SeriousHarlequin/FaRiSmarthome/Labor-Project/docs/topics/hardware.tex

\graphicspath{ {HW-PIC/} }

\chapter{Hardware}
    In diesem Kapitel werden die zwei unterschiedlichen Hardwarerevisionen des Projektes
    beschrieben. 

    \section{Umsetzung - V1}
    
        Die Platine ist so entwickelt worden, dass sie auf der Rückseite des Displays 
        montiert werden kann. Was die erste Version von V1.1 unterscheidet ist, dass
        es vorgesehen war den integrierten Touch des Displays zu verwenden.

        \subsection{Versorgung}
        Das Board wird mit 5V über USB-C versorgt, um den ESP32-S3 mit 3V3 zu 
        versorgung, wird ein AMS1117 Spannungswandler verwenden. Dieser wurde ausgewählt, 
        aufgrund der einfachen Implementierung. Die Verluste bei der Umwandlung können vernachlässigt 
        werden, da es sich nicht um ein batteriebetriebenes Gerät handelt.

            \begin{figure}[h!]
                \centering
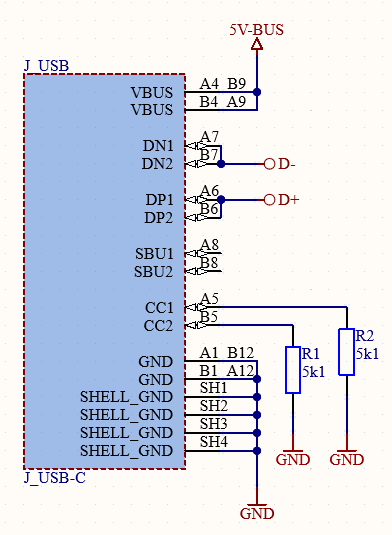
[picture p10: Labor-Project/docs/HW-PIC/usb-c.png]
                
                \caption{USB-C Büchse "programmiert" mit Widerständen.}
                \label{fig:sch1}

            \end{figure}

        Die Widerstände R1 und R2 mit 5,1kOhm sind mit den CC-Leitungen auf GND verbunden.
        Dadurch weiß das Netzteil(falls dieses ``Power Delivery`` unterstützt) welche Spannung 
        und wie viel Strom es zur Verfügung stellen muss. 

            \begin{figure}[h!]
                \centering
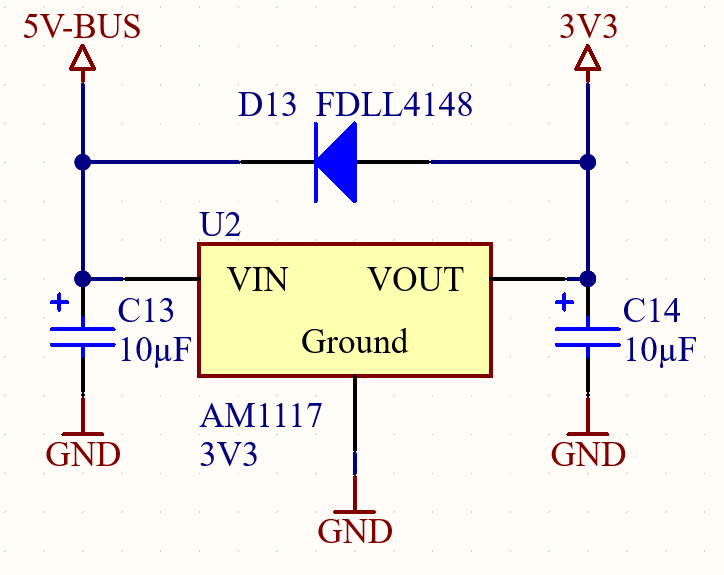
[picture p11: Labor-Project/docs/HW-PIC/powersupply.png]
                
                \caption{AMS1117 mit 3V3 Ausgangsspannung.}
                \label{fig:sch2}
                
            \end{figure}

        Ein- und Ausgangsseitig liegt jeweils ein Glättungskondensator. Die Diode wurde hinzugefügt 
        um zu verhindern, dass am Ausgang eine größere Spannung
        anliegt als beim Eingang - wie z.B. beim Abstecken des Gerätes. Das soll verhindern,
        dass der AMS1117 beschädigt wird.

        \newpage

        \subsection{Mikrocontroller}
        Der ESP32-S3-WROOM-2 ist das Herzstück des Gerätes. Dieser verfügt über eine On-Board PCB Antenne
        und kommuniziert darüber mit dem Smart-Home System. 

            \begin{figure}[h!]
                \centering
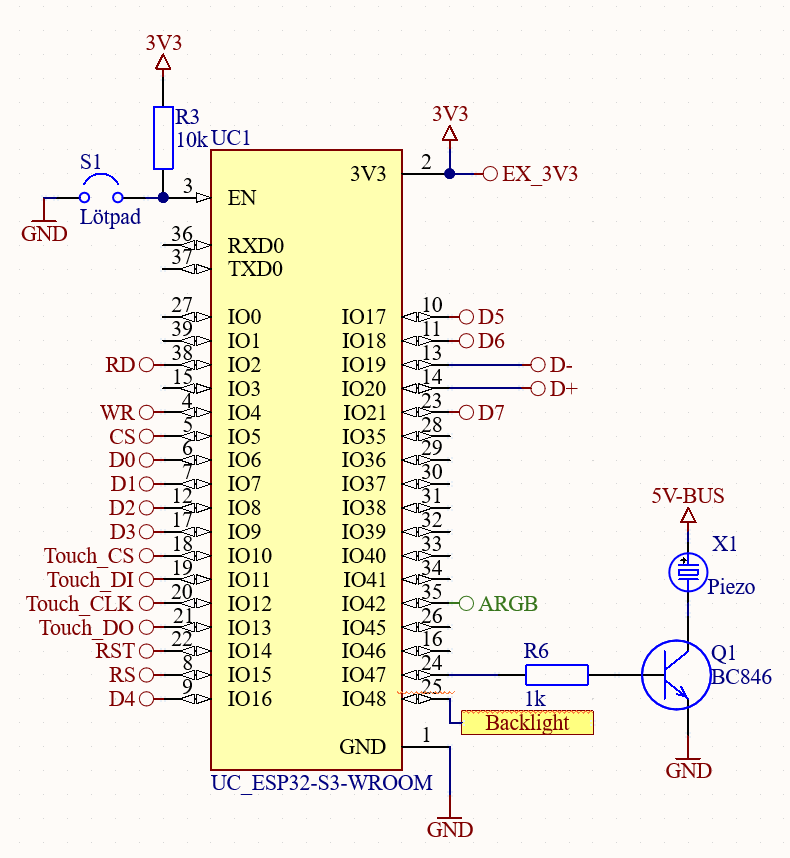
[picture p12: Labor-Project/docs/HW-PIC/microcontroller.png]
                
                \caption{uC im Schaltplan.}
                \label{fig:sch3}

            \end{figure}
        
        Der Piezo wird von einen NPN-Transistor eingeschalten, wenn IO47 high ist.

        \newpage
        \subsection{Display}
        Das Display wird parallel im 8-BIT Modus angesteuert. Die Pins mit denen 
        kommuniziert wird sind nicht fix in der Libary festgelegt und können am Esp32-S3 
        frei ausgewählt werden. 

            \begin{figure}[h!]
                \centering
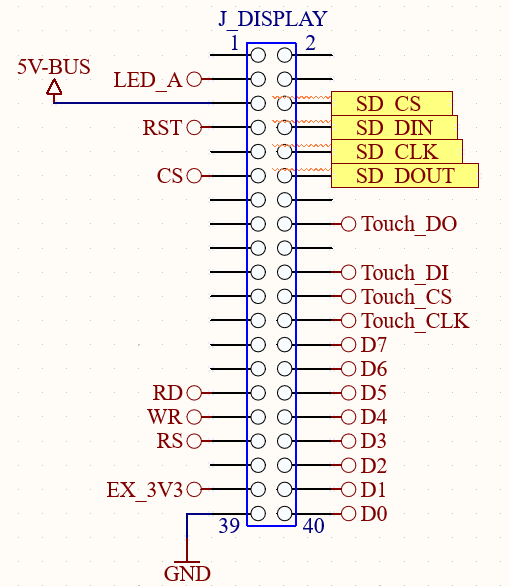
[picture p13: Labor-Project/docs/HW-PIC/connector.png]
                
                \caption{Stecker für Display und Touch}
                \label{fig:sch4}

            \end{figure}

        Das Display wird über einen 40-Pin Stecker angeschlossen. Die Pins sind in der Abbildung \ref{fig:sch4}.
        Das zugekaufte Display hat eine Auflösung von 800x480 Pixeln und nutzt den SSD1963 Controller.
        Es ist ebenfalls ein SD-Kartenleser eingebaut. Dieser kann über SPI ausgelesen(Gelb markiert), ist 
        aber für dieses Projekt nicht in verwendung. 
        
        \newpage
        
        Das Display wurde über Amazon erworben.\cite{noauthor_viferr_nodate} Es handelt sich um ein 7 Zoll Display mit
        einer Auflösung von 800x480 Pixeln. Es ist mit einem resistiven Touchscreen ausgestattet.

            \begin{figure}[h!]
                \centering
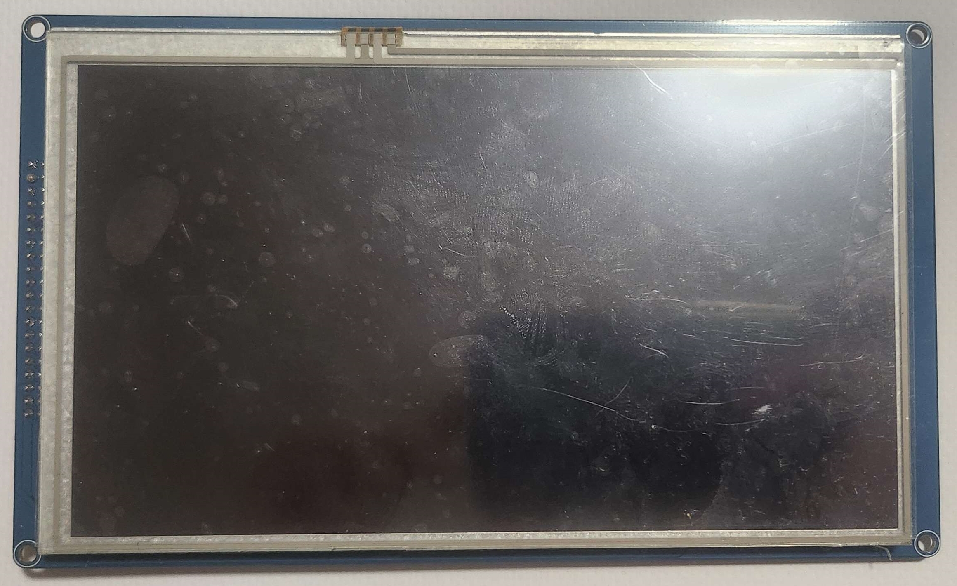
[picture p14: Labor-Project/docs/HW-PIC/display-front.jpg]
                
                \caption{Vorderseite des Displays.}
                \label{fig:displayfront}
            
            \end{figure}

            \begin{figure}[h!]
                \centering
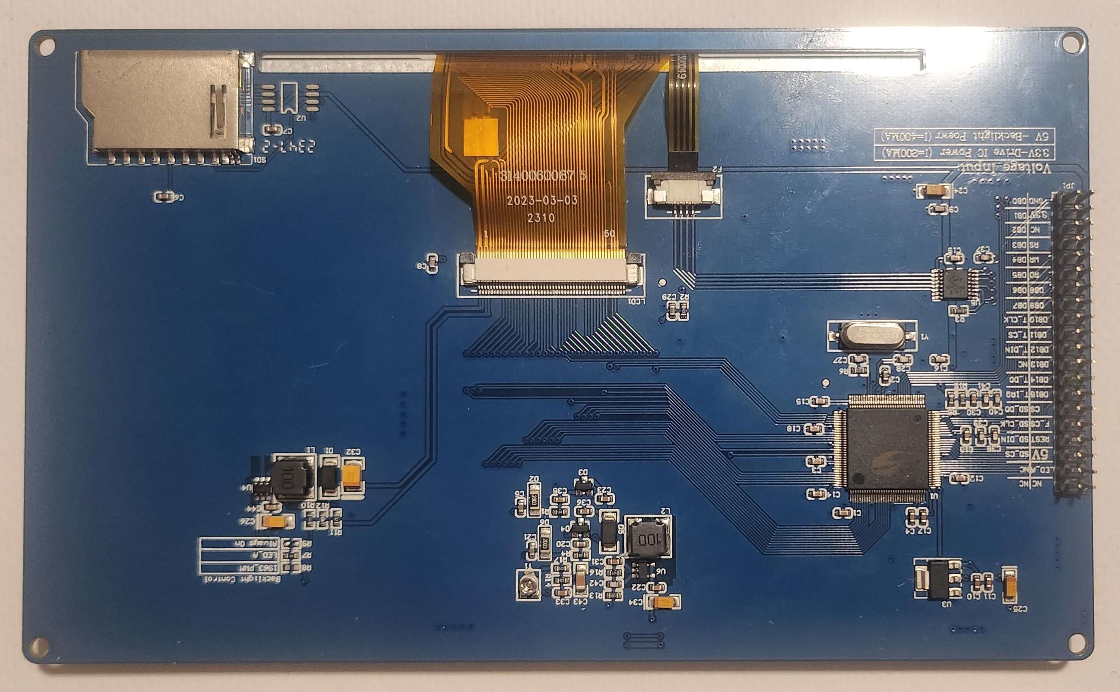
[picture p15: Labor-Project/docs/HW-PIC/display-back.jpg]
                
                \caption{Rückseite des Displays.}
                \label{fig:displayback}
            
            \end{figure}

        \newpage
        \subsection{Touch}
        Die Berührung am Resisivtouch-Panel wird vom XPT2046 erfasst und mittels 
        SPI-BUS vom µC ausgelesen. Da es bei der Implementierung von Touch softwareseitig
        Probleme gab, wurde stattdessen ein Drehgeber mit Taste verwendet.
        Dafür wurden die in der Abbildung \ref{fig:sch3} bzw. \ref{fig:sch4} gezeigten Pins mit 
        dem Prefix "Touch" für das Einlesen des Drehgebers verwendet.

        \subsection{LED-Streifen}

        Der LED-Streifen ist eine eigene Platine welche mit WS2812B LEDs bestückt ist. Das sind 
        adressierbare RGB-LEDs, die über einen einzigen Datenpin angesteuert werden. Dadurch 
        können beliebig viele Streifen hintereinander geschalten werden. Der Datenpin des 
        LED-Streifens ist mit dem GPIO42 des ESP32-S3 verbunden. 

            \begin{figure}[h!]
                \centering
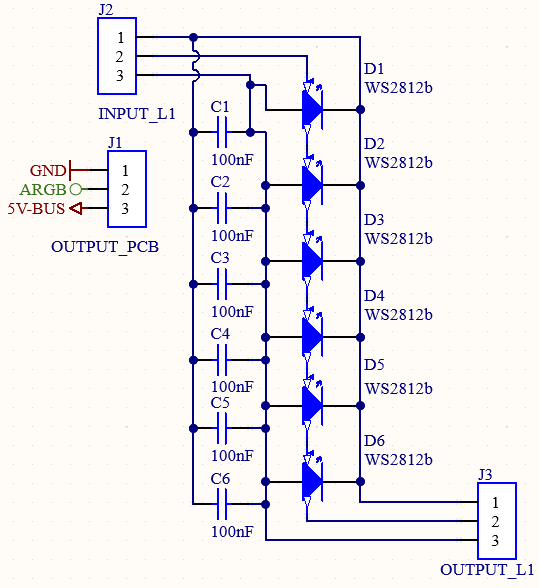
[picture p16: Labor-Project/docs/HW-PIC/rgb.png]
                
                \caption{Anschluss und Beschaltung der LED-Streifen.}
                \label{fig:led_strip}
            \end{figure}

        % \subsection{PCB}

    \newpage
    \section{Umsetzung V1.1 (Finale)}       
    In diesem Kapitel der Hardware werden nur die Änderungen zur V1 beschrieben. 

        \subsection{Mikrocontroller}

            \begin{figure}[h!]
                \centering
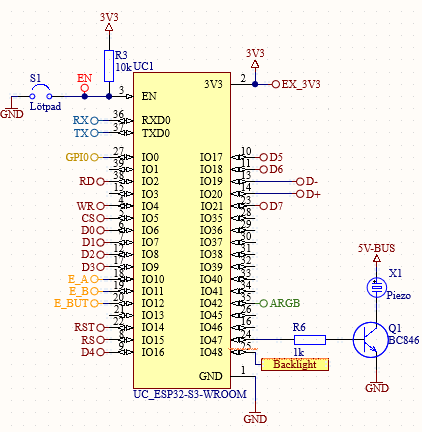
[picture p17: Labor-Project/docs/HW-PIC/microcontroller-v1.1.png]
                
                \caption{Geänderte Schaltung.}
                \label{fig:sch5}

            \end{figure}

        Der Schaltplan wurde angepasst um den Rotary Encoder sowie das Serial-Interface auf
        einen Pin-Header legen zu können.

        \newpage
        \subsection{Rotary Encoder}
        Die Touch-Funktion wurde durch einen Drehgeber ersetzt. Dieser hat eine Taste und
        zwei Ausgänge für die Drehrichtung. Der Drehgeber wird an die Pins 'E\_A', 'E\_B' und 'E\_BUT'
        am ESP32-S3 angeschlossen. 

            \begin{figure}[h!]
                \centering
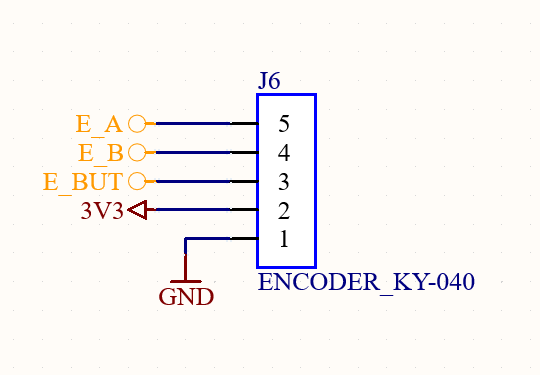
[picture p18: Labor-Project/docs/HW-PIC/encoder.png]
                
                \caption{Anschluss: Drehgeber mit Taste.}
                \label{fig:sch6}

            \end{figure}

        Der Inkrementalgeber hat die Ausgänge A und B. Diese geben beide die selbe
        definierte Menge an Impulse pro Umdrehung ab. Beide Signale sind zueinander 90° Phasenverschoben. Somit
        kann die Drehrichtung bestimmt werden. Da je nach Drehrichtung die positive Flanke entweder
        zuerst bei A oder B erfasst wird.

            \begin{figure}[h!]
                \centering
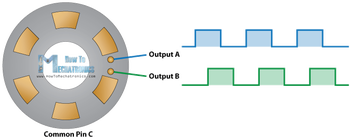
[picture p19: Labor-Project/docs/HW-PIC/encoder_explain.png]
                
                \caption{Erklärung über Encoder von "How to Mechatronics"\cite{dejan_how_2016}}
                \label{fig:sch7}

            \end{figure}

            \begin{figure}[h!]
                \centering
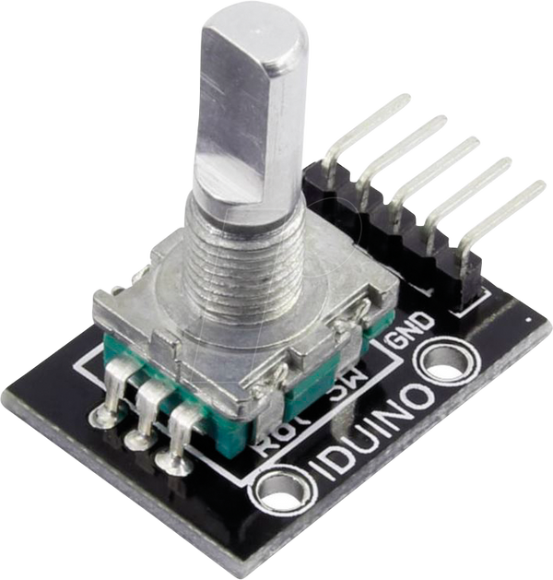
[picture p20: Labor-Project/docs/HW-PIC/encoder-pic.png]
                
                \caption{KY-040 Encoder \cite{noauthor_iduino_nodate}}
                \label{fig:sch8}

            \end{figure}
        Der Encoder KY-040 ist fertig bestückt auf ein PCB. Wie in Abbildung \ref{fig:sch6} zu sehen ist, 
        hat dieses Bauteil 5 Anschlussdrähte. Der Encoder gibt 20 Impulse pro Umdrehung aus und 
        rastet beim Drehen nach jedem Impuls ein.

        \newpage
        
        \subsection{Serial-Interface}
        Das Serial-Interface wurde auf einen Pin-Header gelegt um die Programmierung des ESP32-S3
        zu erleichtern. Bei der Entwicklung wurde festegstellt, dass beim programmieren 
        die Möglichkeit besteht, die Upload Funktion über USB unabsichtlich zu sperren. Neuer
        Code kann dann nur mehr über Serial hochgeladen werden. 

            \begin{figure}[h!]
                \centering
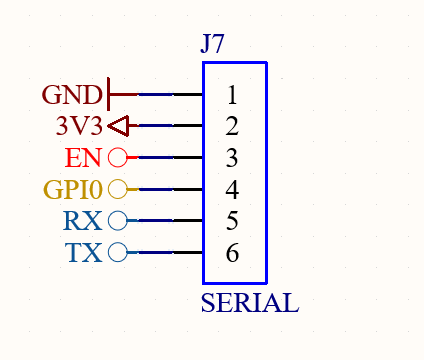
[picture p21: Labor-Project/docs/HW-PIC/serial.png]
                
                \caption{Serial-Interface}
                \label{fig:sch9}

            \end{figure}
        
        Dieser Anschluss ist nur zum Programmieren und Debuggen gedacht.
    \newpage
    
    \section{PCB}

    In diesem Kapitel werden die unterschiedlichen PCBs beschrieben.

        \subsection{ARGB-Print V1 \& V1.1}
        Dieser Print hat einen Eingang und einen Ausgang, es können mehrere von diesen 
        Platinen in Reihe geschalten werden. Da wie beschrieben in \ref{} ARGB-LEDs verwendet werden.
        Für das Gehäuse sind nur zwei LED-Streifen vorgesehen. 

        \begin{figure}[h!]
            \centering
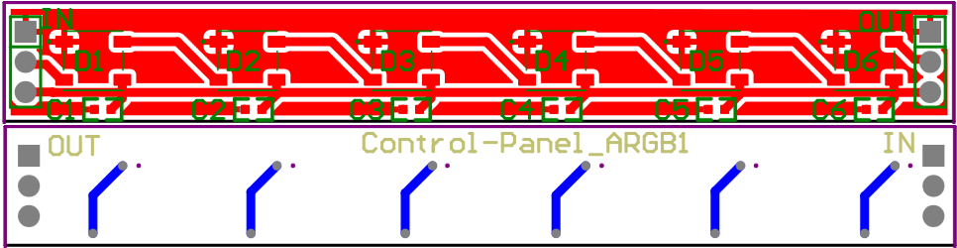
[picture p22: Labor-Project/docs/HW-PIC/pcb-argb.png]
            
            \caption{PCB-ARGB [Blau - Rückseite, Rot - Vorderseite]}
            \label{fig:pcbargb}

        \end{figure}

        \subsection{V1}

        Das PCB ist so entworfen worden, damit es auf der Rückseite des Displays augesteckt 
        werden kann.

            \begin{figure}[h!]
                \centering
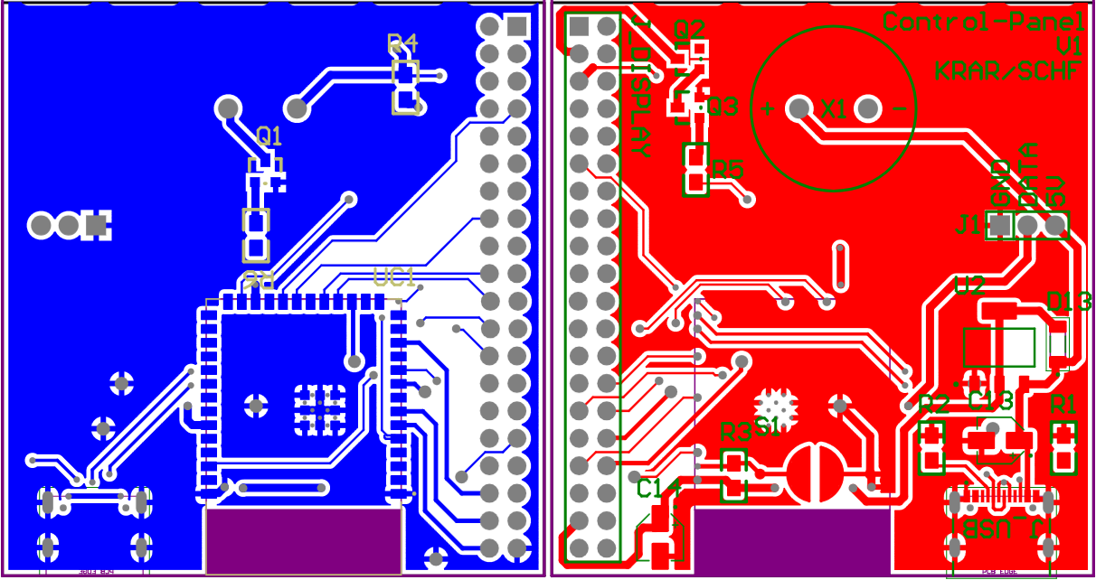
[picture p23: Labor-Project/docs/HW-PIC/pcb-v1.png]
                
                \caption{PCB V1 [Blau - Rückseite, Rot - Vorderseite]}
                \label{fig:pcb1}

            \end{figure}

        \newpage
        \subsection{V1.1}

        Das PCB wurde für die finale Version wurde angepasst. Der Rotary Encoder und das Serial-Interface
        haben jetzt einen eigenen Pin-Header.

            \begin{figure}[htbp]
                \centering
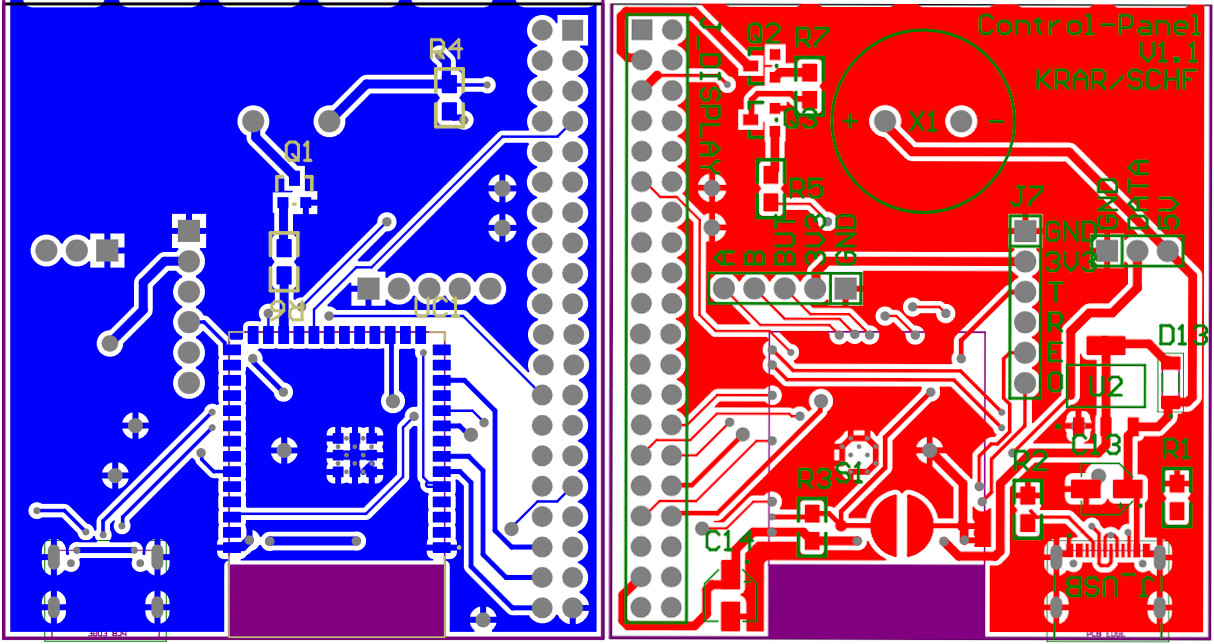
[picture p24: Labor-Project/docs/HW-PIC/pcb-v1.1.png]
                
                \caption{PCB V1.1 [Blau - Rückseite, Rot - Vorderseite]}
                \label{fig:pcb1.1}

            \end{figure}

            \begin{figure}[htbp]
                \centering
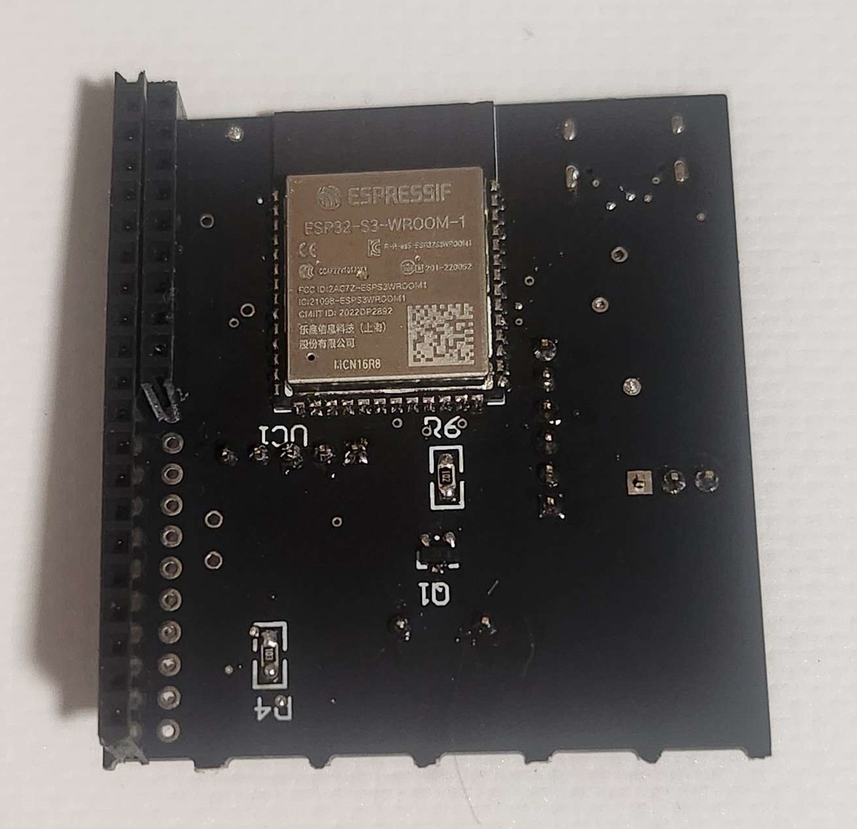
[picture p25: Labor-Project/docs/HW-PIC/pcb-back.jpg]
                \subfloat[\centering Rückseite]{{ }}
                \qquad
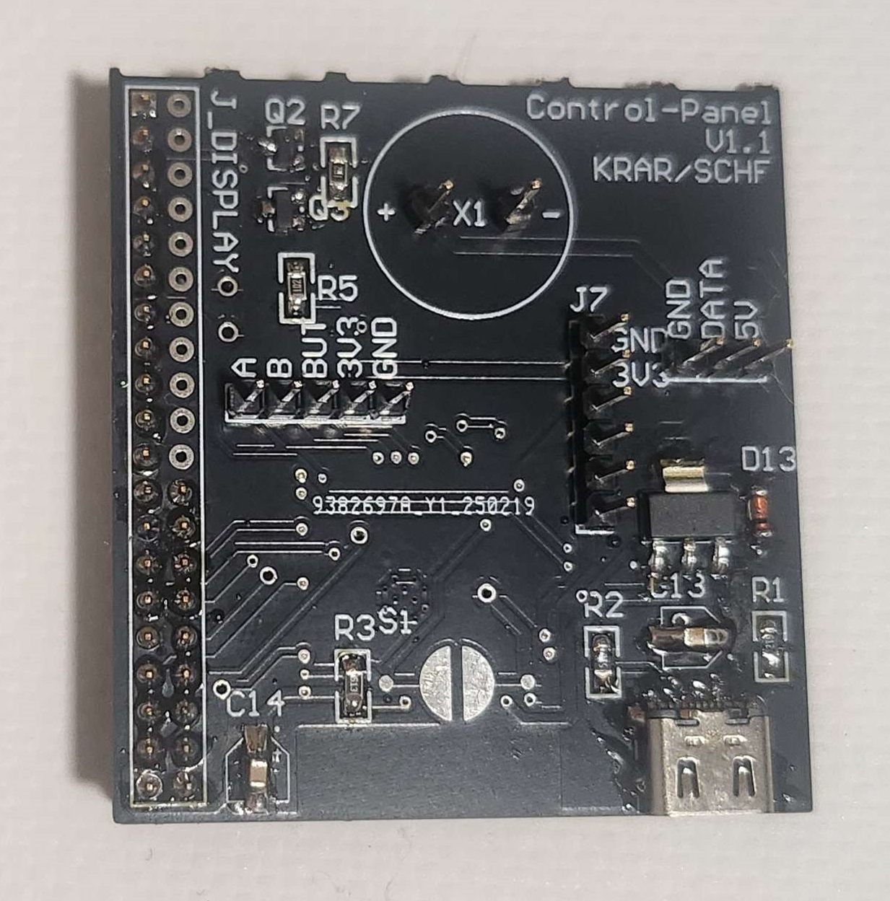
[picture p26: Labor-Project/docs/HW-PIC/pcb-front.jpg]
                \subfloat[\centering Front]{{ }}
                \caption{PCB V1.1 bestückt.}
                \label{fig:example}
            \end{figure}

    \newpage
    \section{Schaltplan} 
    Die folgenden zwei Seiten zeigen den Schaltplan der ersten und der finalen Version.   
            \includepdf[pages={1}, angle = 90]{Control-Panel_V1.pdf}
            \includepdf[pages={1}, angle = 90]{Control-Panel_V1.1.pdf}

    \section{Gehäuse}
    Das Gehäuse wurde aus 3D-gedruckten Teilen zusammengesetzt. Die Teile wurden in Fusion 360 
    entworfen und anschließend mit einem Creality Cr-10s Pro V2 gedruckt. Das Gehäuse besteht aus zwei 
    Hauptteilen: dem oberen und dem unteren Teil. Diese Teile werden durch Schrauben zusammengehalten.

        \begin{figure}[h!]
            \centering
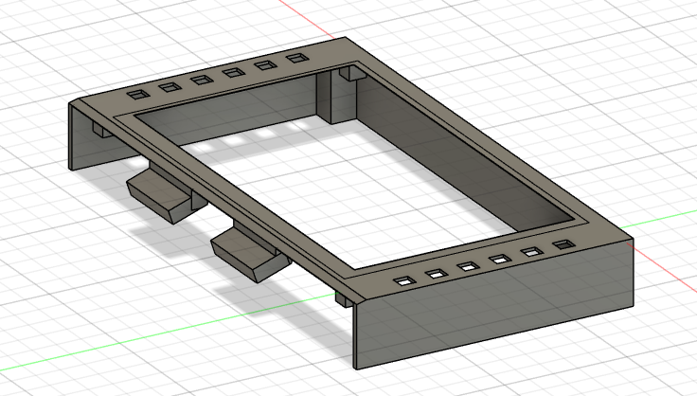
[picture p27: Labor-Project/docs/HW-PIC/case_top.png]
            
            \caption{Oberes Teil des Gehäuses.}
            \label{fig:case_top}
        \end{figure}

    Der obere Teile des Gehäuses ist so gestaltet, dass es alle Komponenten sicher 
    haltet und gleichzeitig einen einfachen Zugang zu den Anschlüssen und Bedienelementen ermöglicht.
    Das Display und die LED streifen werden hier verbaut. 

        \begin{figure}[h!]
            \centering
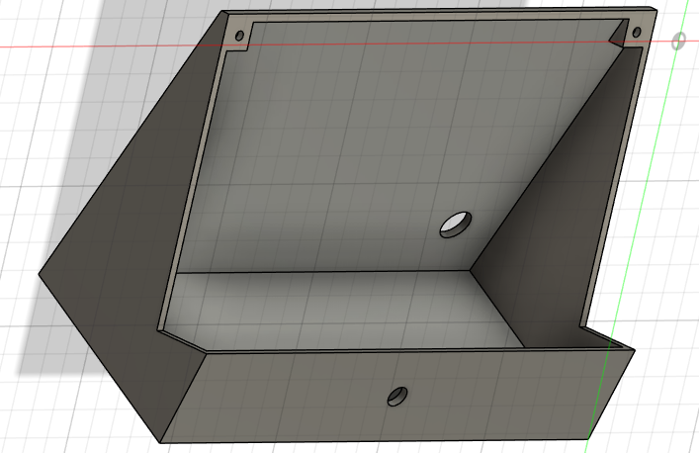
[picture p28: Labor-Project/docs/HW-PIC/case_bottom.png]
            
            \caption{Unteres Teil des Gehäuses.}
            \label{fig:case_bottom}
        \end{figure}

    Der untere Teil des Gehäuses ist so gestaltet, dass der Oberteil sicher darauf sitzt und alle internen
    Komponenten schützt. Es bietet auch Öffnungen für die Stromversorgung. In dieses Teil wird
    die Strombuchse sowie der Encoder verbaut.

    Das Loch in der Mitte des unteren Teils ist für die Montage des Encoders gedacht. Die 
    andere Öffnung auf der Rückseite ist für die Stromversorgung, in dieser wird 
    eine USB-C Buchse eingebaut.

    \begin{figure}[h!]
        \centering
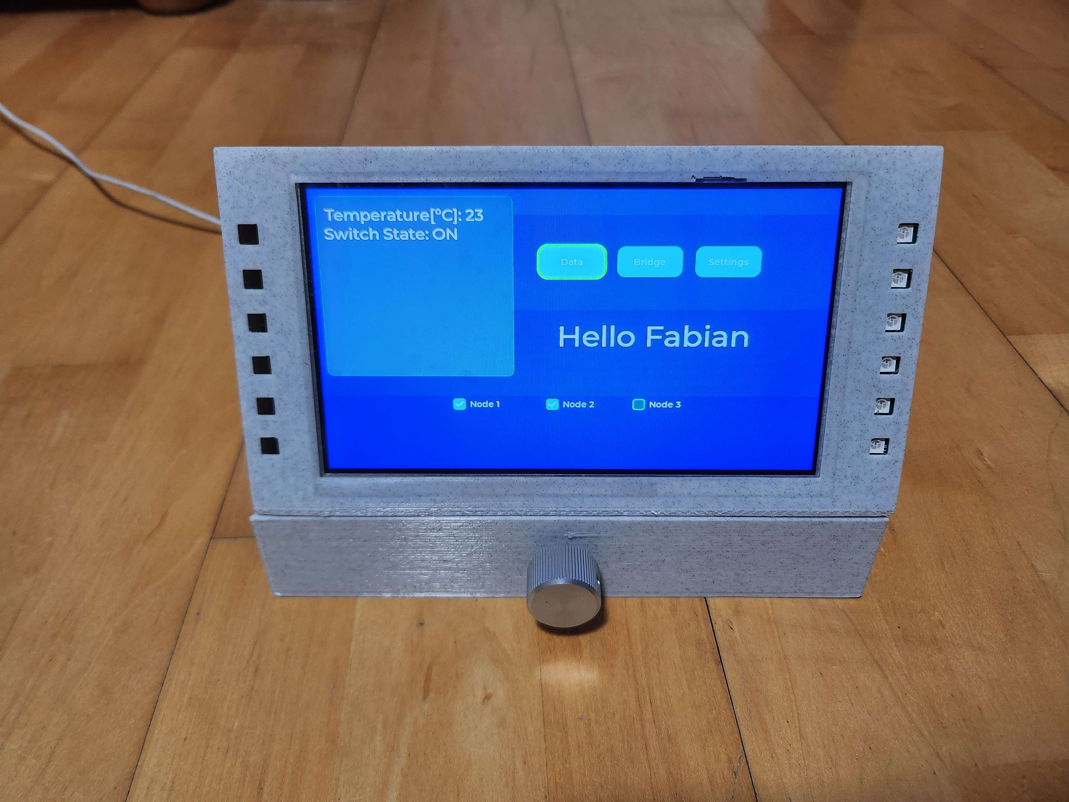
[picture p29: Labor-Project/docs/HW-PIC/display-fertig.jpg]
        
        \caption{Gehäuse zusammengebaut mit den Komponenten.}
        \label{fig:case_bottom}
    \end{figure}
