SeriousHarlequin/FaRiSmarthome/Diplomarbeit/topics-hw/production-files.tex

\chapter{Production Files}\setAuthor{Richard Krammer}

    The production files are the files that are used to produce the
    hardware. This includes the schematic, the PCB layout and the
    bill of materials (BOM).

    \section{Basic Module}
        
        \subsubsection{Basic Module V2.2}
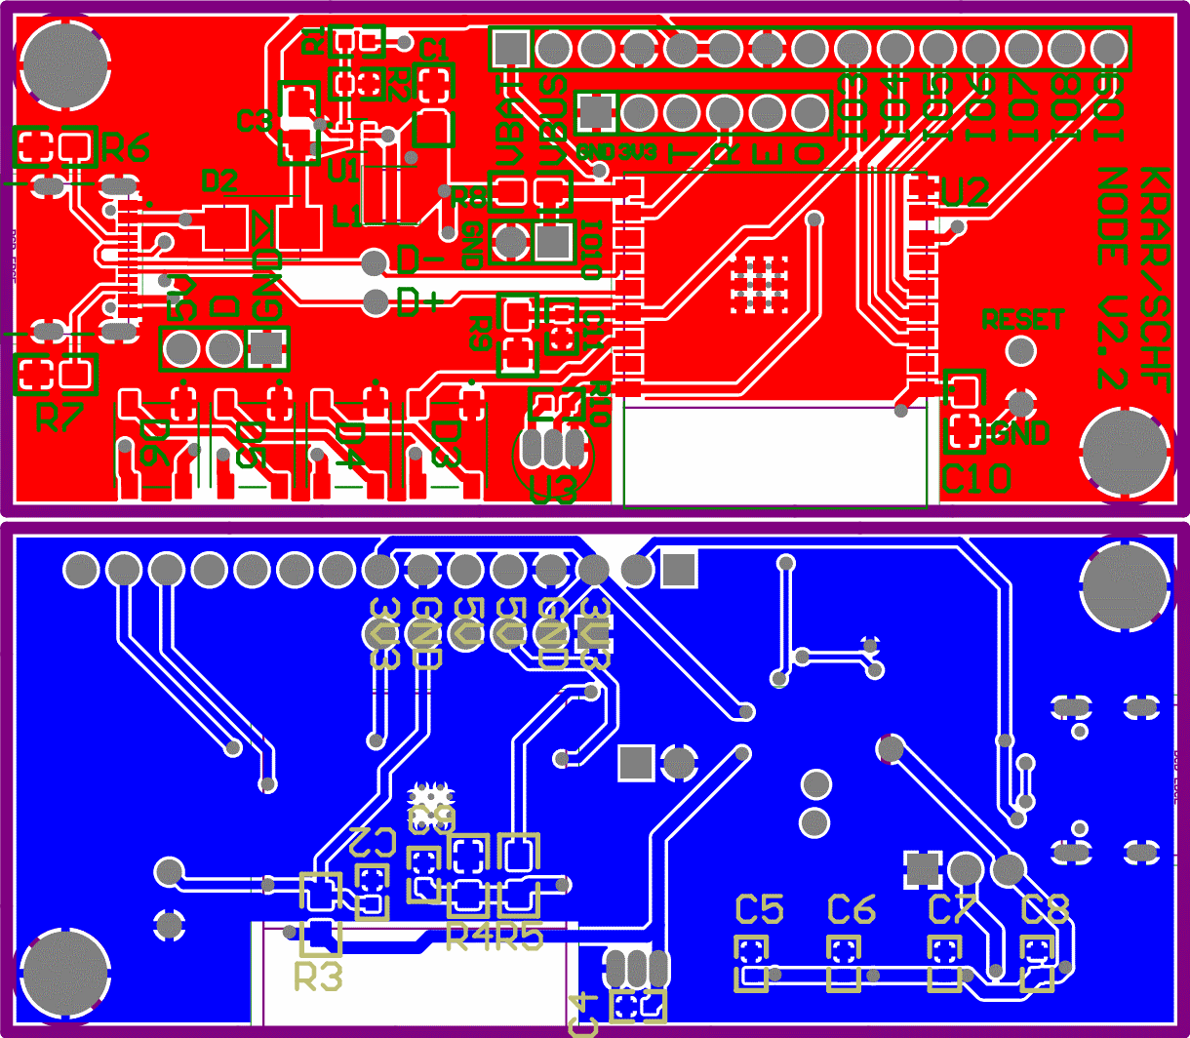
[picture p30: Diplomarbeit/assets/HW/PCB-NODE-V2.2.png]
            

            \includepdf[pages={2}, angle = 0, scale = 1.5, pagecommand={\subsubsection{Basic Module V2.2 - BOM}}]
            {assets/HW/PDF-Schematic/Node-V2.2.pdf}

            \includepdf[pages={1}, angle = 90]{assets/HW/PDF-Schematic/Node-V2.2.pdf}

        \subsubsection{Basic Module V2.1}
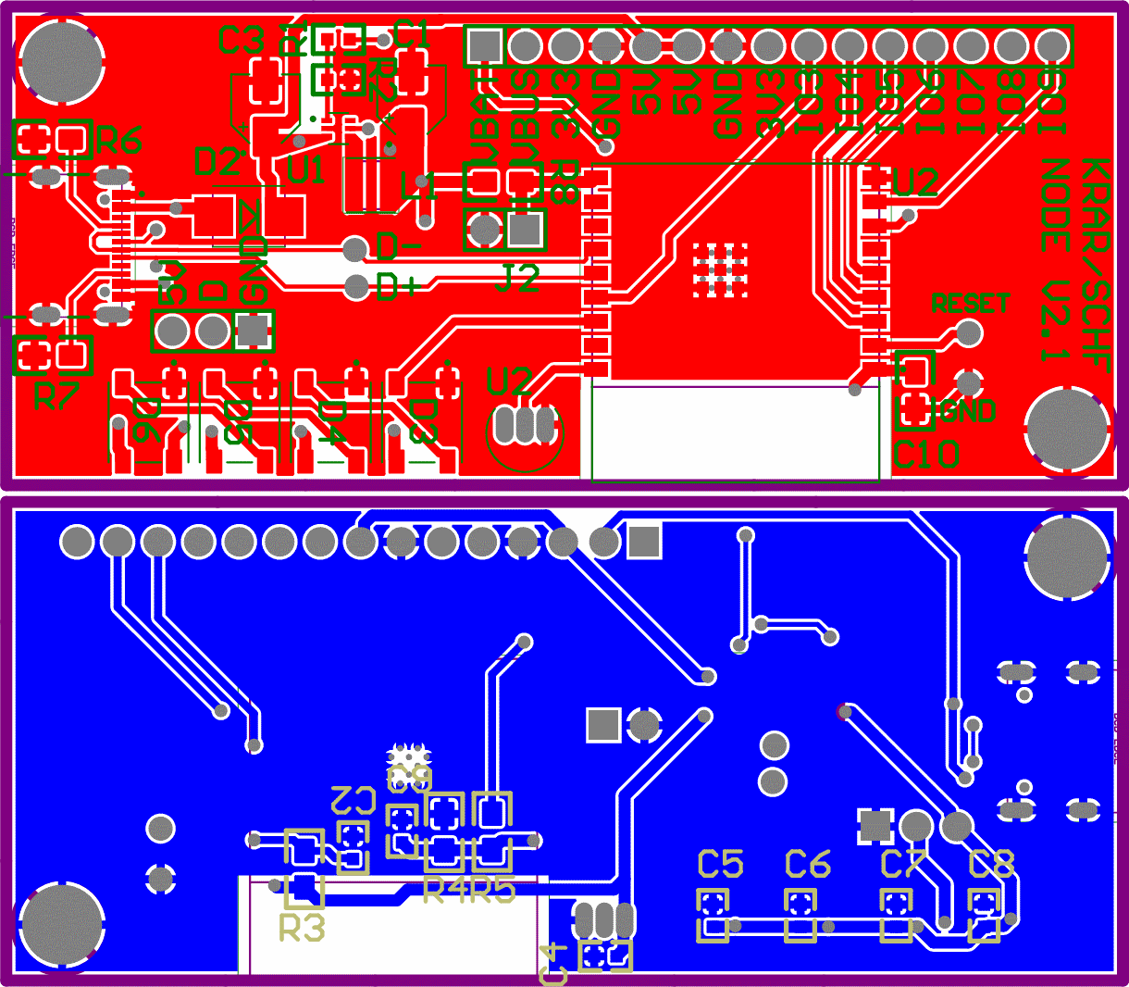
[picture p31: Diplomarbeit/assets/HW/PCB-NODE-V2.1.png]
            
            
            \includepdf[pages={1}, angle = 0, scale = 1, pagecommand={\subsubsection{Basic Module V2.1 - BOM}}]
            {assets/HW/PDF-Schematic/Node-V2.1-BOM.pdf}
                
            \includepdf[pages={1}, angle = 90]{assets/HW/PDF-Schematic/Node-V2.1.pdf}

        \subsubsection{Basic Module V2.0} 
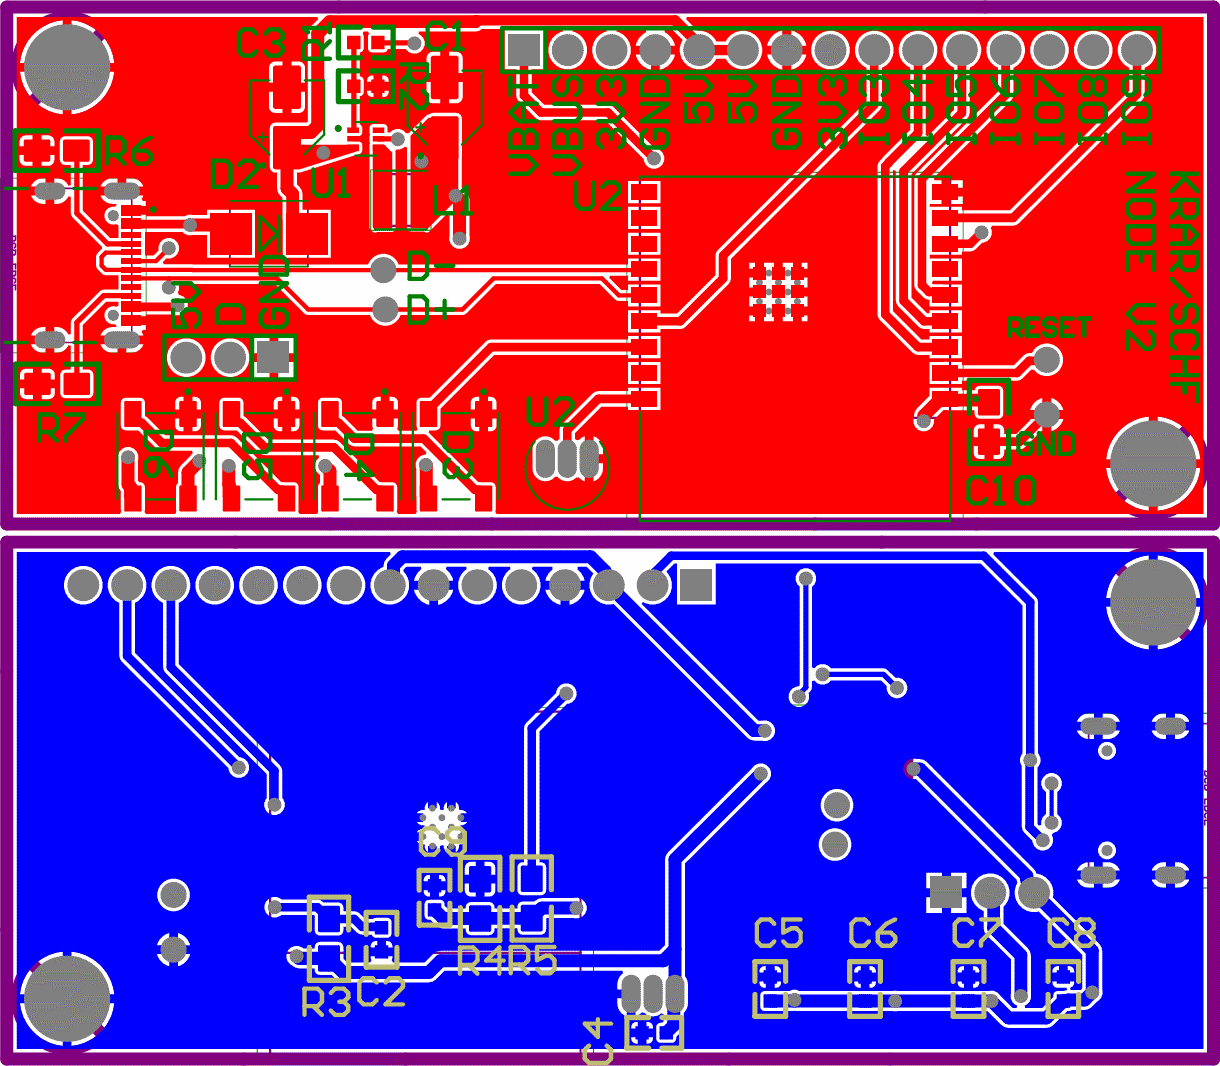
[picture p32: Diplomarbeit/assets/HW/PCB-NODE-V2.0.png]
            

            \includepdf[pages={1}, angle = 0, scale = 1, pagecommand={\subsubsection{Basic Module V2.0 - BOM}}]
            {assets/HW/PDF-Schematic/Node-V2.0-BOM.pdf}

            \includepdf[pages={1}, angle = 90]{assets/HW/PDF-Schematic/Node-V2.0.pdf}

        \subsubsection{Basic Module V1.1}       
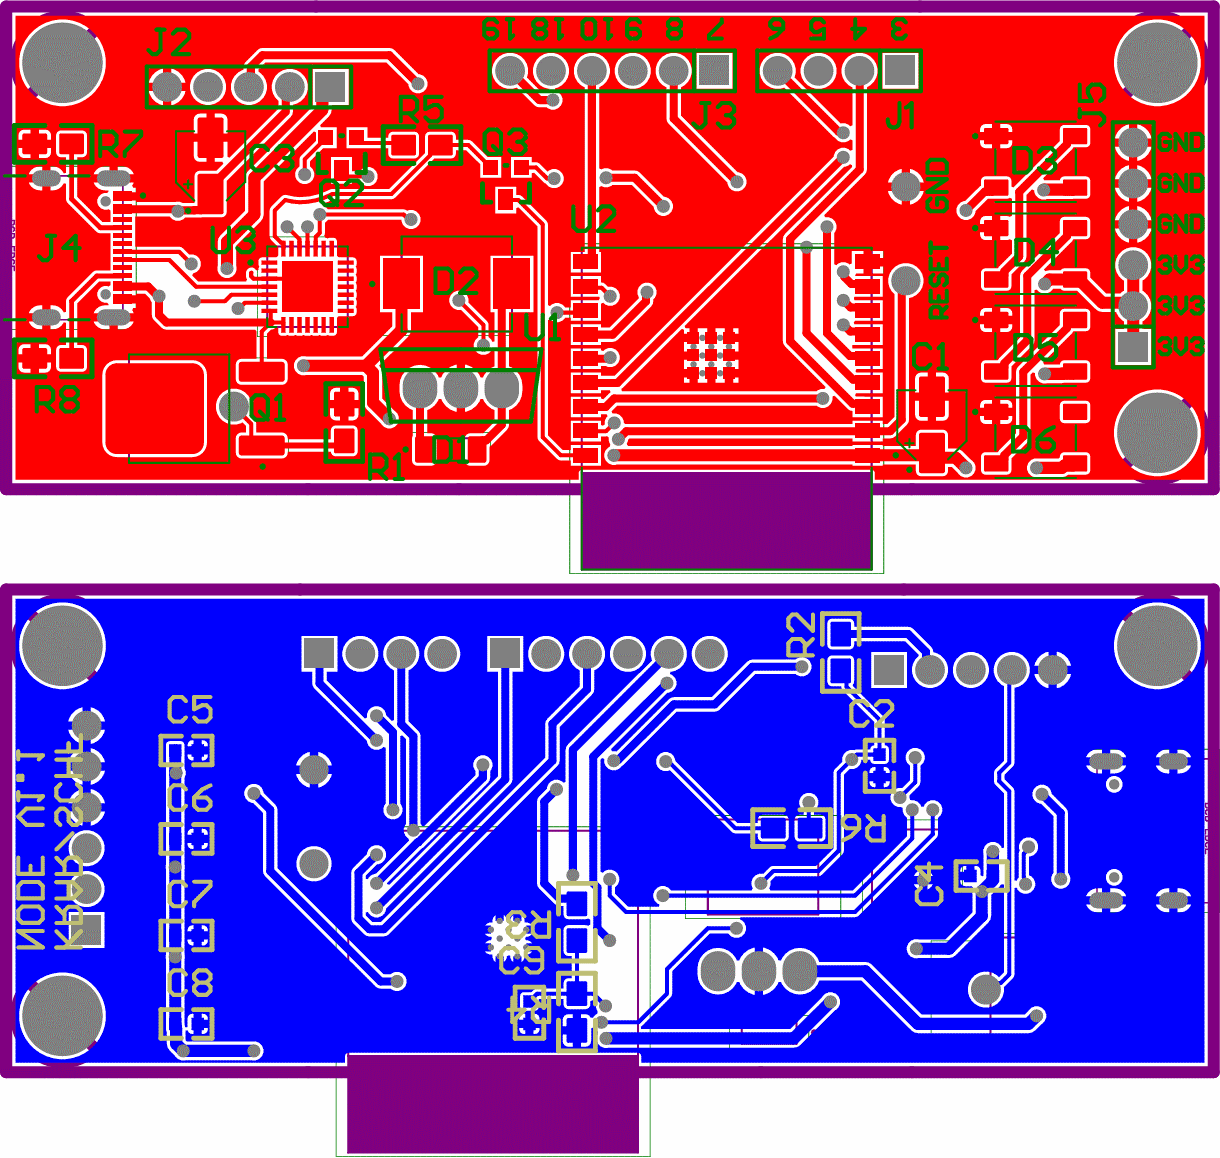
[picture p33: Diplomarbeit/assets/HW/PCB-NODE-V1.1.png]
            
    
            \includepdf[pages={1}, angle = 0, scale = 1, pagecommand={\subsubsection{Basic Module V1.1 - BOM}}]
            {assets/HW/PDF-Schematic/Node-V1.1-BOM.pdf}
            
            \includepdf[pages={1}, angle = 90]{assets/HW/PDF-Schematic/Node-V1.1.pdf}
        
            \includepdf[pages={1}, angle = 90]{assets/HW/PDF-Schematic/Node-V1.0.pdf}

    \section{Motion Module}
        
        \subsubsection{Motion Module V1.1}
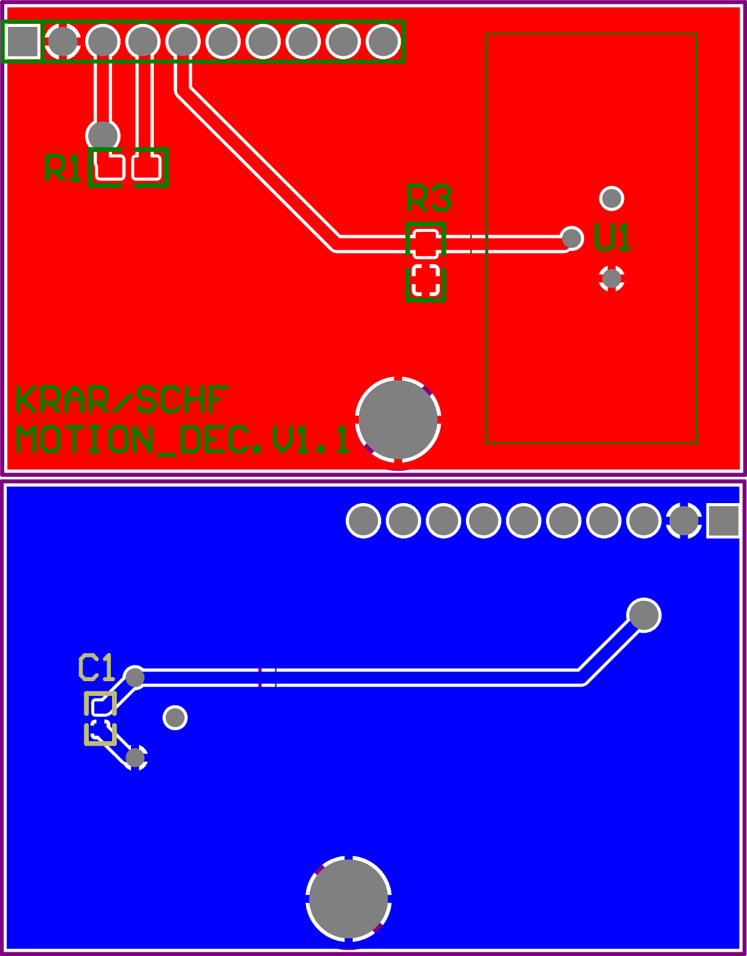
[picture p34: Diplomarbeit/assets/HW/PCB-MOTION-V1.1.png]
            
            
            \includepdf[pages={2}, angle = 0, scale = 0.8, pagecommand={\subsubsection{Motion Module V1.1 - BOM}}]
            {assets/HW/PDF-Schematic/Motion-V1.1.pdf}

            \includepdf[pages={1}, angle = 90]{assets/HW/PDF-Schematic/Motion-V1.1.pdf}

        \subsubsection{Motion Module V1.0}
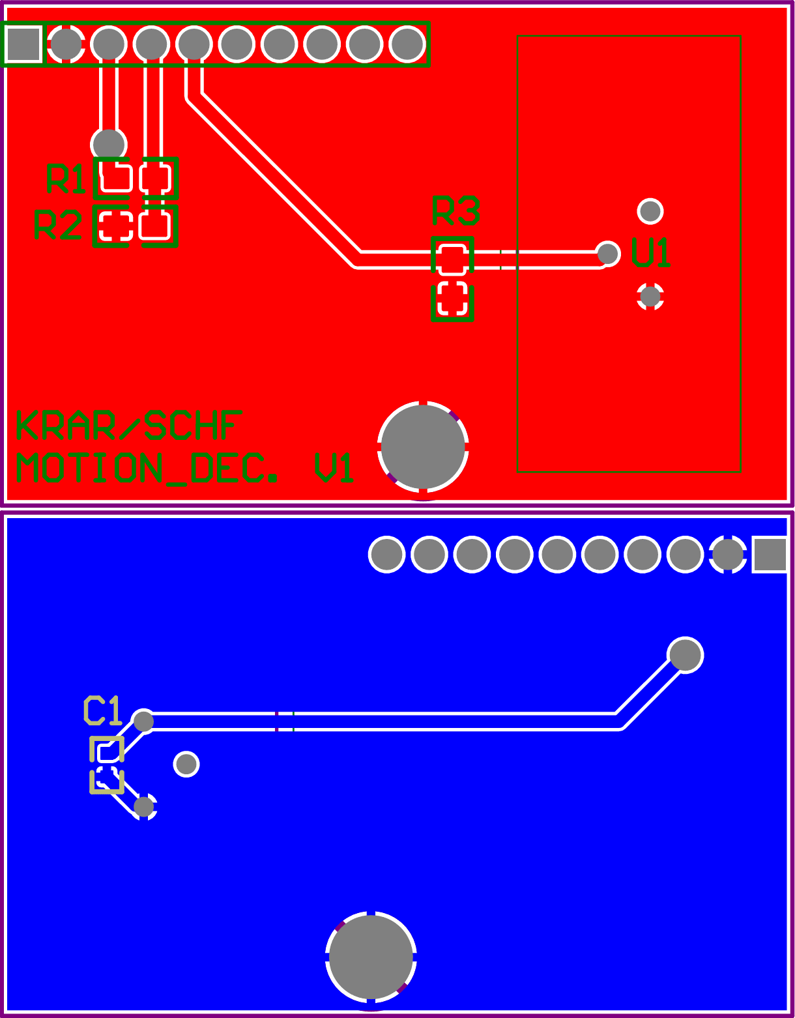
[picture p35: Diplomarbeit/assets/HW/PCB-MOTION-V1.0.png]
            
            
            \includepdf[pages={1}, angle = 0, scale = 0.8, pagecommand={\subsubsection{Motion Module V1.0 - BOM}}]
            {assets/HW/PDF-Schematic/Motion-V1.0-BOM.pdf}

            \includepdf[pages={1}, angle = 90]{assets/HW/PDF-Schematic/Motion-V1.0.pdf}

    \section{Battery Module}
        \subsubsection{Battery Module V2.2}
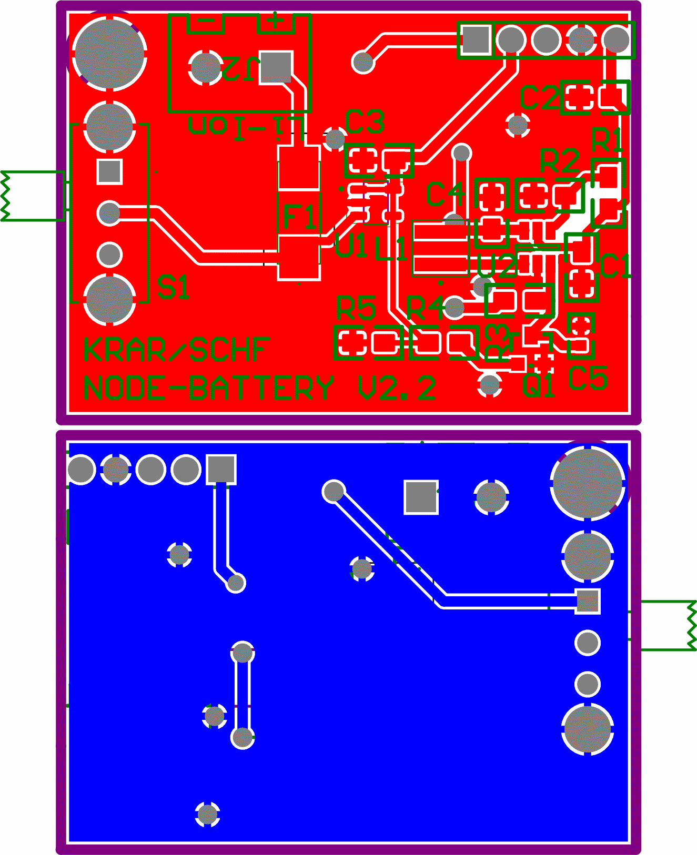
[picture p36: Diplomarbeit/assets/HW/PCB-BATTERY-V2.2.png]
            

            \includepdf[pages={1}, angle = 0, scale = 1, pagecommand={\subsubsection{Battery Module V2.2 - BOM}}]
            {assets/HW/PDF-Schematic/Battery-V2.2-BOM.pdf}

            \includepdf[pages={1}, angle = 90]{assets/HW/PDF-Schematic/Battery-V2.2.pdf}

        \subsubsection{Battery Module V2.1}
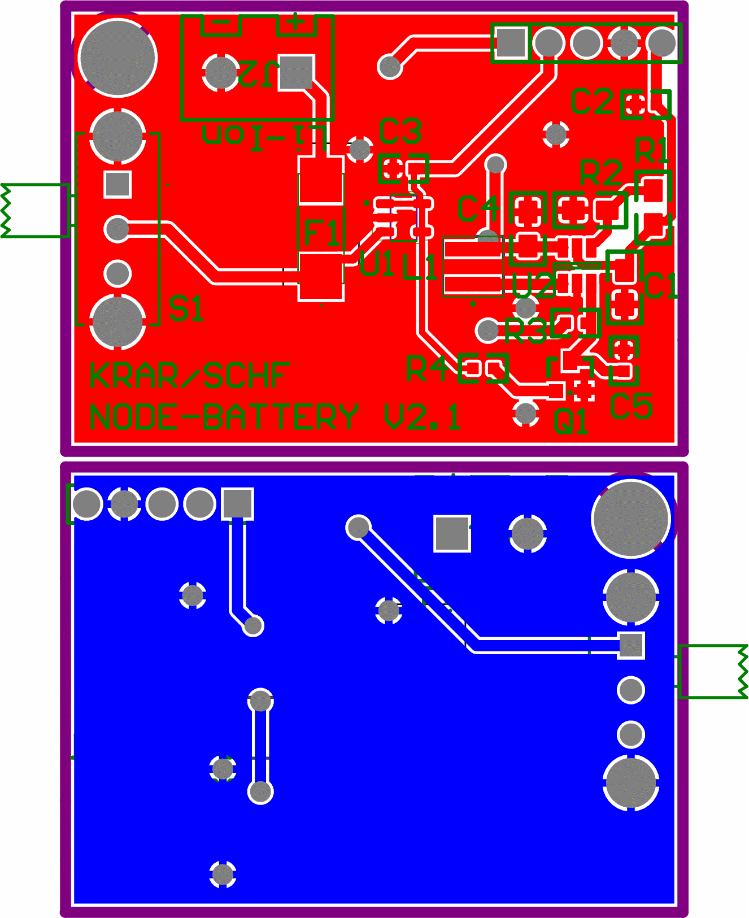
[picture p37: Diplomarbeit/assets/HW/PCB-BATTERY-V2.1.png]
            

            \includepdf[pages={1}, angle = 0, scale = 1, pagecommand={\subsubsection{Battery Module V2.1 - BOM}}]
            {assets/HW/PDF-Schematic/Battery-V2.1-BOM.pdf}

            \includepdf[pages={1}, angle = 90]{assets/HW/PDF-Schematic/Battery-V2.1.pdf}
        
        \subsubsection{Battery Module V1.0}
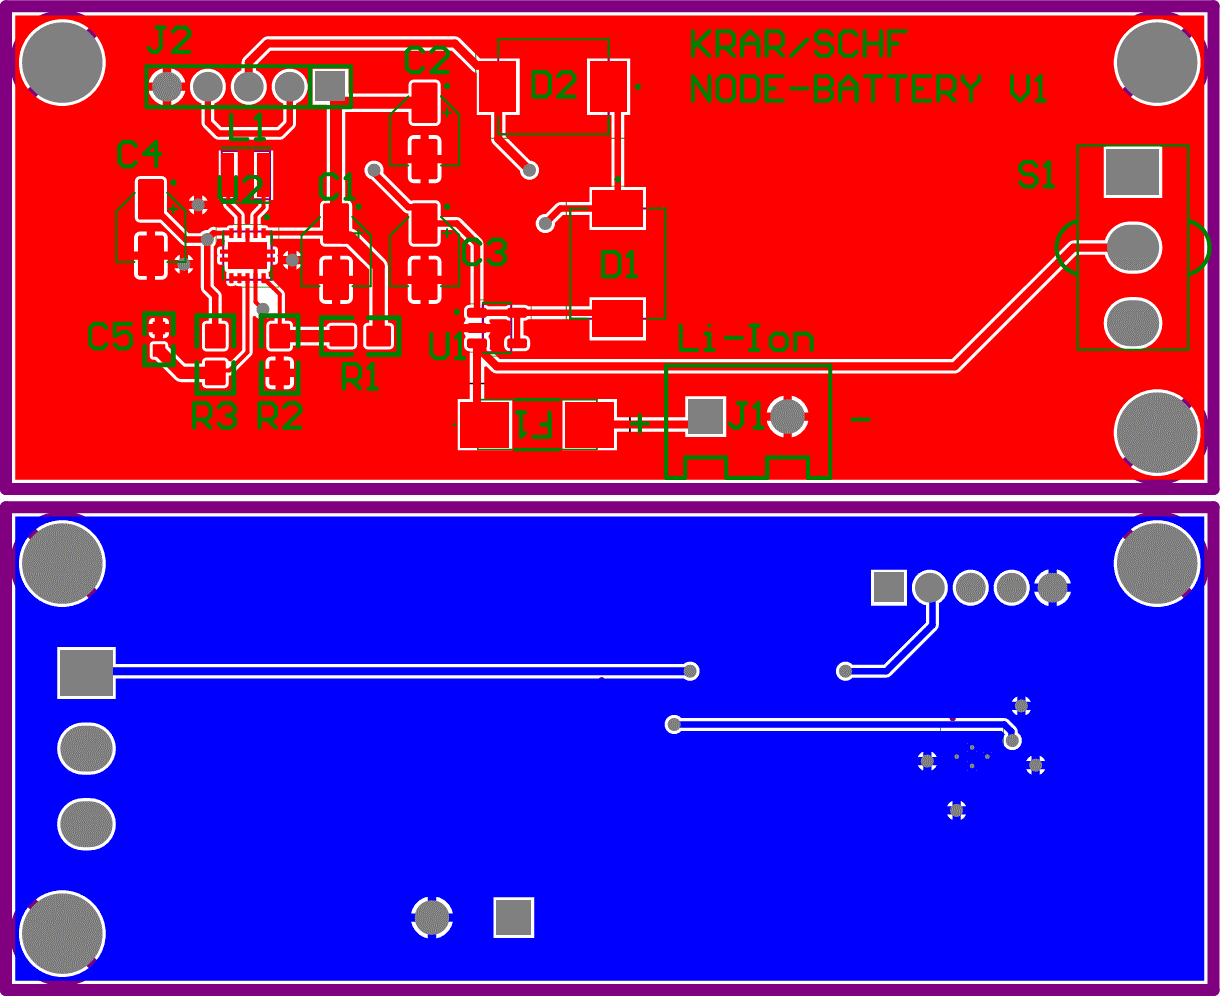
[picture p38: Diplomarbeit/assets/HW/PCB-BATTERY-V1.0.png]
            

            \includepdf[pages={1}, angle = 0, scale = 1, pagecommand={\subsubsection{Battery Module V1.0 - BOM}}]
            {assets/HW/PDF-Schematic/Battery-V1.0-BOM.pdf}

            \includepdf[pages={1}, angle = 90]{assets/HW/PDF-Schematic/Battery-V1.0.pdf}

    \section{Switch Module}
        \subsubsection{Switch Module V1.1}
            \begin{figure}[htp]
                \centering
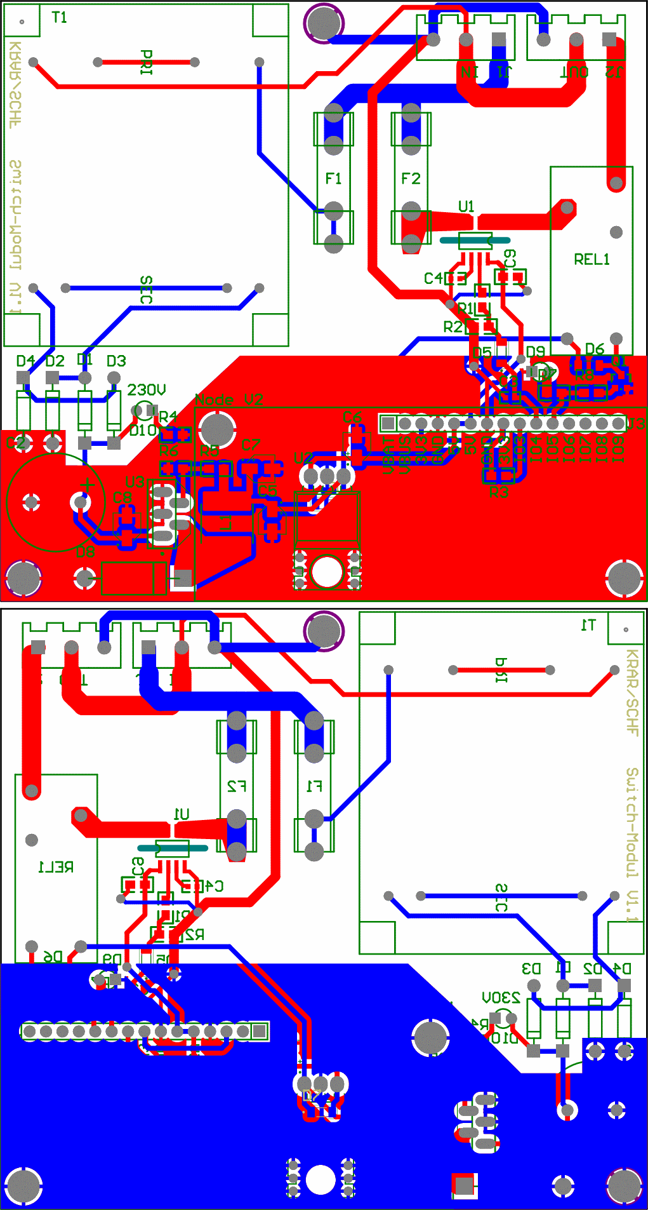
[picture p39: Diplomarbeit/assets/HW/PCB-SWITCH-V1.1-Vertical.png]
                
            \end{figure}

            \FloatBarrier

            \includepdf[pages={1}, angle = 0, scale = 1.2, pagecommand={\subsubsection{Switch Module V1.1 - BOM}}]
            {assets/HW/PDF-Schematic/Switch-V1.1-BOM.pdf}

            \includepdf[pages={1}, angle = 90]{assets/HW/PDF-Schematic/Switch-V1.1.pdf}

            \FloatBarrier

        \subsubsection{Switch Module V1.0}
            \begin{figure}[htp]
                \centering
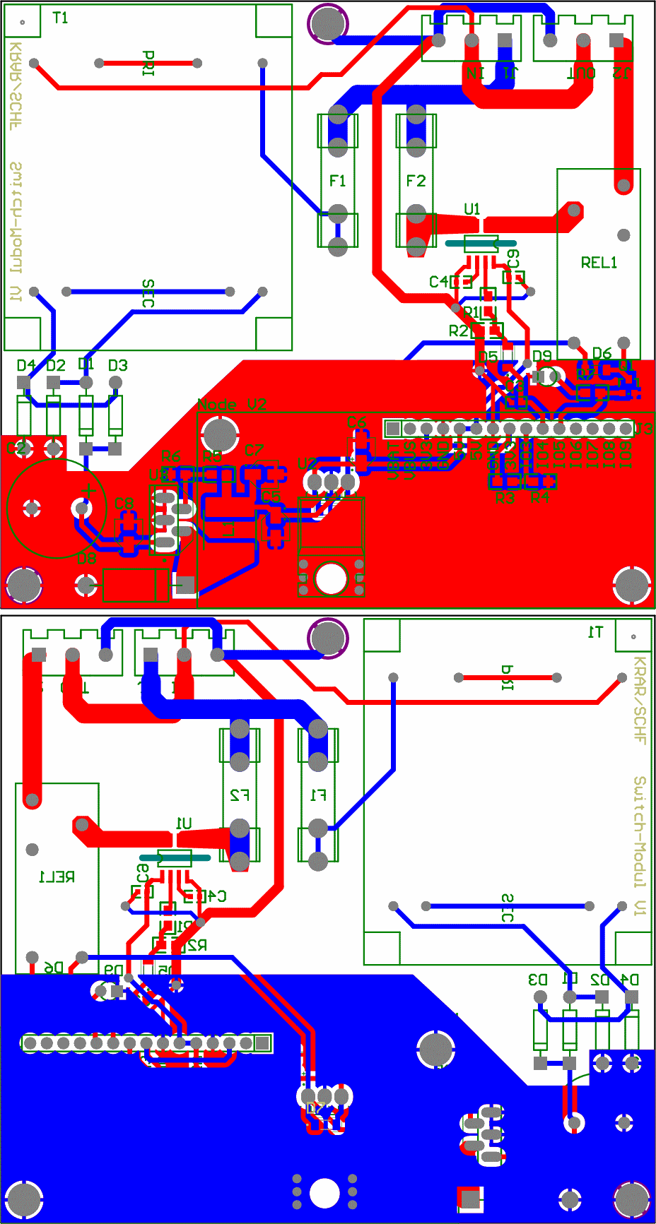
[picture p40: Diplomarbeit/assets/HW/PCB-SWITCH-V1.0-Vertical.png]
                
            \end{figure}

            \includepdf[pages={1}, angle = 0, scale = 1.20, pagecommand={\subsubsection{Switch Module V1.0 - BOM}}]
            {assets/HW/PDF-Schematic/Switch-V1.0-BOM.pdf}

            \includepdf[pages={1}, angle = 90]{assets/HW/PDF-Schematic/Switch-V1.0.pdf}
