SeriousHarlequin/FaRiSmarthome/Diplomarbeit/topics-hw/Basic-V1.tex

\subsection{Hardware - V1.1}
    Version 1.x of the basic module was intended to be a ruff prototype to test the concept of a 
    plugable battery powered module. For this reason only the battery module was designed for this
    version. Version 1.0 was never manufactured, but the design was used as a base for the
    version 1.1. The version 1.1 was manufactured and tested. 

    \subsubsection{Module Connector}
        The module connector has four connectors, one for the battery and three for the
        "modules".

        \begin{figure}[H]
            \centering
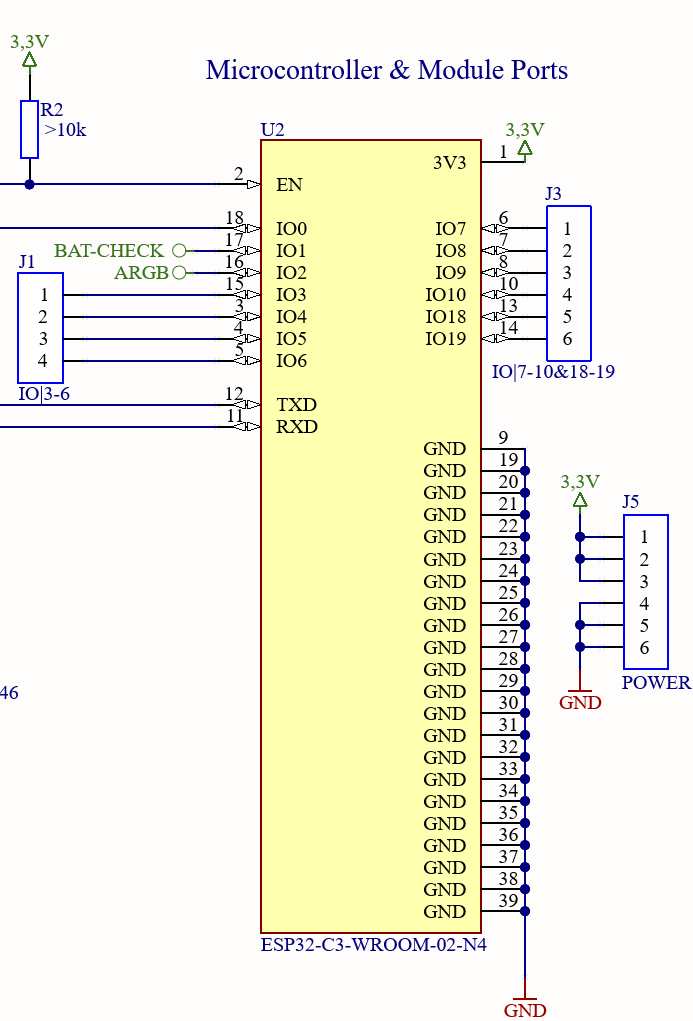
[picture p41: Diplomarbeit/assets/HW/NodeV1.1-ESP-C3.png]
            
            \caption{Microcontroller and module connector implemented in the schematic.}
            \label{fig:node-module-connectorV1.1}
        \end{figure}

        There are a 4 and 6 pin header with IO ports and a 6 pin header 
        for supplying power. It was not intended to design a module, besides the battery module,
        for this version. It was planned to be used as a development board by connecting
        the sensors over jumper wires.
        
        \begin{figure}[H]
            \centering
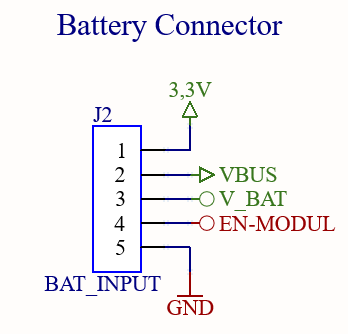
[picture p42: Diplomarbeit/assets/HW/NodeV1.1-Battery-Connector.png]
            
            \caption{Battery connector implemented in the schematic.}
            \label{fig:node-battery-connectorV1.1}
        \end{figure}

        When the Battery module is connected, VBUS and EN-MODUL are shorted together by the battery module.
        This is used to disable the linear voltage regulator on the basic module with the MOSFET Q1. 
        The battery module would then supply the basic module with 3.3V. 

        In version 2.0 a "real" module connector was though out and implemented see figure \ref{fig:module-connectorV2.2}.

    \subsubsection{DC-DC Converter}
        
        To convert the 5V from the USB port to 3.3V a LD33V linear regulator was used. This regulator
        would then be bypassed by the battery module when connected. Then the 3.3V would be supplied by the
        battery module. The 5V was also used to charge the battery.

        The LD33V is turned off by a P-channel MOSFET when the battery module was connected.

        \begin{figure}[H]
            \centering
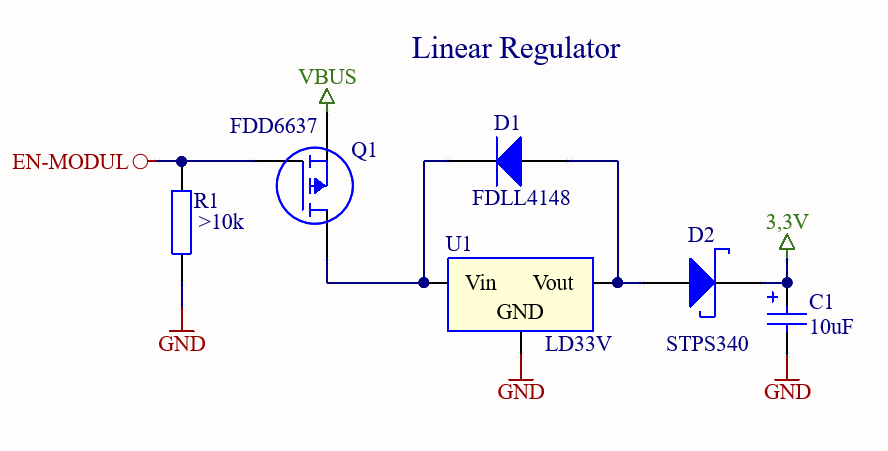
[picture p43: Diplomarbeit/assets/HW/NodeV1.1-DC-DC.png]
            
            \caption{DC-DC Converter implemented in the schematic.}
        \end{figure}

        Since there is no 5V on the board when the battery module is connected and this 
        voltage may be needed for future modules, it was decided to always supply the 
        base module with 5V and to replace the LD33V with a step-down converter in later version. 

    \subsubsection{USB-to-UART Converter}
        The USB-to-UART converter was deemed to be unnecessary since the IC was hard to solder on
        and the MCU could also be programmed over native USB, it was removed from later versions.

        \begin{figure}
            \centering
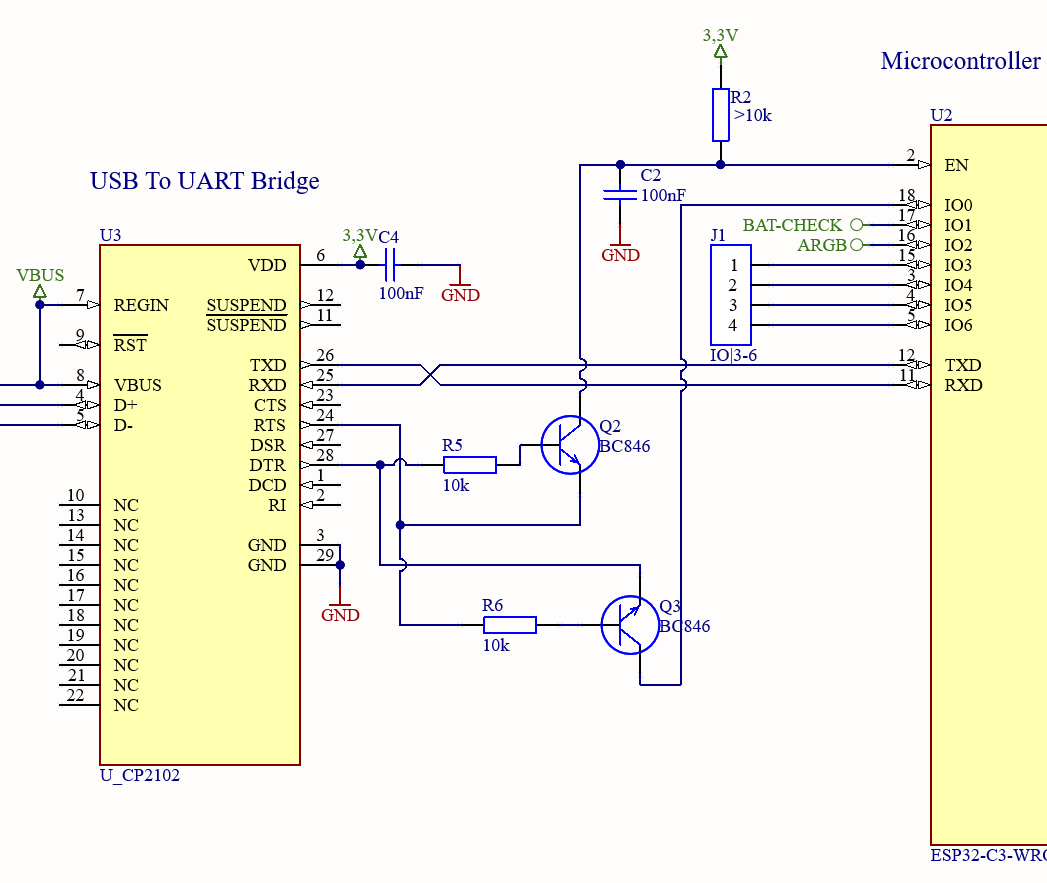
[picture p44: Diplomarbeit/assets/HW/NodeV1.1-CP2102.png]
            
            \caption{Serial-to-USB Converter implemented in the schematic.}
        \end{figure}

        It must be noted that IO 0 is not the right pin to put the ESP32-C3 into
        programming mode. The correct pin is IO 9 as stated in the documentaion of Espressif.\cite{noauthor_boot_nodate}
        This flaw was not discovered until V2.2 since it was not possible to solder the CP2102
        on the board without destroying it.

    \subsubsection{PCB - V1.1}

        The PCB of the basic module is a 2-layer board with a size of 75x30mm. 
        The PCB is designed to be mounted over the battery module.

        \begin{figure}[H]
            \centering
            
            \caption{PCB of the basic module V1.1. [Red - Frontside, Blue - Backside]}
            \label{fig:basic-module-pcb-V1.1}
        \end{figure}

        The most noticeable change to the board is the ESP32-C3's antenna, which 
        extends beyond the board's edge. In later versions the antenna stayed within the PCB
        to keep the size small and to make the designing of the case easier.

\subsection{Hardware - V1.0}
    This version had a finished schematic, but the PCB was never finished and further development into 
    version 1.1. The schematic is very similar to the version 1.1. Following components were different 
    in this version:
    
    \begin{itemize}
        \item 1. Micro USB connector was used.
        \item 2. No power header.
        \item 3. Different component values uesed for battery monitoring.
    \end{itemize}

    \subsubsection{Micro USB Connector}
        The first version of the basic module was designed to be powered over a micro USB connector.
        \begin{figure}[H]
            \centering
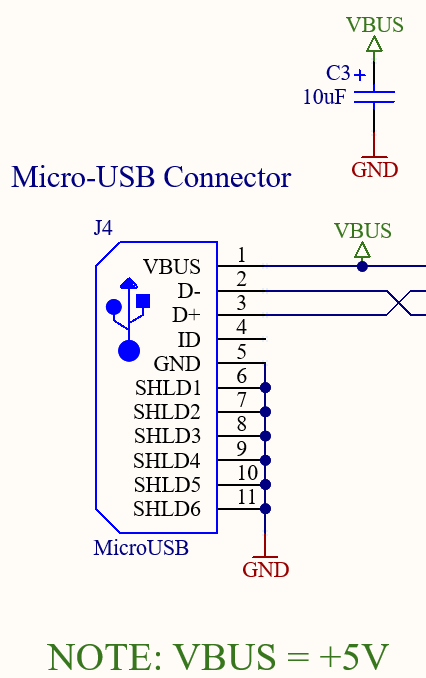
[picture p45: Diplomarbeit/assets/HW/NodeV1.0-Micro-USB.png]
            
            \caption{USB-C Connector implemented in the schematic.}
        \end{figure}

    \subsubsection{Power Headers}
        The power header J5 as seen in figure \ref{fig:node-module-connectorV1.1} is not implemented 
        in the first version of the basic module.

    \subsubsection{Battery Monitoring}
        The battery monitoring was done with a voltage divider with two 22kOhm resistors. 

        \begin{figure}[H]
            \centering
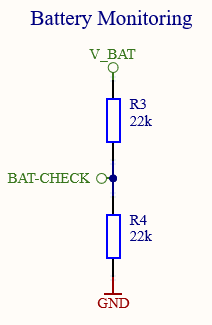
[picture p46: Diplomarbeit/assets/HW/NodeV1.0-Battery-Check.png]
            
            \caption{Battery implemented in the schematic.}
        \end{figure}

        In version 1.1V the resistor R3 and R4 were increased to 100kOhm to reduce the current 
        consumption of the voltage divider and a 100nF capacitor was added to filter the voltage.
