SeriousHarlequin/FaRiSmarthome/Diplomarbeit/topics-hw/Switch-V1.tex

    The switch module allows to switch 230V devices on and off and measure the current draw. 
    This module can not be combined with any other module. The switch module has two revisions,
    V1.0 and V1.1.

    Following components are required to fulfill the requirements:

    \begin{itemize}
        \item 1. Power-Supply
        \item 2. Switch
        \item 3. Current-Sensor
    \end{itemize}

\subsection{Hardware - V1.1(Final)}

    \subsubsection{Power-Supply}

        Because the switch module is switching 230V, it will also supply itself with this voltage.
        A transformer was chosen because of the simplicity.

        The used print transformer has the type FL4/9\cite{noauthor_low_nodate} it has two 115V primary windings and
        two 9V secondary windings. The primary windings are connected in serial to the 230V mains and the
        secondary windings are connected in serial to a full-bridge rectifier. 

        \begin{figure}[H]
            \centering
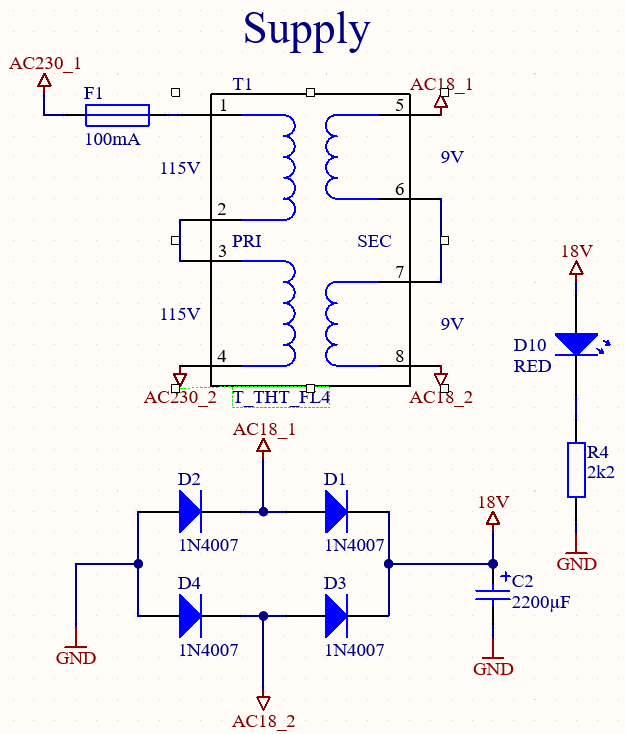
[picture p47: Diplomarbeit/assets/HW/Power-Supply-schematic.png]
            
            \caption{Power-Supply implemented in the schematic.}
        \end{figure}
        
        The output capacitor is calculated with the following formula:

        \begin{itemize}
            \item I ... Current draw
            \item $\Delta T$ ... Half the period of the frequency
            \item $\Delta U$ ... Ripple voltage
        \end{itemize}

        \begin{equation}
            C = \frac{I \cdot \Delta T}{\Delta U} = \frac{100mA \cdot 10ms}{0.5V} = 2mF \approx \textbf{2.2mF}
        \end{equation}
        \newline
        The output voltage of 18V is stepped down to 12V with the LM2575\cite{noauthor_lm2575_2015} buck converter. The output
        voltage is set with a resistor divider to 12V. There are fixed and adjustable versions of 
        the LM2575. If the 12V output version is chosen the Resistor R6 is not needed and R5 is
        bridged. 

        The 12V are used to drive the relay and to generate 5V with the LM7805 linear regulator. The base module and 
        current sensor are powered with the 5V.

         \begin{figure}[H]
            \centering
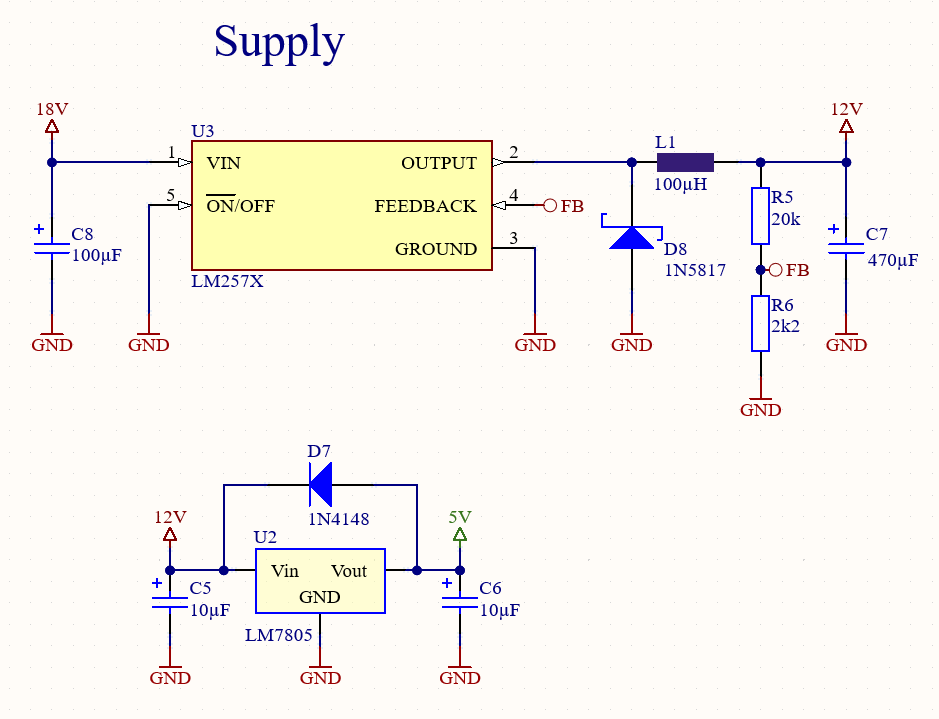
[picture p48: Diplomarbeit/assets/HW/Supply-schematic.png]
            
            \caption{Power-Supply implemented in the schematic.}
         \end{figure}

    \subsubsection{Relay}
        The switch module uses a relay to switch the 230V devices on and off. The relay used is 
        the JW1aFSN from Panasonic\cite{noauthor_jw_2024}. The relay is controlled by a transistor 
        and a flyback diode to protect the transistor from the voltage spike when the relay is switched off. 
        The relay is rated for 10A at 250VAC. A LED was added to the relay to indicate the state of the relay. 
        The LED is connected to the port of the microcontroller and a resistor to limit the current.

        \begin{figure}[H]
            \centering
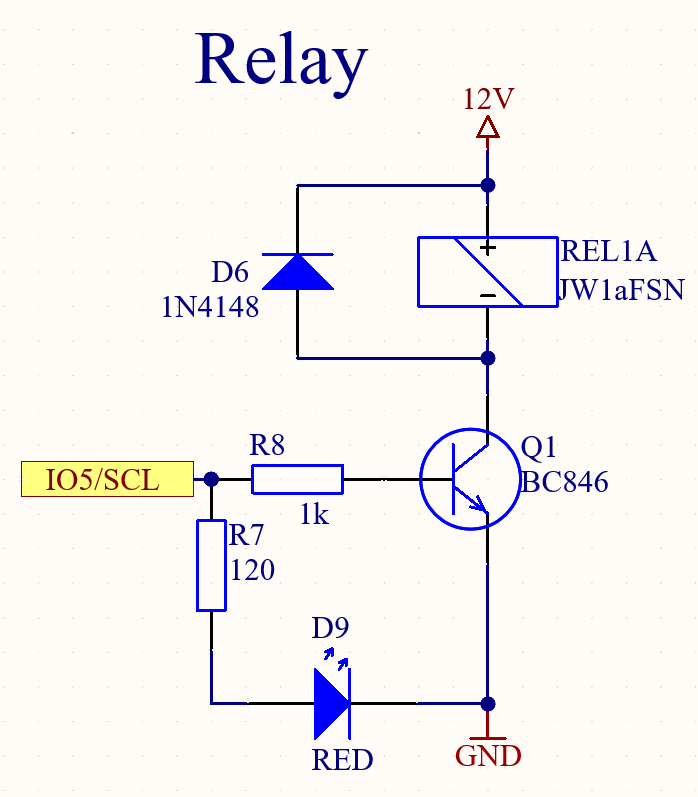
[picture p49: Diplomarbeit/assets/HW/Relay-Coil-schematic.png]
            
            \caption{Switch implemented in the schematic.}
        \end{figure}

        \begin{figure}[H]
            \centering
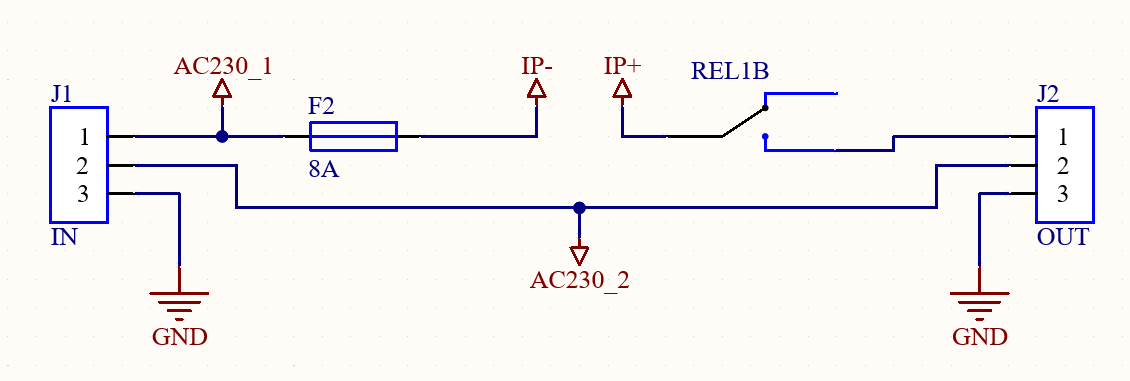
[picture p50: Diplomarbeit/assets/HW/Relay-Contact-schematic.png]
            
            \caption{Switch implemented in the schematic.}
        \end{figure}

        IP- and IP+ are the terminals for the current sensor.

    \subsubsection{Current-Sensor}

        The current sensor is used to measure the current draw of the switched device. For this
        purpose the ACS712ELCTR-20A-S\cite{noauthor_acs712_2024} from Allegro was chosen. It is 
        connected to the microcontroller over an analog pin. The sensor is rated for 20A. 

        The available versions of the sensor were capably of measuring $\pm 5A$, $\pm 20A$ and $\pm 30A$. 
        The 20A version was chosen because it covers the 10A current the relay is capable of. 
        The sensor is a Hall effect sensor, which measures the magnetic field of the current flowing
        through the wire. The sensor is placed in the current path of the relay. The sensor has a 
        sensitivity of 100mV/A, which means that the output voltage is 100mV for every ampere flowing
        through the wire.

        The IC is powered with 5V and the output on VIOUT is 2.5V when no current and 4.5V when 
        20A is flowing. In Order to adapt the output to the 3.3V ADC of the ESP32, a voltage divider
        is used like shown in the datasheet.

        \begin{figure}[H]
            \centering
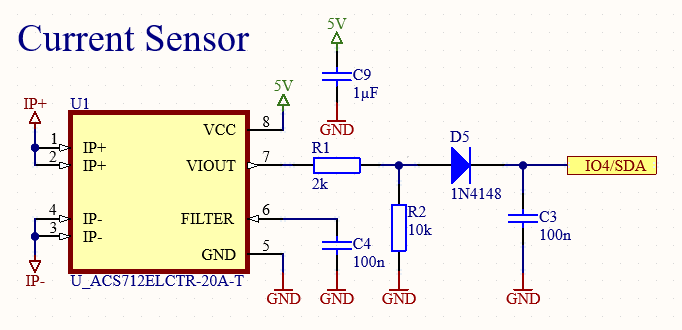
[picture p51: Diplomarbeit/assets/HW/Current-Sensor-schematic.png]
            
            \caption{Current-Sensor implemented in the schematic as shown in the datasheet.}
            \label{fig:current-sensor-schematic}
        \end{figure}

        The sensor is embedded in the current path of the relay. The terminals are 
        electrically isolated from the signal pins like described in the datasheet \cite{noauthor_acs712_2024}.

        The output of this circuit was tested and measured.
        A power supply in series with an amperemeter was connected to the terminals of the 
        current sensor and the amount of current was set in the power supply.
        The IC was supplied with 5V from a second power supply. The voltage was measured as 
        the current was altered though the IC. 
        \begin{figure}[H]
            \centering
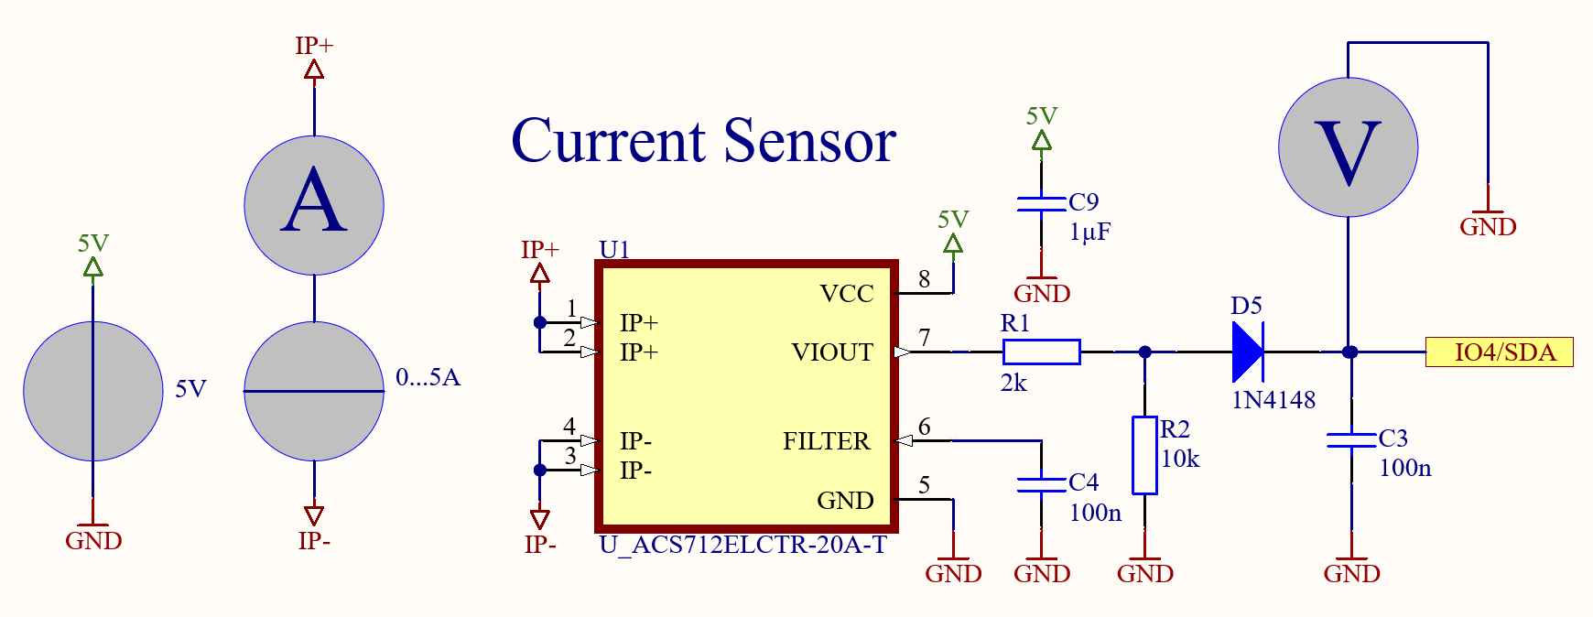
[picture p52: Diplomarbeit/assets/HW/Switch-Measurment-ACS712-circuit.png]
            
            \caption{Measurment circuit}
        \end{figure}
        
        The orange points are measured. All the other points were generated 
        since the power supply is only capable of 5A. The negative current was achieved by 
        swapping the terminals at the ACS712.

        \begin{figure}[H]
            \centering
            \begin{minipage}{0.8\textwidth}
                \centering
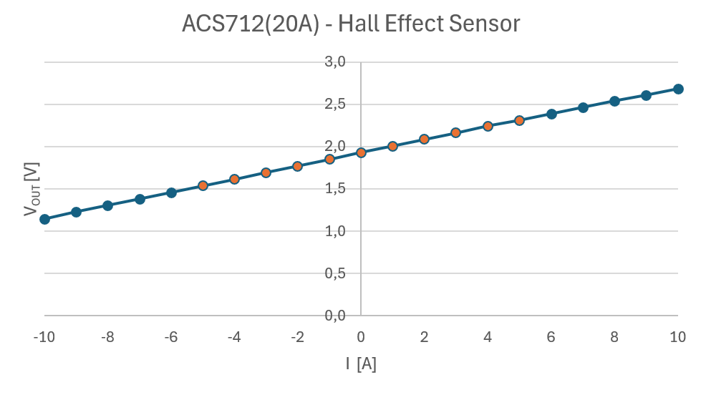
[picture p53: Diplomarbeit/assets/HW/Switch-Measurment-ACS712.png]
                
                \caption{Output Voltage versus Sensed Current of the ACS712.}
            \end{minipage}%
            \begin{minipage}{0.4\textwidth}
                \centering
                \begin{tabular}{|c|c|}
                    \hline
                    \textbf{I[A]} & \textbf{\(V_{OUT}\)[V]} \\
                    \hline  
                    5 & 2.310 \\
                    4 & 2.240 \\
                    3 & 2.160 \\
                    2 & 2.087 \\
                    1 & 2.006 \\
                    0 & 1.928 \\
                    -1 & 1.849 \\
                    -2 & 1.769 \\
                    -3 & 1.691 \\
                    -4 & 1.613 \\
                    -5 & 1.537 \\
                    \hline
                \end{tabular}
                \captionof{table}{Measurments}
            \end{minipage}
        \end{figure}

        The output voltage stays linear with a avarage change of 77.3mV/A.
        \begin{table}[H]
            \centering
            \begin{tabular}{|c|c|c|c|}
                \hline
                \textbf{Device} & \textbf{Model} & \textbf{Purpose} \\
                \hline
                Powersupply & EMG 18135 & Supply voltage for ACS712 \\
                \hline
                Powersupply & Korad KA3005D DC  & Simulating current draw \\
                \hline
                Multimeter & Voltcraft VC271  & Measuring voltage \\
                \hline
                Multimeter & Fluke 175 true rms & Measuring current \\
                \hline
            \end{tabular}
            \caption{Used devices for measuring the current sensor.}
        \end{table}

        \subsubsection{PCB - V1.1}

        The 230V aspect was taken into account when designing the circuit board. The PCB is divided
        into two sections, the 230V and the low voltage section, which is marked by the ground plane. 
        The relay, current sensor and the transformer are placed in the 230V section. 
        Underneath the current sensor is a milled slot to ensure the isolation of the terminals. 
        
        \begin{figure}[H]
            \centering
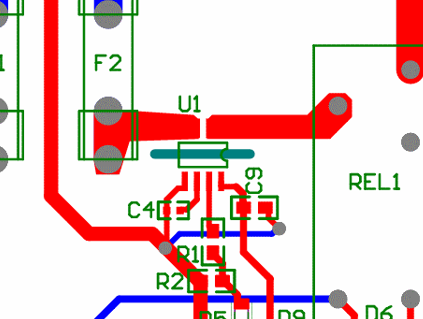
[picture p54: Diplomarbeit/assets/HW/AC712-Cutout.png]
            
            \caption{Cutout to prevent leakage current.}
        \end{figure}

        The PCB has a size of 100x92mm. The switch module uses both SMD and THT components. It was decided to use more THT 
        components on this module, because most parts were already available as THT.

        \begin{figure}[H]
            \centering
            
            \caption{PCB of the switch module V1.1 [Blue - Backside, Red - Frontside].}
        \end{figure}

\subsection{Hardware - V1.0}

    This version of the switch module is almost identical to the V1.1. Only minor changes were made
    to ensure the functionality of the module:

    \subsubsection{Relay}
    The base resistor of the transistor was forgotten in the schematic. The transistor was destroyed
    when the MCU pulled the port high. To prevent this in V1.1, a base resistor was added to limit 
    the current.

    \begin{figure}[H]
        \centering
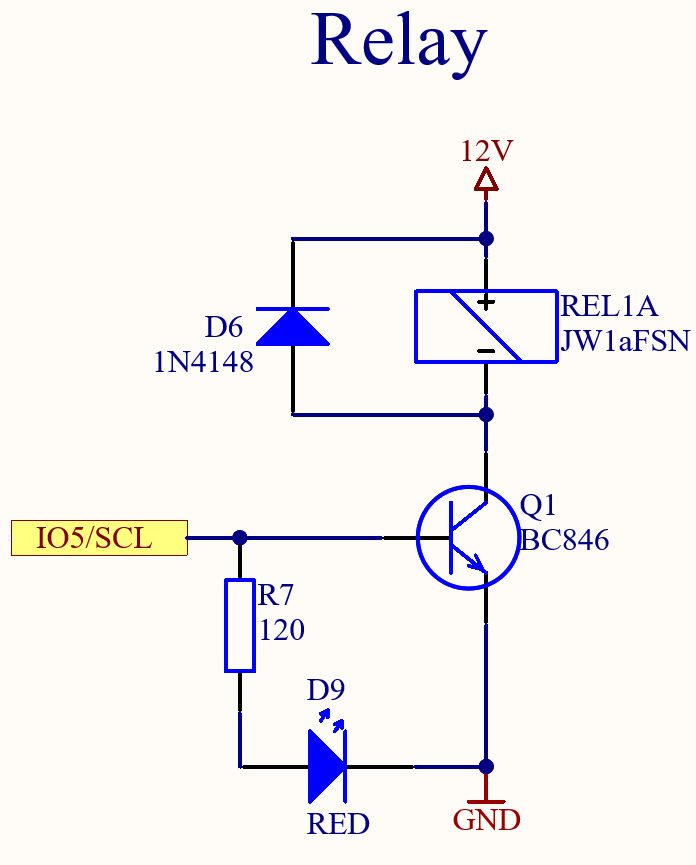
[picture p55: Diplomarbeit/assets/HW/SwitchV1.0-Relay.png]
        
        \caption{Missing base resistor before transistor Q1.}
    \end{figure}

    \subsubsection{Power-Supply}
    While testing the module it was found that it is nowhere shown when 230V is present. Therefore,
    a LED was added after the rectifier to indicate the presence of 230V.

    \subsubsection{Footprint}
    Footprints were changed in size to ensure the correct fit of the components.

    \subsubsection{PCB - V1.0}
    The PCB is identical in size with 100x92mm. 
        \begin{figure}[H]
            \centering
            
            \caption{PCB of the switch module V1.0 [Blue - Backside, Red - Frontside].}
        \end{figure}
