SeriousHarlequin/FaRiSmarthome/Diplomarbeit/topics-hw/Basic-V2.2_final.tex

\subsection{Hardware - V2.2(Final)}
\setAuthor{Richard Krammer}

    This section describes the latest hardware of the basic module. The basic module is a 
    simple node that can measure the ambient temperature and control four RGB-LEDs.
    The hardware consists of the following components:

    \begin{itemize}
        \item Microcontroller
        \item Temperature Sensor
        \item LED Indicator
        \item USB-C Connector
        \item Serial Port
        \item DC-DC Converter
        \item Module Connector
        \item Battery Monitoring
        \item Module Detection
        \item Spare Header
    \end{itemize}

    \subsubsection{Microcontroller}
        \vfill
        The basic module uses an ESP32-C3-wroom-02 \cite{noauthor_esp32-c3_2023} microcontroller. 
        It is a low-power, highly integrated Wi-Fi and Bluetooth SoC. In the data sheet 
        it was stated that the MCU is recommended for a wide range of applications, including smart home devices 
        and other IoT products.
        Before the ESP32-C3 was chosen, it was compared with the ESP32-S3-wroom-2\cite{noauthor_esp32-s3-wroom-2_2022} 
        to see which one would be the better fit for the basic module. 

        \vspace{0.5cm}
        \begin{Parallel}{0.45\textwidth}{0.45\textwidth}
            \ParallelLText{
            \textbf{ESP32-C3-WROOM-02 :}
            \begin{itemize}
                \item 15 GPIOs
                \item Single-core 32-bit RISC-V CPU up to 160Mhz
                \item 4 or 8 MB flash
                \item PCB antenna  external antenna version

            \end{itemize}
            }
            \ParallelRText{ 
            \textbf{ESP32-S3-WROOM-2 :}
            \begin{itemize}
                \item 33 GPIOs
                \item Dual-core 32-bit RISC-V CPU up to 240Mhz
                \item 16 or 32 MB flash
                \item PCB antenna  external antenna version
                
            \end{itemize}
            }
            \ParallelPar
        \end{Parallel}

        \begin{figure}[H]%
            \centering
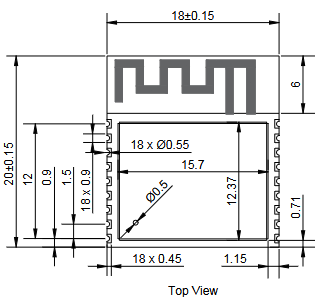
[picture p56: Diplomarbeit/assets/HW/ESP32-C3-sheet.png]
            \subfloat[\centering ESP-C3]{{ }}%
            \qquad
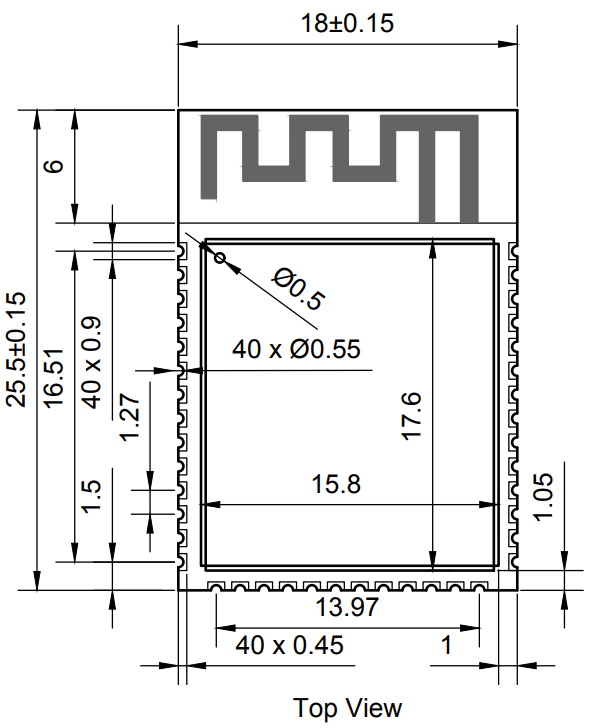
[picture p57: Diplomarbeit/assets/HW/ESP-S3-sheet.png]
            \subfloat[\centering ESP-S3]{{ }}%
            \caption{Physical comparison of the ESP32-C3 and ESP32-S3, Unit in mm.}%
        \end{figure}

        The ESP32-C3 does not have as many GPIO pins compared to the ESP32-S3, however the 
        abundance of GPIO pins is not necessary for the basic module. The ESP32 C3 is also 
        cheaper and allocates less space on the PCB.

        \begin{figure}[H]
            \centering
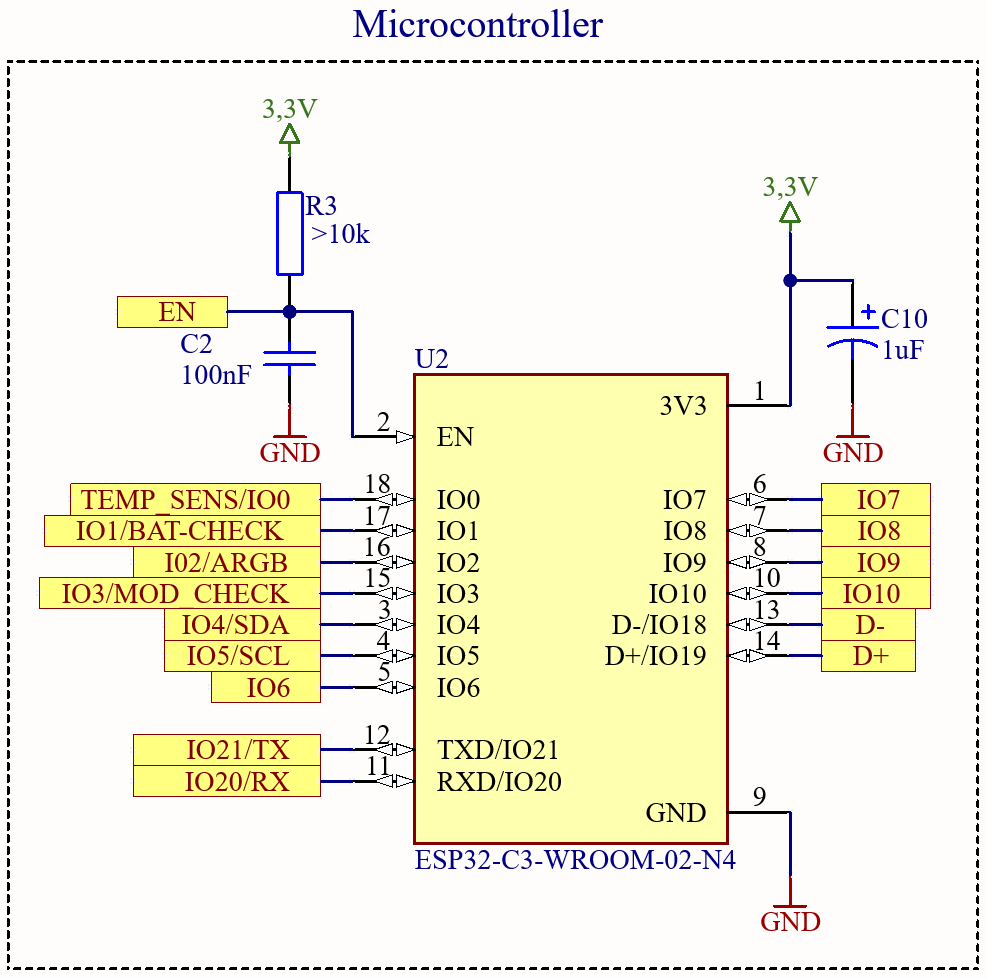
[picture p58: Diplomarbeit/assets/HW/ESP32-C3-schematic.png]
            
            \caption{ESP32-C3 implemented in the schematic.}
        \end{figure}

    \subsubsection{Temperature Sensor}
        The DS18B20\cite{noauthor_ds18b20_nodate} was chosen as the temperature sensor. It is a digital thermometer
        with an operating temperature range of -55°C to +125°C. The sensor is connected
        to the microcontroller via GPIO0 and communicates over a 1-Wire bus.

        \begin{figure}[H]
            \centering
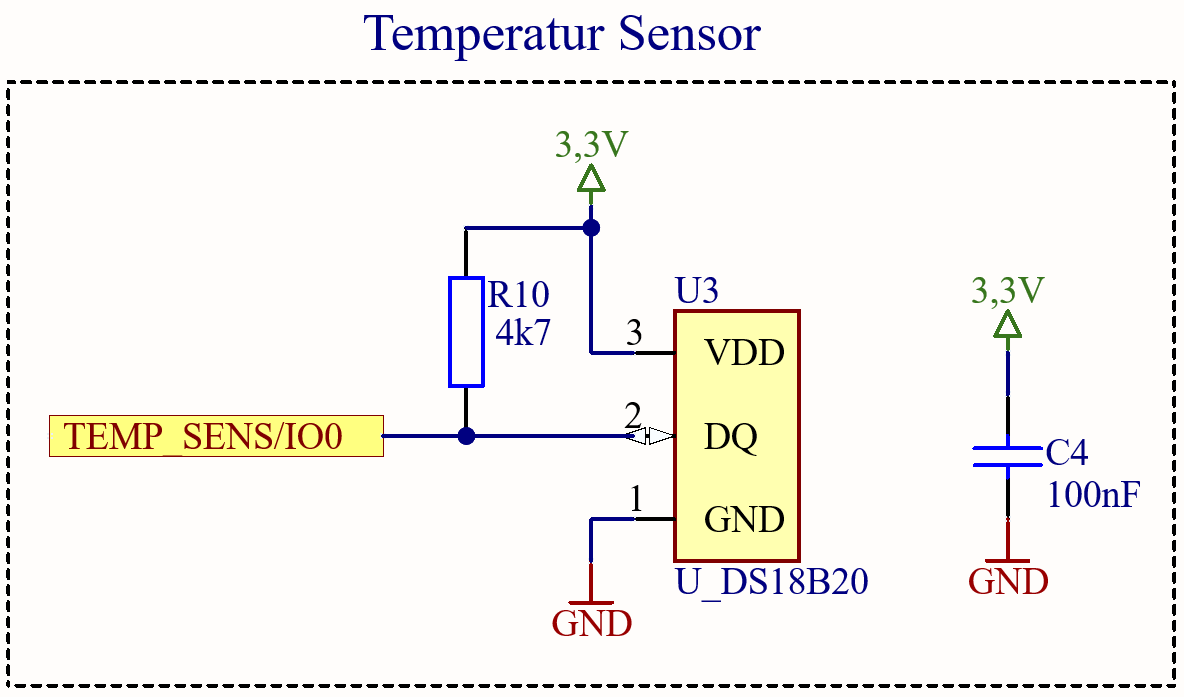
[picture p59: Diplomarbeit/assets/HW/DS18B20-schematic.png]
            
            \caption{DS18B20 implemented in the schematic.}
        \end{figure}

        As seen on the PCB in figure \ref{fig:basic-module-pcb-V2.2} the DS18B20 is mounted near the
        ESP-32-C3. While testing, it was noticed that the temperature sensor was affected by the
        heat of the ESP32-C3. This issue will be fixed in the next version of the basic node. 

    \subsubsection{LED Indicator}
        The basic module has four addressable RGB-LEDs. Those LEDs have an integrated 
        controller and can be controlled individually. The WS2812b\cite{noauthor_ws2812b_nodate} 
        needs 5V, GND and a DATA-IN. DATA-IN is connected to the microcontroller via GPIO 2. 
        The LEDs can be cascaded by connecting the DATA-OUT of the last LED to the DATA-IN of 
        the next LED. The LEDs are used to indicate the status of the node. For example, to 
        indicate if it detected motion or to display the charge-level of the battery, 
        when the corresponding module is attached.

        \begin{figure}[H]
            \centering
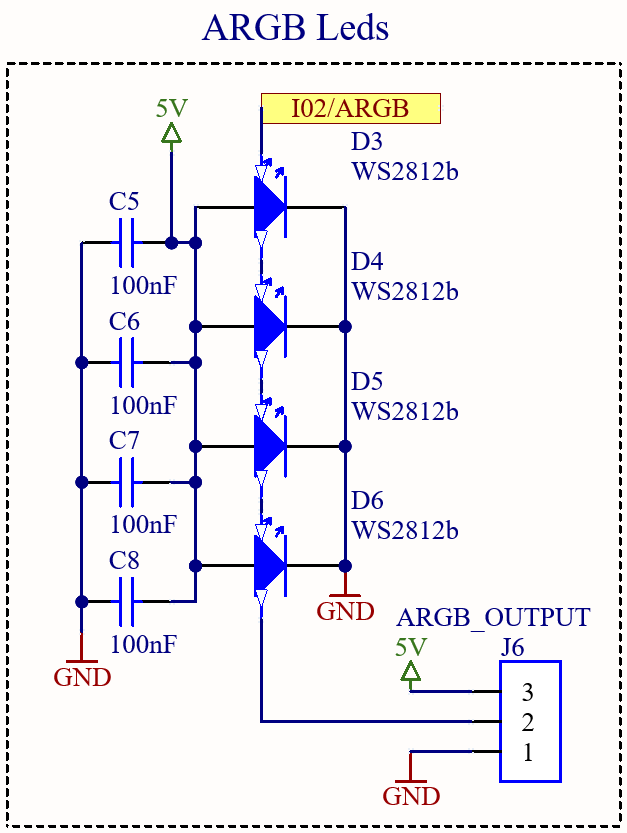
[picture p60: Diplomarbeit/assets/HW/RGB-LED-schematic.png]
            
            \caption{RGB-LEDs implemented in the schematic.}
        \end{figure}

    \subsubsection{USB-C Connector}

        The USB-C connector is used to power and program the basic node. The connector can
        be plugged in both ways, which makes it more user-friendly. This particular connector was chosen, duo to being the new standard for USB connectors, 
        therefor being widely spread.

    \begin{figure}[H]
        \centering
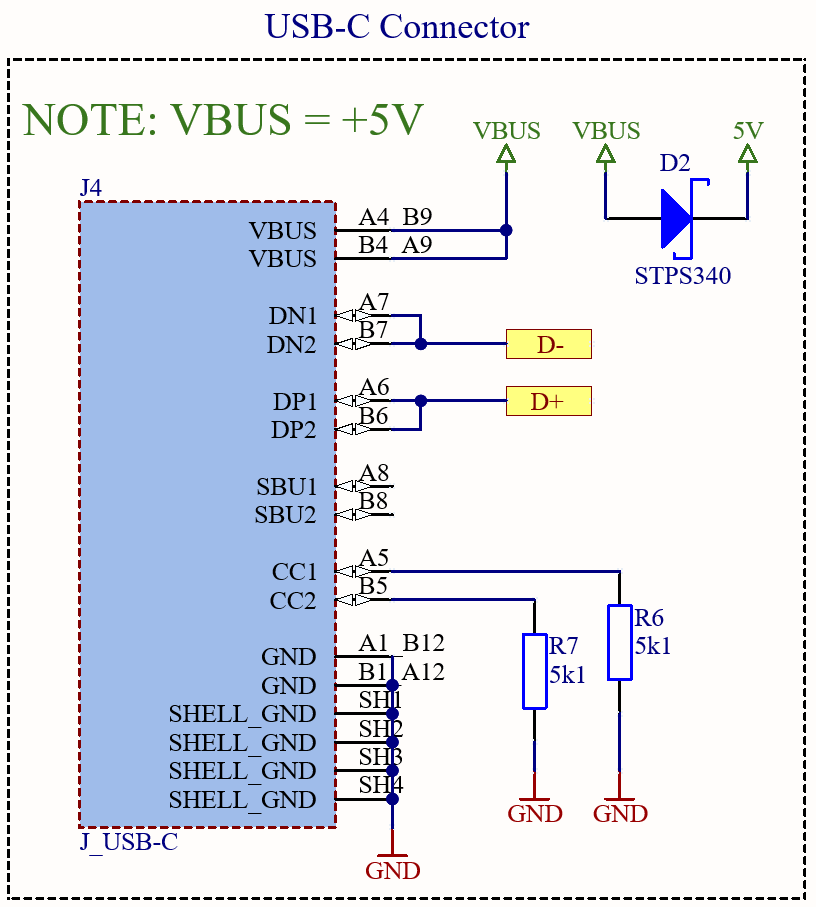
[picture p61: Diplomarbeit/assets/HW/USB-C-schematic.png]
        
        \caption{USB-C Connector implemented in the schematic.}
    \end{figure}

        In order to power the basic node with 5V, a 5.1k\(\Omega\) resistor is connected to 
        the CC1 and CC2 each. The resistor tells the charger that the basic node is a 
        default USB device and can draw up to 3A of current. \cite{noauthor_fugen_2023} A schottky diode is used to avoid backflow of current.

    \subsubsection{Serial Port}

        This interface is used to program the basic node. The interface is connected directly
        with the UART of the ESP32-C3. 

    \begin{figure}[H]
        \centering
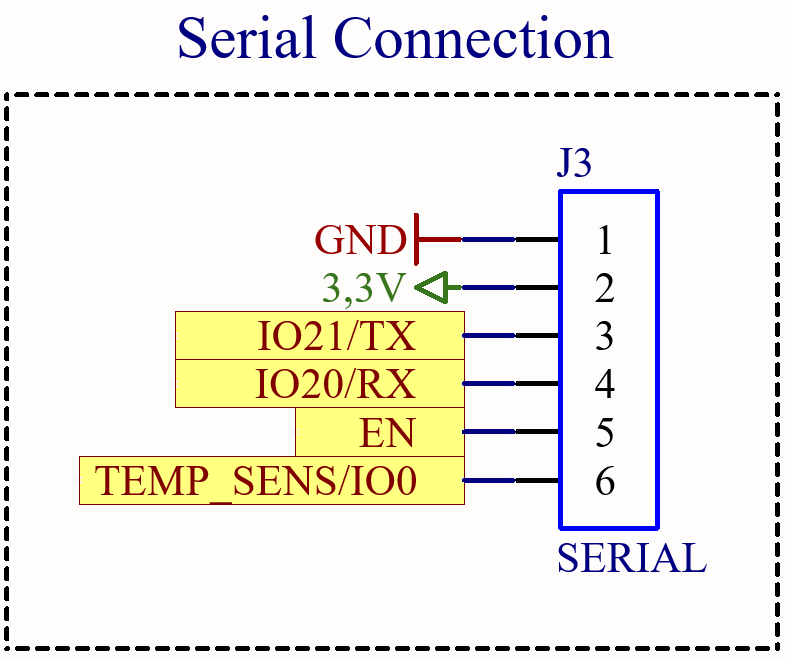
[picture p62: Diplomarbeit/assets/HW/Serial-Port-schematic.png]
        
        \caption{Serial-Port implemented in the schematic.}
        \label{fig:serial-portV2.2}
    \end{figure}

        It must be noted that pin 0 is not the right one to bring the ESP32-C3 into programming mode.
        It was designed out of habit, since previous ESP32 always used pin 0 to enter
        programming mode. The correct pin is GPIO 9 like stated in the documentation\cite{noauthor_boot_nodate}.
    
    \subsubsection{DC-DC Converter}

        The step-down converter TLV62569 \cite{noauthor_tlv62569_2017} from Texas Instruments is used to convert 
        the 5V from the USB-C connector to 3.3V. The converter has a high efficiency
        of up to 95\%, which is significant for battery operation. It powers the
        microcontroller, temperature sensor and a module, if attached to the
        module connector.

        To set the output voltage, a voltage divider is used to feed the FB pin of the IC. 
        With following formula the output voltage can be calculated:

    \begin{equation}
        V_{OUT} = V_{FB} \cdot (1 + \frac{R_1}{R_2}) 
    \end{equation}

    \begin{equation}
        R_1 = (\frac{V_{OUT}}{V_{FB}} - 1) \cdot {R_2} 
    \end{equation}

        The output voltage $V_{OUT}$ was set to 3.3V. The feedback voltage $V_{FB}$ 
        of the converter is 0.6V. The resistor $R_2$ was set to 200k\(\Omega\).

    \begin{equation}
        R_1 = (\frac{3.3V}{0,6V} - 1) \cdot {200kOhm} = {900kOhm} \approx \textbf{910kOhm(E24)}
    \end{equation}
    
    \begin{figure}[H]
        \centering
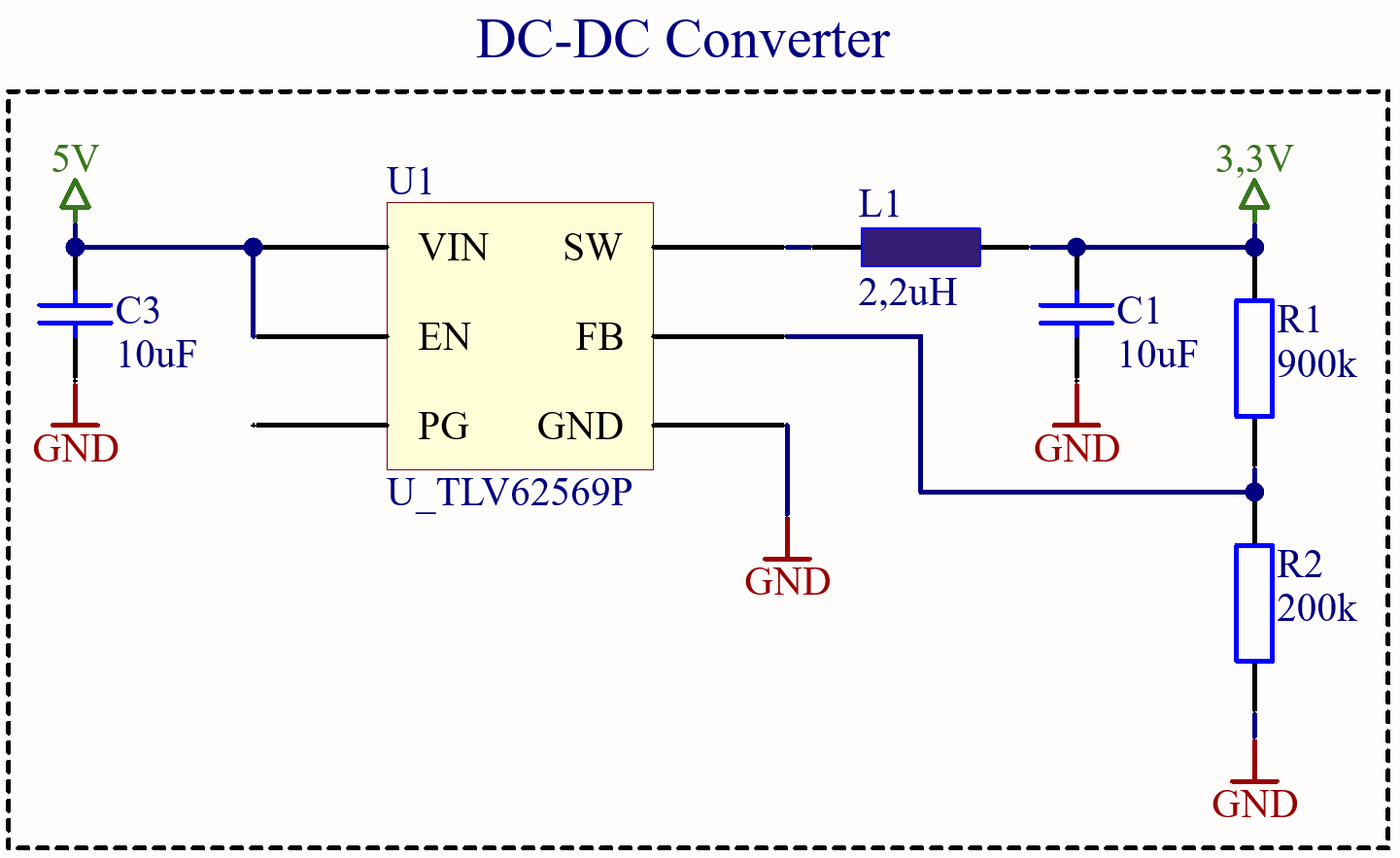
[picture p63: Diplomarbeit/assets/HW/DC-DC-schematic.png]
        
        \caption{TLV62569 Converter implemented in the schematic.}
    \end{figure}

        The Power-Good feature is not used in this application. The EN pin is connected to 
        5V to enable the converter.

    \subsubsection{Module Connector}

        The module connector is used to join additional modules to the basic module.
        The connector has 15 pins, 8 for power and power management and 7 for 
        communication. 

    \begin{figure}[H]
        \centering
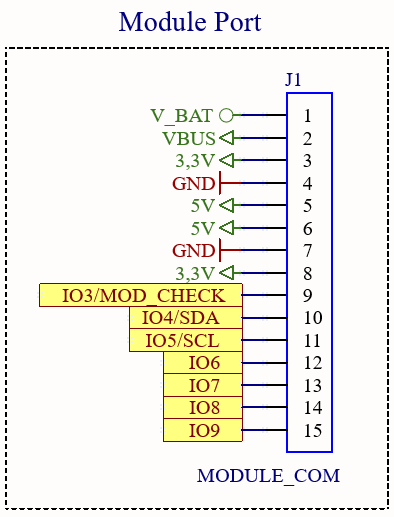
[picture p64: Diplomarbeit/assets/HW/Node-Module-Connector.png]
        
        \caption{Module-Connector implemented in the schematic.}
        \label{fig:module-connectorV2.2}
    \end{figure}

        Pin 3-5 and 6-8 are symmetrical to each other. It was designed this way
        to allow the battery module and motion module(or for future modules) to be attached simultaneously.
        The battery module is plugged into pin 1-5 and is connected to following 
        voltages:
    
    \begin{itemize}
        \item 1. VBAT - used to monitor the battery voltage
        \item 2. VBUS - used to charge and disable the battery module when the USB-C 
        is connected
        \item 3. 3V3 - not used, but may be relevant for future modules/revisions
        \item 4. GND
        \item 5. 5V - The battery module powers the basic node over this pin
    \end{itemize}

        Pin 6-15 are used for communication between the modules. 

    \subsubsection{Spare Header}
            
        The basic node has a spare header, which can be used to attach a button or 
        magnetic switch. The button can be used to interact with the node or trigger
        a specific action. The header has 2 pins GND and GPIO 10 which is pulled to 3.3V.

        \begin{figure}[H]
            \centering
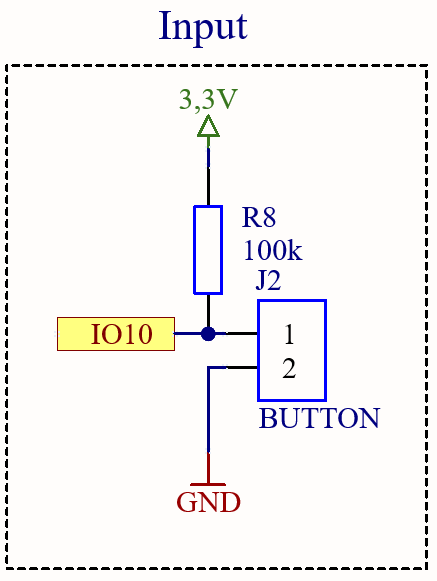
[picture p65: Diplomarbeit/assets/HW/NodeV2.2-Input.png]
            
            \caption{Spare header implemented in the schematic.}
            \label{fig:spare-header}
        \end{figure}

    \subsubsection{Battery Monitoring}

        The battery module has a voltage divider to monitor the battery voltage,
        to reduce the voltage to a safe level for the MCU to read. 
        The voltage is measured by the ADC of the microcontroller and can be used to determine
        the charge level of the battery. The voltage divider is connected to pin 1 of the 
        module connector. When the battery reaches a certain voltage, the microcontroller 
        can go into deep-sleep mode to save power. The 100nF capacitor is used to filter 
        out noise from the battery.

        \begin{figure}[H]
            \centering
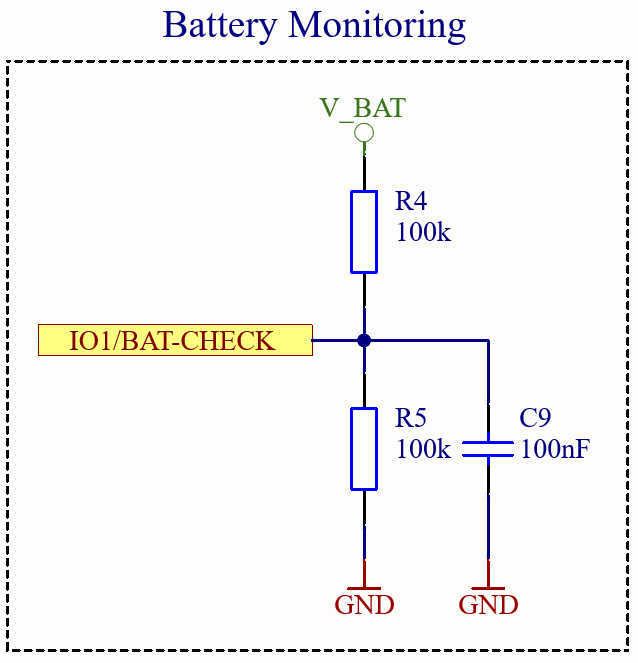
[picture p66: Diplomarbeit/assets/HW/NodeV2.2-Battery-Check.png]
            
            \caption{Battery Monitoring implemented in the schematic.}
        \end{figure}

    \subsubsection{Module Detection}
    
        The basic node recognizes the attached module by measuring the voltage on pin 3.
        A 100kOhm resistor is installed on the base module pulling pin 3 to GND. 
        When a module is attached, a voltage divider is created. The input voltage is 
        determined by the second resistor on the module.
    
    \begin{figure}[H]
        \centering
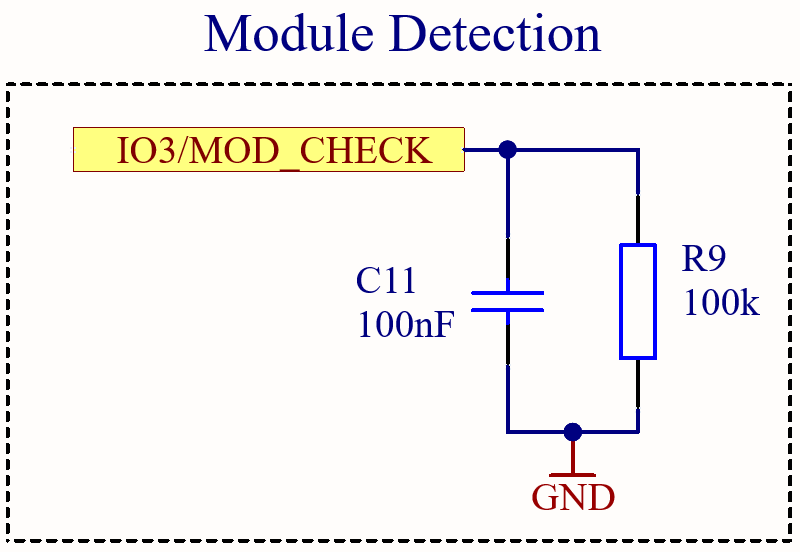
[picture p67: Diplomarbeit/assets/HW/Node-Module-Check.png]
        
        \caption{Module-Detection implemented on the base module.}
    \end{figure}

    \subsubsection{PCB - V2.2}

        The PCB has a size of 75x30mm. The components used were mainly SMD components, 
        to keep the PCB small. The PCB is a 2-layer board with a ground plane on
        both sides.

    \begin{figure}[H]
        \centering
        
        \caption{PCB of the basic node. [Red - Frontside, Blue - Backside]}
        \label{fig:basic-module-pcb-V2.2}
        \end{figure}
