SeriousHarlequin/FaRiSmarthome/Diplomarbeit/topics/case.tex

\section{Case} \setAuthor{Richard Krammer}
    There were cases designed for every module to protect the electronics inside and
    give the modules a finished look. The cases were only designed for the final versions of
    the modules. It was designed in Fusion 360 and manufactured with an FDM 3D printer out of 
    PLA. 

    \FloatBarrier
    \subsection{Basic}

        This case consists of two parts, the top and the bottom. The top part has 
        a cutout for the temperature sensor, LEDs the spare header and the 
        serial interface.

        \begin{figure}[htbp]
            \centering
            
            \caption{Top view}
        \end{figure}
        \needspace{5\baselineskip}
      
        \begin{figure}[htbp]
            \centering
            
            \caption{Bottom view}
        \end{figure}
        The bottom part has a cutout for the module connector.
        \begin{figure}[htbp]
            \centering
            
            \caption{Partly disassembled}
        \end{figure}

    \FloatBarrier \newpage
    \subsection{Battery}
        
        This case consists of three pieces, the main part and the two covers for the PCB
        and the battery.

        \begin{figure}[H]
            \centering
            
            \caption{Front view}
        \end{figure}

        \begin{figure}[htbp]
            \centering
            
            \caption{Back view}
        \end{figure}

        \begin{figure}[htbp]
            \centering
            
            \caption{Partly disassembled}
        \end{figure}
        The battery case is designed to hold a 22700 battery. 

    \FloatBarrier
    \subsection{Motion}
        This case consists of two parts, the bottom and the cover for the PCB. 

        \begin{figure}[H]
            \centering
            
            \caption{Top view}
        \end{figure}

        \begin{figure}[htbp]
            \centering
            
            \caption{Disassembled}
        \end{figure}

        \FloatBarrier 
    \subsection{Switch}
        This case consists of three part, the base and the two covers for the PCB.
            
            \begin{figure}[H]
                \centering
                
                \caption{Switch fully assembled with input and output cables.}
            \end{figure}
    
            \begin{figure}[htbp]
                \centering
                
                \caption{Partly disassembled}
            \end{figure}

            A cable strain relief was integrated into the case.
    \FloatBarrier
    \subsection{Combined Module}
            
            \subsubsection{Base, Battery and Motion Module}

            \begin{figure}[H]%
                \centering
                \subfloat[\centering Front view]{{ }}%
                \qquad
                \subfloat[\centering Side view]{{ }}%
                \caption{Battery and motion module next to each other.}%
                \label{fig:example}%
            \end{figure}
            The base module fits on top of both modules.

            \begin{figure}[H]
                \centering
                
                \caption{Basic, battery and motion module combined.}
            \end{figure}

            \subsubsection{Base and Motion Module}
        
            \begin{figure}[htbp]
                \centering
                
                \caption{Base module combined with switch module.}
            \end{figure}

            A cutout was added to make pulling the base module off the switch module easier.
