SeriousHarlequin/FaRiSmarthome/Diplomarbeit/topics/introduction.tex

\chapter{Introduction}
\renewcommand*\chapterpagestyle{scrheadings}
\setAuthor{Fabian Schätzschock}

    \section{Our Ambitions}
        Most free smart home solutions are either too limited in
        functionality or dependent on proprietary software.
        The goal of this project is to provide an open source
        smart home solution that enables the user to easily modify 
        and extend the system with their own design. Another goal of
        this project is to provide a smart home solution that does
        not require every node to be reachable via WLAN. Finally,
        the smart home devices functionalities should be
        interchangeable in a live environment. This means that
        the user can change the functionality of a node without
        having to reprogram it.

    \section{Terminology}
        \begin{itemize}
            \item \textbf{Node:} A whole smart home device that
            consists of a base module and optional extension modules.

            \item \textbf{Module:} A part of a Node that provides
            a specific functionality. An extension module can be
            attached to a Node to extend its functionality.

        \end{itemize}

    \section{List of abbreviations}
        \begin{itemize}
            \item \textbf{ESP:} Espressif Systems
            \item \textbf{HTTP:} Hypertext Transfer Protocol
            \item \textbf{UDP:} User Datagram Protocol
            \item \textbf{GPIO:} General Purpose Input/Output
            \item \textbf{IDE:} Integrated Development Environment
            \item \textbf{CMake:} Cross-platform Make
            \item \textbf{PIR:} Passive Infrared Sensor
            \item \textbf{PCB:} Printed Circuit Board
            \item \textbf{USB:} Universal Serial Bus
            \item \textbf{UART:} Universal Asynchronous Receiver-Transmitter
            \item \textbf{ADC:} Analog-to-Digital Converter
            \item \textbf{ARGB:} Addressable RGB
            \item \textbf{SoC:} System on Chip
            \item \textbf{MCU:} Microcontroller Unit
            \item \textbf{PLA:} Polylactic Acid
        \end{itemize}
