SeriousHarlequin/FaRiSmarthome/Diplomarbeit/topics/Modules-Battery.tex

\vspace{4cm}
\section{Battery Module} \setAuthor{Richard Krammer}

The battery module is used to power the basic node, without the need
to have a power outlet nearby. This module 
can be attached to the base module alongside the motion detector module.

Following components are required to fulfill the requirements:

    \begin{itemize}
        \item 1. Battery
        \item 2. Power-Managment-System
        \item 3. DC-DC Converter
        \item 4. ON/OFF switch
    \end{itemize}

\input{topics-hw/Battery-V2.2.tex}
\input{topics-hw/Battery-V2.1.tex}
\input{topics-hw/Battery-V1.tex}
