SeriousHarlequin/FaRiSmarthome/Diplomarbeit/topics/Modules-Motion.tex

\section{Motion Detector Module} \setAuthor{Richard Krammer}

    This module allows the node to detect motion in its environment. This module can be 
    attached simultaneously with the battery module to the base bodule.
    The motion module has two revisions, V1.0 and V1.1. The only difference is that 
    a resistor was removed from the V1.1 version. The schematic and layout did not 
    change. The resistor was removed from this print and one was added to the Base Module
    in order to prevent the GPIO pin from floating.
    
    \subsection {Hardware - V1.1(Final)}

        Following components are required to fulfill the requirements:
        \begin{itemize}
            \item 1. Sensor
            \item 2. Module Connector
        \end{itemize}

        \subsubsection{Sensor}
            The PIR sensor EKMB1305111K\cite{noauthor_pir_2019} is used to detect motion. This particular sensor was chosen
            for its ability to oversee a wide angel of about 150° with a range of 5m, therefor it is
            a good choice to observe corridors or rooms in a house.

            \begin{figure}[htbp]
                \centering
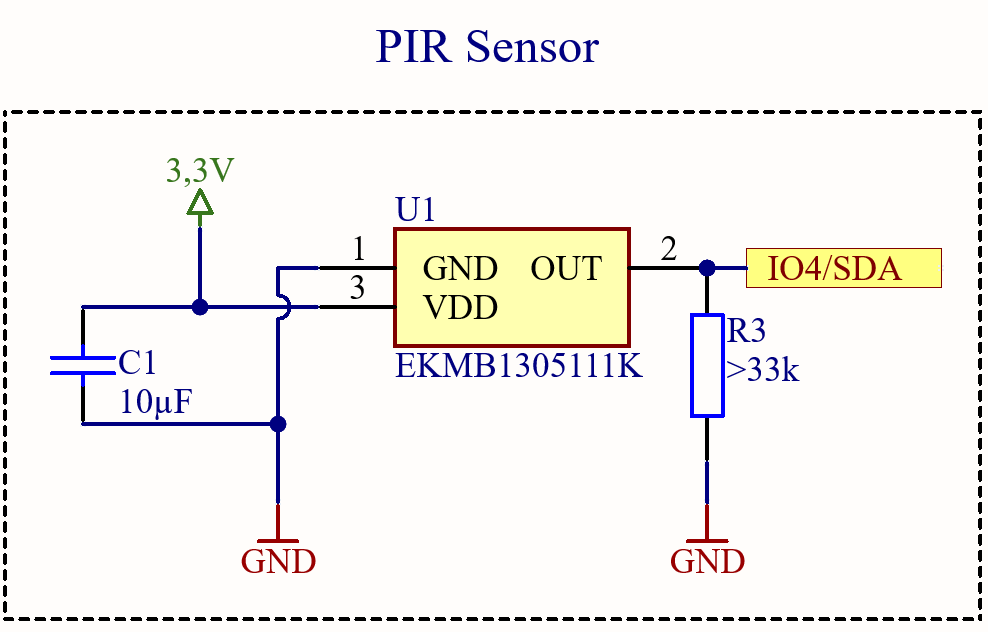
[picture p74: Diplomarbeit/assets/HW/Motion-IRF.png]
                
                \caption{PIR Sensor implemented in the schematic.}
            \end{figure}

            The sensor operates with a voltage of 3.3V.
            The sensor has a digital output, which is connected to the GPIO pin 4 of the ESP32-C3.
            The pull down resistor R3 is required since the sensor output is a drain.

        \subsubsection{Module Connector}
            The Motion Module connects with an 10-pin connector to the Base Module. It is supplied 
            with 3.3V and GND. And pin 4 is used to read the sensor.

            \begin{figure}[H]
                \centering
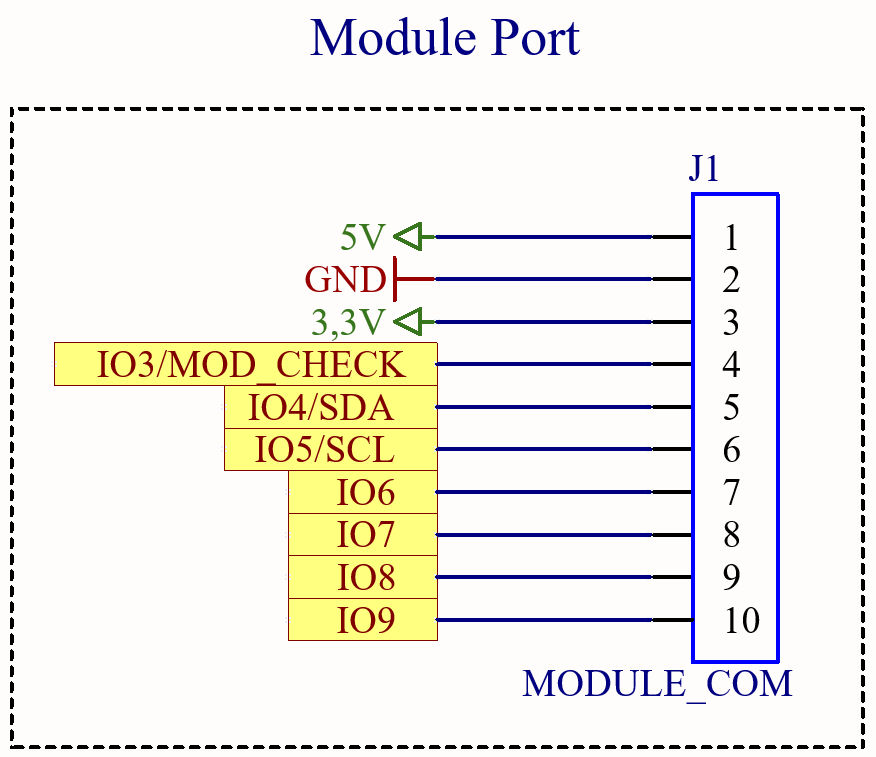
[picture p75: Diplomarbeit/assets/HW/Motion-Module-Port.png]
                
                \caption{Module-Connector implemented in the schematic.}
            \end{figure}

        \subsubsection{Module Detection}
            A 22kOhm resistor is connected to pin 3 to set the voltage divider.

            \begin{figure}[htbp]
                \centering
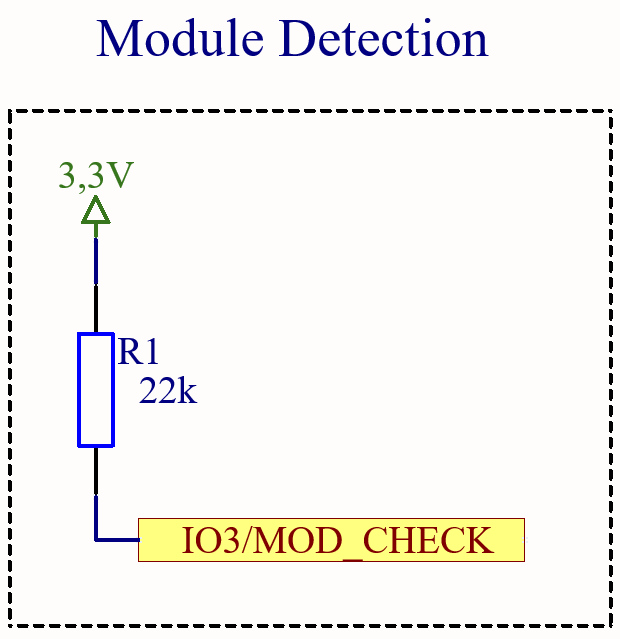
[picture p76: Diplomarbeit/assets/HW/Motion-Module-Check.png]
                
                \caption{Module detection implemented in the schematic.}
            \end{figure}

        \subsubsection{PCB - V1.1}    

            The PCB of the motion module is a 2-layer board with a size of 47,1x30mm. 
            The PCB is designed to be mounted on the base module. The PCB layout of the motion 
            module is shown in figure \ref{fig:motion-module-pcb-V1.1}.

            \begin{figure}[H]
                \centering
                
                \caption{PCB of the motion module V1.1. [Red - Frontside, Blue - Backside]}
                \label{fig:motion-module-pcb-V1.1}
            \end{figure}

    \subsection {Hardware - V1.0} 
            Version 1.0 of the motion module is identical to version 1.1, except for the resistor R2.
        
            \subsubsection{Module Detection}

            This version had a complete voltage divider with a 330k\(\Omega\) and 680k\(\Omega\)
            setting the voltage between the resistors to about 2.2V. 

            \begin{figure}[H]
                \centering
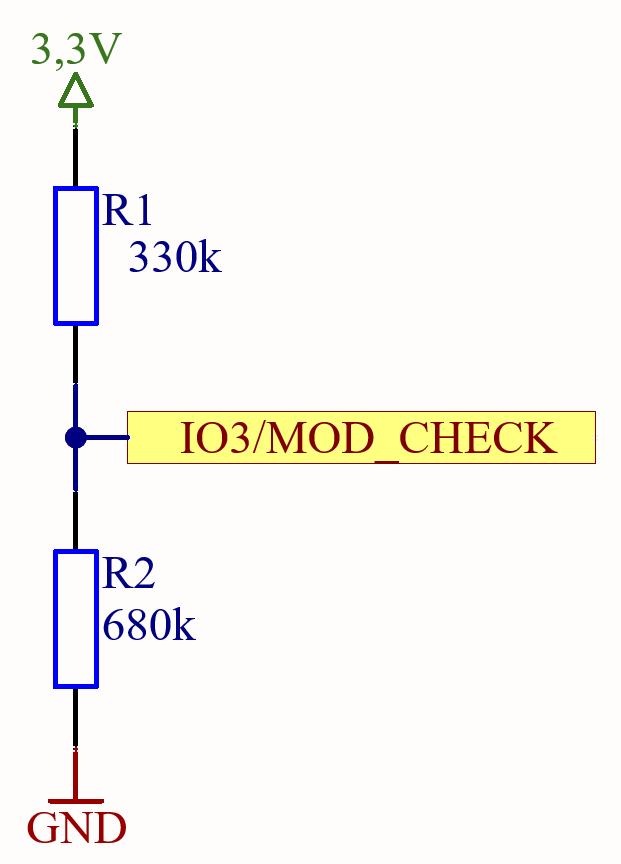
[picture p77: Diplomarbeit/assets/HW/MotionV1.0-Module-Detection.png]
                
                \caption{Module detection implemented in the schematic.}
                \label{fig:motion-module-check-V1.0}
            \end{figure}

            In V1.1 the resisitor R2 was removed from the motion module and one was added to the base module. 
            The reason for this change is to prevent the GPIO pin on the base module from floating. 
            The PCB layout of the motion module is shown in the following page.

            \subsubsection{PCB - V1.0}    

            The PCB of this version is identical with V1.1. The only difference is, that there 
            is a footprint for the resistor R2 on the top side of the PCB.

            \begin{figure}[H]
                \centering
                
                \caption{PCB of the motion module V1.0. [Red - Frontside, Blue - Backside]}
                \label{fig:motion-module-pcb-V1.0}
            \end{figure}
