SeriousHarlequin/FaRiSmarthome/Diplomarbeit/topics/time.tex

\renewcommand*\chapterpagestyle{scrheadings}
\chapter{Time Tracking}
\section{Fabian Schätzschock}
\addtimeentry{36}{Preparation}{12} % Spent 12 hours in calendar week 36 on preparation
\addtimeentry{47}{ESP-NOW}{8}

\addtimeentry{2}{FaRiLib Development}{20} 
\addtimeentry{4}{Started on Thesis}{20}
\addtimeentry{5}{Expanding Thesis}{5}
\addtimeentry{5}{ESP-NOW}{8} % Spent 12 hours in calendar week 14 on polishing
\addtimeentry{8}{UDP Broadcast}{18}
\addtimeentry{9}{ESP-NOW Discovery}{21}
\addtimeentry{10}{Node-Implementation and Documentation}{16}
\addtimeentry{11}{Restructured Codebase}{19}
\addtimeentry{12}{Server-Implementation}{21}
\addtimeentry{13}{Server-Implementation}{20}
\addtimeentry{14}{Wrote Thesis}{14}

\printtimeentries
\newpage

\section{Richard Krammer}
\addtimeentryHW{36}{Designed schematic NodeV1}{4}
\addtimeentryHW{37}{Designed PCB NodeV1 \& schematic BatteryV1}{8}
\addtimeentryHW{38}{Finished schematic and PCB BatteryV1}{3}
\addtimeentryHW{40}{Assembled \& tested NodeV1 \& BatteryV1}{4} 
\addtimeentryHW{41}{Parts selection \& drawing schematic Node}{4}
\addtimeentryHW{43}{Designed NodeV2 PCB}{4}
\addtimeentryHW{44}{Designed schematic BatteryV2/SwitchV1; revised NodeV2 to V2.1}{11}
\addtimeentryHW{46}{Designed schematic \& PCB of SwitchV1; revised BatteryV2 to V2.1}{6}
\addtimeentryHW{47}{Assembled \& tested NodeV2.1; designed schematic \& PCB Motion V1}{8}
\addtimeentryHW{50}{SwitchV1 assembled \& tested}{4}
\addtimeentryHW{51}{BatteryV2.1 \& MotionV1 assembled and tested}{8}

\addtimeentryHW{1}{Fixed issues on Node, Battery, Switch, Motion}{6} 
\addtimeentryHW{4}{Designed case for NodeV2.x}{4}
\addtimeentryHW{5}{Assembled \& tested NodeV2.2 \& BatteryV2.2}{5} 
\addtimeentryHW{6}{Redesigned case for Node, tested module compatibility}{5}
\addtimeentryHW{7}{Wrote Thesis}{5}
\addtimeentryHW{8}{Assembled \& tested SwitchV1.1, wrote Thesis}{5}
\addtimeentryHW{9}{Wrote Thesis}{3} 
\addtimeentryHW{10}{Designed case for Motion \& Battery; assembled BatteryV2.2}{8} 
\addtimeentryHW{11}{Designed case for switch; wrote thesis}{8} 
\addtimeentryHW{12}{Wrote Thesis}{9} 
\addtimeentryHW{13}{Modules installed in the housing; wrote Thesis}{19} 
\addtimeentryHW{14}{Wrote Thesis}{15} 

\printtimeentriesHW
