SeriousHarlequin/FaRiSmarthome/Diplomarbeit/topics/Modules.tex

\chapter{Modules}

\input{Modules-Base}
\input{Modules-Bridge}
\input{Modules-Motion}
\input{Modules-Battery}
\input{Modules-Switch}
\input{Case}
