SeriousHarlequin/FaRiSmarthome/Diplomarbeit/topics/Nodes-ProjectConfiguration.tex

\section{Project Configuration}

    \subsection{platformio.ini}
    Every project in PlatformIO requires a \texttt{platformio.ini} file. This file
    contains all the necessary information for the build process. Its content may
    vary depending on the project, but for this Smart Home System, the following
    configuration stays consistent:

    \begin{minted}{cpp}
[env:<BOARDNAME>]
    platform = espressif32
    board = <BOARDNAME>
    framework = arduino
    \end{minted}
    
    The \texttt{<BOARDNAME>} should be replaced with the name of the board used
    for the Node, for example, \texttt{esp32-s3-devkitm-1} for the ESP32-S3 or
    \texttt{esp32c3-devkitm-1} for the ESP32-C3.

        \subsubsection{platform}
        The \texttt{platform} key specifies the platform to build for. Due to the
        fact that the networking is dependent on ESP-NOW, this will most likely be
        \texttt{espressif32} or \texttt{espressif8266} depending on the 
        microcontroller.
        
        \subsubsection{framework}
        The \texttt{framework} key specifies the framework to use. All, for this 
        thesis developed nodes, are based on the Arduino framework, however, other
        frameworks for the ESP32 are available, such as ESP-IoT-Development-Framework
        (ESP-IDF for short) maintained by Espressif and designed exclusively for the 
        ESP32.
        
        Other \textbf{more specific 
        configurations} that are necessary will be discussed in the \textbf{following 
        sections}.

    \subsection{Enabling the Serial Monitor}
    While reading the serial monitor is not necessary for functionality, it is a
    useful tool for debugging. For older ESP32 boards no additional configuration 
    should be necessary, newer boards however, such as the \texttt{ESP32-S3} and the 
    \texttt{ESP32-C3}, require the following \texttt{build\_flags}: 
    
    \begin{minted}{cpp}
build_flags =
    -DARDUINO_USB_MODE=1
    -DARDUINO_USB_CDC_ON_BOOT=1
    \end{minted}
    After that, the monitor speed can be set as well:
    \begin{minted}{cpp}
    monitor_speed = 9600
    \end{minted}
    The baud rate can be adjusted to any desired value as long as the clock rate
    of the board supports it, but note that it should match the baud rate set in 
    the code. Common values are 115200 or 9600 on older boards.

    \subsection{Including FaRiLib} \label{sec:farilib_include}
    Due to the fact that the FaRiLib library should be used across all nodes, it is
    placed inside the \texttt{SW-ESP} directory and included in all node-projects.
    To add the directory to the include path, the following lines should be added to
    the \texttt{platformio.ini} file:
    \begin{minted}{cpp}
lib_extra_dirs =
    ../globalLibs
    \end{minted}
    Note that the path is relative, meaning it needs to be adjusted should the project
    be places outside the \texttt{SW-ESP} directory.

    \subsection{Complete Example}
    A complete example of a \texttt{platformio.ini} file for a slave project
    using the ESP32-C3 would look like this:

    \begin{minted}{vim}
[env:esp32-c3-devkitm-1]
platform = espressif32
board = esp32-c3-devkitm-1
framework = arduino

build_flags =
   -DARDUINO_USB_MODE=1
   -DARDUINO_USB_CDC_ON_BOOT=1

lib_deps = 
   fastled/FastLED@^3.9.5
   milesburton/DallasTemperature@^3.11.0

lib_extra_dirs =
   ../globalLibs
   \end{minted}
