SeriousHarlequin/FaRiSmarthome/Diplomarbeit/topics/Server.tex

\chapter{Server} \setAuthor{Fabian Schätzschock} \label{sec:raspberry_pi}
This chapter discusses the software side of the Raspberry Pi Server,
including the chosen software and operating system, as well 
as the implementation of the web server and the option of running the
services containerized on different operating systems.
    
\input{Server-OperatingSystem}
\input{Server-WebServer}
\input{Server-UDP}
\input{Server-Replication}
