SeriousHarlequin/FaRiSmarthome/Diplomarbeit/topics/Modules-Switch.tex

\section{Switch Module} \setAuthor{Richard Krammer}

\input{topics-hw/Switch-V1.tex}
