SeriousHarlequin/FaRiSmarthome/Diplomarbeit/topics/bibliography.tex

\renewcommand*\chapterpagestyle{scrheadings}
\printbibliography[heading=bibintoc]
\listoffigures
\addcontentsline{toc}{chapter}{\listfigurename}
