SeriousHarlequin/FaRiSmarthome/Labor-Project/docs/topics/software.tex

\chapter{Software}

    \section{Projektstruktur}
    Die Projektstruktur orientiert sich an PlatformIO: \\
    \(\rightarrow\) Command: \texttt{tree -L 2} \\
    \vspace{0.5cm}
    \begin{minipage}{0.48\linewidth}
            \centering
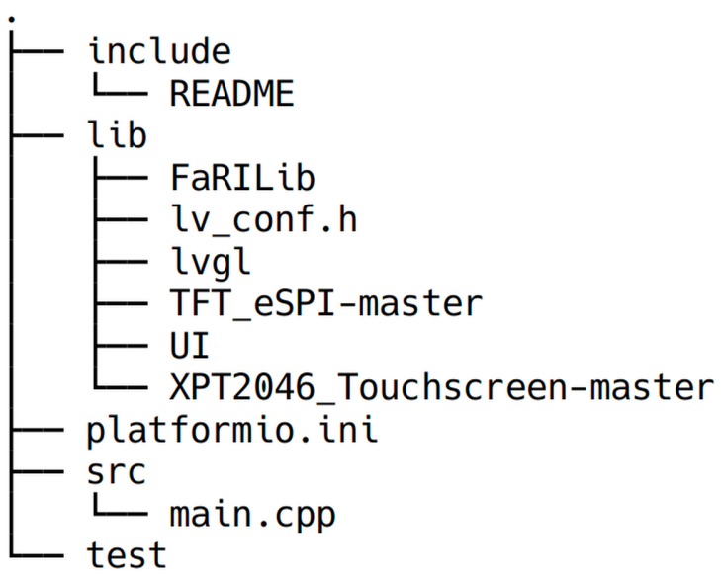
[picture p84: Labor-Project/docs/assets/projDir.png]
            
            \label{fig:projDir}
    \end{minipage}
    \hfill
    \begin{minipage}{0.48\linewidth}
        \raggedright
        \begin{itemize}
            \item custom Libraries werden im \lstinline{lib/} 
            Verzeichnis abgelegt
            \item Libery-unabhängige Header-Dateien 
            werden im \lstinline{include/} Verzeichnis abgelegt
            \item Libery-unabhängige Source-Dateien 
            werden im \lstinline{src/} Verzeichnis abgelegt
        \end{itemize}
    \end{minipage}
    \vspace{0.5cm}

    Während Libraries, die speziell für das Projekt entwickelt oder abgeändert wurden,
    im \lstinline{lib/} Verzeichnis abgelegt werden, werden Libraries,
    die von PlatformIO bereitgestellt werden, automatisch heruntergeladen
    und im verstecktem \lstinline{.pio/} Verzeichnis abgelegt. Diese sind im
    \lstinline{platformio.ini} File spezifiziert.

    \section{FaRiLib}
    Die Libary soll als Grundgerüst für die Implementierung aller Smarthome-Geräte
    dienen. Daher ist der modulübergreifende Teil der geschriebenen Funktionen Teil der 
    \textit{FaRiLib} Library. Diese Funktionen werden nach Kategorien in verschiedene
    Dateien aufgeteilt (Zum Beispiel: \lstinline{FaRiLib/src/ESP-NOW.cpp}). 
    Die selbe Gliederung gilt für die dazugehörigen Header-Dateien 
    (Zum Beispiel: 
    \lstinline{FaRiLib/include/ESP-NOW.h}).

    \section{ESP32-S3 Konfiguration}
    Die Eigenschaften des ESP32-S3 werden in dem \lstinline{platformio.ini}
    File konfiguriert. Als Basis der Konfiguration dient
    das \lstinline{esp32-s3-devkitc-1.json} File, welches die
    Basiskonfiguration für ein ESP32-S3 Devkit bereitstellt
    und standardmäßig von PlatformIO verfügbar ist. \par
    
    Nun müssen folgende Flags im \textit{platformio.ini} File
    überschrieben werden:

    \begin{lstlisting}[style=cppCode]
    board_upload.flash_size = 16MB
    board_build.partitions = default_16MB.csv
    \end{lstlisting}

    Nun sollte der Upload eines Programms auf den 
    ESP-Chip möglich sein.

        \subsection{Serielle Kommunikation}
        Für Entwicklungszwecke ist es sinnvoll, die 
        serielle Kommunikation zu aktivieren. Hierfür
        muss, mithilfe spezieller \texttt{build\_flags}
        im \texttt{platformio.ini}, die serielle Kommunikation über die USB-Schnittstelle
        aktiviert werden:

        \begin{lstlisting}[style=cppCode]
    build_flags =
        -DARDUINO_USB_MODE=0
        -DARDUINO_USB_CDC_ON_BOOT=1
        \end{lstlisting}

            \subsubsection{Problematik}
            Obwohl die serielle Kommunikation aktiviert ist,
            funktioniert die Kommunikation nicht auf jedem
            ESP32-S3. Da PlatformIO's offizielle 
            Dokumentation \cite{PlatformIO_build_flags}
            unzureichende Informationen bereitstellt und
            Debugging auch über das angeschlossene Display
            möglich ist, wurde die serielle Kommunikation
            nicht weiter verfolgt.

    \input{software_UserInterface}
    \input{software_kommunikation}
    \newpage
    \input{software_rtos}
