SeriousHarlequin/FaRiSmarthome/Labor-Project/docs/topics/bibliography.tex

% \renewcommand*\chapterpagestyle{scrheadings}
\printbibliography[heading=bibintoc]
