SeriousHarlequin/FaRiSmarthome/Diplomarbeit/main.tex

\documentclass[paper=a4, 12pt, openany]{scrbook}
\usepackage{rdp}
\usepackage[scale=0.72, twoside, bindingoffset]{geometry}

\school{HTBLuVA St. Pölten}
\department{Higher Institute for Electronics and Technical Informatics}
\subdepartment{Specializations in Embedded and Wireless Systems}
\session{2024/25}
\title{Modular Smart Home System}
\note{Licensed under GPLv3.0}
\subtitle{free and open source}
\supervisor{Ing. Reinhard Rzepa}
\supervisor{Ing. Rudolf Janeczek BEd MSc}
\candidate{Fabian Schätzschock}{Low-level software development, server-side front-end and back-end development}
\candidate{Richard Krammer}{Component selection, circuit design, and hardware development}
\place{St. Pölten}
\handindate{04.04.2025}

\begin{document}
\frontmatter
\KOMAoptions{headsepline=off}
    \maketitle
    \affidavit
    \includepdf[pages=-, pagecommand={}]{topics/template/Diplomarbeitsvorlage_V4.pdf}
    \KOMAoptions{headsepline=.5pt} 
    \tableofcontents
    
\mainmatter 
    \pagestyle{scrheadings}
    \include{acknowledgement}
    \include{introduction}
    
    \input{summary}
    \input{requirements}
    \input{Networking}
    \input{Nodes}
    \input{Modules}
    \input{Server}
    
    \include{results}
    \include{time}
    \input{topics-hw/production-files.tex}
    \include{protocols}
    \include{bibliography}

\end{document}
