SeriousHarlequin/FaRiSmarthome/Labor-Project/docs/main.tex

\documentclass[paper=a4, 12pt,oneside]{scrbook}
\usepackage{rdp}
\usepackage[scale=0.72, twoside, bindingoffset]{geometry}
\usepackage{graphicx}
\usepackage{pdfpages}

\school{HTBLuVA St. Pölten}
\department{Lehranstalt für Elektronik und technische Informatik}
\subdepartment{Spezialisierung in Embedded and Wireless Systems}
\session{2025/26}
\title{Smart Home Controlpanel}
\note{Licensed under ___}
\subtitle{}
\supervisor{Martin Walter}
\supervisor{}
\candidate{Fabian Schätzschock}{Task 1}
\candidate{Richard Krammer}{Task 2}
\place{St. Pölten}
\handindate{04.04.2025}

\begin{document}
    \frontmatter
    \maketitle

    \tableofcontents

    \mainmatter
    \include{introduction}

    % \input{summary}

    \input{einfuehrung}

    \input{anforderungen} 
    \input{software}
    \input{hardware}

    \input{Ergebnisse}

    \appendix
    \include{bibliography}

\end{document}
