SeriousHarlequin/FaRiSmarthome/Diplomarbeit/topics/summary.tex

\chapter{Executive Summary}
This page serves as a brief overview of the Modular Smart Home System project.
It provides a summary of the project's goals, objectives, and key features.

\section{Project Overview}
The Modular Smart Home System project aims to develop an open-source, 
all-in-one smart home solution with a modular design. This system 
allows users to easily modify and extend its functionalities via 
extension slots to suit their specific needs.

\section{Objectives}
The primary objectives of this project are:
\begin{itemize}
    \item To create a user-friendly smart home system that integrates self-made home automation devices.
    \item To ensure the system is modular, allowing for easy customization and expansion. 
    \item Modules can be added or removed  on the fly without having to adjust code.
    \item To provide comprehensive documentation and support for users and developers.
\end{itemize}

\section{Key Features}
The key features of the Modular Smart Home System include:
\begin{itemize}
    \item A frontend interface for monitoring and controlling the smart home system.
    \item Easily changeable modules that changes the Nodes functionality.
    \item An easily understandable and extendable codebase.
\end{itemize}

\section{Conclusion}
The Modular Smart Home System project aims to deliver a versatile 
and customizable smart home solution that meets the needs of a wide 
range of users. By focusing on modularity and ease of use, the project 
seeks to empower users to create their ideal smart home environment.
