SeriousHarlequin/FaRiSmarthome/Diplomarbeit/topics/Nodes-FaRiLib.tex

\section{FaRiLib} \label{sec:farilib}
To share common functionality across all nodes, a library called FaRiLib was
created. Its goal is to provide a common interface for all nodes to use, such as
a common way to handle incoming messages and to send messages to the bridge node. 
\par\vspace{0.5em}
It's placed in the \texttt{SW-ESP/globalLibs} directory and should be included in
every node project placed in the \texttt{SW-ESP} directory.

    \subsection{Library Structure}
        \begin{minipage}{0.48\textwidth}
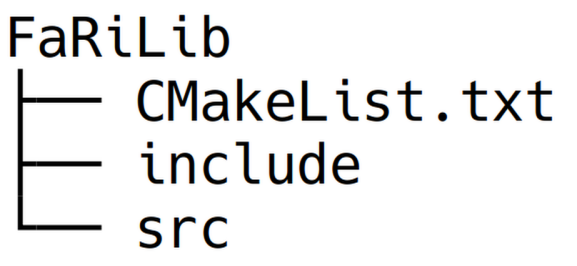
[picture p146: Diplomarbeit/assets/FaRiLibStructure.png]
            
            \label{fig:farilib_structure}
        \end{minipage}%
        \begin{minipage}{0.48\textwidth}
            \raggedright
            \begin{itemize}
                \item \textbf{CMakeLists.txt}: The CMake configuration file for the 
                library.
                \item \textbf{src/}: The source files of the library.
                \item \textbf{include/}: The header files of the library.
            \end{itemize}
        \end{minipage}
        \subsubsection{CMakeLists.txt}
        For the inclusion to work properly, a \texttt{CMakeLists.txt} file is
        necessary. It should contain the following lines: 
    \begin{minted}{cmake}
project(FaRiLib)

include_directories(include)

set(SOURCE_FILES
    src/*
)
    \end{minted}
    % \captionof{listing}{CMakeLists.txt Configuration for FaRiLib}

        In combination with the configuration done in section \ref{sec:farilib_include},
        this enables an include statement as simple as \texttt{\#include <FaRiLib.h>} in all
        node projects.

    \subsection{ESP NOW} \label{sec:farilib_espnow}
    The library provides a wrapper around the necessary ESP-NOW functionality.
    Functionally it is split into two header files, \texttt{espnowMaster.h} and 
    \texttt{espnowSlave.h}. The master node is the bridge node, while the slave
    nodes are the nodes that send data to the bridge node. 
        
        \subsubsection{ESP-NOW Objects}
        The aforementioned header files contain the \texttt{EspNowMaster} and the
        \texttt{EspNowSlave} classes. They both inherit from the abstract 
        \texttt{EspNow} class, which contains common functionality of both.
        \begin{figure}[H]
            \centering
            
            \caption{ESP-NOW Object Inheritance}
        \end{figure}
        
    \subsection{HTTP} \label{sec:farilib_http}
    There is also a template for the HTTP communication and 
    UDP-Discovery Process. To initialize the full HTTP functionality,
    the following functions need to be called inside the \texttt{Setup()}
    function of the bridge-node:

    \needspace{11\baselineskip}
    \begin{minted}{cpp}
#include "udpBroadcast.h"
#include "WebServer.h"

void setup() {

    ethernetInit();
    initWebServer(&server);
    createTasks();
    //...
}
    \end{minted}

    This initializes the Ethernet connection, the Webserver, and starts
    a task that periodically sends UDP broadcasts until the task is 
    suspended.
