SeriousHarlequin/FaRiSmarthome/Labor-Project/docs/topics/einfuehrung.tex

\chapter{Einführung}

Das Control-Panel soll als Erweiterung eines Smarthomes dienen, also
mit einem bereits aufgebauten System verbunden werden und in der Lage sein, 
über die im Smarthome bereits integrierte ESP-NOW Schnittstelle mit 
integrierten Geräten zu kommunizieren und den Status dieser Geräte 
abzufragen und anzupassen.

    \section{Motivation}
    Der Sinn des Control-Panels ist es, die Bedienung des Smarthomes zu vereinfachen.
    Es soll eine Anlaufstelle für die Steuerung des Smarthomes sein, die kein
    herkömmliches Heimnetzwerk benötigt, sondern direkt mit den Geräten kommuniziert.
    Des Weiteren muss so kein Browser oder App geöffnet werden, um das Smarthome zu 
    steuern.

    \section{Hardware}
    Das Control-Panel soll klein genug sein, um auf einem Schreibtisch zu stehen
    und über ein reguläres Handyladegerät versorgt werden. Die Technik 
    soll in einem 3D-gedruckten Gehäuse verbaut sein, in dem nur das Display und
    die Bedienelemente sichtbar sind. 

    \newpage
    \section{Das Smarthome}
    Das Smarthome, mit dem das Control-Panel kommuniziert, ist ein bereits 
    bestehendes System, das als Diplomarbeit derselben Autoren entwickelt wurde.
    Es besteht aus mehreren ESP32-Mikrocontrollern, die über ein ESP-NOW-Netzwerk
    miteinander kommunizieren. Die Geräte sind in der Lage, verschiedene 
    Sensor-Daten zu erfassen, sowie Aktoren zu steuern. Als Alternative zum
    Control-Panel kann das Smarthome auch über eine Web-Oberfläche gesteuert werden.
    \\~\\
    Die Kommunikation des Systems kann wie folgt visualisiert werden: 
    \begin{figure}[htbp]
        \centering
        
        \caption{Das Smarthome}
        \label{fig:smarthome}
    \end{figure}

    Das Control-Panel wird als Node in diesem Netzwerk fungieren.
