SeriousHarlequin/FaRiSmarthome/Diplomarbeit/topics-hw/Battery-V1.tex

\subsection{Hardware - V1.0}

This version of the battery module is working completely different from the later versions. 
It was intended to be a rough prototype for the base module V1.0 \& V1.1 
(see section \ref{sec:basic_module}) to test the 
concept of a pluggable battery module. The battery module is used to power the basic node,
without the need to connect a USB-C cable.

    \subsubsection{Module-Connector}
        The battery module is connected to the following voltages:

        \begin{itemize}
            \item 1. 3V3 - The battery module powers the basic node over this pin
            \item 2. VBUS - used to charge and disable the battery module when USB is connected
            \item 3. $V\_BAT$ - used to monitor the battery voltage
            \item 4. EN-MODUL - Used to disable the linear voltage regulator on the basic node
            \item 5. GND - Ground
        \end{itemize}

        \begin{figure}[H]
            \centering
            
            \caption{Battery implemented in the schematic.}
        \end{figure}
        
        With the voltages the basic node is powered, and the battery is charged.

    \subsubsection{DC-DC-Converter}

        A buck-boost converter is used to convert the 3-4.2V from the battery to 3.3V to power the
        basic module. The used IC is the TPS63000 from Texas Instruments it is a high efficiency
        buck-boost converter with a efficiency of up to 96\%. The inductor and the output voltage were
        calculated like stated in the datasheet\cite{noauthor_tps6300x_2015}. The inductor was selected 
        after calculating the maximum inductor current:

        \begin{equation}
            D = \frac{V_{OUT} - V_{IN} }{V_{VOUT}} = \frac{3.3V - 3.0V}{3.3V} = 0.0909
        \end{equation}

        \begin{equation}
            I_{PEAK} = \frac{I_{OUT}}{\eta \cdot (1 - D)} + \frac{V_{IN} \cdot D}{2 \cdot f \cdot L} 
        \end{equation}

        Where D is the duty cycle, \(I_{OUT}\) is the output current set to 0.8A, \(\eta\)
        is the efficiency(0.9 as assumption), \(V_{IN}\) is the lowest input voltage set to 3V,
        \(f\) is the switching frequency set to 2.5MHz and \(L\) is the inductor value set to 2.2\(\mu\)H.

        \begin{equation}
            I_{PEAK} = \frac{0.8A}{0.9 \cdot (1 - 0.0909)} + \frac{3V \cdot 0.0909}{2 \cdot 2.5MHz \cdot 2.2\mu H} 
            = 1.0025A \approx \textbf{1A} 
        \end{equation}

        \vspace{1cm}

        The output voltage was set with a resistor divider to 3.3V:

        \begin{equation}
            R1 = R_2 \cdot (\frac{V_{OUT}}{V_{FB}} - 1)
        \end{equation}

        Where \(V_{FB}\) is 500mV, $R_2$ is 200k\(\Omega\) and \(V_{OUT}\) is 3.3V.

        \begin{equation}
            R1 = 200k\Omega \cdot (\frac{3.3V}{0.5V} - 1) = 1120k\Omega \approx \textbf{$1M\Omega$}
        \end{equation}

         \begin{figure}[H]
            \centering
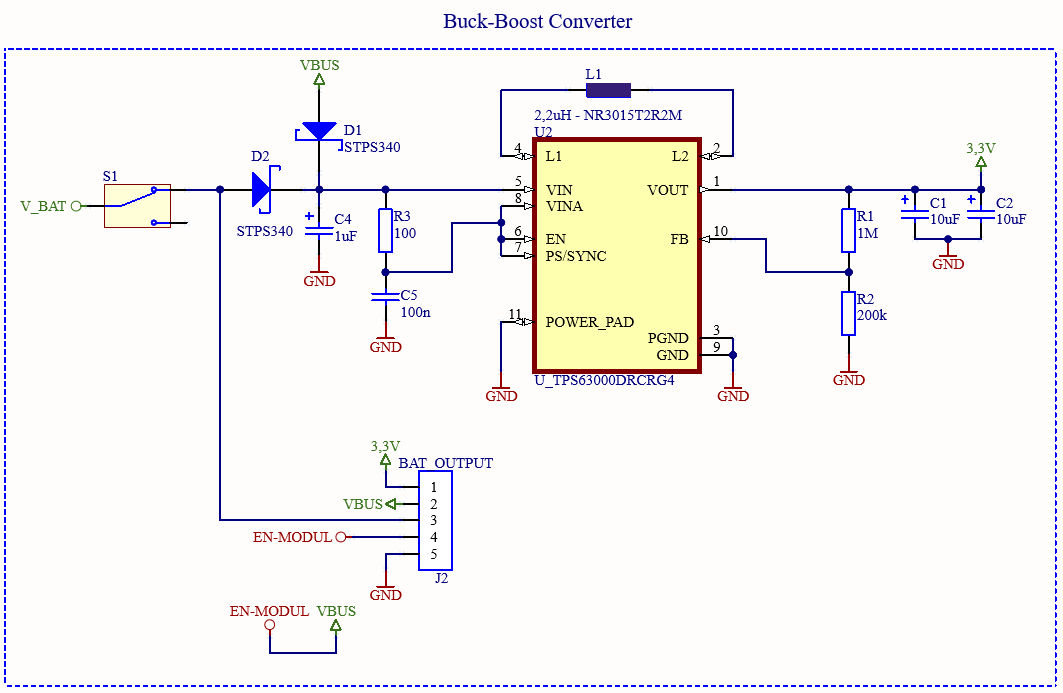
[picture p148: Diplomarbeit/assets/HW/BatteryV1.0-Buck-Boost.png]
            
            \caption{DC-DC-Converter implemented in the schematic.}
        \end{figure}

        There were problems with getting the TPS63000 to work properly. The output was not at the
        desired voltage of 3.3V. This issue was not investigated further, because it
        was decided to boost the voltage to 5V on the battery module and replace the
        linear regulator on the basic module with a buck converter to improve efficiency.
        Therefore, a buck-boost converter was not needed anymore in later versions of the battery module. 

    \subsubsection{PCB - V1.0}
        The PCB of the battery module is a 2-layer board with the same size as the basic module
        with 75x30mm. The print would be plugged into the basic module V1.1 from underneath.

        \begin{figure}[H]
            \centering
            
            \caption{PCB of the battery module V1.0. [Red - Frontside, Blue - Backside]}
            \label{fig:battery-module-pcb-V1.0}
        \end{figure}
