SeriousHarlequin/FaRiSmarthome/Diplomarbeit/assets/case/Battery-Side.jpg

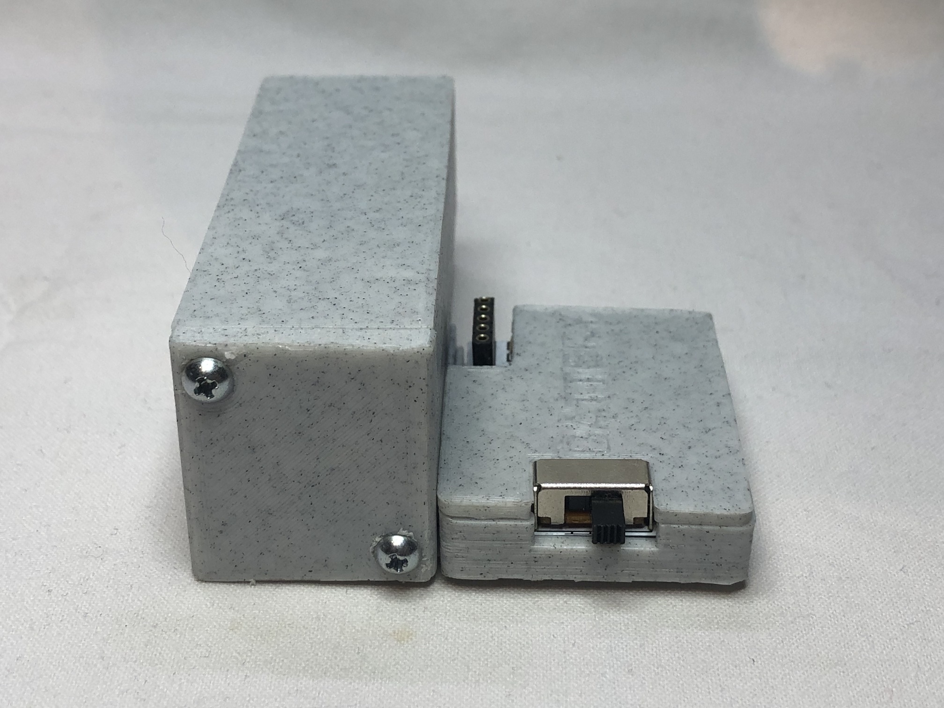
Diplomarbeit/assets/case/Battery-Side.jpg
