SeriousHarlequin/FaRiSmarthome/Diplomarbeit/assets/case/IMG_6238.jpg

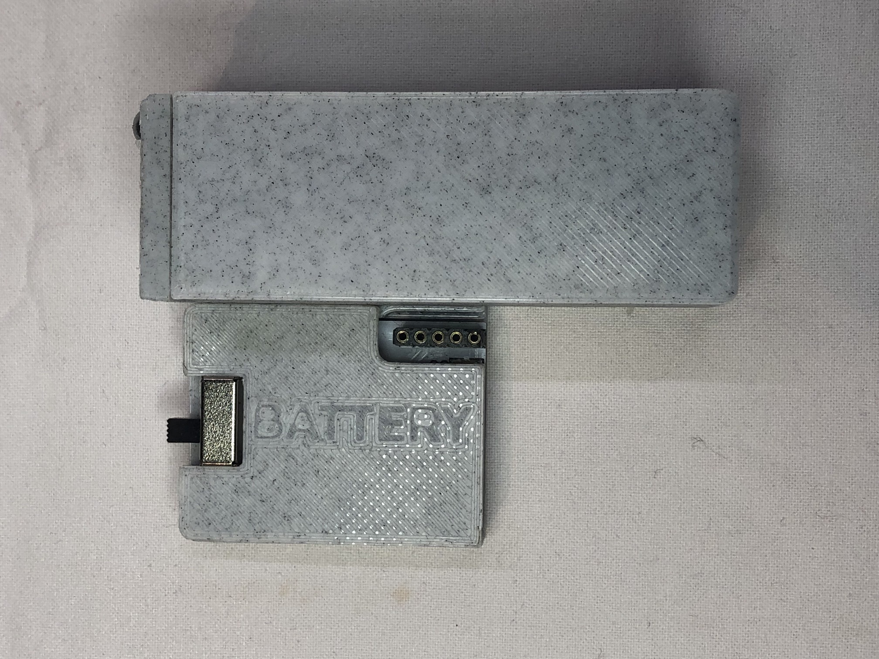
Diplomarbeit/assets/case/IMG_6238.jpg
