SeriousHarlequin/FaRiSmarthome/Diplomarbeit/assets/case/IMG_6240.jpg

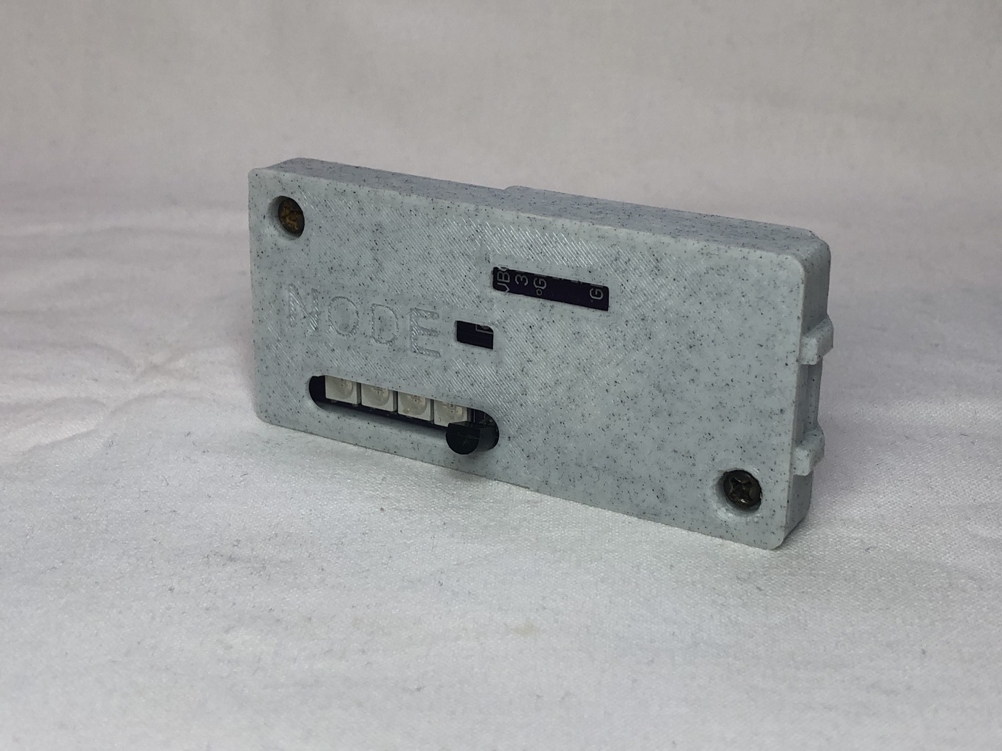
Diplomarbeit/assets/case/IMG_6240.jpg
