SeriousHarlequin/FaRiSmarthome/Diplomarbeit/assets/case/IMG_6241.jpg

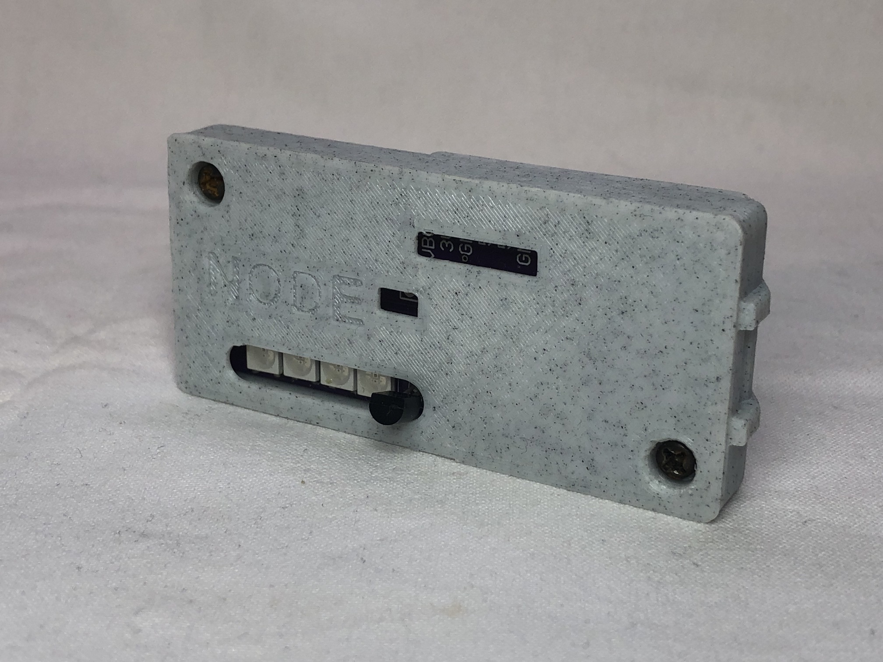
Diplomarbeit/assets/case/IMG_6241.jpg
