SeriousHarlequin/FaRiSmarthome/Diplomarbeit/assets/case/IMG_6242.jpg

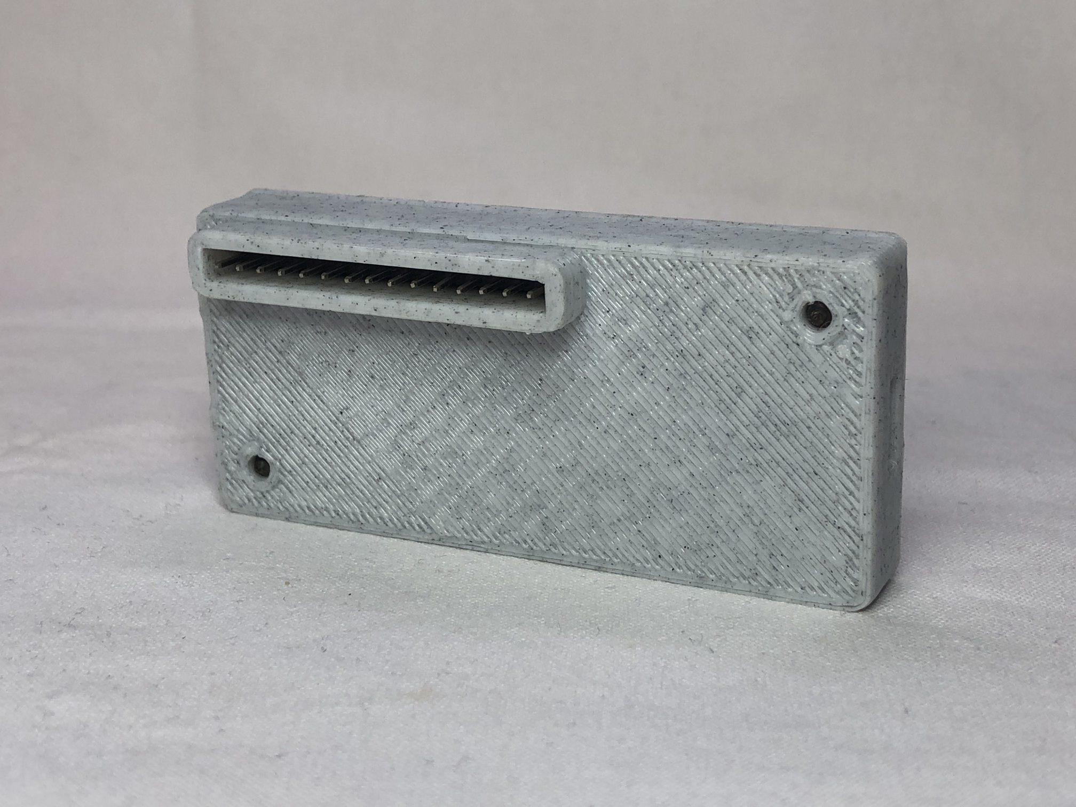
Diplomarbeit/assets/case/IMG_6242.jpg
