SeriousHarlequin/FaRiSmarthome/Diplomarbeit/assets/case/IMG_6247.jpg

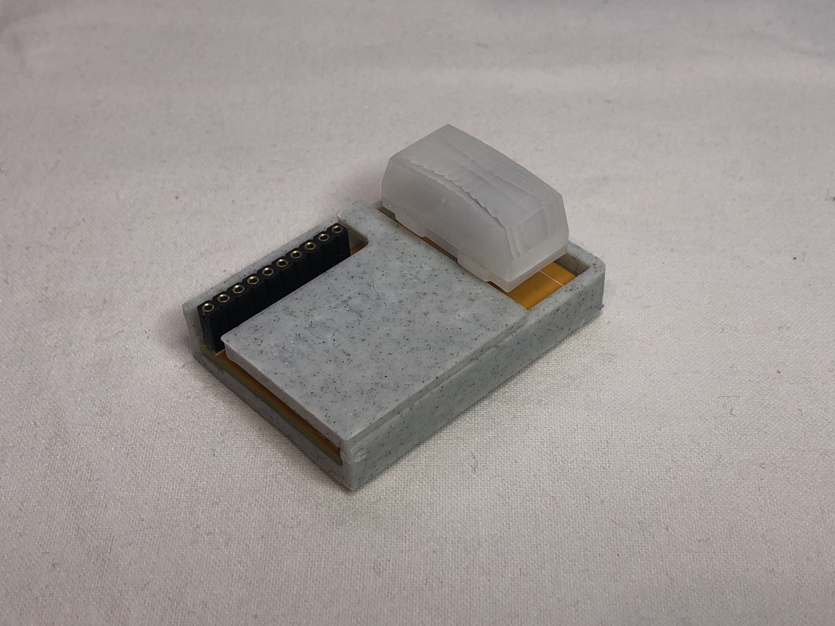
Diplomarbeit/assets/case/IMG_6247.jpg
