SeriousHarlequin/FaRiSmarthome/Diplomarbeit/assets/case/IMG_6248.jpg

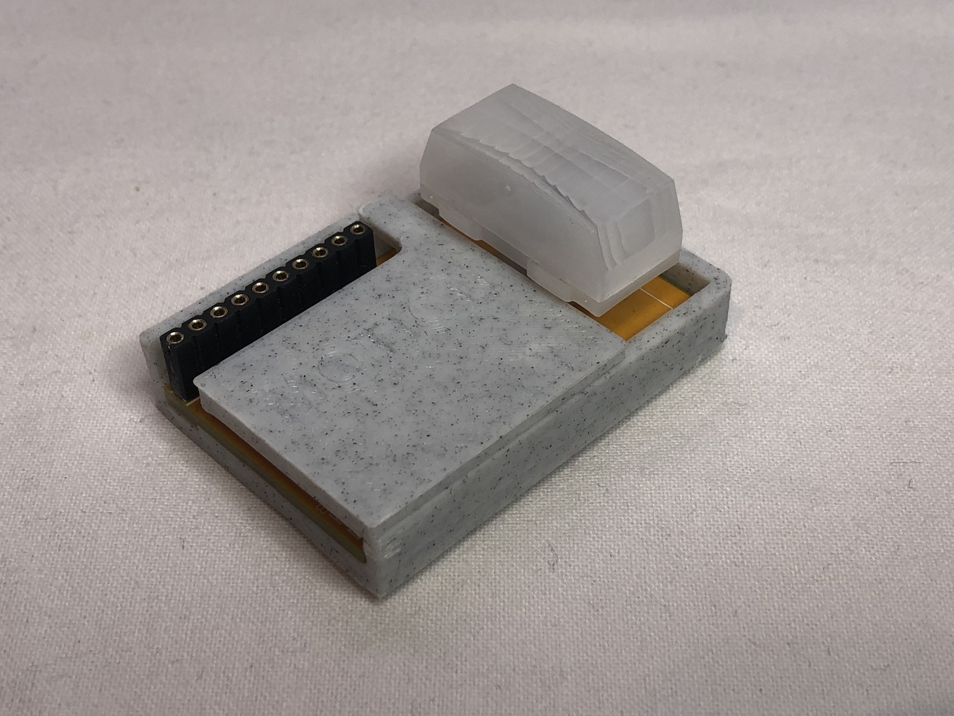
Diplomarbeit/assets/case/IMG_6248.jpg
