SeriousHarlequin/FaRiSmarthome/Diplomarbeit/assets/case/IMG_6257.jpg

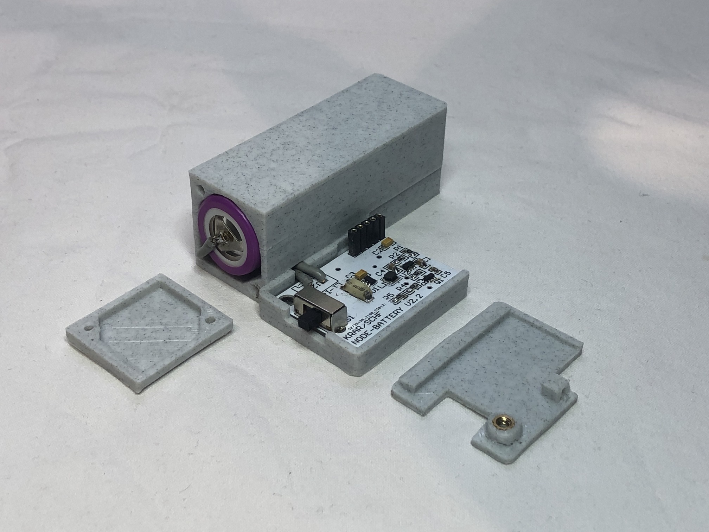
Diplomarbeit/assets/case/IMG_6257.jpg
