SeriousHarlequin/FaRiSmarthome/Diplomarbeit/assets/case/IMG_6259.jpg

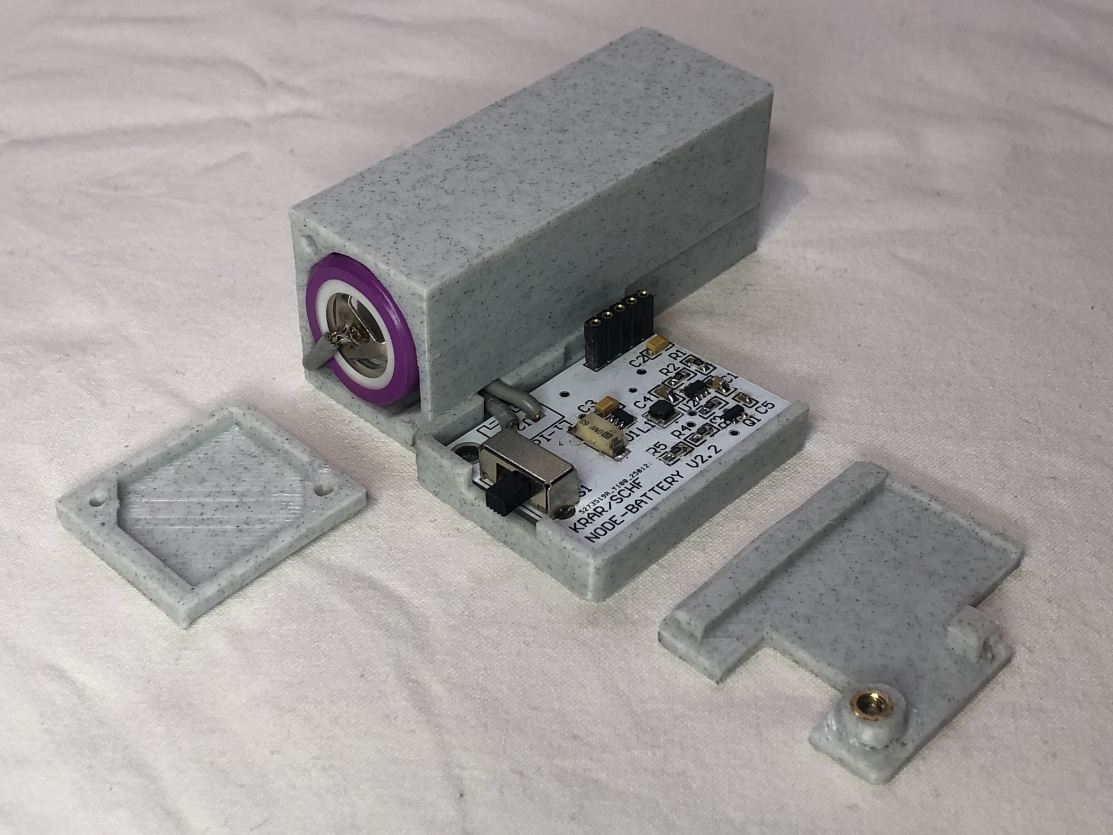
Diplomarbeit/assets/case/IMG_6259.jpg
