SeriousHarlequin/FaRiSmarthome/Diplomarbeit/assets/case/IMG_6262.jpg

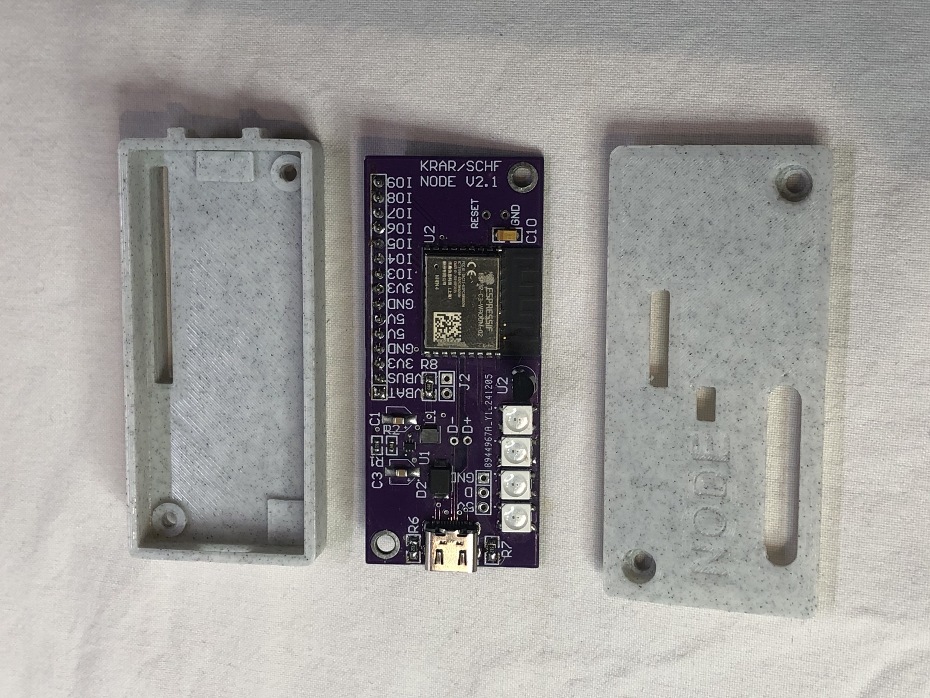
Diplomarbeit/assets/case/IMG_6262.jpg
