SeriousHarlequin/FaRiSmarthome/Diplomarbeit/assets/case/IMG_6263.jpg

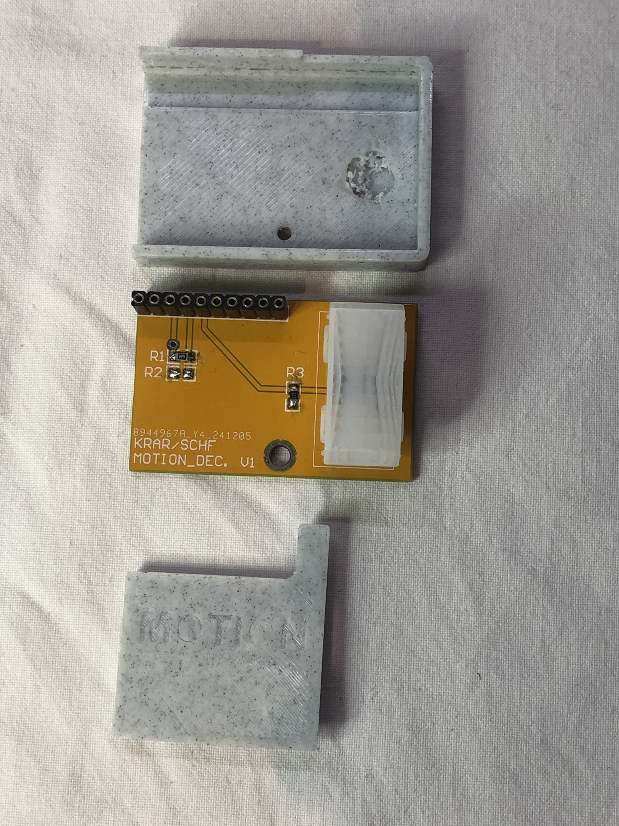
Diplomarbeit/assets/case/IMG_6263.jpg
