SeriousHarlequin/FaRiSmarthome/Diplomarbeit/assets/case/IMG_6264.jpg

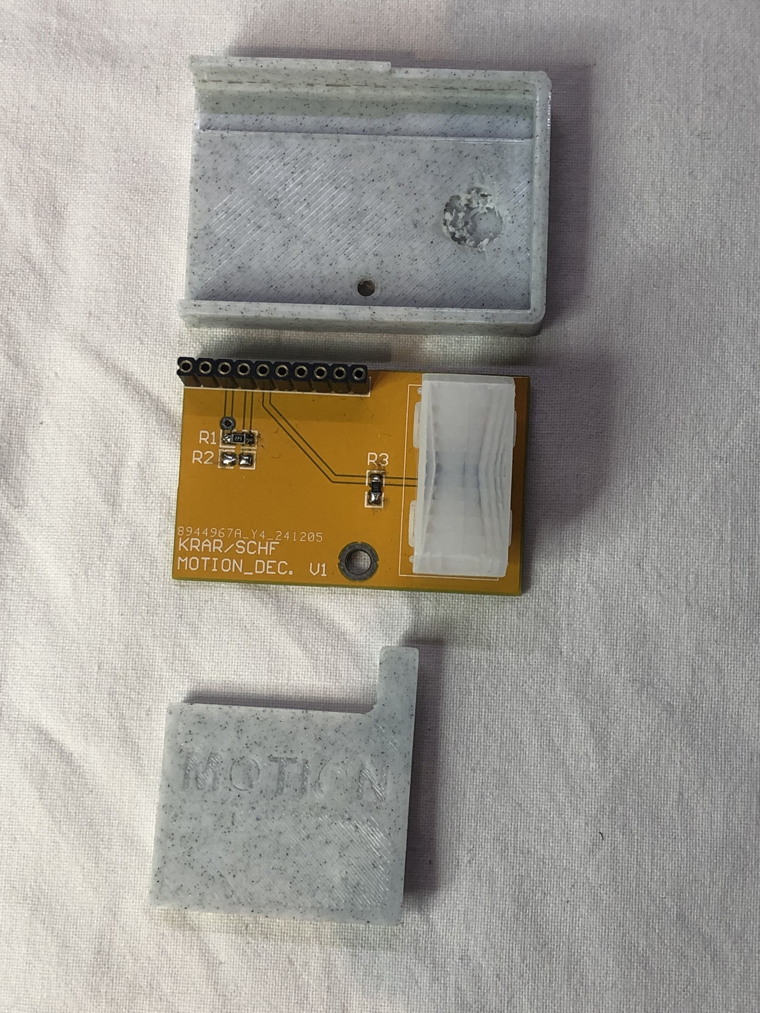
Diplomarbeit/assets/case/IMG_6264.jpg
