SeriousHarlequin/FaRiSmarthome/Diplomarbeit/assets/case/IMG_6265.jpg

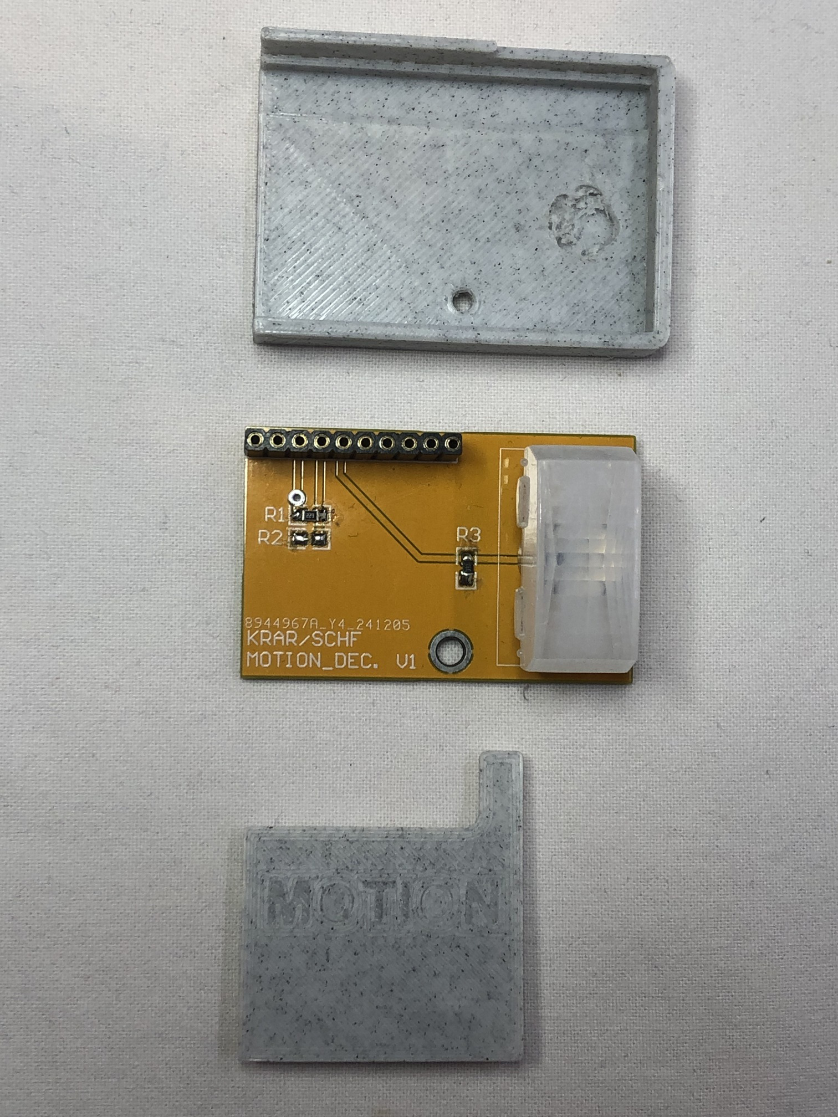
Diplomarbeit/assets/case/IMG_6265.jpg
