SeriousHarlequin/FaRiSmarthome/Diplomarbeit/assets/case/Motion-Front.jpg

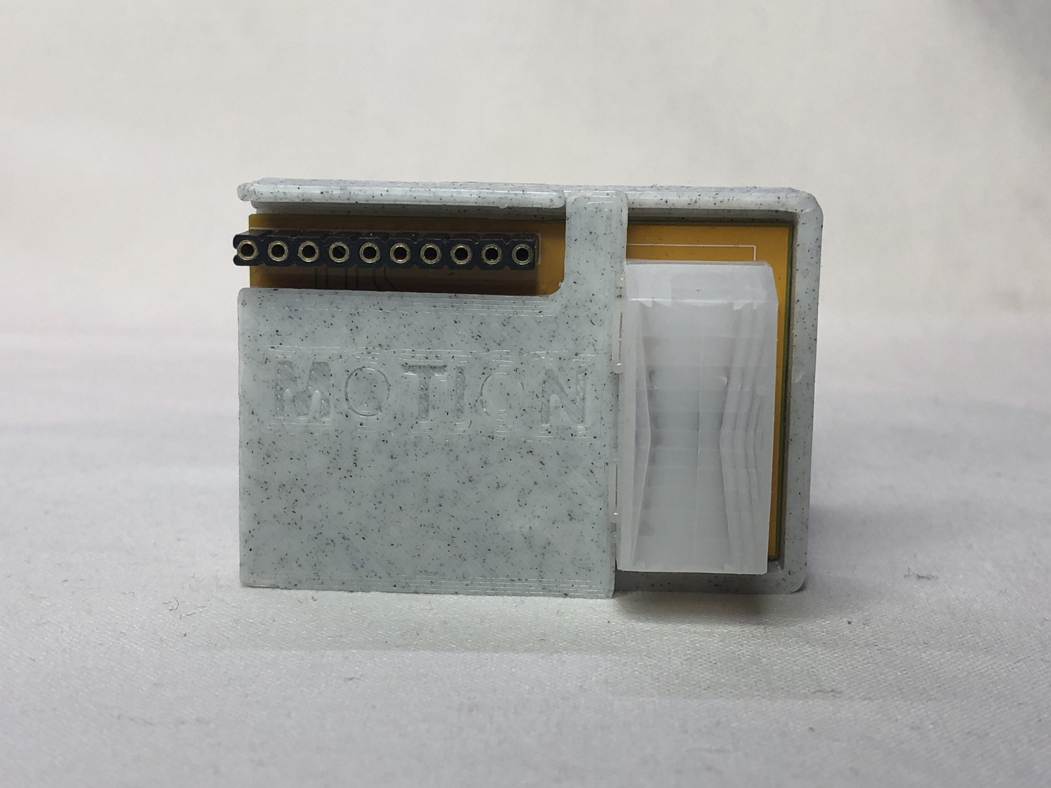
Diplomarbeit/assets/case/Motion-Front.jpg
