SeriousHarlequin/FaRiSmarthome/Diplomarbeit/assets/case/Motion-Side.jpg

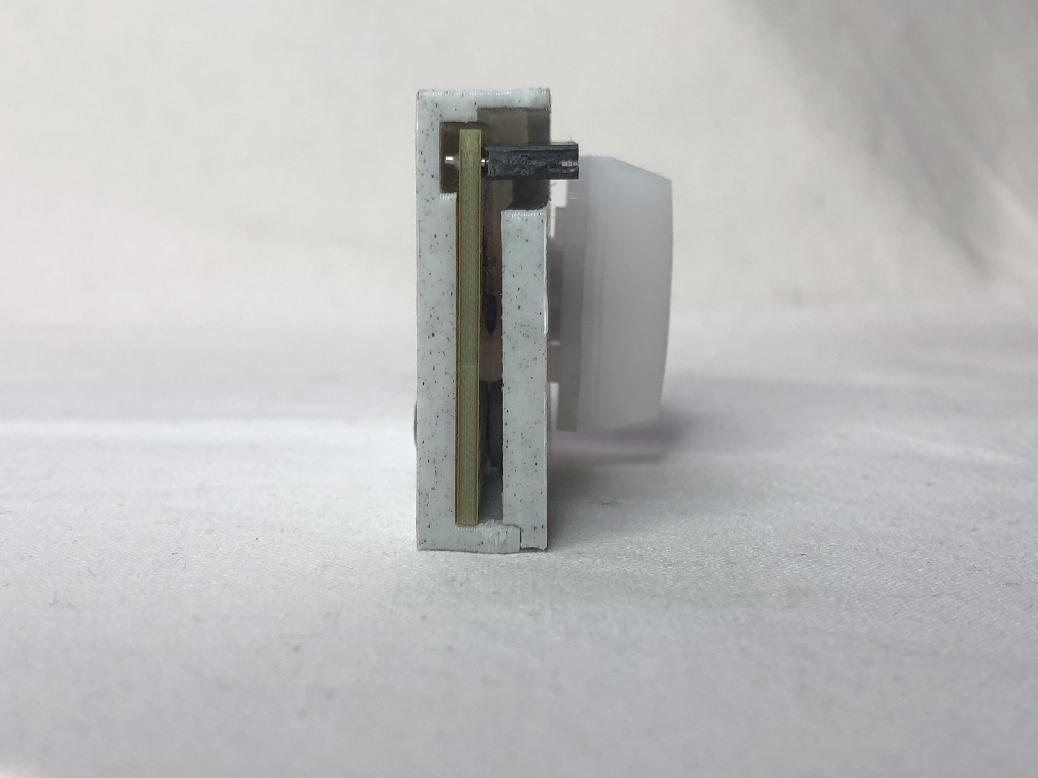
Diplomarbeit/assets/case/Motion-Side.jpg
