SeriousHarlequin/FaRiSmarthome/Diplomarbeit/assets/case/Node-Back.jpg

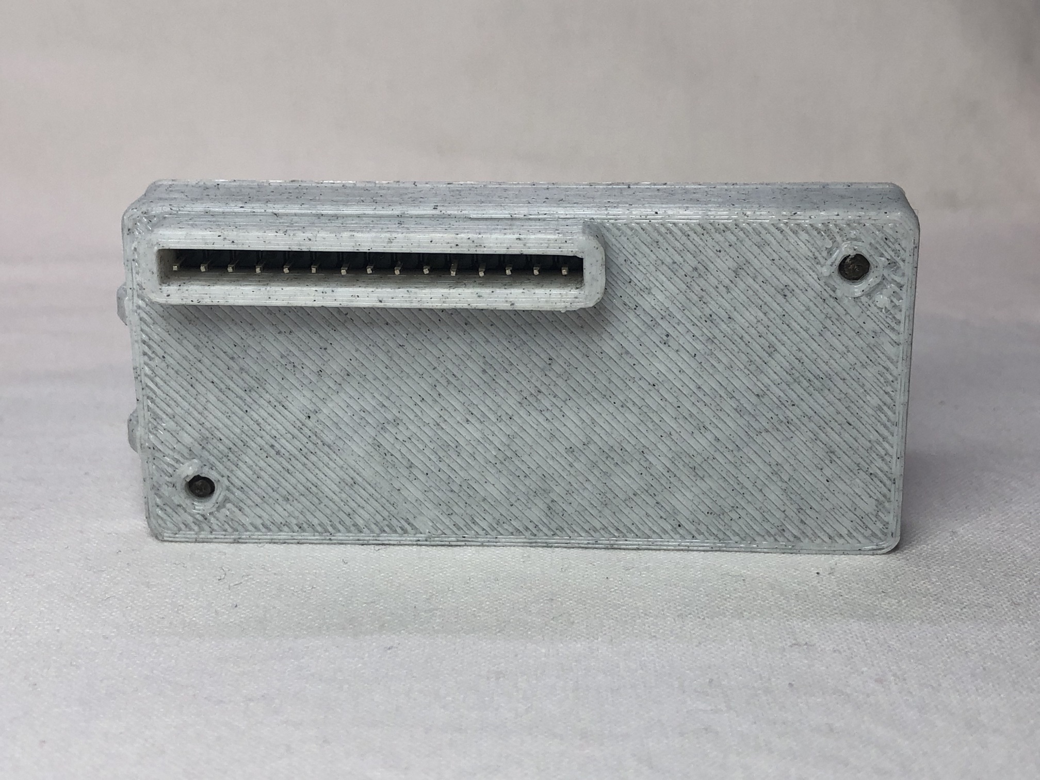
Diplomarbeit/assets/case/Node-Back.jpg
