SeriousHarlequin/FaRiSmarthome/Diplomarbeit/assets/case/Node-Battery-Motion-Side.jpg

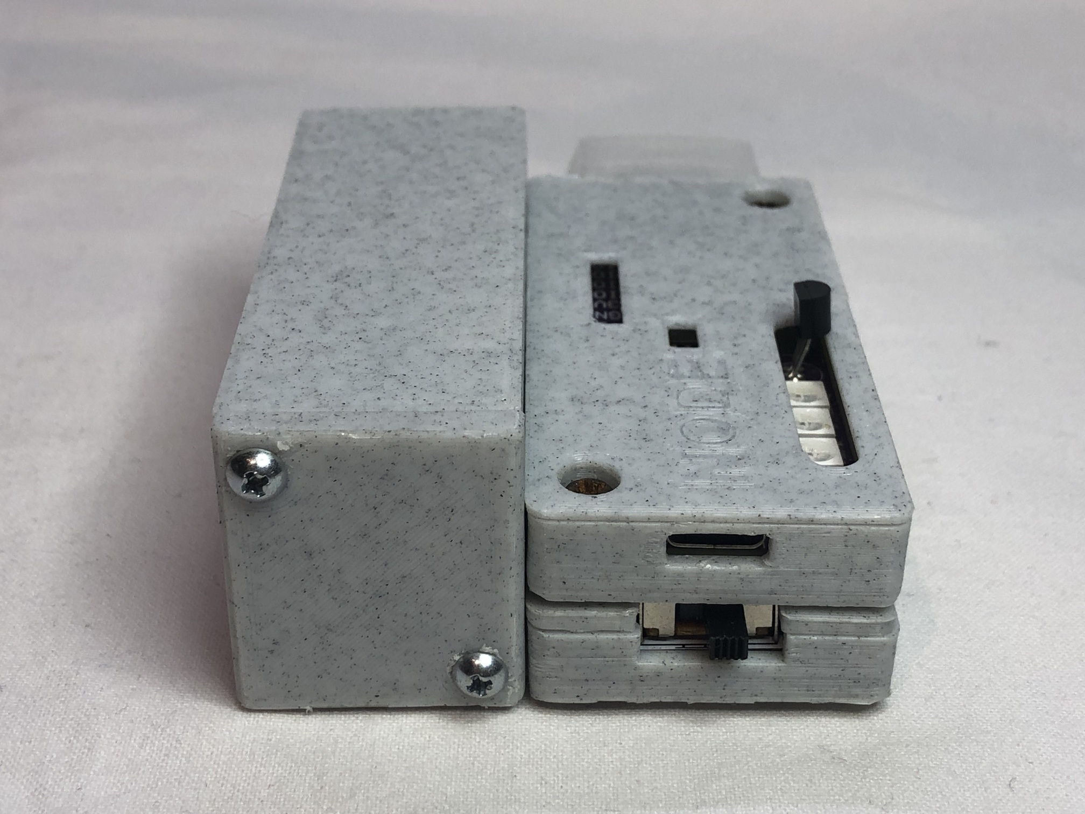
Diplomarbeit/assets/case/Node-Battery-Motion-Side.jpg
