SeriousHarlequin/FaRiSmarthome/Diplomarbeit/assets/case/Node-Switch.jpg

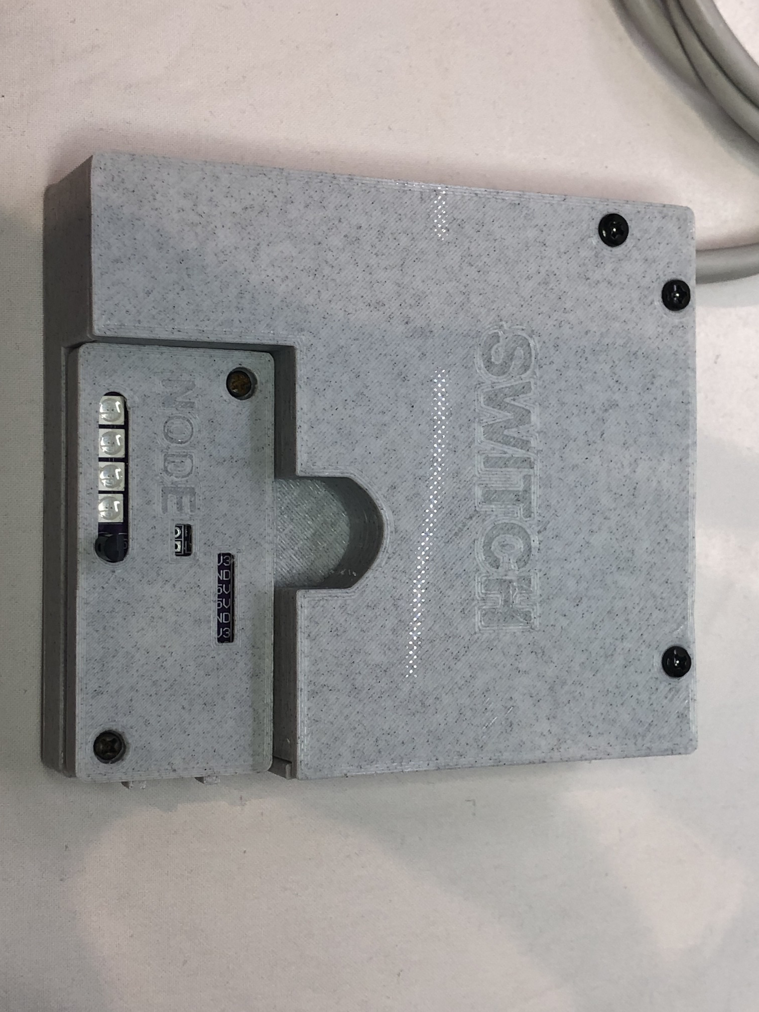
Diplomarbeit/assets/case/Node-Switch.jpg
