SeriousHarlequin/FaRiSmarthome/Diplomarbeit/assets/case/Switch-Back.jpg

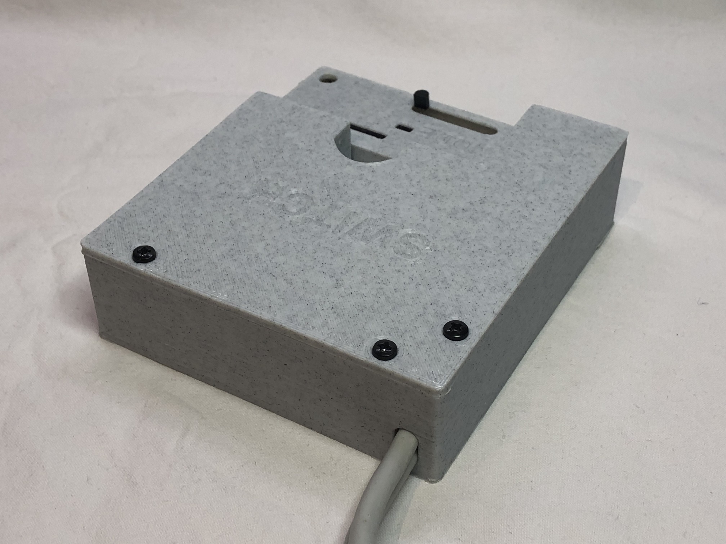
Diplomarbeit/assets/case/Switch-Back.jpg
