SeriousHarlequin/FaRiSmarthome/Diplomarbeit/assets/HW/Datasheet-Allergro-Typical4.png

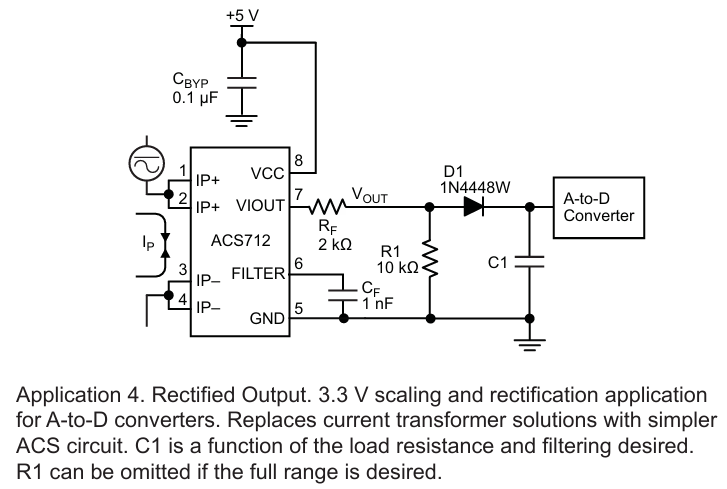
Diplomarbeit/assets/HW/Datasheet-Allergro-Typical4.png
