SeriousHarlequin/FaRiSmarthome/Diplomarbeit/assets/HW/NodeV1.1-Battery-Check.png

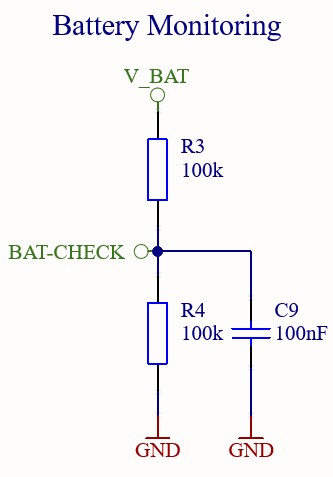
Diplomarbeit/assets/HW/NodeV1.1-Battery-Check.png
