SeriousHarlequin/FaRiSmarthome/Diplomarbeit/assets/HW/PCB-SWITCH-V1.1.png

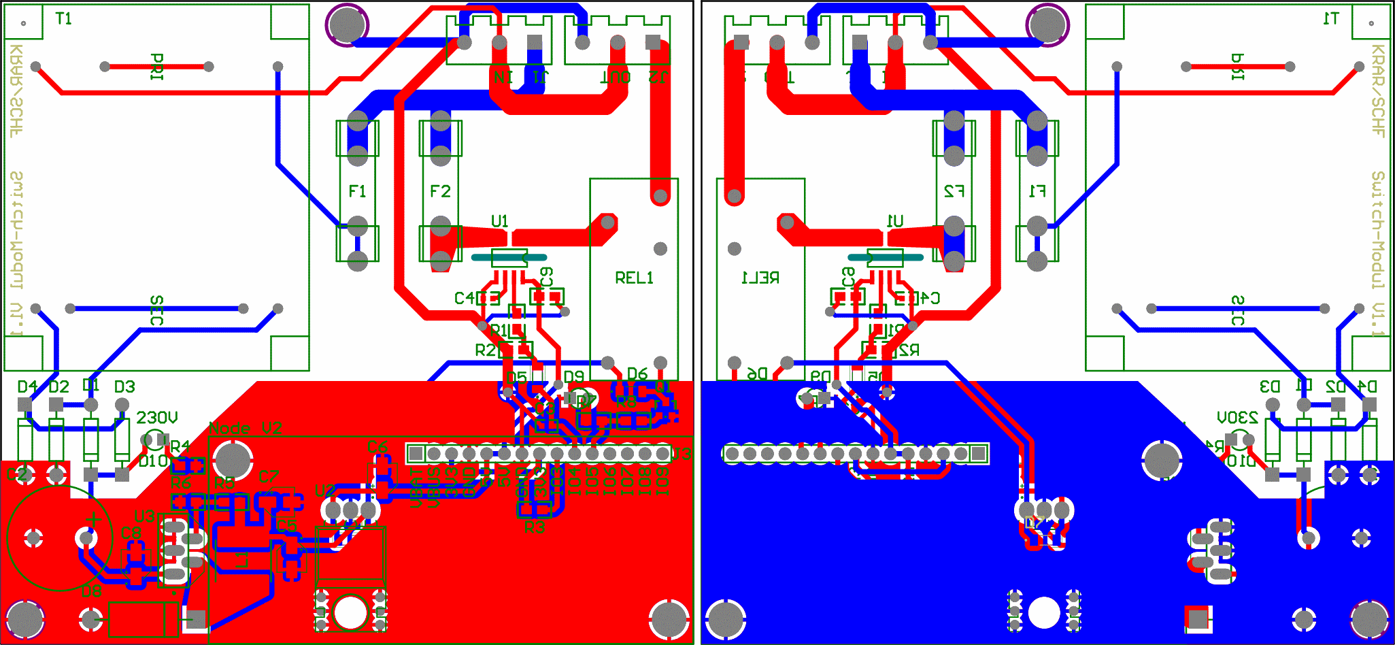
Diplomarbeit/assets/HW/PCB-SWITCH-V1.1.png
