SeriousHarlequin/FaRiSmarthome/Diplomarbeit/assets/HW/TBD2.png

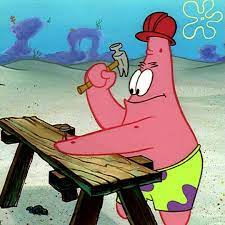
Diplomarbeit/assets/HW/TBD2.png
