SeriousHarlequin/FaRiSmarthome/Diplomarbeit/assets/ThinkCorrectly.jpg

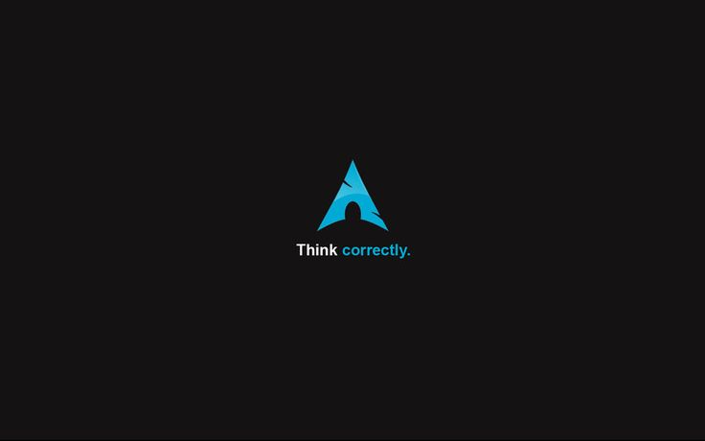
Diplomarbeit/assets/ThinkCorrectly.jpg
