SeriousHarlequin/FaRiSmarthome/HW-Module/Datasheets/Stromwandler_2024-10-29 211501.png

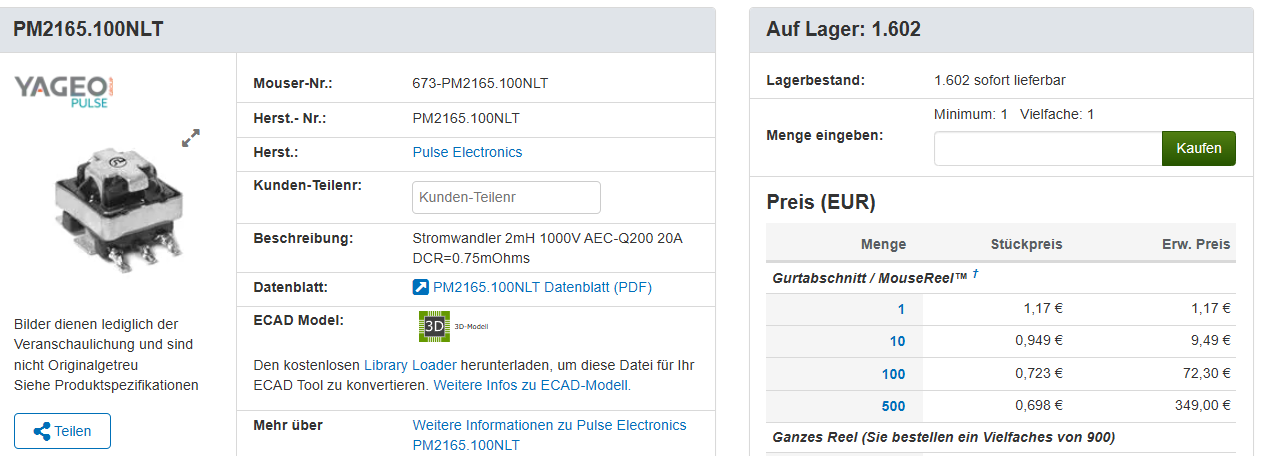
HW-Module/Datasheets/Stromwandler_2024-10-29 211501.png
