SeriousHarlequin/FaRiSmarthome/Labor-Project/docs/HW-PIC/con_rgb.png

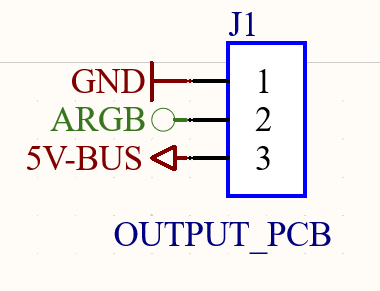
Labor-Project/docs/HW-PIC/con_rgb.png
