SeriousHarlequin/FaRiSmarthome/Labor-Project/docs/HW-PIC/display-back-withpcb.jpg

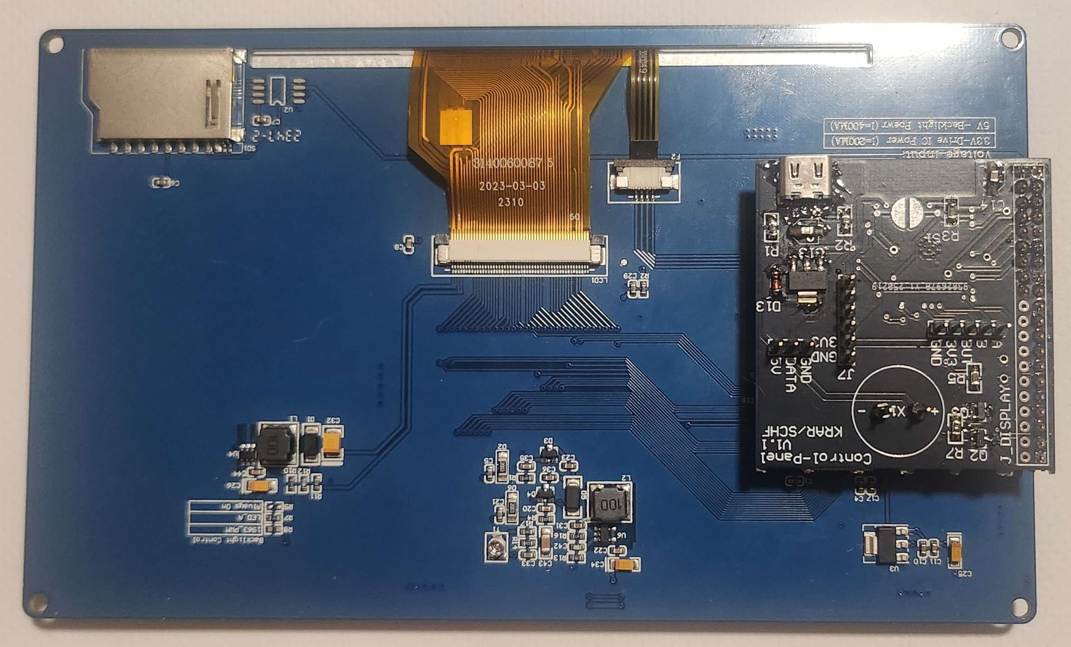
Labor-Project/docs/HW-PIC/display-back-withpcb.jpg
