SeriousHarlequin/FaRiSmarthome/Diplomarbeit/topics/costs.tex

\section{Costs}
\setAuthor{Richard Krammer}
    This section lists the cost of manufacturing each module per unit. Only 
    the final versions of the modules are listed. Licenses and
    development costs are not included in this section as the project
    is open source and not for commercial use. Economic calculations
    were not included for the same reason.

    \subsection{Base Module}
    
        \begin{table}[H]
            \centering
            \begin{tabular}{|c|c|c|c|}
                \hline
                \textbf{Component} & \textbf{Price}  \\
                \hline
                PCB   & €5,24 \\
                \hline
                Components  & €13,56 \\
                \hline
                Total  & \textbf{€18.80} \\
                \hline
            \end{tabular}
            \caption{Costs of the base module}
            \label{tab:costs-base-module}
        \end{table}

    \subsection{Battery Module}
    
        \begin{table}[H]
            \centering
            \begin{tabular}{|c|c|c|c|}
                \hline
                \textbf{Component} & \textbf{Price}  \\
                \hline
                PCB   & €5,24 \\
                \hline
                Components  & €6,70 \\
                \hline
                Total  & \textbf{€11.94} \\
                \hline
            \end{tabular}
            \caption{Costs of the battery module}
            \label{tab:costs-battery-module}
        \end{table}

        \subsection{Switch Module}
    
        \begin{table}[H]
            \centering
            \begin{tabular}{|c|c|c|c|}
                \hline
                \textbf{Component} & \textbf{Price}  \\
                \hline
                PCB   & €5,24 \\
                \hline
                Components  & €41,37 \\
                \hline
                Total  & \textbf{€46.61} \\
                \hline
            \end{tabular}
            \caption{Costs of the switch module}
            \label{tab:costs-switch-module}
        \end{table}

        \subsection{Motion Module}
    
        \begin{table}[H]
            \centering
            \begin{tabular}{|c|c|c|c|}
                \hline
                \textbf{Component} & \textbf{Price}  \\
                \hline
                PCB   & €5,24 \\
                \hline
                Components  & €14,39  \\
                \hline
                Total  & \textbf{€19.85} \\
                \hline
            \end{tabular}
            \caption{Costs of the motion module}
            \label{tab:costs-motion-module}
        \end{table}
