SeriousHarlequin/FaRiSmarthome/HW-Module/PDF-all_schematics/BATTERY-V1.0-BOM.pdf

Comment | Description | Designator | Footprint | LibRef | Quantity
Schraube | Schraubenloch für M3 Schrauben | B1, B2, B3 | B_Schraube-M3 PAD | B_Schraube | 3
10uF | SMD Elektrolytkondensator | C1, C2 | C_SMD_B-Typ | C_SMD_ELK | 2
1uF | SMD Elektrolytkondensator | C3, C4 | C_SMD_B-Typ | C_SMD_ELK | 2
100n | Kondensator SMD Universal, Keramik, Folie, usw. | C5 | C_SMD_0603 | C_SMD_KO | 1
STPS340 | Diode SMD Schottky | D1, D2 | D_DO-214 | D_SMD_Schottky | 2
1A | Sicherung | F1 | F_OMF63_Schurtner | F_THT_Fuse | 1
Batterie | Lithium-Ion | Stecker | J1 | J_THT_Printklemme 2x | J_THT_CON2 | 1
BAT_OUTPUT | Stecker | J2 | SIP-5 | J_THT_CON5 | 1
2,2uH - NR3015T2R2M | Spule SMD | L1 | L_SMD_ND_NR3015T2R 2M | L_SMD_Spule | 1
1M | Widerstand SMD | R1 | R_SMD_0805 | R_SMD_Widerstand | 1
200k | Widerstand SMD | R2 | R_SMD_0805 | R_SMD_Widerstand | 1
100 | Widerstand SMD | R3 | R_SMD_0805 | R_SMD_Widerstand | 1
| Toggle Switch | S1 | S_THT_SW-3Pol | S_THT_Schalter 3-Pol. | 1
U_MCP73811T-420I/OT | Charger IC Lithium Ion/ Polymer SOT-23-5 | U1 | SOT95P280X145-5N | U_MCP73811T-420I/OT | 1
U_TPS63000DRCRG4 | High efficiency Buck-Boost Converter with 1.8A Current Switches in 3x3 QFN 10-VSON -40 to 85 | U2 | VREG_V62/16624-01YE | U_TPS63000DRCRG4 | 1
