SeriousHarlequin/FaRiSmarthome/HW-Module/BATTERY/Battery_V2.2.step

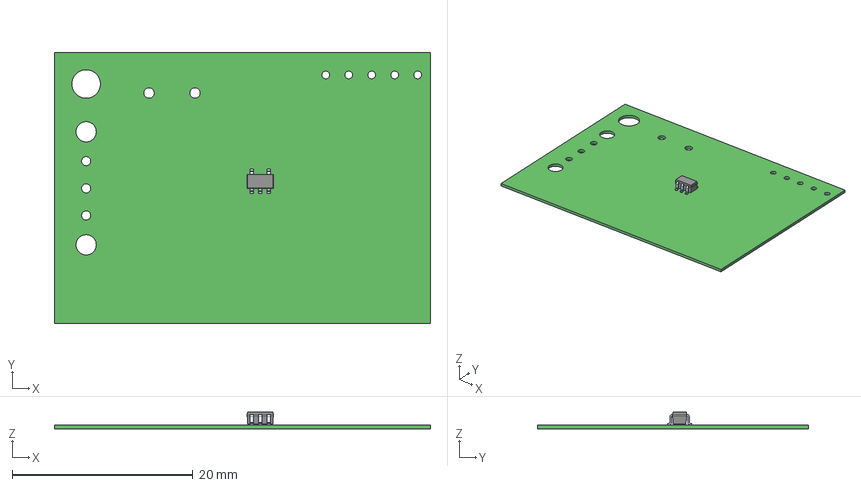
[picture p193: CAD file, 2025-03-07]
HW-Module/BATTERY/Battery_V2.2.step
41.6 x 30.0 x 1.86 mm
