SeriousHarlequin/FaRiSmarthome/HW-Module/Case/NODE-Battery-Motion.3mf

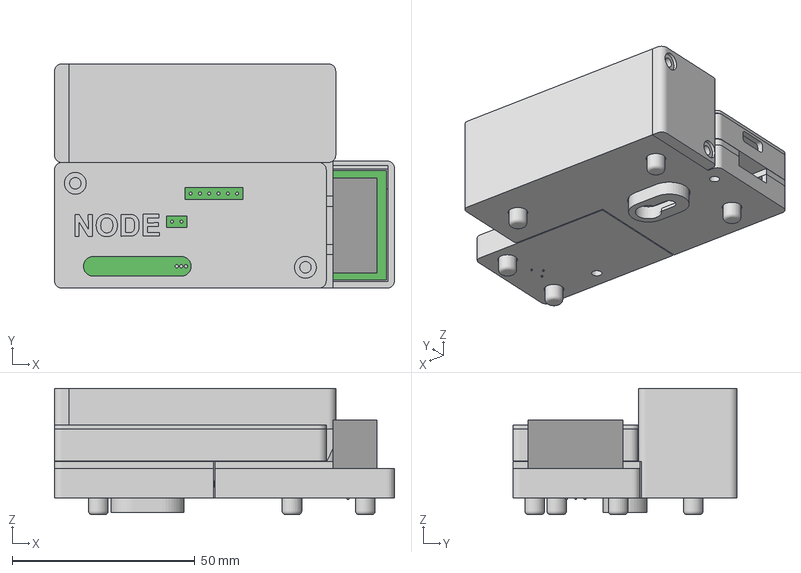
[picture p194: CAD file, 2025-04-22]
HW-Module/Case/NODE-Battery-Motion.3mf
93.1 x 61.4 x 34.6 mm
BATTERY-Base (1)
BATTERY-Batteriedeckel
BATTERY-Deckel
BATTERY-Halterung
Körper1 x 8
Körper10
Körper11
Körper12
Körper13
Körper14
Körper15
Körper16
Körper17
Körper18
Körper19 x 2
Körper2 x 4
Körper20 x 2
Körper21 x 2
Körper22
Körper23
Körper24
Körper25
Körper26
Körper27
Körper28
Körper29
Körper3 x 4
Körper30
Körper31
Körper32 x 2
Körper33 x 2
Körper34
Körper35
Körper36
Körper37
Körper4
Körper5
Körper6
Körper7
Körper8
Körper9
MOTION-Base
MOTION-Deckel
NODE-Base
NODE-Deckel
