SeriousHarlequin/FaRiSmarthome/HW-Module/MOTION_DETECTION/PCB_Motion-V1.1.step

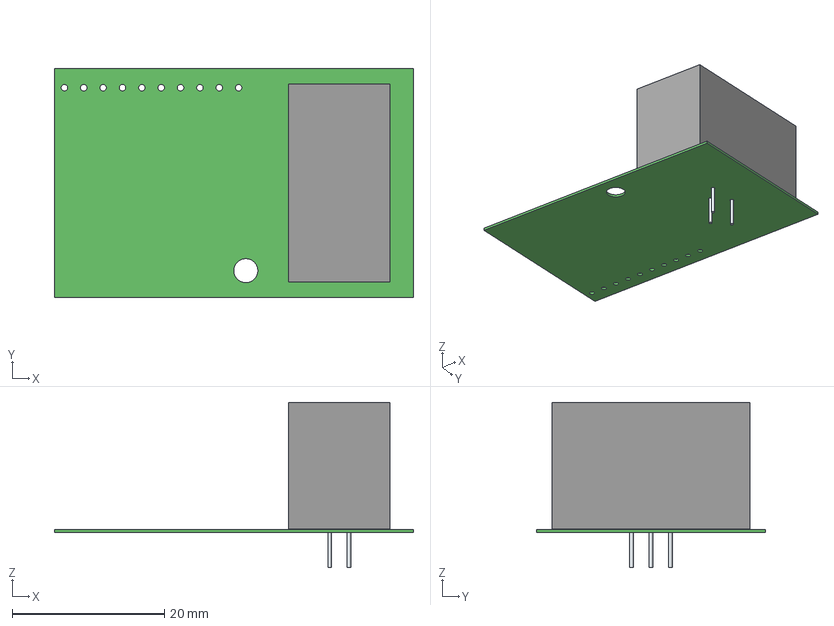
[picture p195: CAD file, 2025-03-05]
HW-Module/MOTION_DETECTION/PCB_Motion-V1.1.step
47.1 x 30.0 x 21.7 mm
Leads x 3
