SeriousHarlequin/FaRiSmarthome/HW-Module/NODE/PCB_Node-V2.2.step

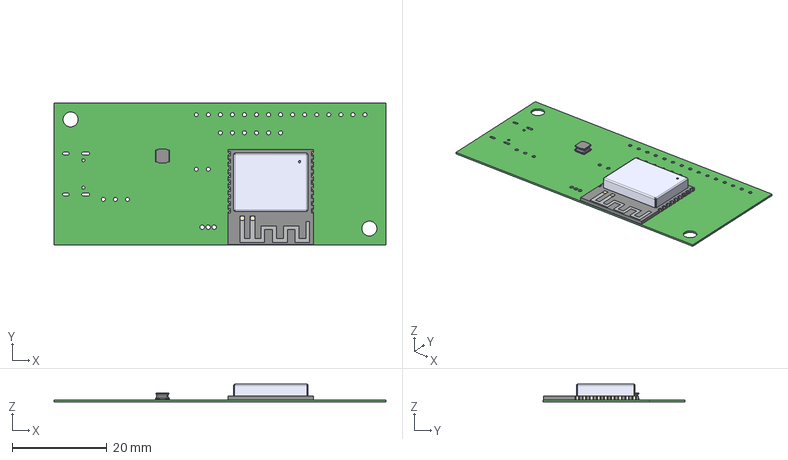
[picture p196: CAD file, 2025-01-15]
HW-Module/NODE/PCB_Node-V2.2.step
70.0 x 30.0 x 3.76 mm
