SeriousHarlequin/FaRiSmarthome/HW-Module/SWITCH/Switch-Case-3Pieces.3mf

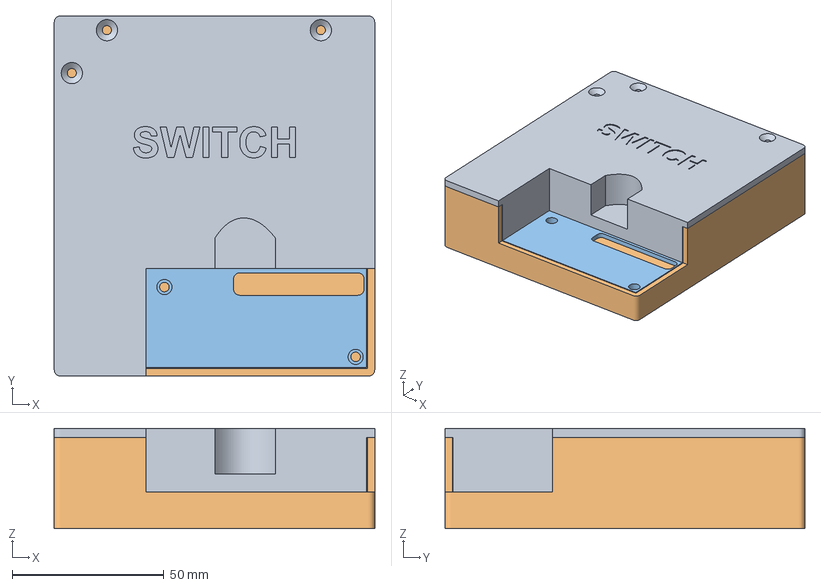
[picture p197: CAD file, 2025-03-27]
HW-Module/SWITCH/Switch-Case-3Pieces.3mf
105.6 x 118.6 x 33.0 mm
Körper30
SWITCH-BASE
SWITCH-DECKEL1
