SeriousHarlequin/FaRiSmarthome/HW-Module/Case/Battery.3mf

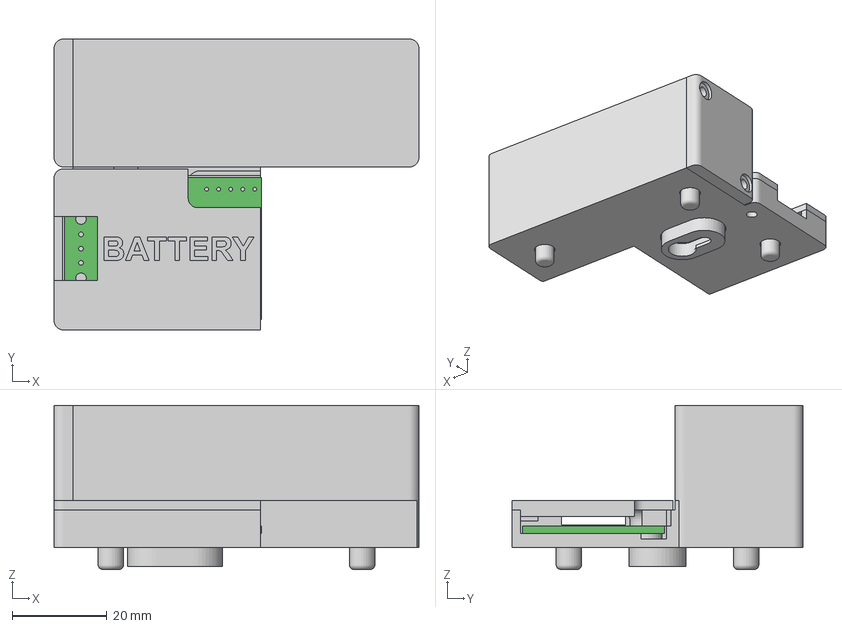
[picture p198: CAD file, 2025-04-22]
HW-Module/Case/Battery.3mf
77.0 x 61.4 x 34.6 mm
BATTERY-Base (1)
BATTERY-Batteriedeckel
BATTERY-Deckel
BATTERY-Halterung
Körper1
Körper19
Körper20
Körper21
