SeriousHarlequin/FaRiSmarthome/HW-Module/SWITCH/Switch-Base.3mf

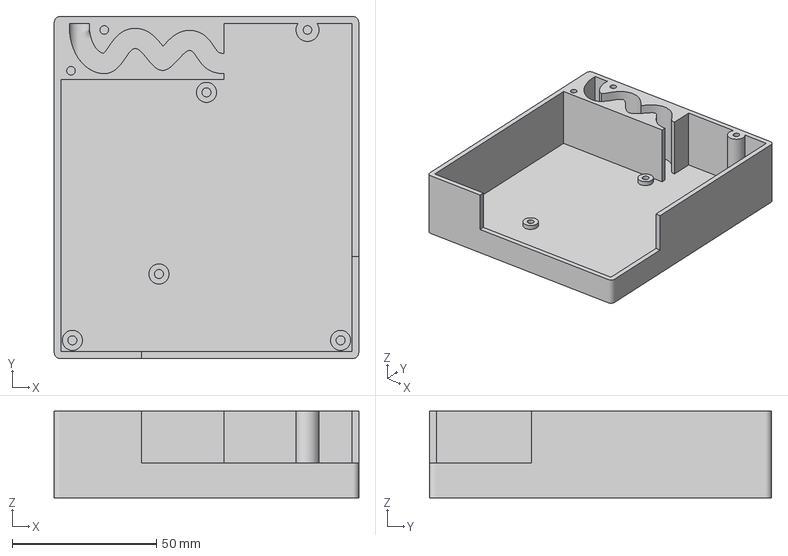
[picture p199: CAD file, 2025-03-20]
HW-Module/SWITCH/Switch-Base.3mf
105.6 x 118.6 x 30.0 mm
