SeriousHarlequin/FaRiSmarthome/HW-Module/Case/Battery-Motion.3mf

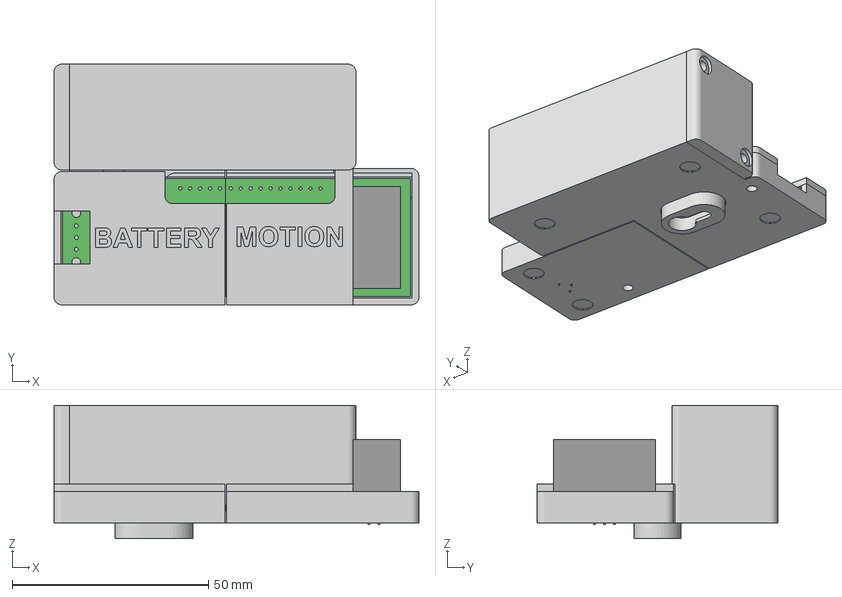
[picture p200: CAD file, 2025-04-22]
HW-Module/Case/Battery-Motion.3mf
93.1 x 61.4 x 34.0 mm
BATTERY-Base (1)
BATTERY-Batteriedeckel
BATTERY-Deckel
BATTERY-Halterung
Körper1 x 6
Körper2 x 3
Körper3 x 3
MOTION-Base
MOTION-Deckel
