SeriousHarlequin/FaRiSmarthome/HW-Module/SWITCH/PCB-Switch_V1.1.step

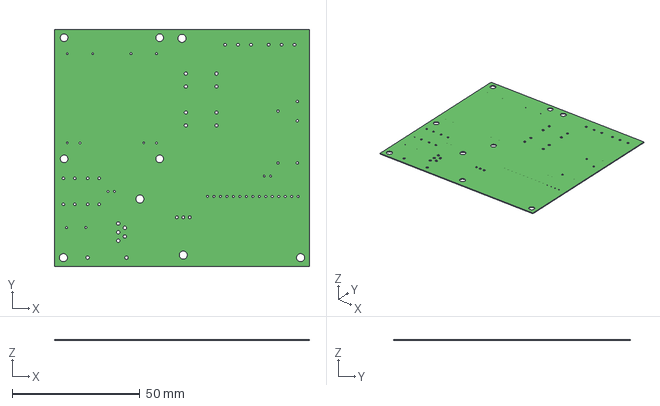
[picture p201: CAD file, 2025-03-20]
HW-Module/SWITCH/PCB-Switch_V1.1.step
100.0 x 93.0 x 0.411 mm
