SeriousHarlequin/FaRiSmarthome/HW-Module/Case/Motion.3mf

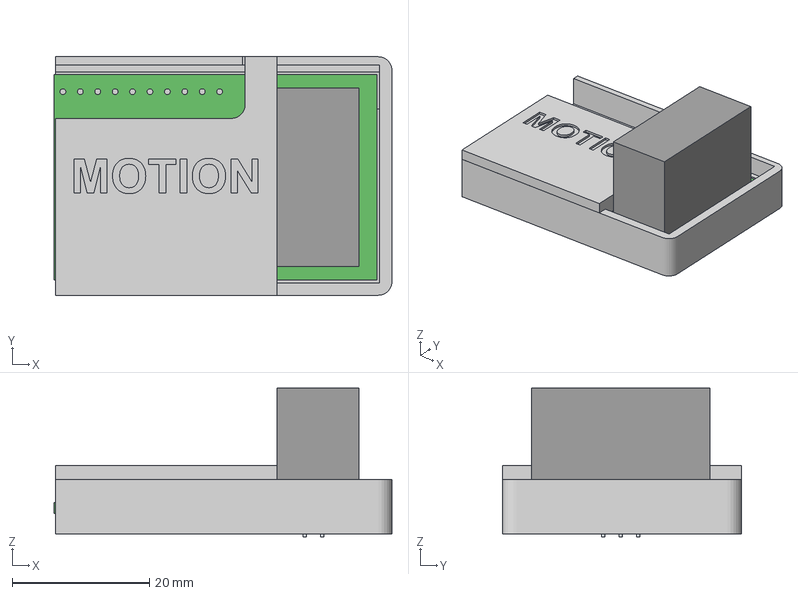
[picture p202: CAD file, 2025-04-22]
HW-Module/Case/Motion.3mf
49.3 x 34.8 x 21.7 mm
Körper1 x 5
Körper2 x 3
Körper3 x 3
MOTION-Base
MOTION-Deckel
