SeriousHarlequin/FaRiSmarthome/HW-Module/Case/Switch.3mf

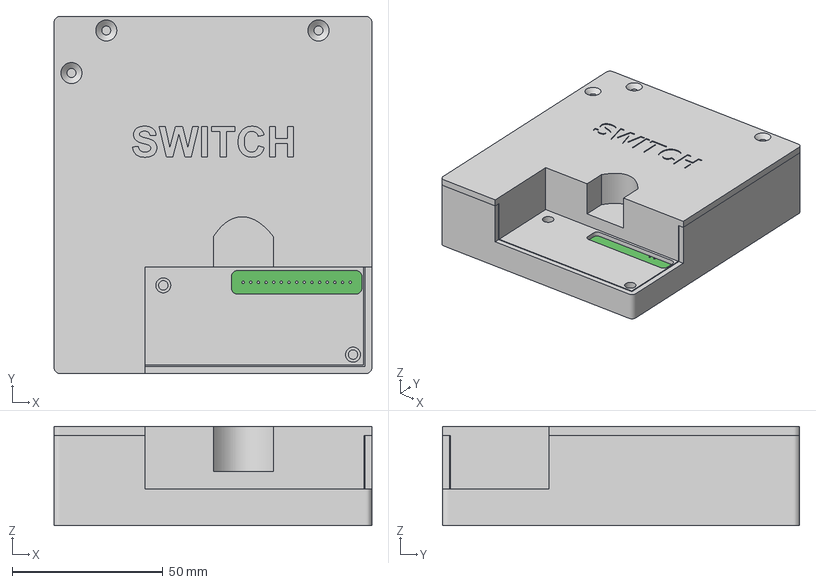
[picture p203: CAD file, 2025-04-22]
HW-Module/Case/Switch.3mf
105.6 x 118.6 x 33.0 mm
Körper1
SWITCH-BASE
SWITCH-DECKEL1
SWITCH-DECKEL2
