SeriousHarlequin/FaRiSmarthome/HW-Module/Case/Node-Switch.3mf

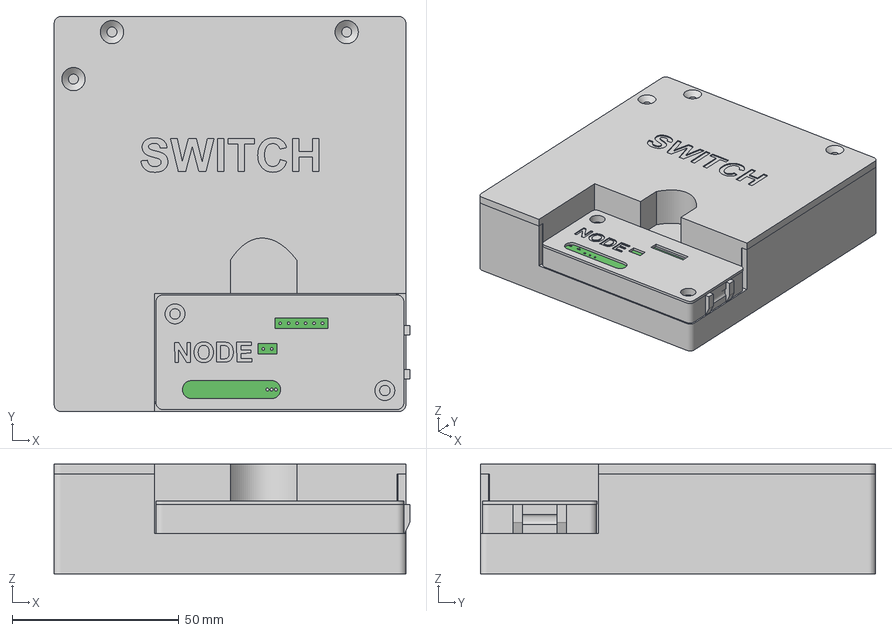
[picture p204: CAD file, 2025-04-22]
HW-Module/Case/Node-Switch.3mf
106.8 x 118.6 x 33.0 mm
Körper1 x 2
NODE-Base
NODE-Deckel
SWITCH-BASE
SWITCH-DECKEL1
SWITCH-DECKEL2
