SeriousHarlequin/FaRiSmarthome/HW-Module/Case/Node.3mf

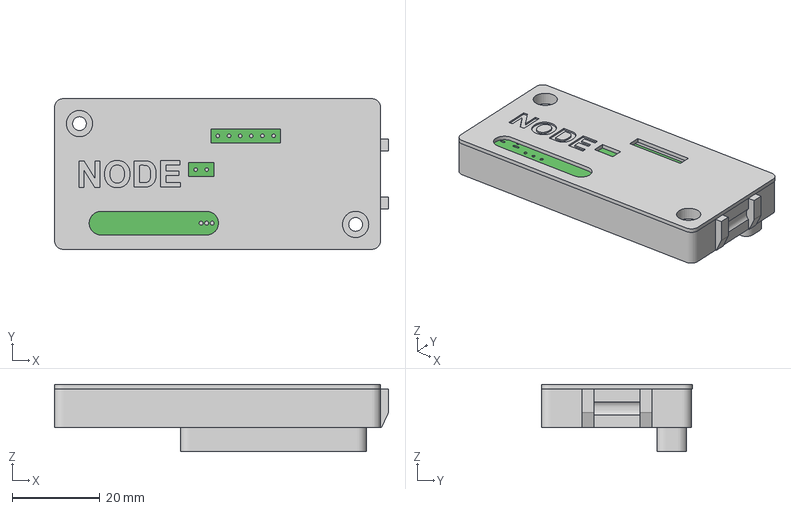
[picture p205: CAD file, 2025-04-22]
HW-Module/Case/Node.3mf
76.2 x 34.4 x 15.3 mm
Körper1
NODE-Base
NODE-Deckel
