SeriousHarlequin/FaRiSmarthome/Diplomarbeit/assets/case/Battery-Disassembled.jpg

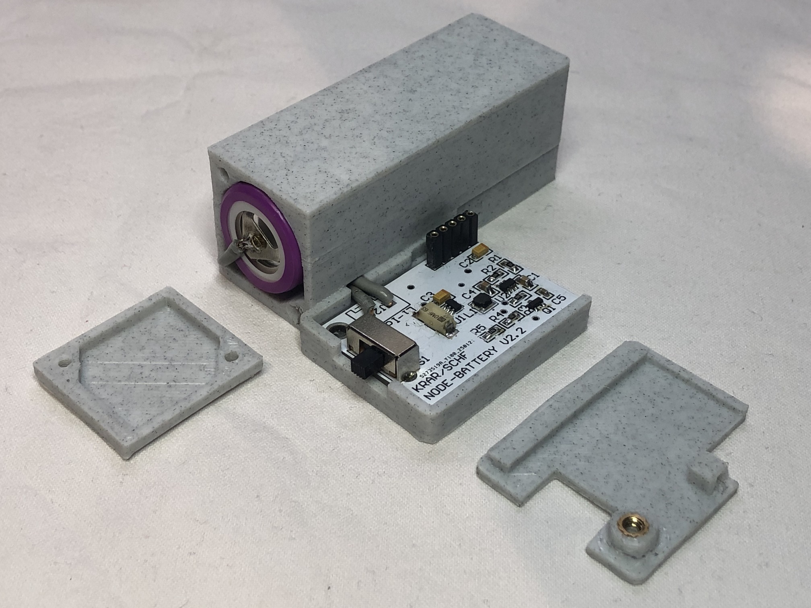
Diplomarbeit/assets/case/Battery-Disassembled.jpg
