SeriousHarlequin/FaRiSmarthome/Diplomarbeit/assets/case/Node-Disassembled.jpg

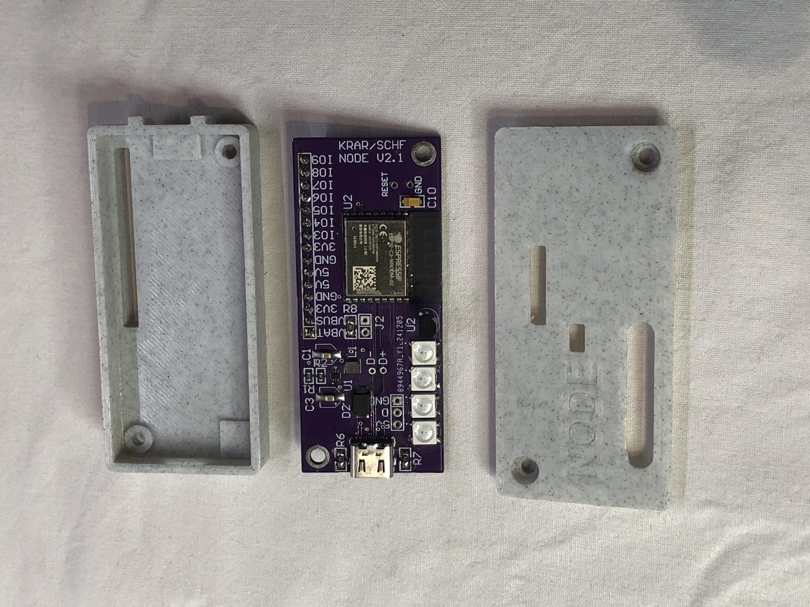
Diplomarbeit/assets/case/Node-Disassembled.jpg
