SeriousHarlequin/FaRiSmarthome/Diplomarbeit/assets/caseHighRes/Switch-Disassembled - Transparent.jpg

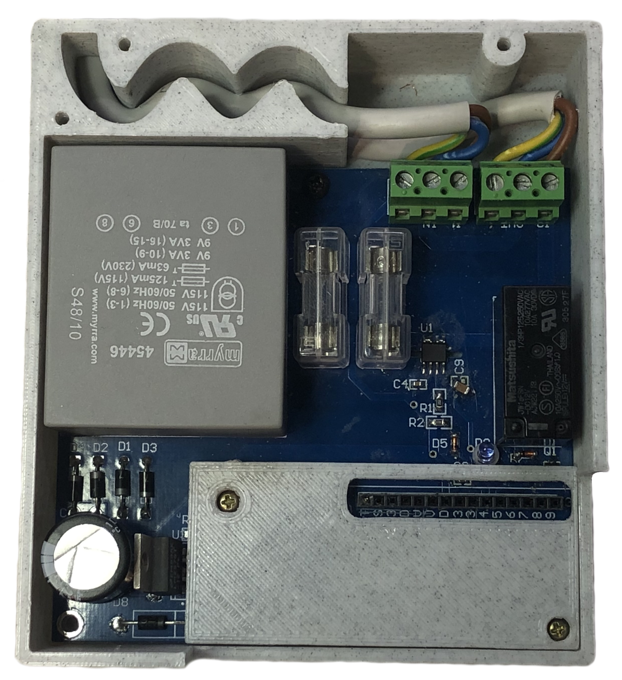
Diplomarbeit/assets/caseHighRes/Switch-Disassembled - Transparent.jpg
