SeriousHarlequin/FaRiSmarthome/charts/EspNowTestCharts.ods

Distance [m] | RSSI [dbm] | Latency [ms]
10 | -65 | 4
20 | -80 | 5
30 | -77 | 4
40 | -88 | 5
60 | -90 | 6
80 | -83 | 6
100 | -89 | 4
160 | -89 | 4
Distance [m] | RSSI [dbm] | Latency [ms]
4 | -74 | 11
80 | -84 | 22
12 | -89 | 21
