SeriousHarlequin/FaRiSmarthome/Diplomarbeit/TODO.txt

future section - to be done - what isn't complete/part of the thesis?
hardware insert - in Nodes section - HOW?
meetings docs at the end
pages from thesis template at the beginning
abstract en,de - write at the end - convert from executive summary - in front of everything
See notes from RZEP corrections
Describe Personalized options - what can be different/adjusted/functionally the same -> replaced without much change
