SeriousHarlequin/FaRiSmarthome/HW-Module/BATTERY/Changes/V1.png

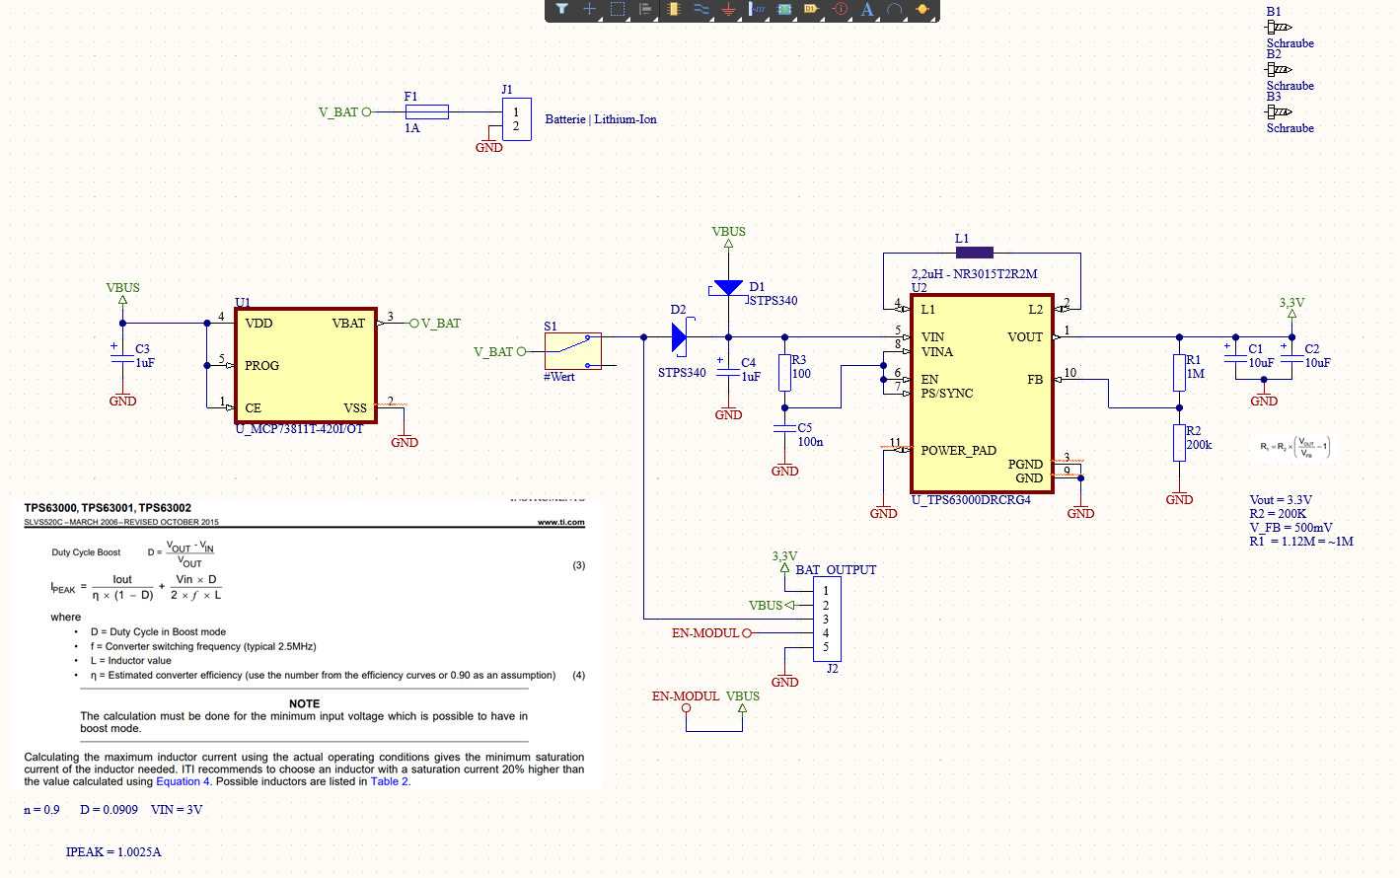
HW-Module/BATTERY/Changes/V1.png
