SeriousHarlequin/FaRiSmarthome/HW-Module/BATTERY/Changes/V2.1.png

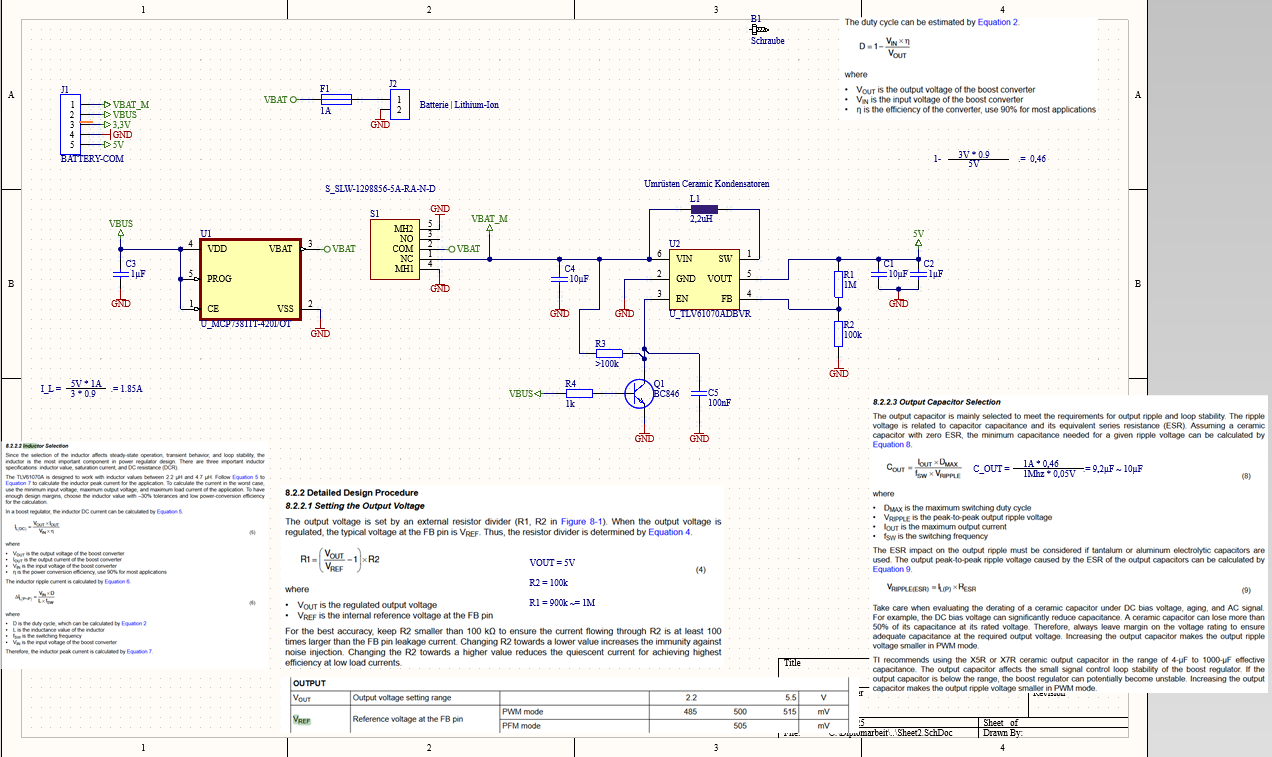
HW-Module/BATTERY/Changes/V2.1.png
