SeriousHarlequin/FaRiSmarthome/HW-Module/BATTERY/Changes/V2.2.png

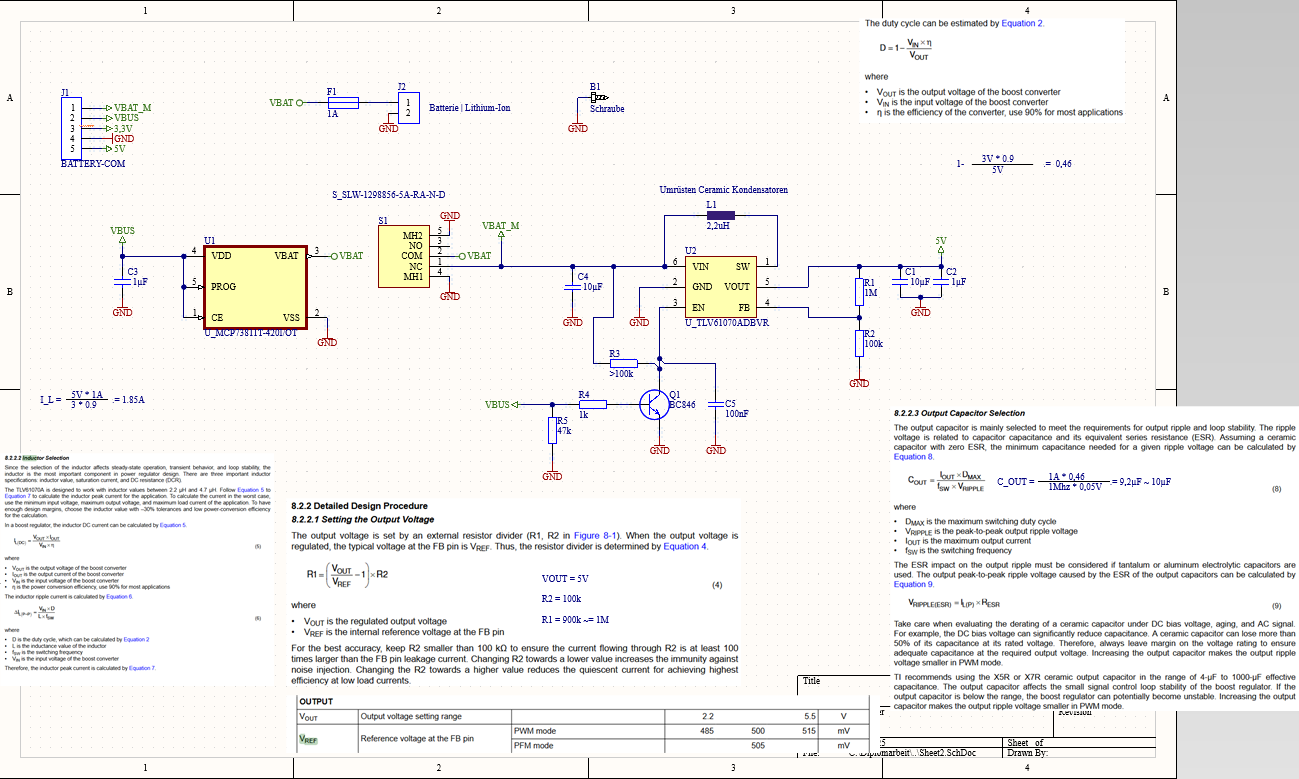
HW-Module/BATTERY/Changes/V2.2.png
