SeriousHarlequin/FaRiSmarthome/HW-Module/NODE/Changes/V1.1.PNG

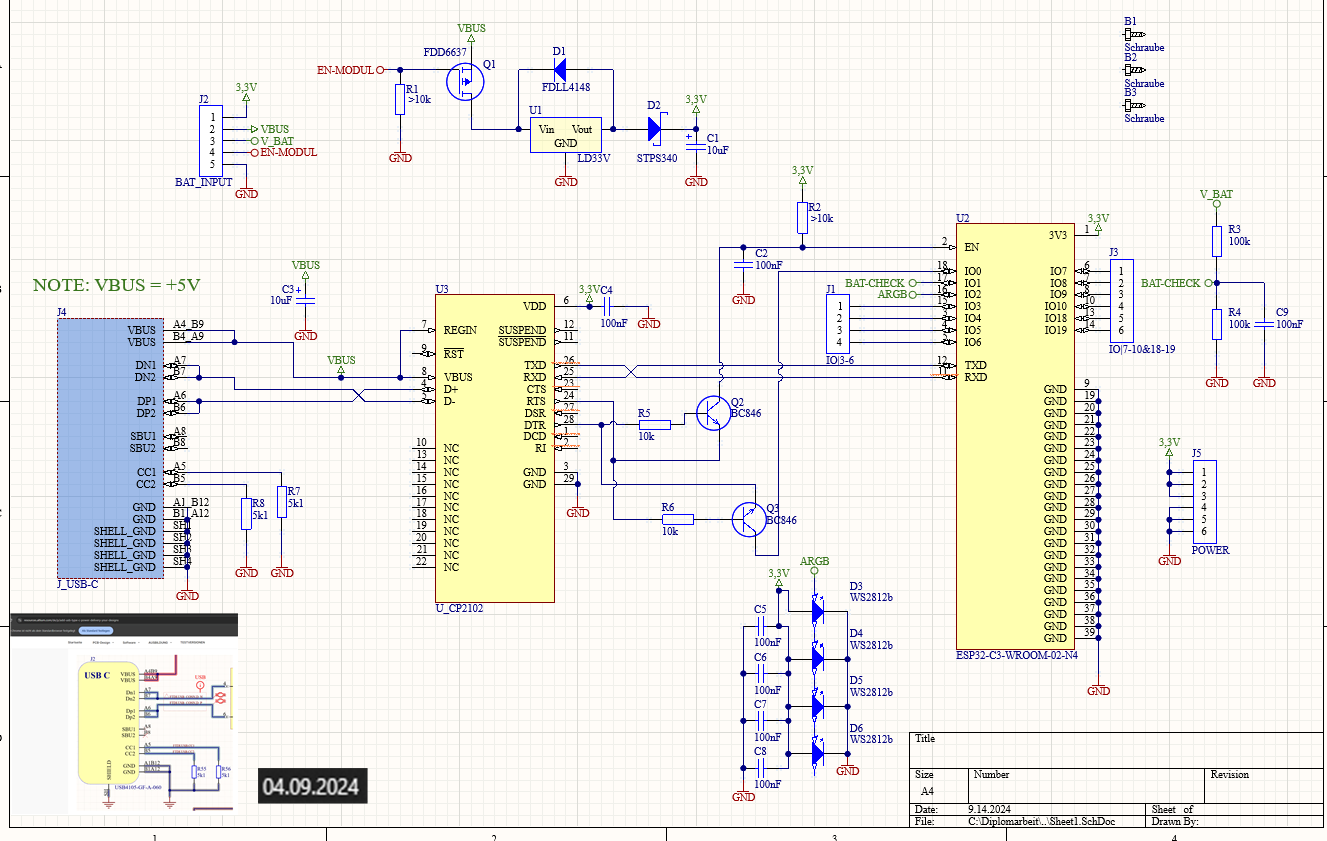
HW-Module/NODE/Changes/V1.1.PNG
