SeriousHarlequin/FaRiSmarthome/HW-Module/NODE/Changes/V1.PNG

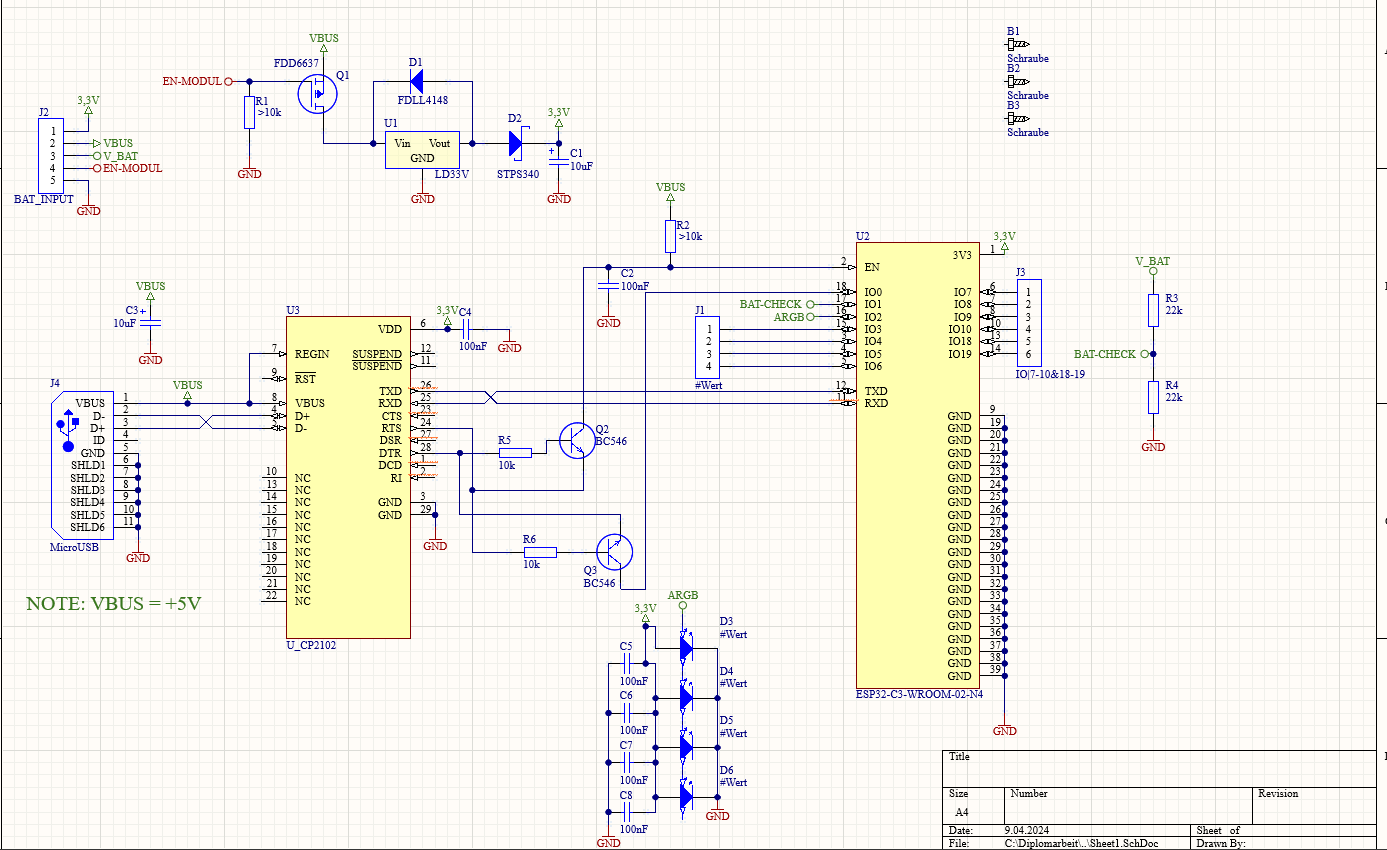
HW-Module/NODE/Changes/V1.PNG
