SeriousHarlequin/FaRiSmarthome/HW-Module/NODE/Changes/V2.1.png

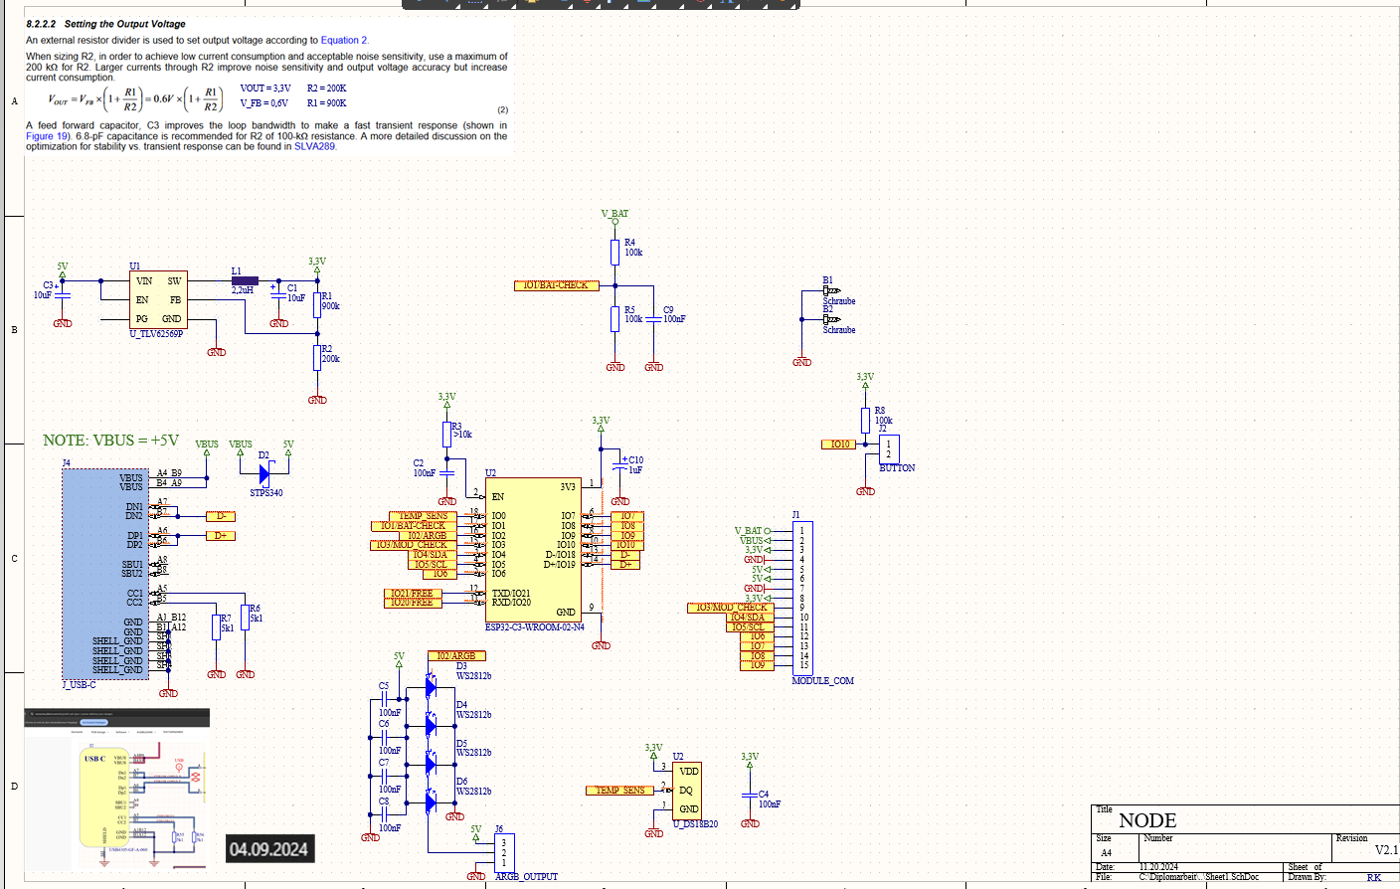
HW-Module/NODE/Changes/V2.1.png
