SeriousHarlequin/FaRiSmarthome/HW-Module/SWITCH/Changes/V1.png

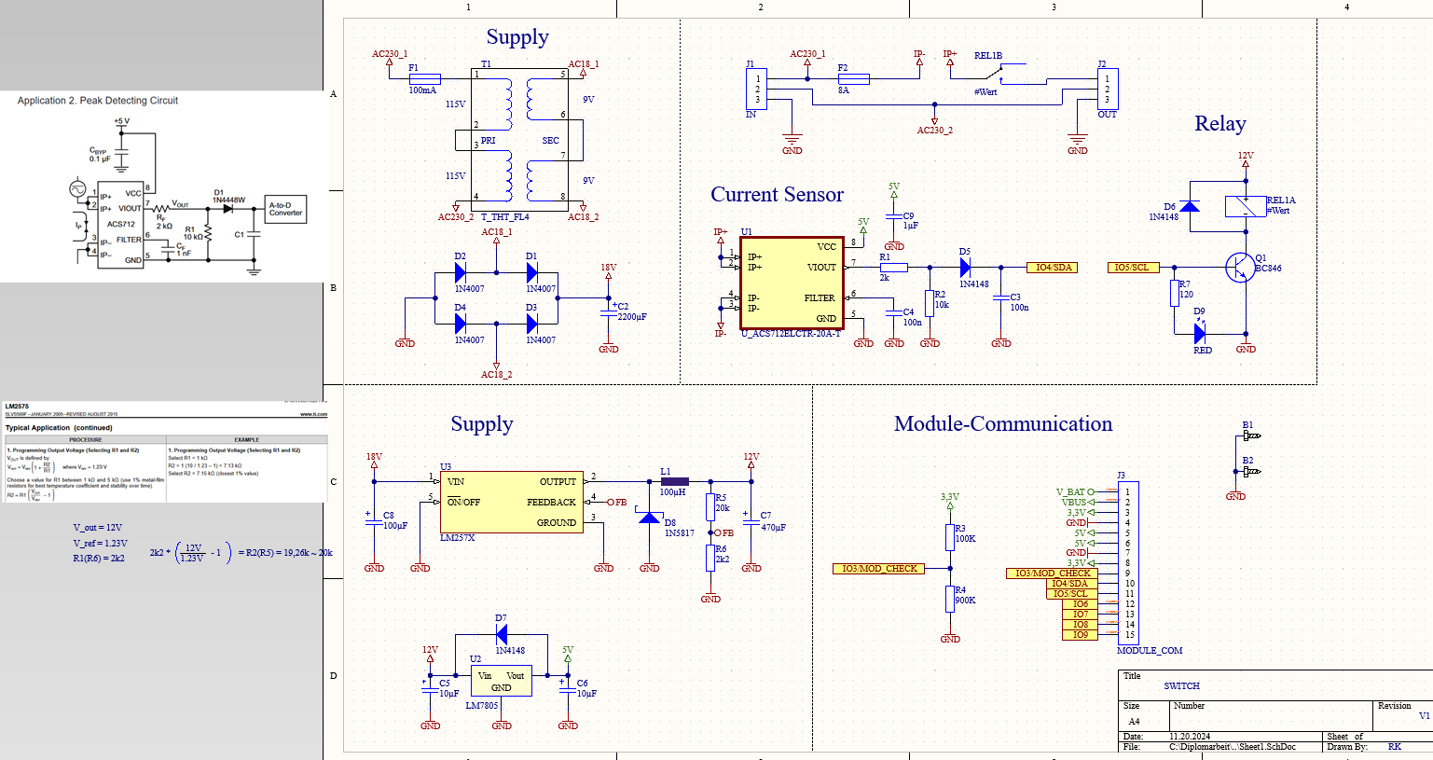
HW-Module/SWITCH/Changes/V1.png
