SeriousHarlequin/FaRiSmarthome/HW-Module/PDF-all_schematics/BATTERY-V2.2.pdf

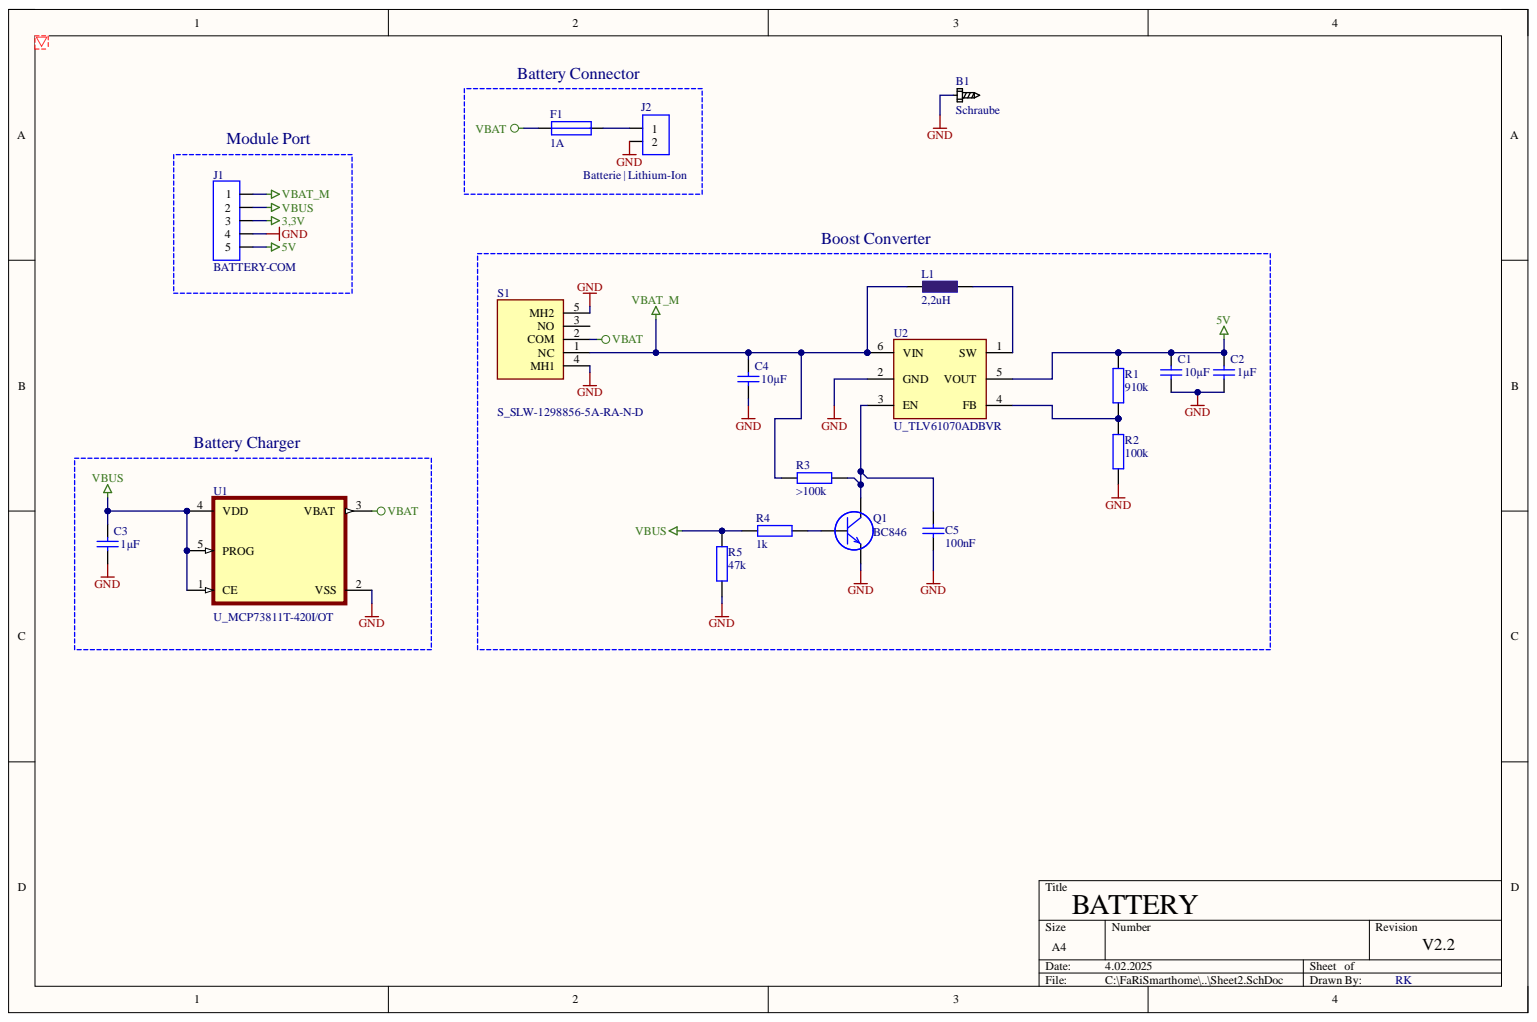
[picture p220: page 1]

Comment | Description | Designator | Footprint | LibRef | Quantity
Schraube | Schraubenlochfür M3 Schrauben | B1 | B_Schraube-M3PAD | B_Schraube | 1
10µF | Kondensator SMD Universal,Keramik, Folie, usw. | C1, C4 | C_SMD_0805 | C_SMD_KO | 2
1µF | Kondensator SMD Universal,Keramik, Folie, usw. | C2, C3 | C_SMD_0805 | C_SMD_KO | 2
100nF | Kondensator SMD Universal,Keramik, Folie, usw. | C5 | C_SMD_0603 | C_SMD_KO | 1
1A | Sicherung | F1 | F_OMF63_Schurtner | F_THT_Fuse | 1
BATTERY-COM | Stecker | J1 | SIP-5 | J_THT_CON5 | 1
Batterie| Lithium-Ion | Stecker | J2 | J_THT_Printklemme2x | J_THT_CON2 | 1
2,2uH | SpuleSMD | L1 | L_SMD_74438357100 | L_SMD_Spule | 1
BC846 | NPNTransistor | Q1 | SOT-23-3_BC846 | Q_SMD_NPN | 1
910k | WiderstandSMD | R1 | R_SMD_0805 | R_SMD_Widerstand | 1
100k | WiderstandSMD | R2 | R_SMD_0805 | R_SMD_Widerstand | 1
>100k | WiderstandSMD | R3 | R_SMD_0805 | R_SMD_Widerstand | 1
1k | WiderstandSMD | R4 | R_SMD_0805 | R_SMD_Widerstand | 1
47k | WiderstandSMD | R5 | R_SMD_0805 | R_SMD_Widerstand | 1
S_SLW-1298856-5A-RA-N-D | Switch | S1 | SLW12988565ARAND | S_SLW-1298856-5A-RA-N-D | 1
U_MCP73811T-420I/OT Charger ICLithium | Ion/Polymer SOT-23-5 | U1 | SOT95P280X145-5N | U_MCP73811T-420I/OT | 1
U_TLV61070ADBVR | IntegratedCircuit, Boost converter: Input 0.5- 5.5V Output 2.2- 5.5V | U2 | SOT23-6 | U_TLV61070ADBVR | 1
