SeriousHarlequin/FaRiSmarthome/HW-Module/PDF-all_schematics/SWITCH-V1.1.pdf

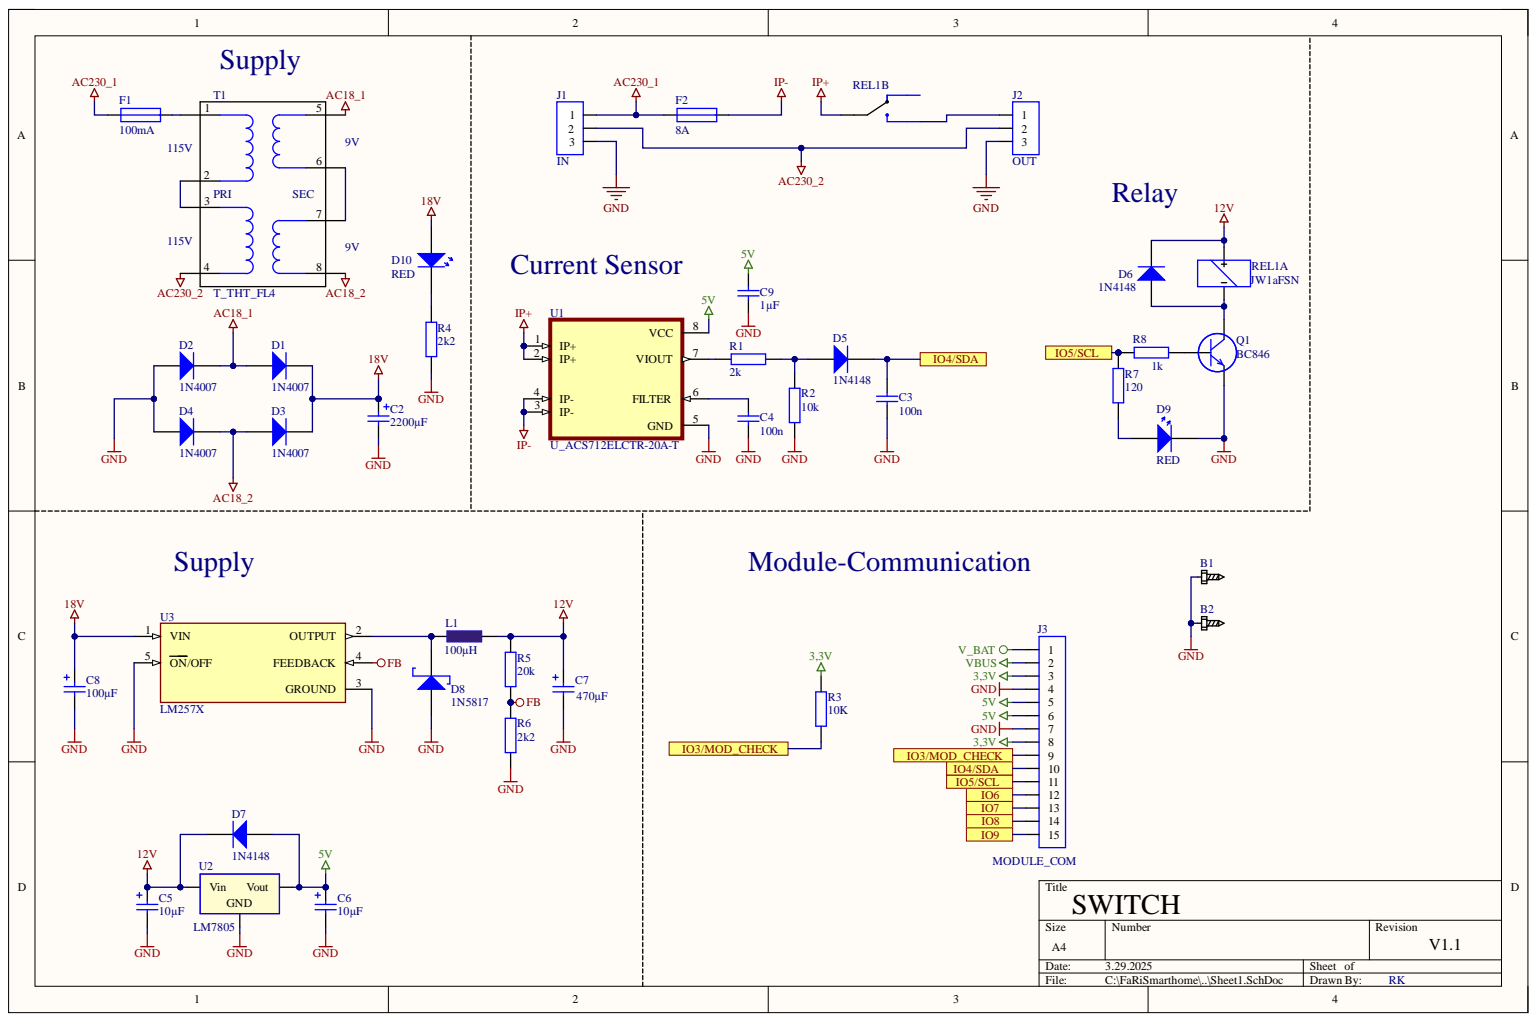
[picture p221: page 1]
