SeriousHarlequin/FaRiSmarthome/HW-Module/NODE/Node.pdf

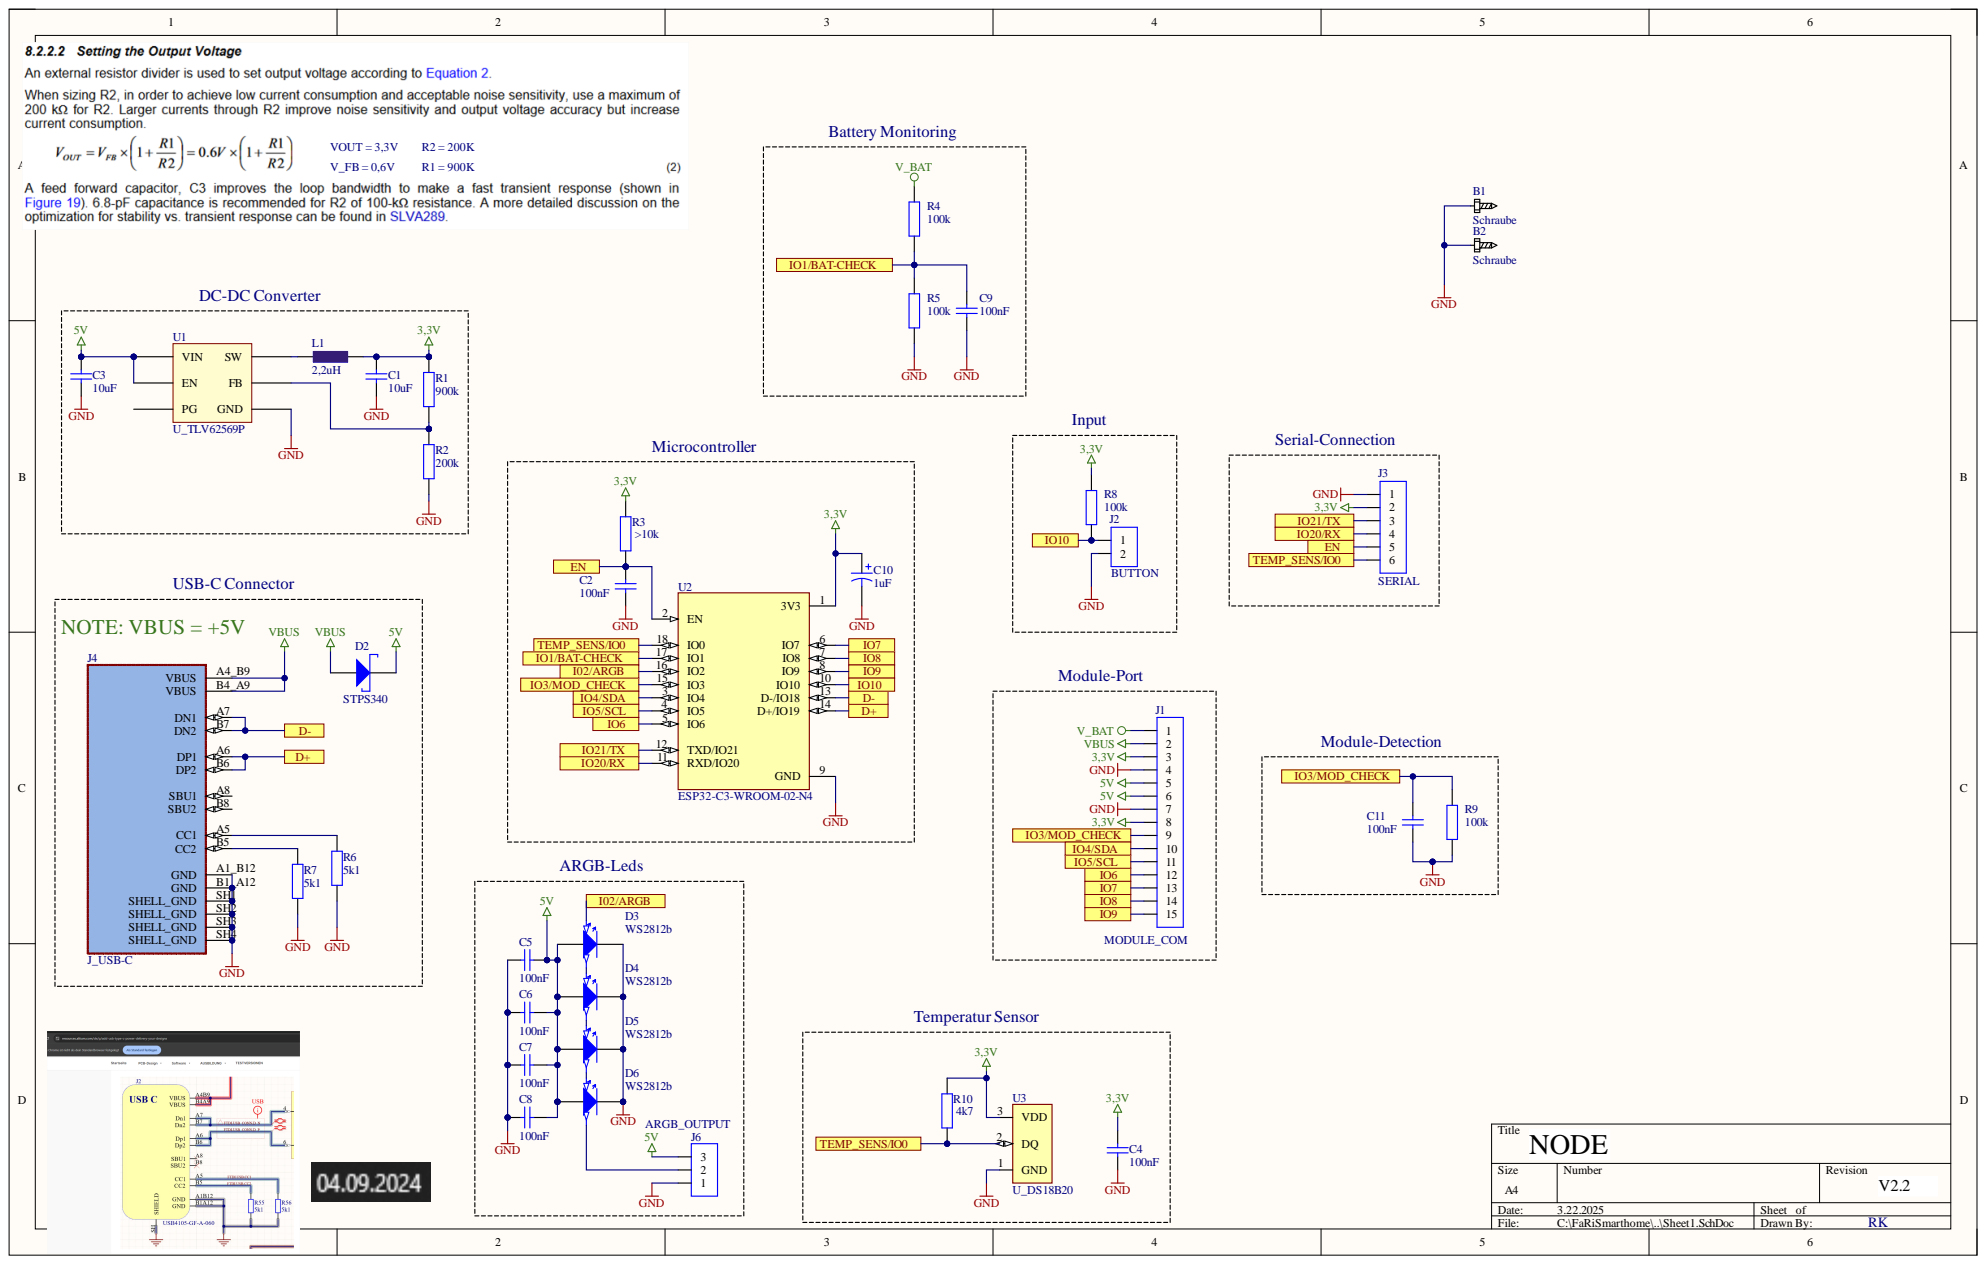
[picture p222: page 1]

IO1/BA T-CHE C K | 1 7 | 7 | IO 8

3 | | 1 3
4 | | 1 4

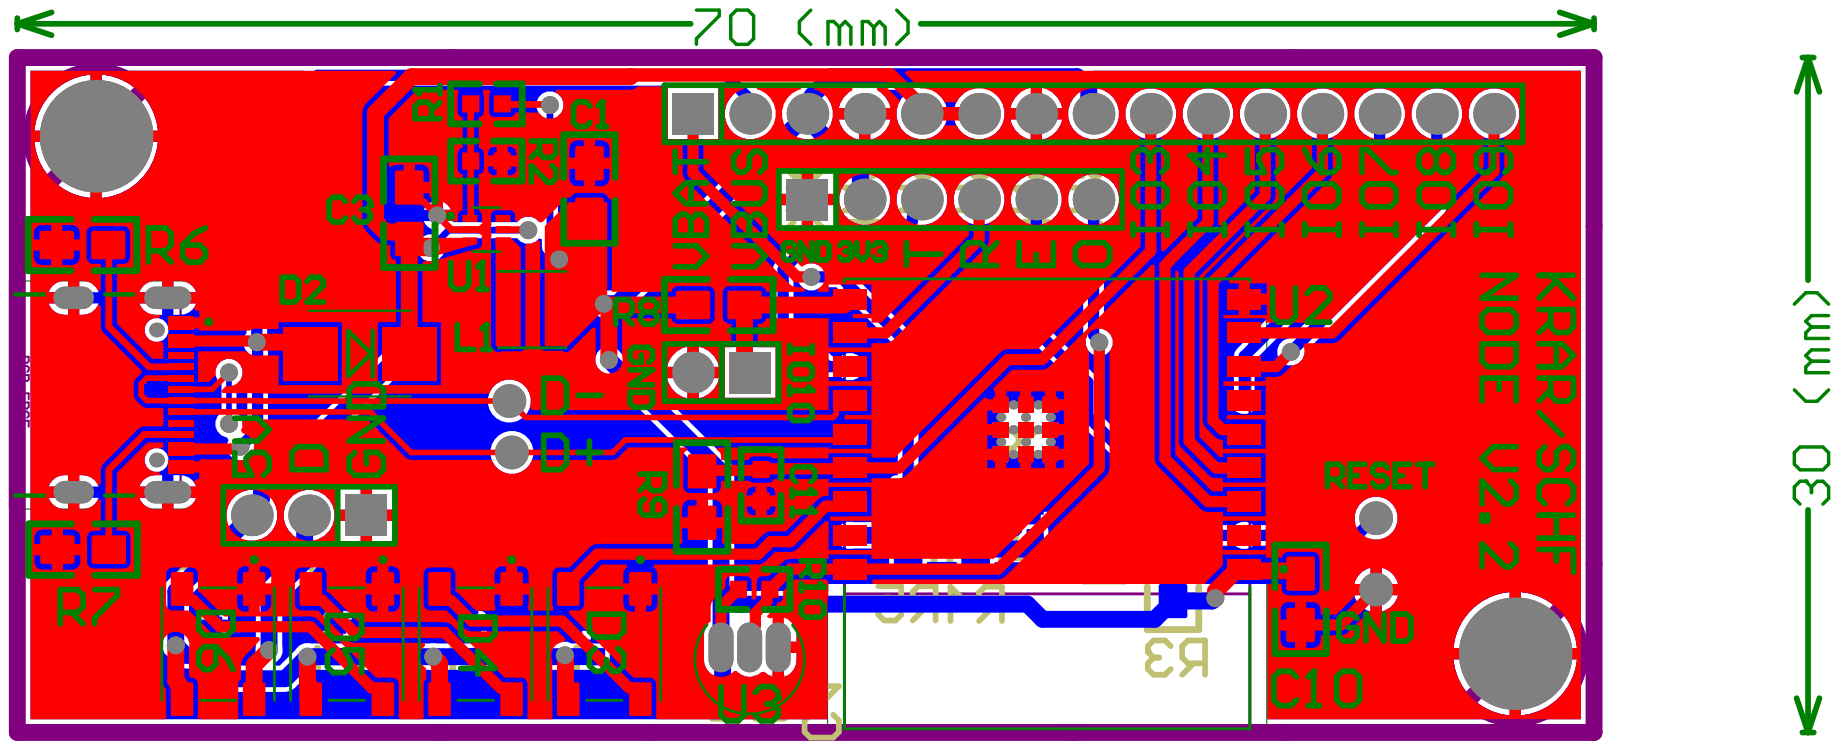
[picture p223: page 2]
