SeriousHarlequin/FaRiSmarthome/Labor-Project/HW/Control-Panel/Control-Panel_V1.1.pdf

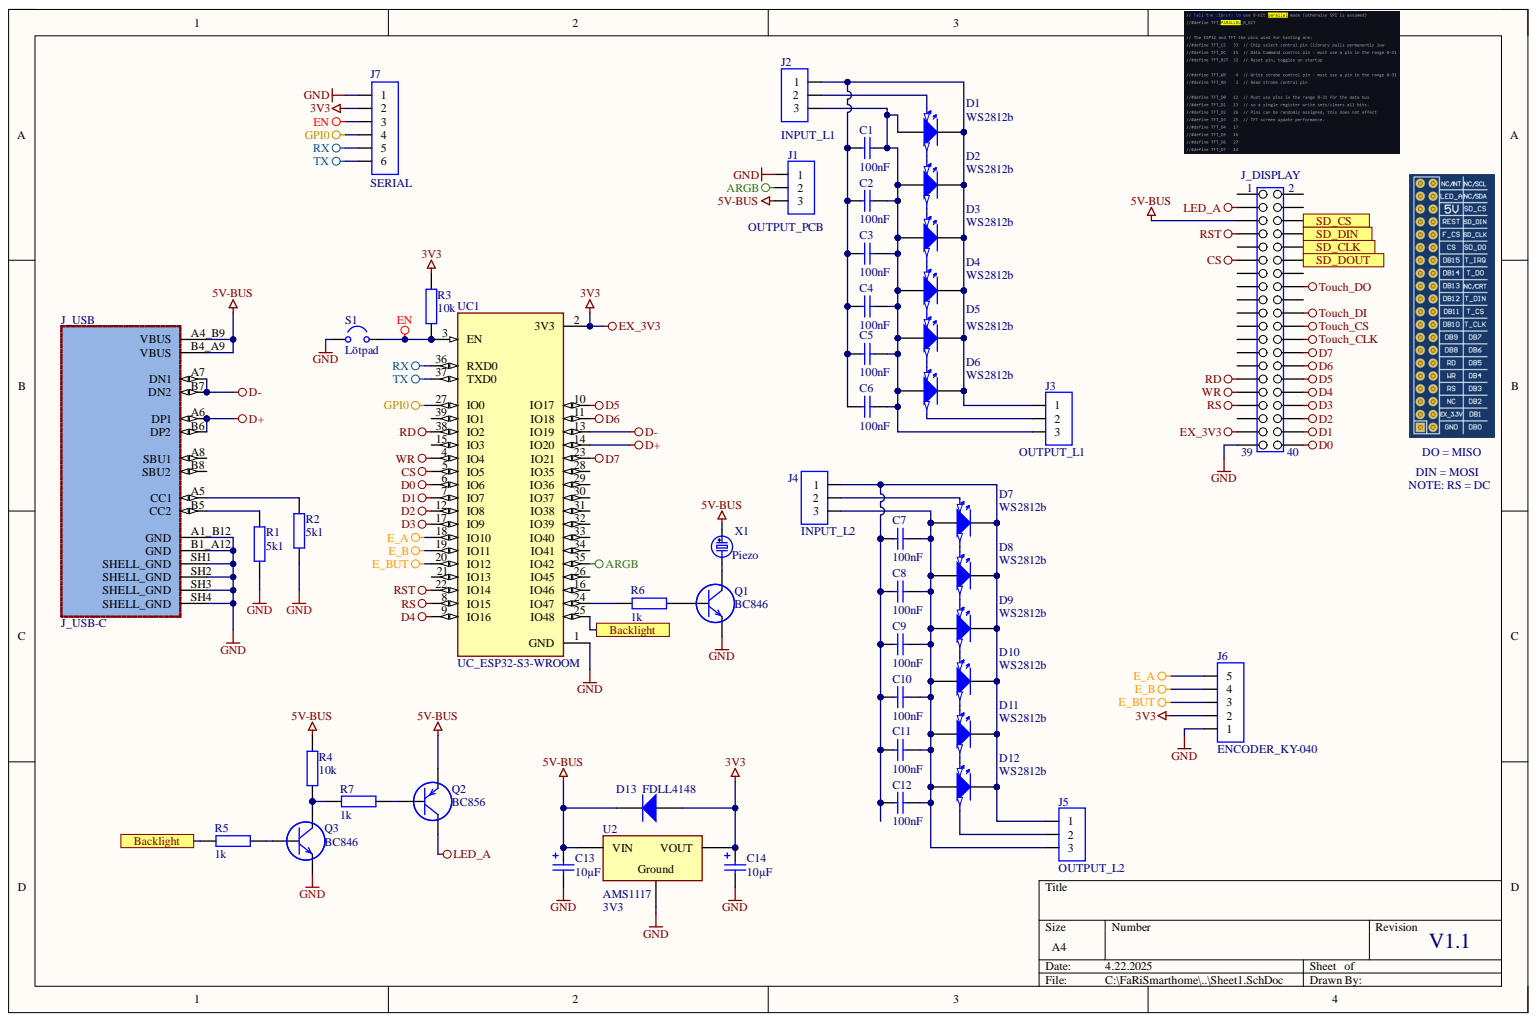
[picture p224: page 1]

DIN = MOSI DO = MISO
