SeriousHarlequin/FaRiSmarthome/HW-Module/BATTERY/PDF/PCB_V2.2-BOT.pdf

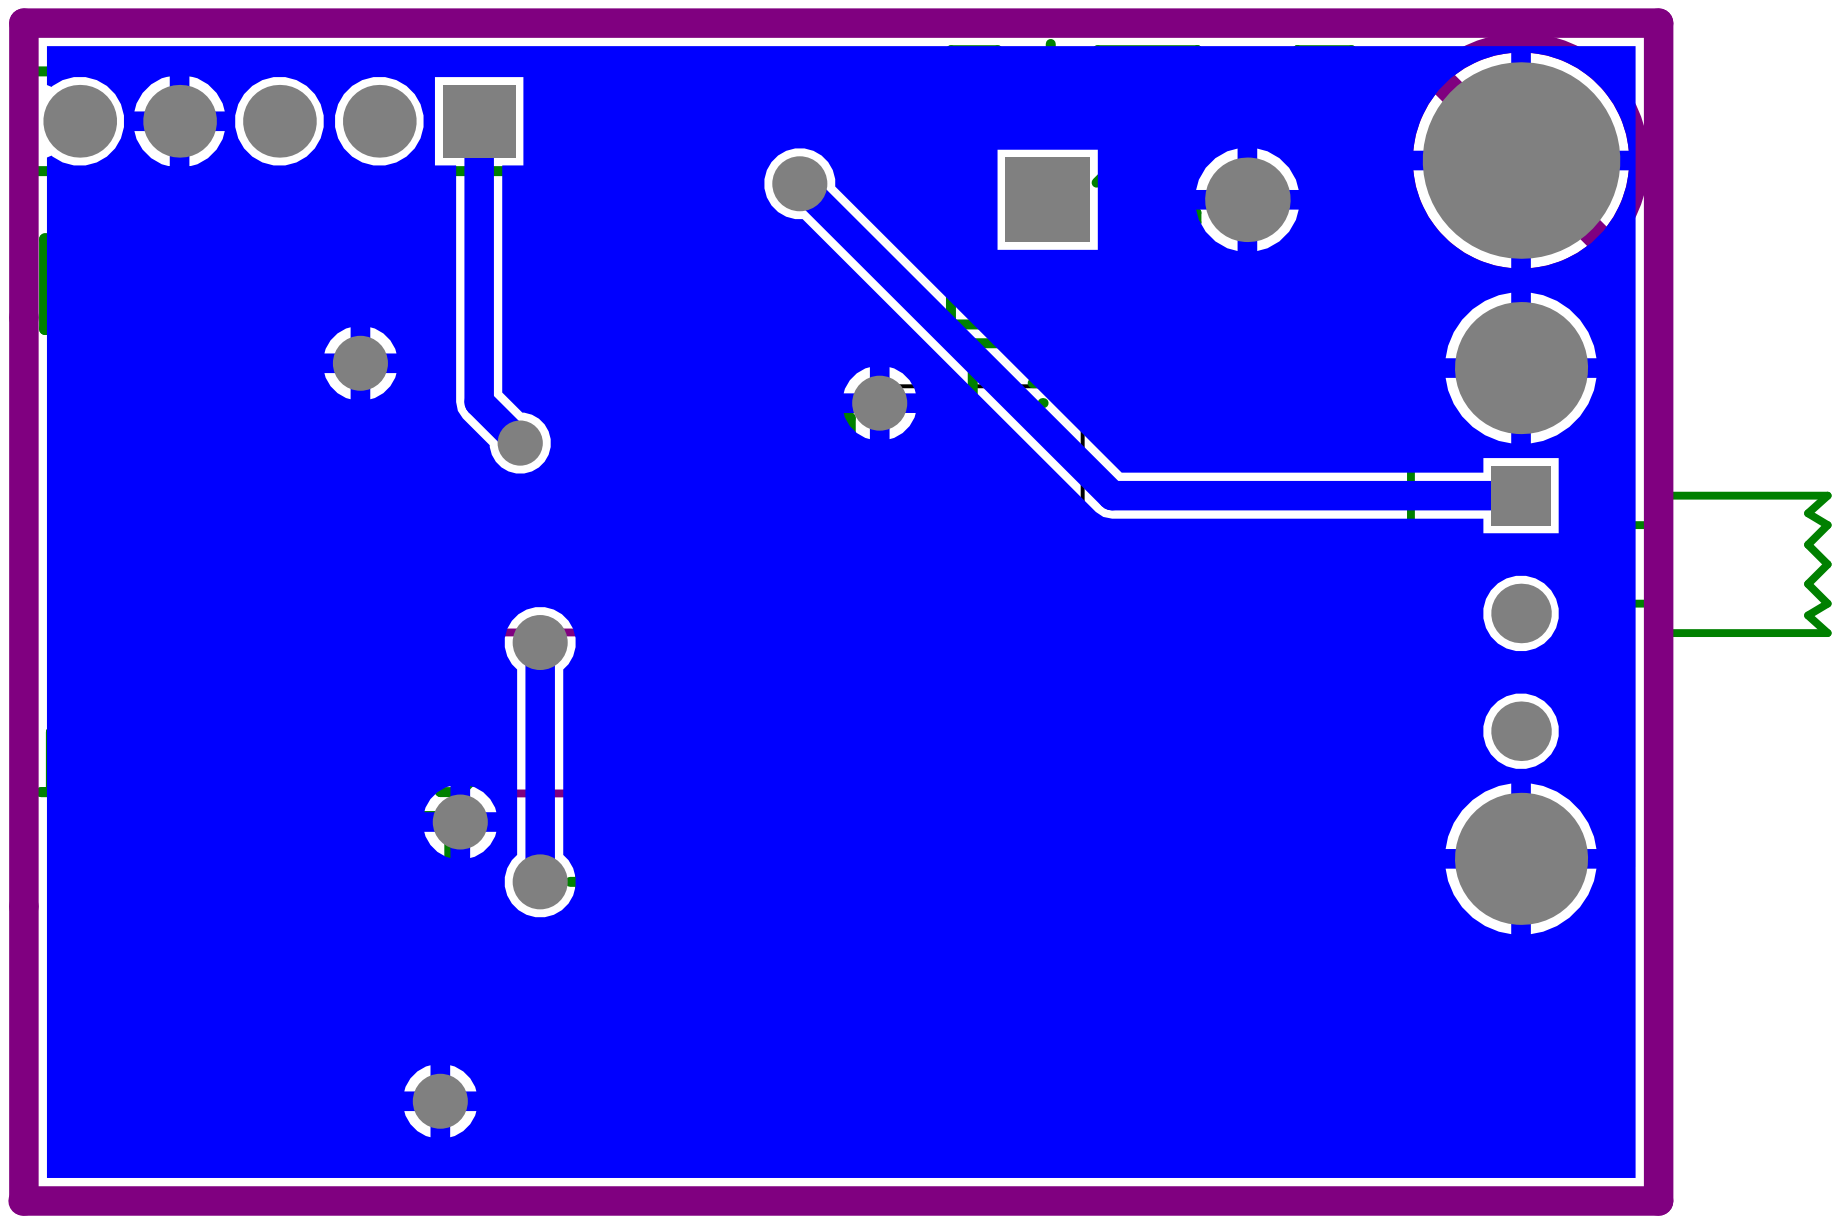
[picture p225: page 1]
