SeriousHarlequin/FaRiSmarthome/HW-Module/BATTERY/PDF/PCB_V2.2-TOP.pdf

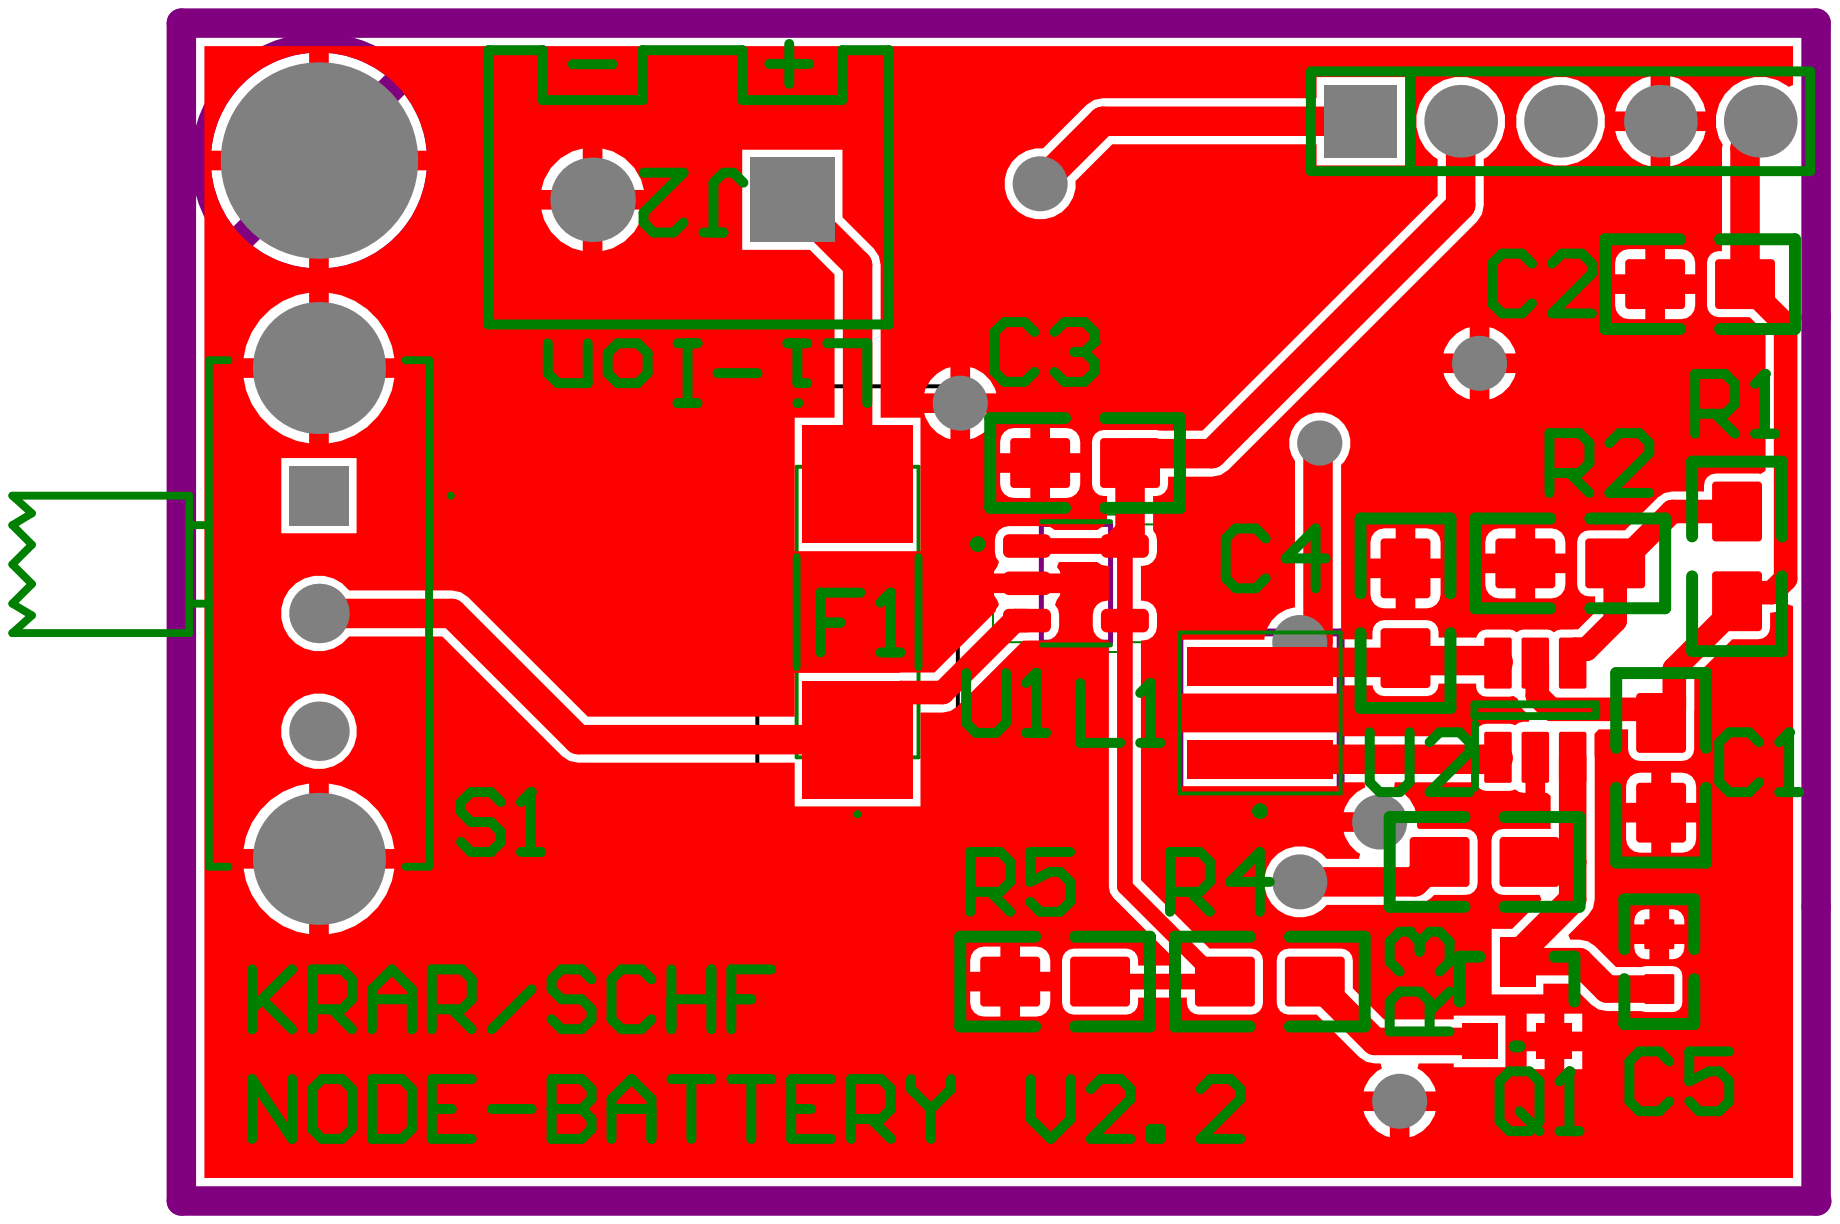
[picture p226: page 1]
