SeriousHarlequin/FaRiSmarthome/HW-Module/MOTION_DETECTION/PDF/PCB_V1.1-BOT.pdf

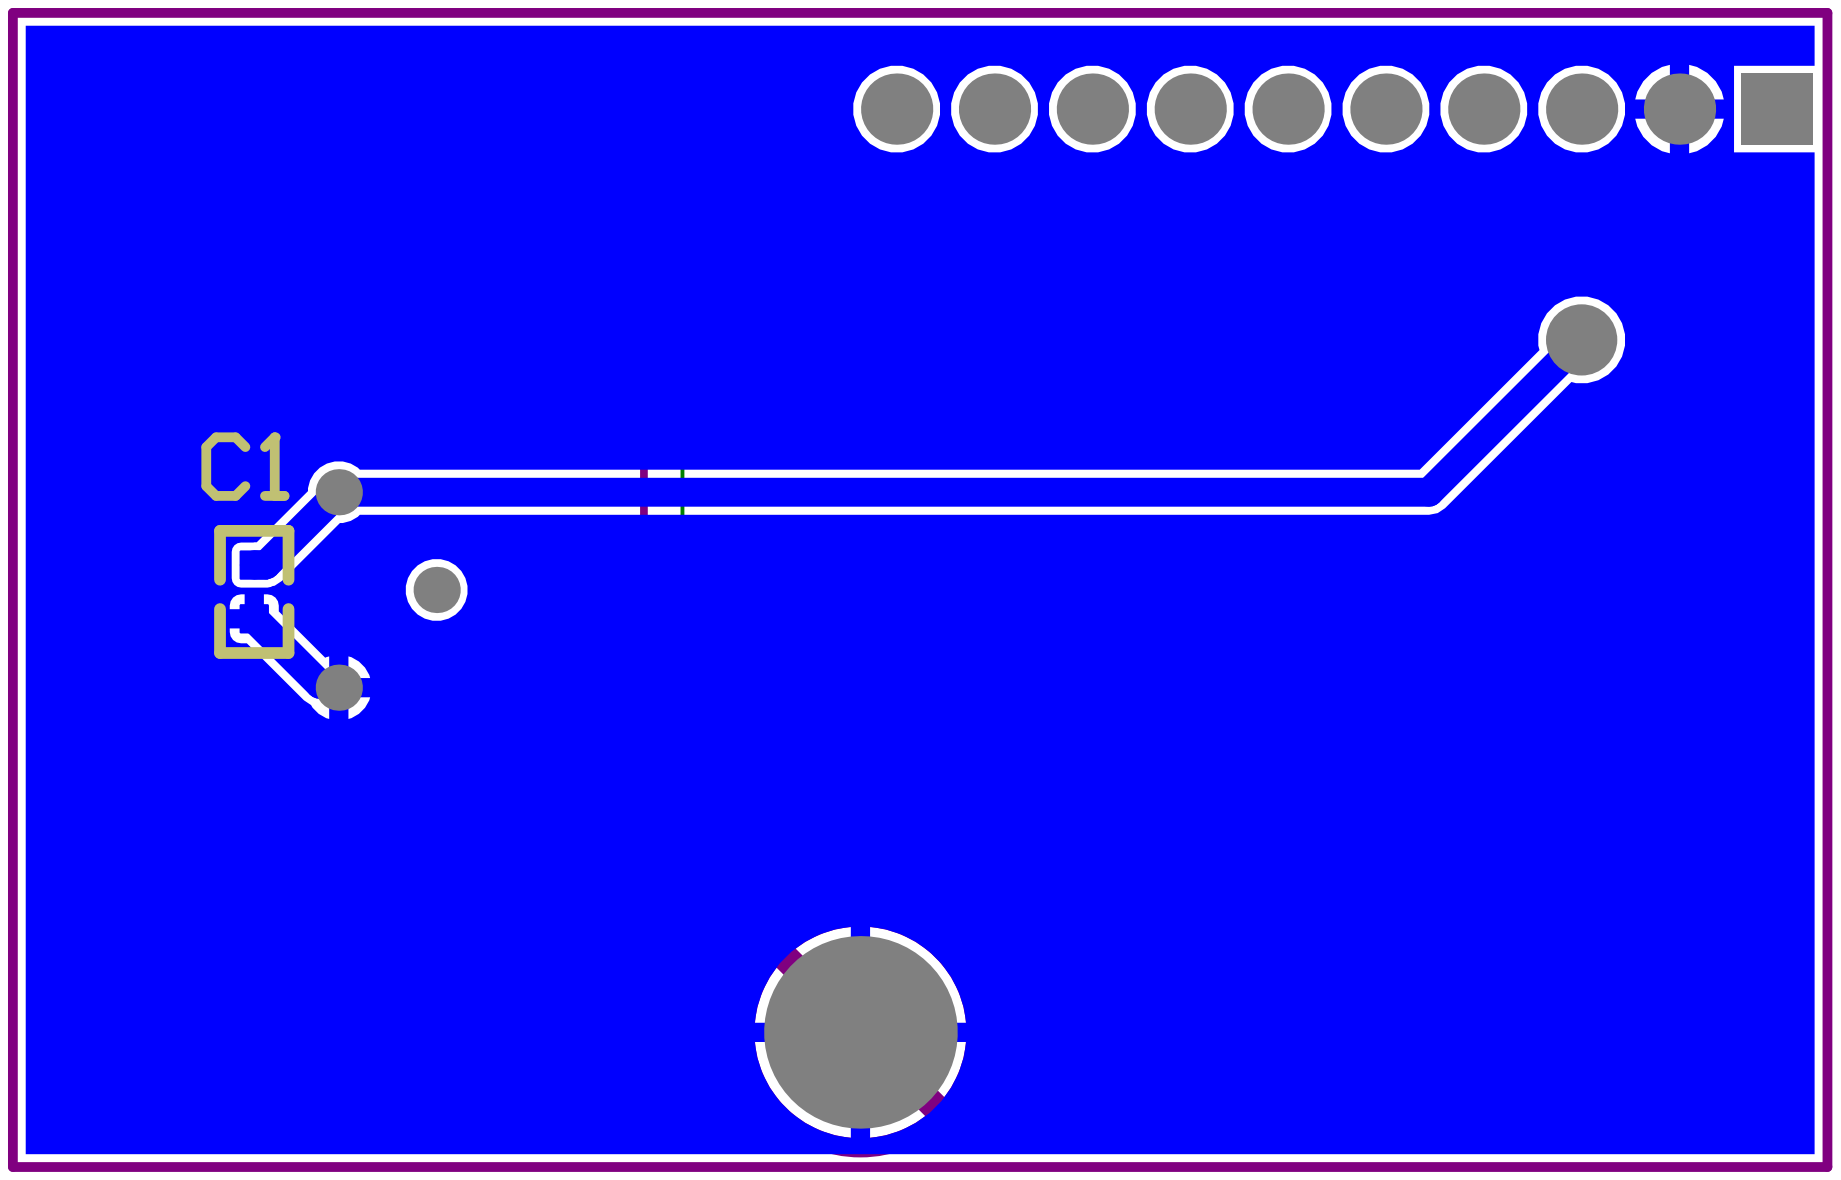
[picture p227: page 1]
