SeriousHarlequin/FaRiSmarthome/HW-Module/MOTION_DETECTION/PDF/PCB_V1.1-TOP.pdf

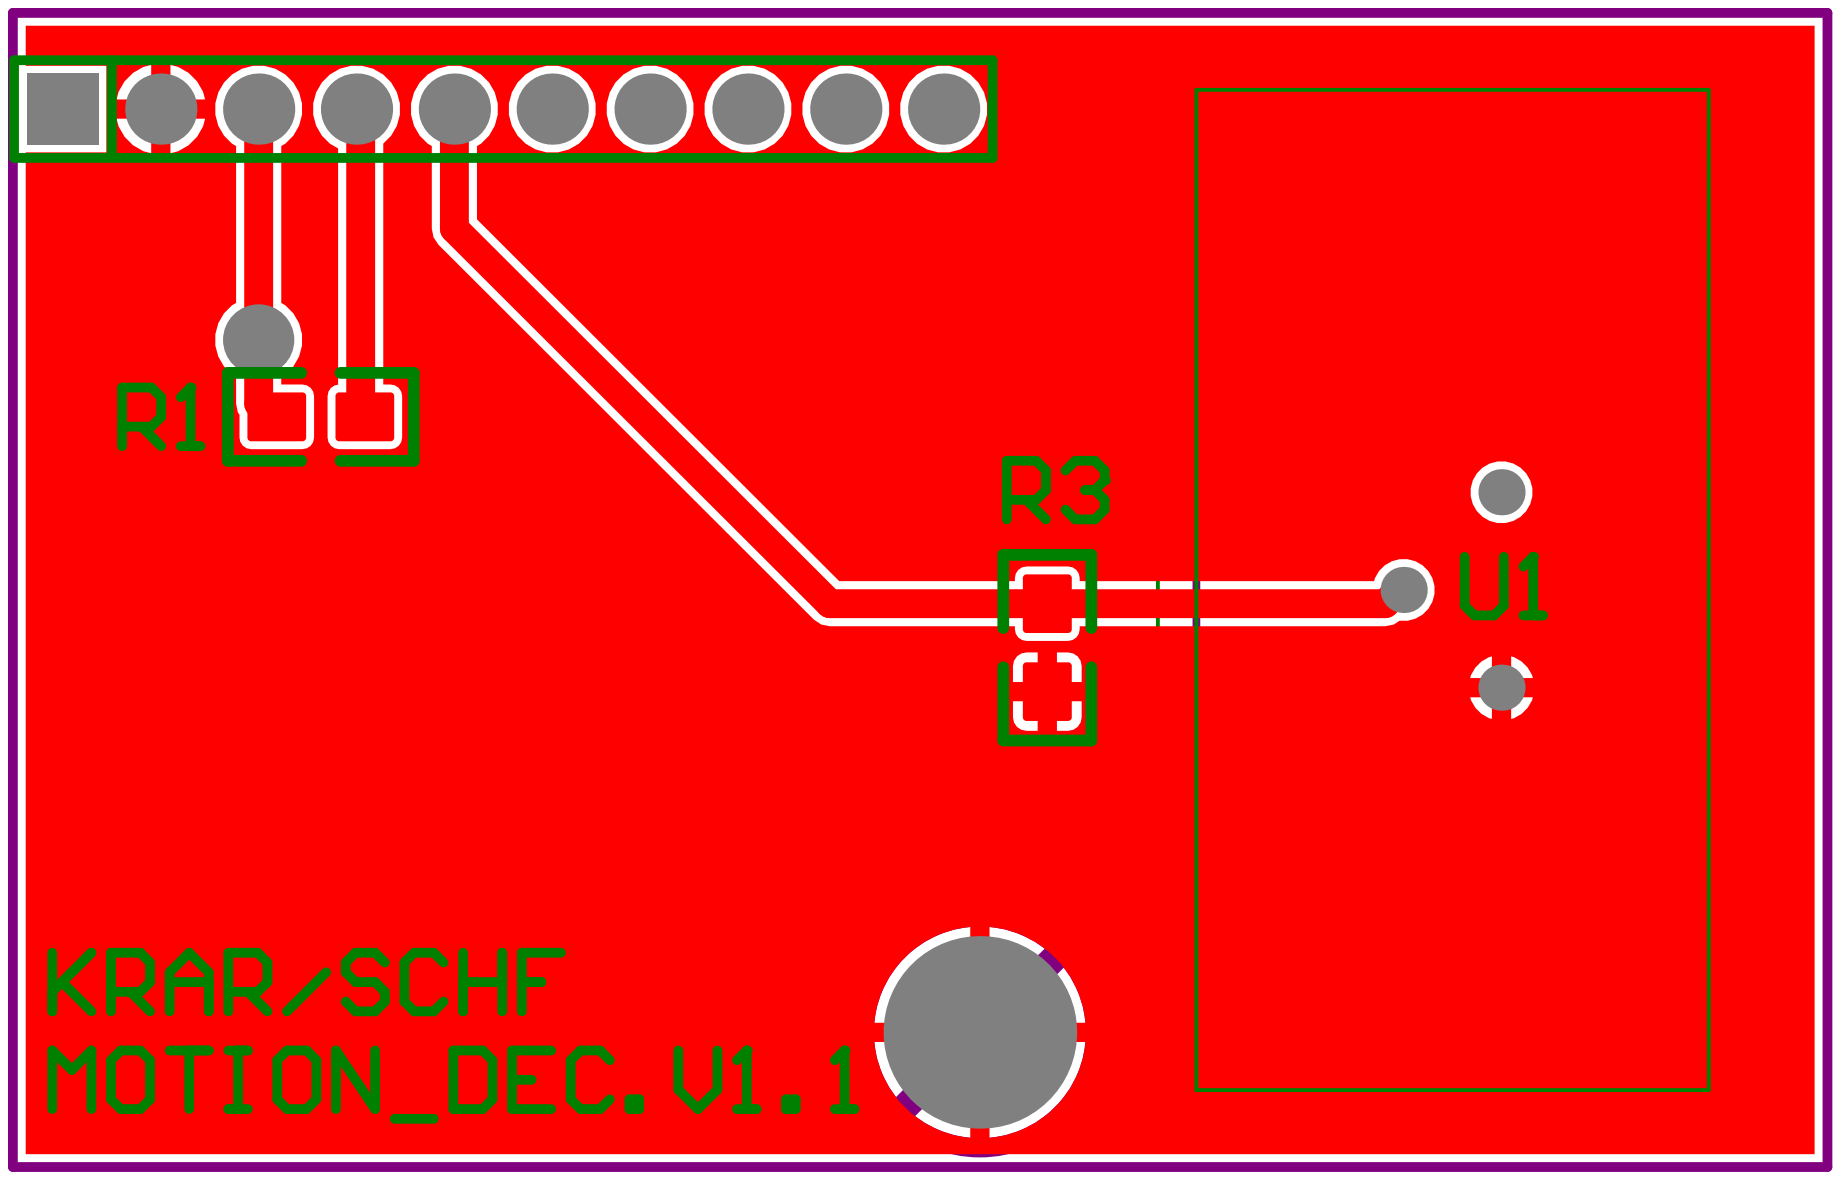
[picture p228: page 1]
