SeriousHarlequin/FaRiSmarthome/HW-Module/NODE/PDF/PCB_V2.2-BOT.pdf

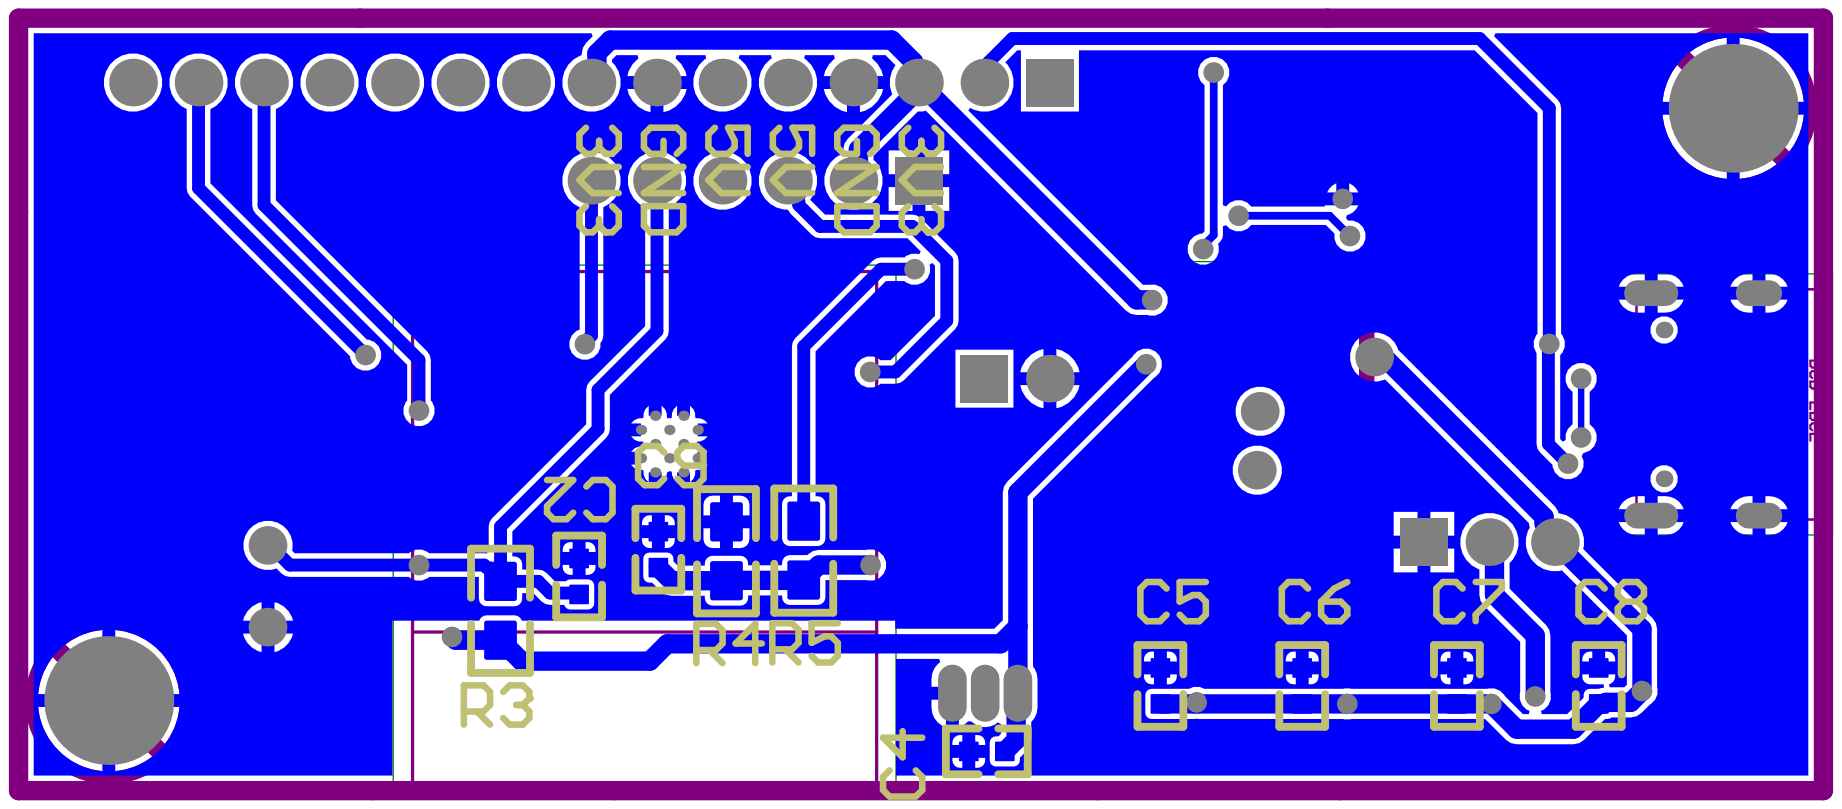
[picture p229: page 1]
