SeriousHarlequin/FaRiSmarthome/HW-Module/NODE/PDF/PCB_V2.2-TOP.pdf

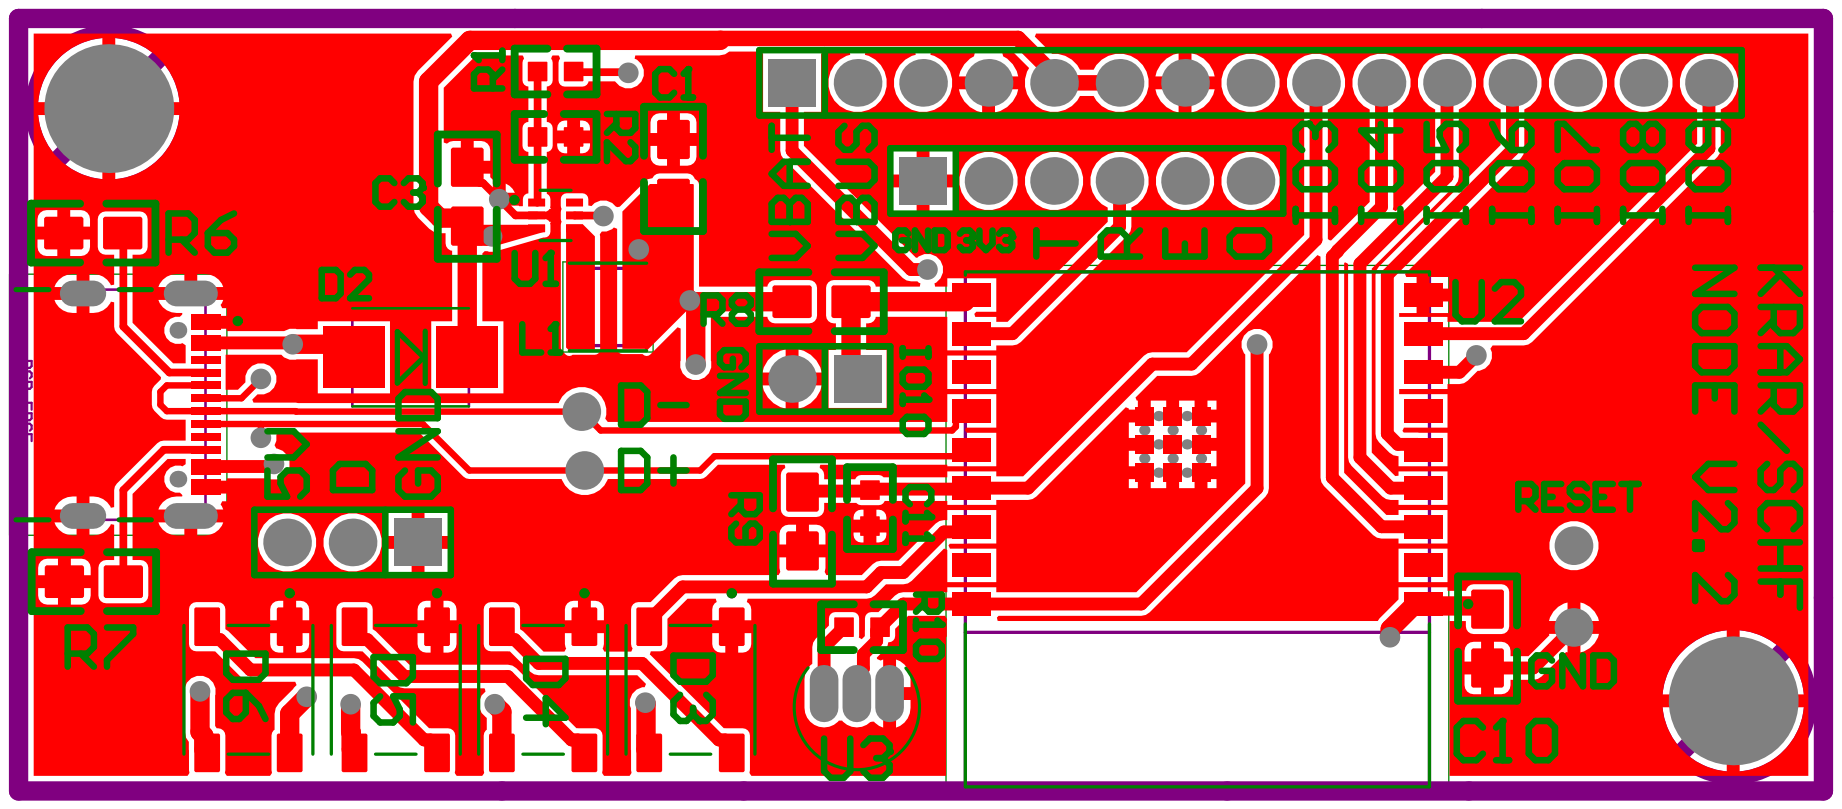
[picture p230: page 1]
