SeriousHarlequin/FaRiSmarthome/HW-Module/SWITCH/PDF/PCB_V1.1-BOT.pdf

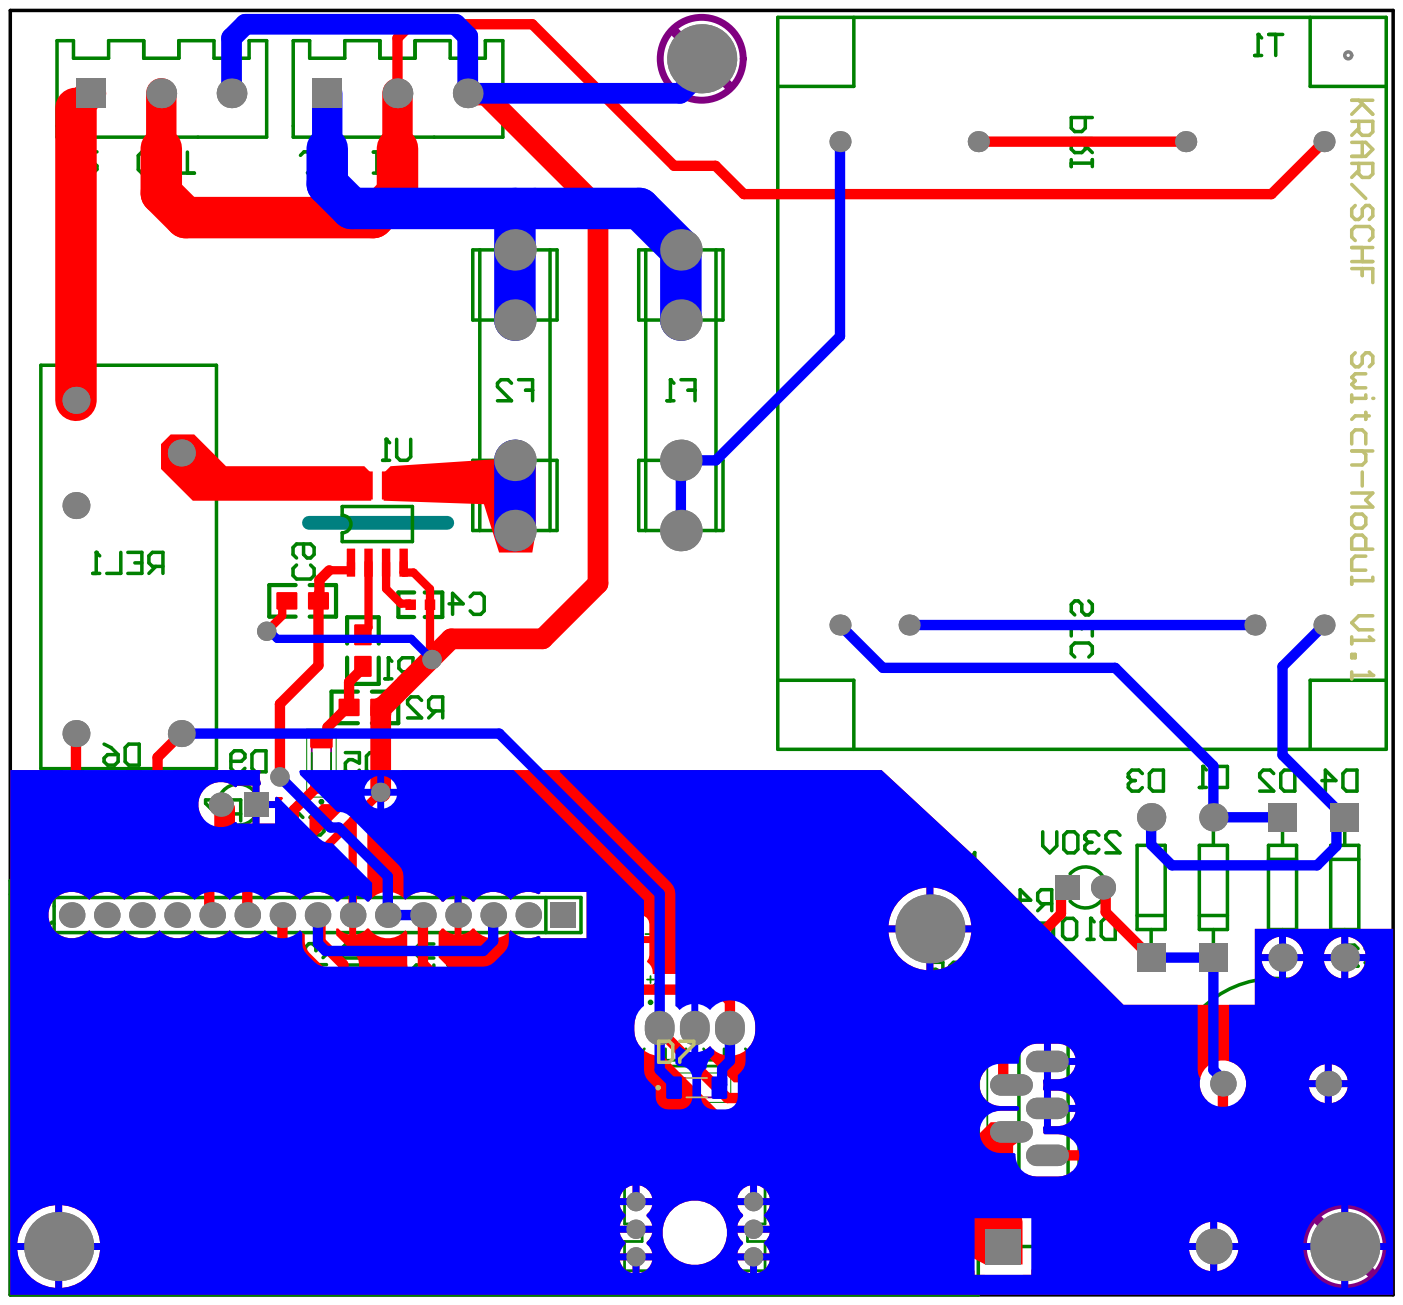
[picture p231: page 1]
