SeriousHarlequin/FaRiSmarthome/HW-Module/SWITCH/PDF/PCB_V1.1-TOP.pdf

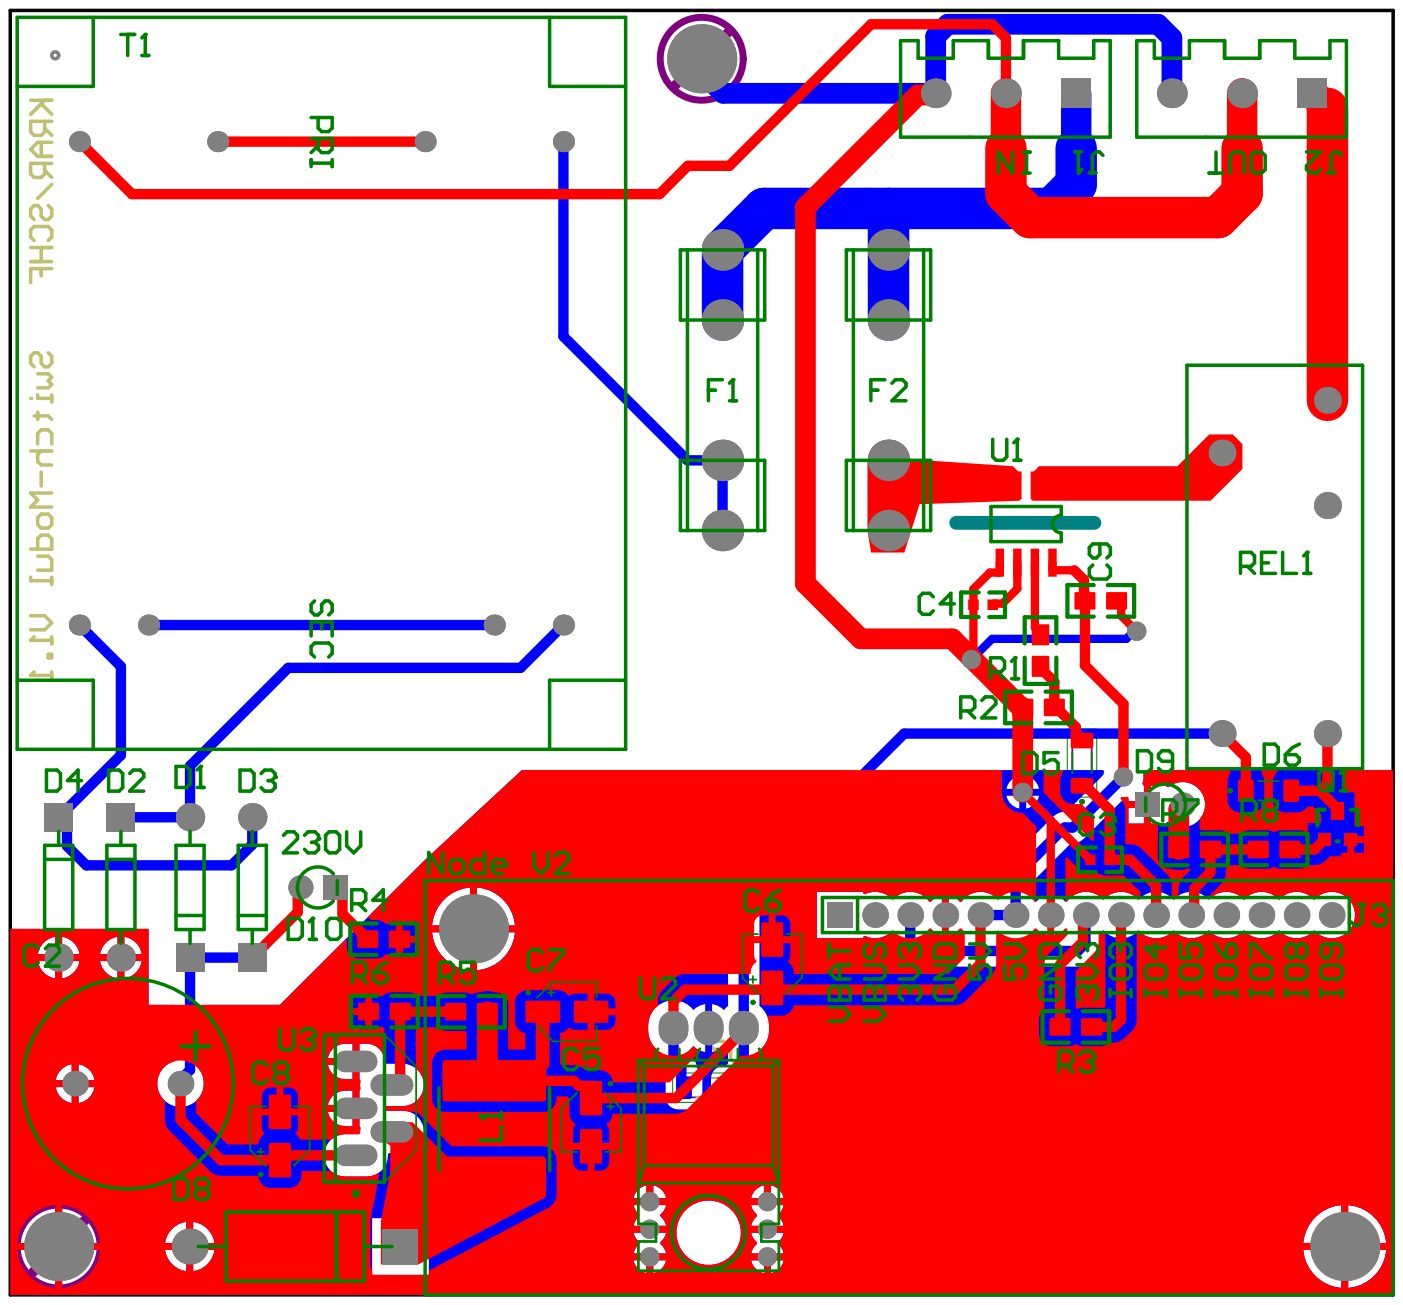
[picture p232: page 1]
