SeriousHarlequin/FaRiSmarthome/Labor-Project/HW/Control-Panel/PCB1.pdf

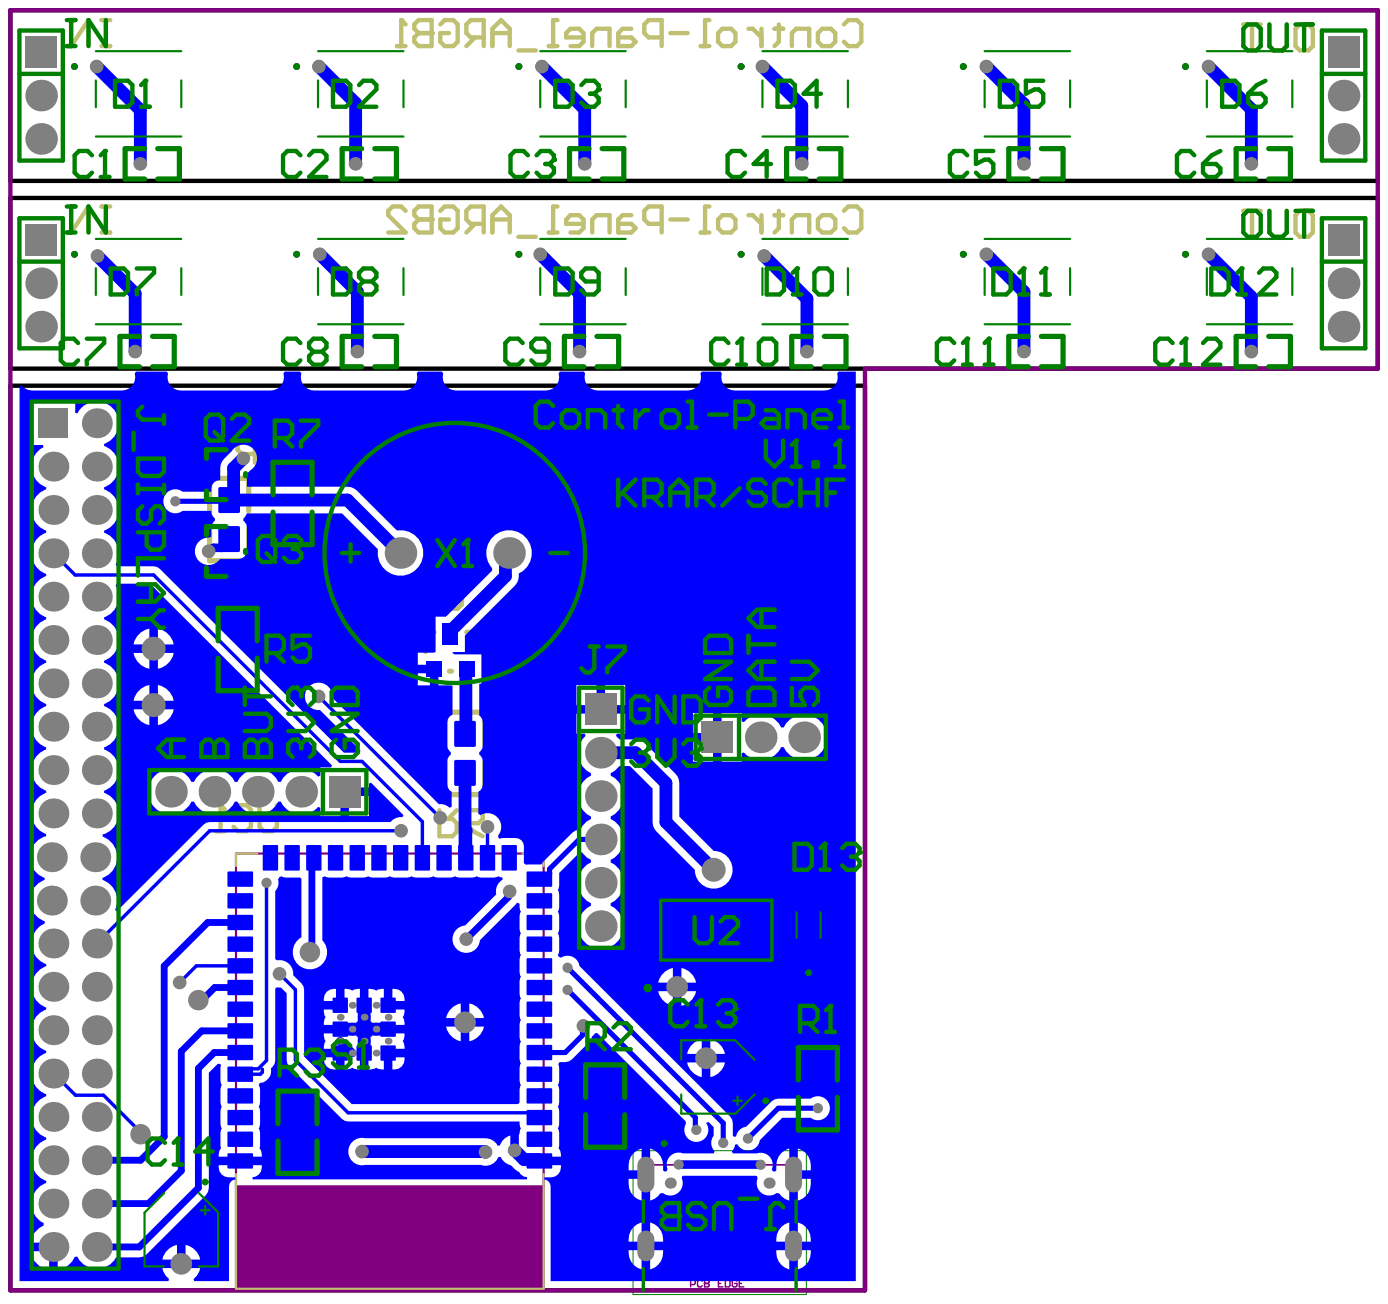
[picture p233: page 1]
