SeriousHarlequin/FaRiSmarthome/Labor-Project/HW/Control-Panel/PCB1_BOT.pdf

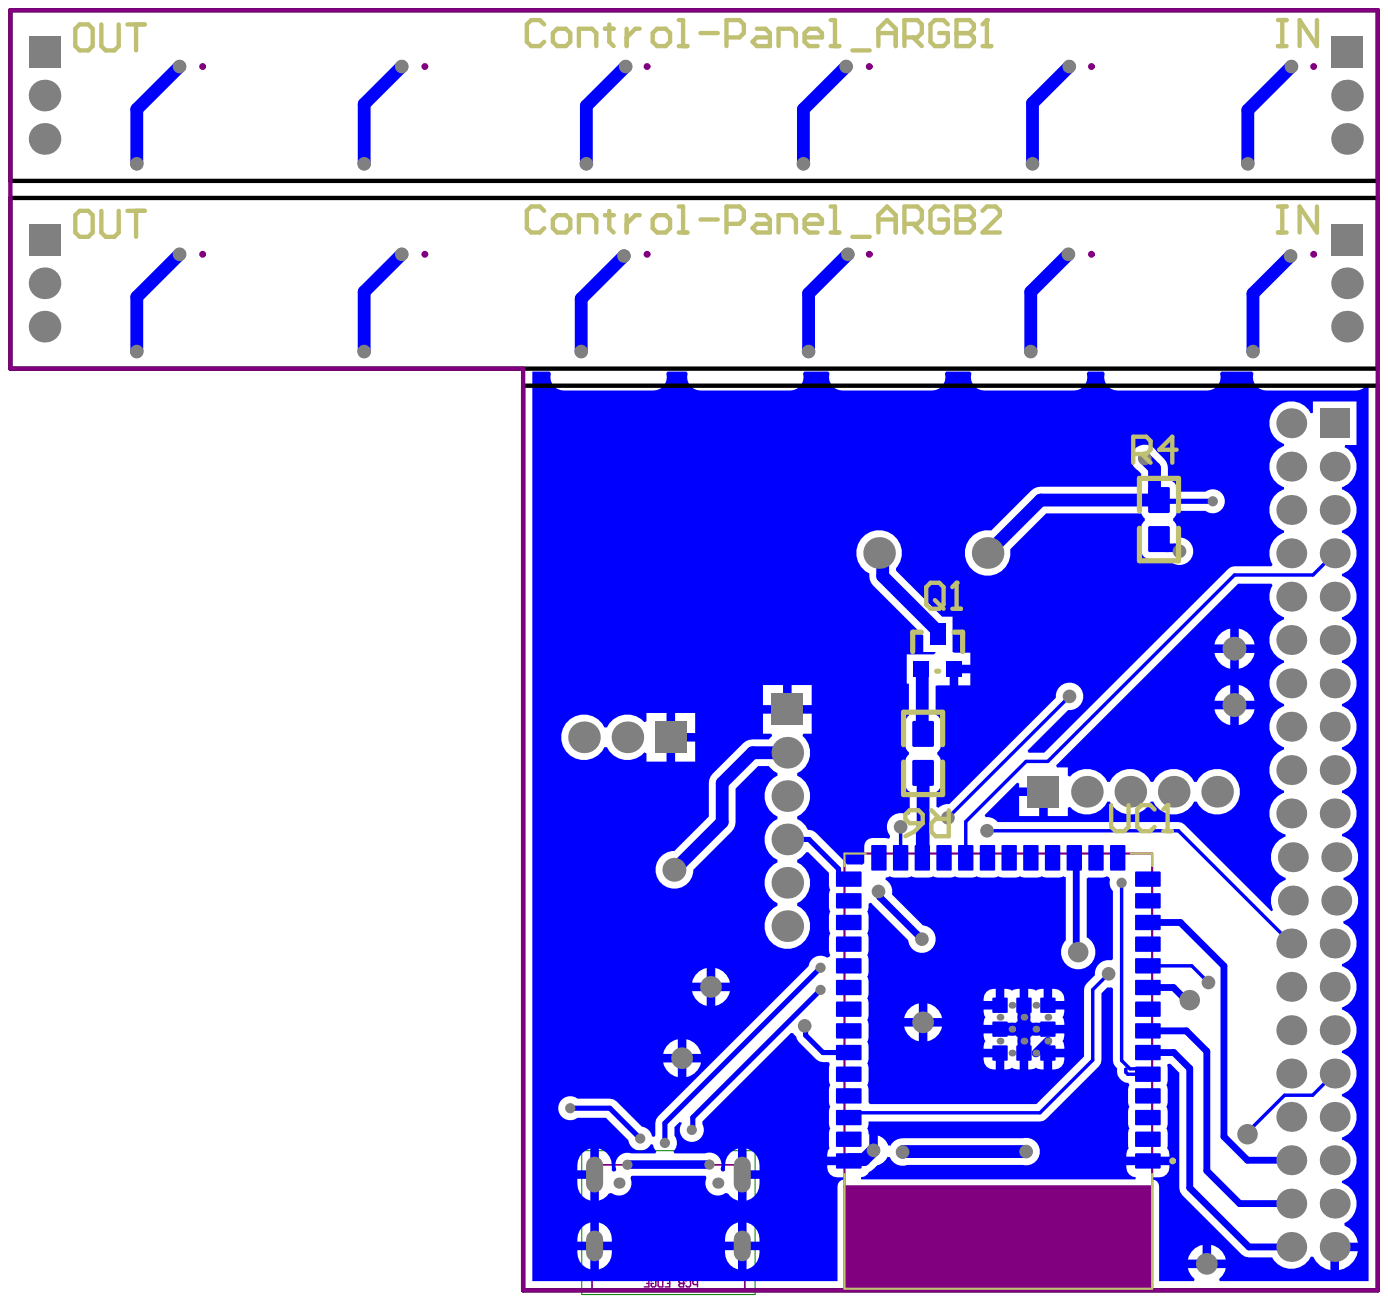
[picture p234: page 1]
