SeriousHarlequin/FaRiSmarthome/Labor-Project/HW/Control-Panel/PCB1_TOP.pdf

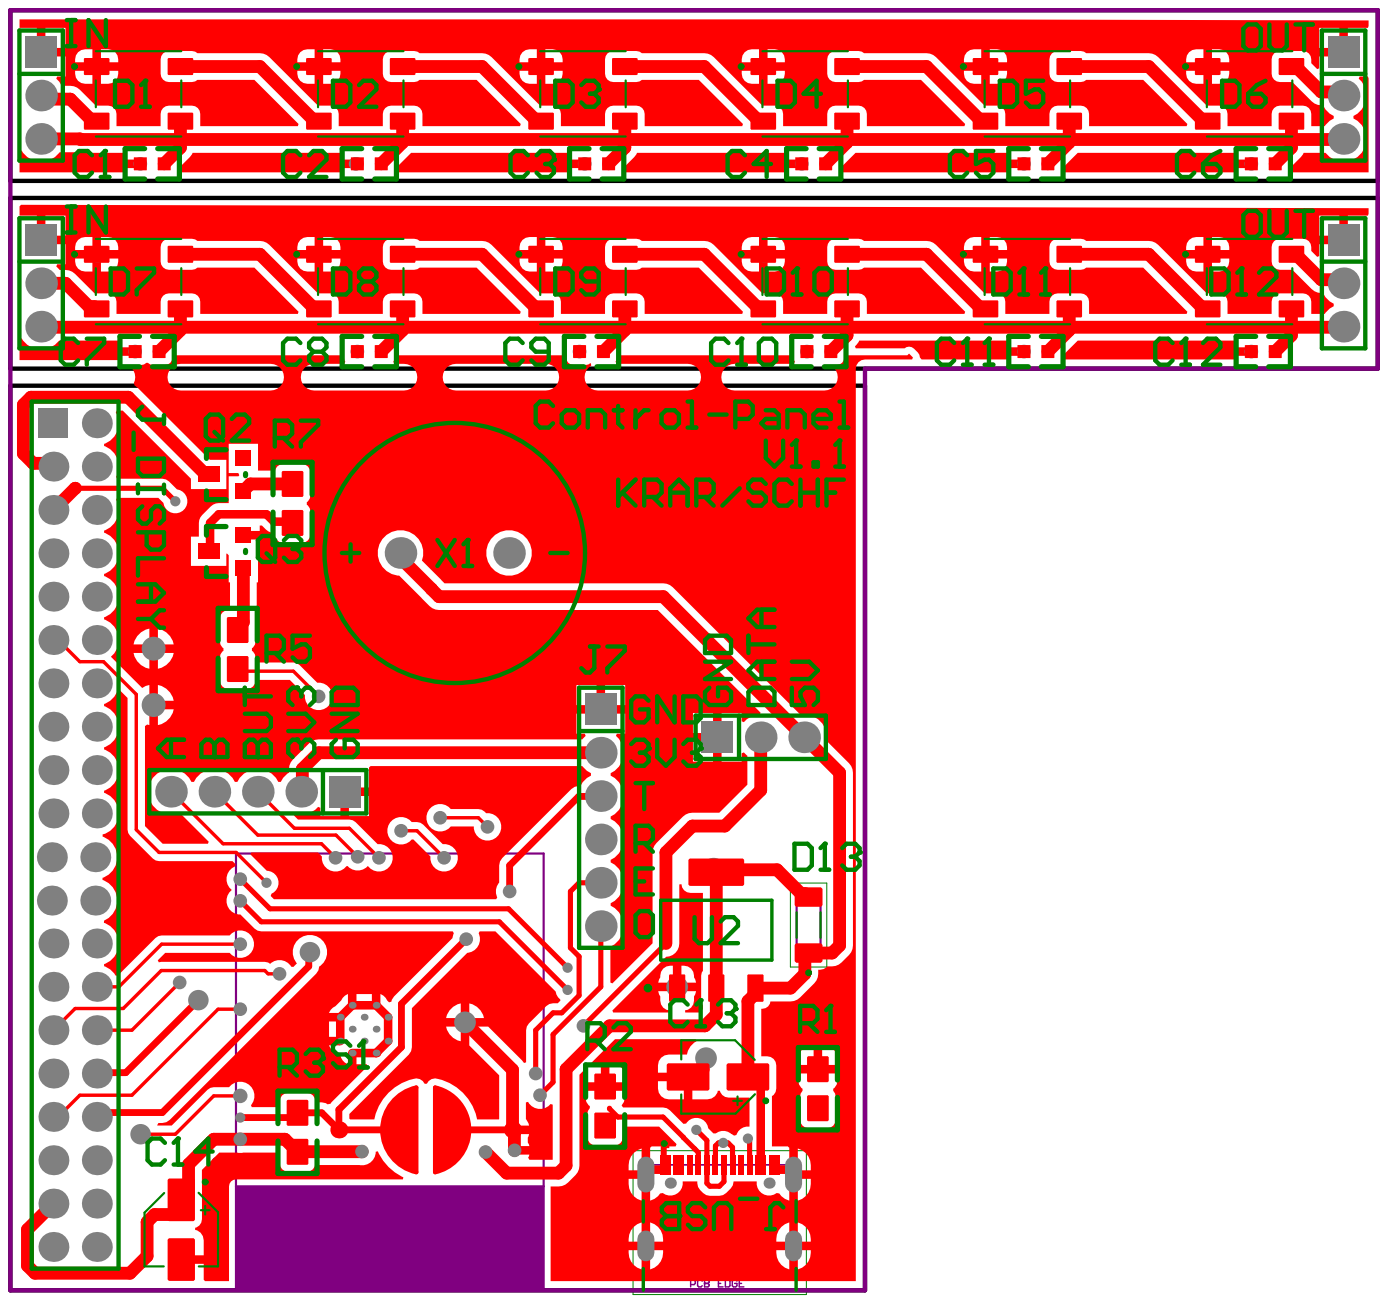
[picture p235: page 1]
