SeriousHarlequin/FaRiSmarthome/HW-Module/PDF-all_schematics/BATTERY-V2.1.pdf

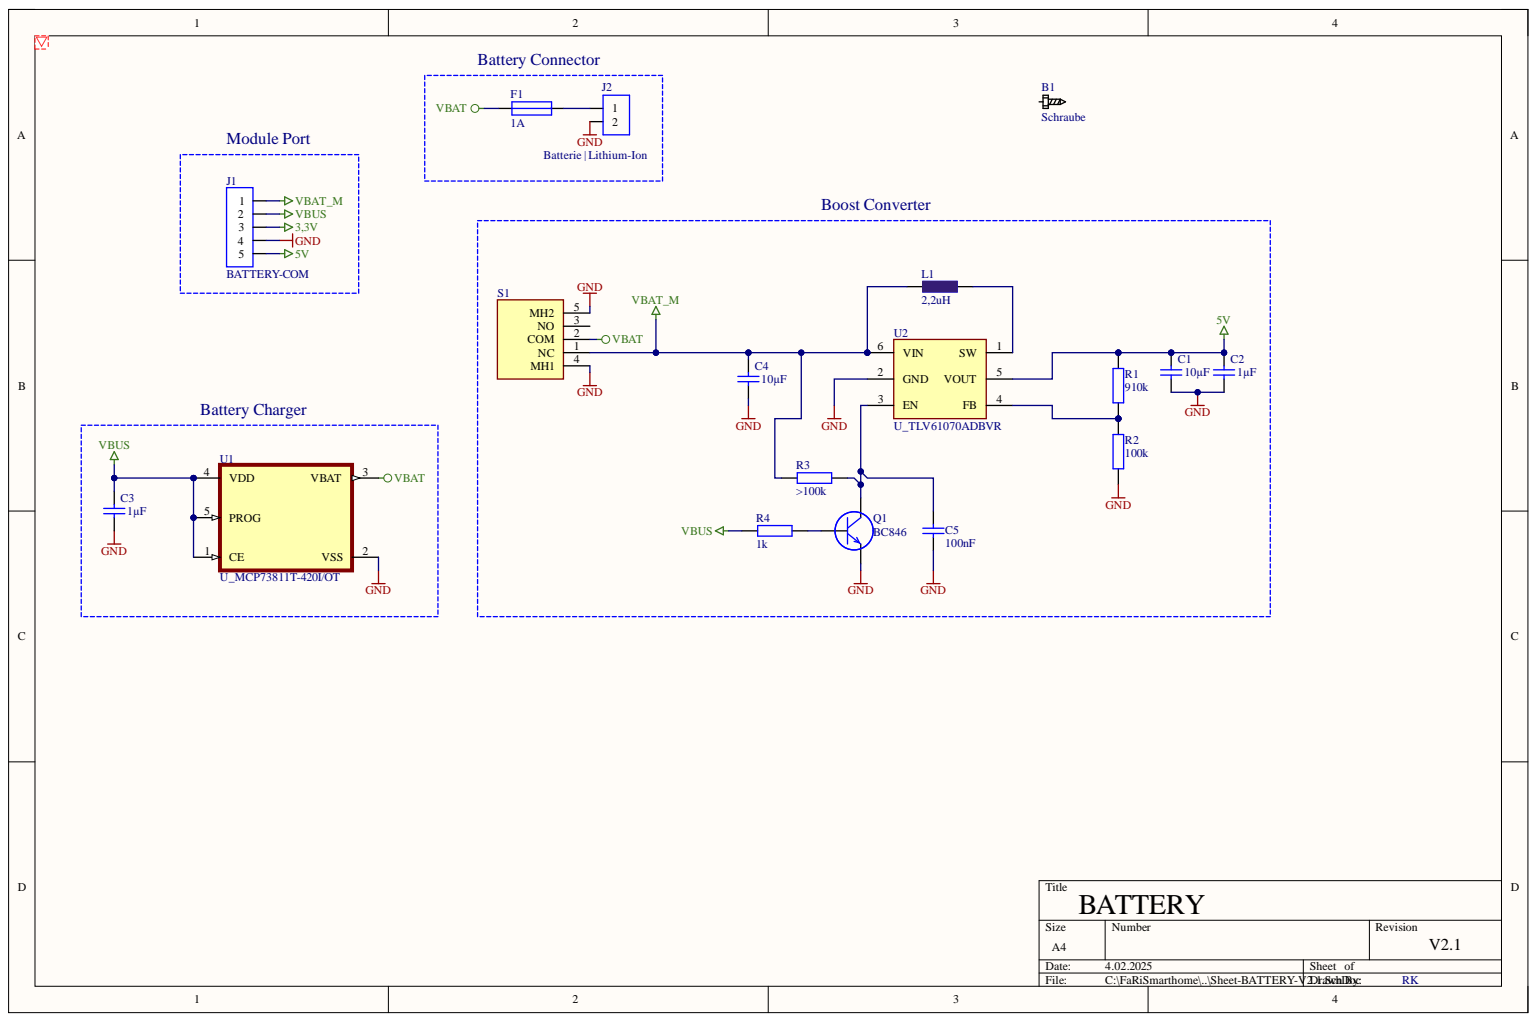
[picture p236: page 1]
