SeriousHarlequin/FaRiSmarthome/HW-Module/PDF-all_schematics/Motion-V1.0.pdf

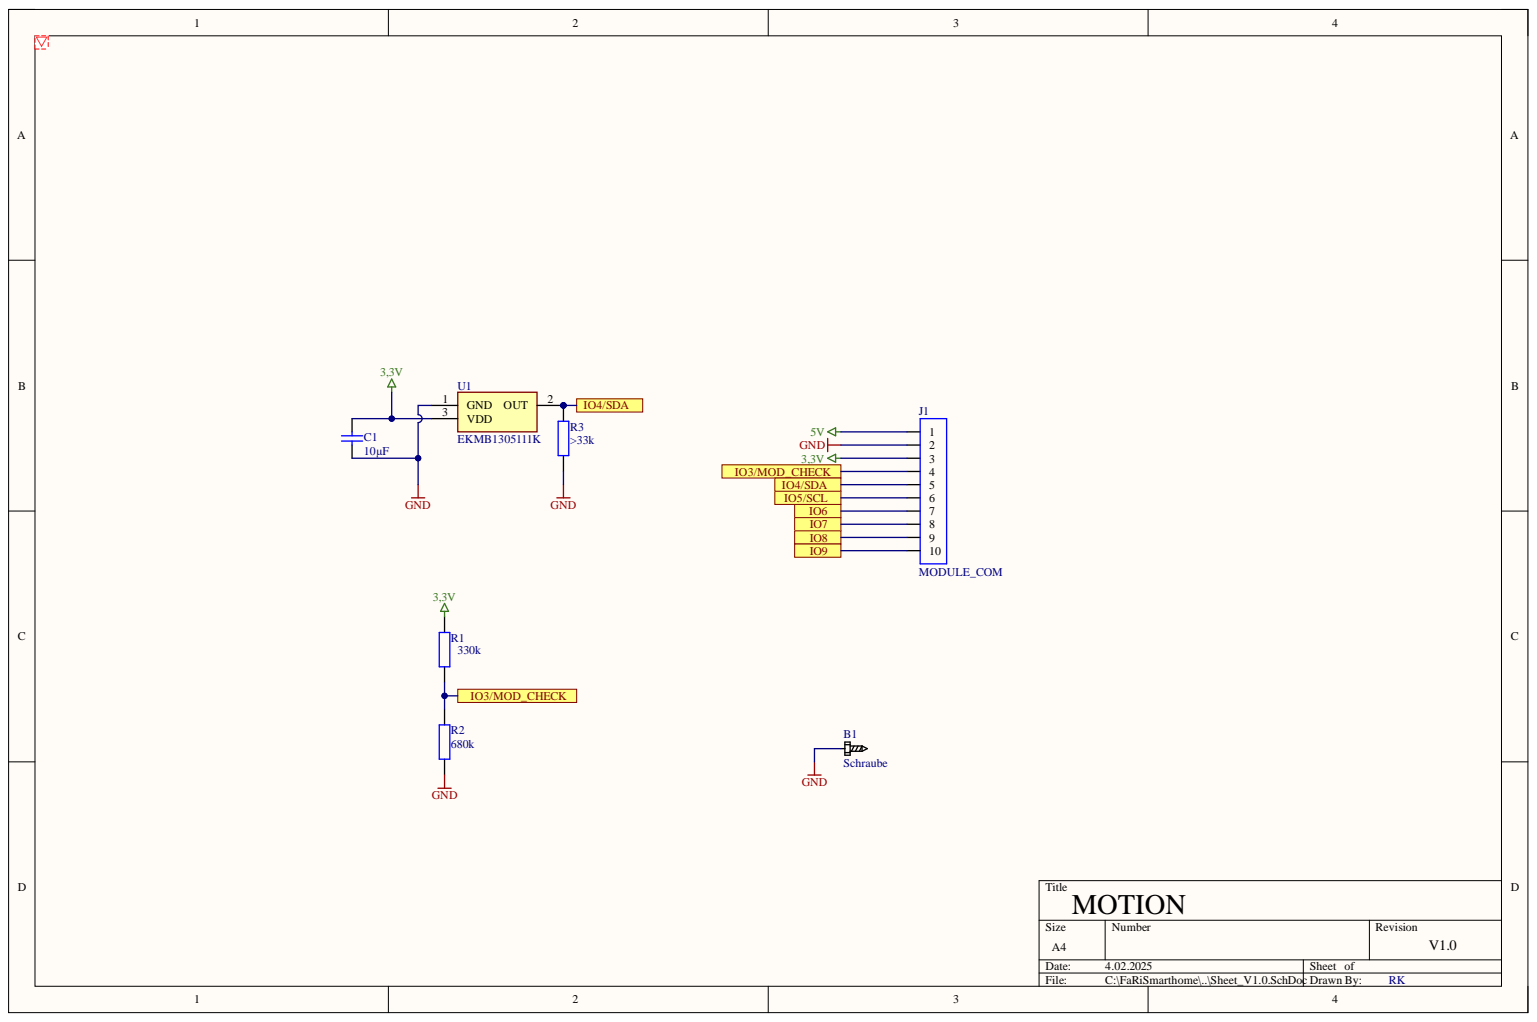
[picture p237: page 1]
