SeriousHarlequin/FaRiSmarthome/HW-Module/PDF-all_schematics/SWITCH-V1.0.pdf

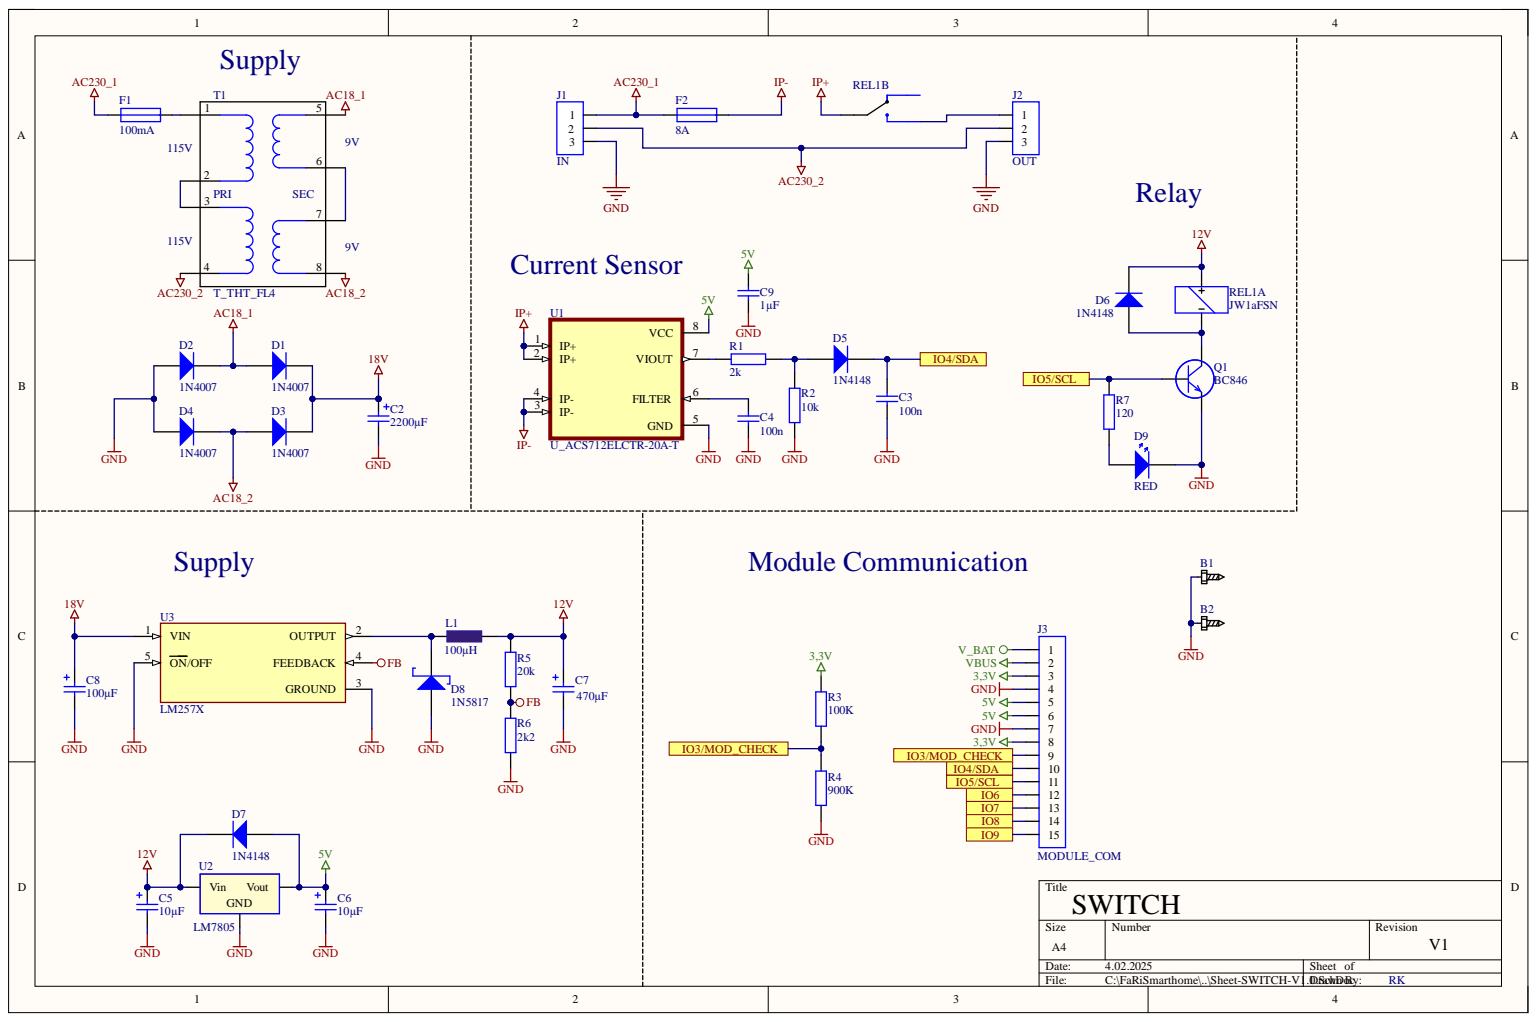
[picture p238: page 1]
