SeriousHarlequin/FaRiSmarthome/HW-Module/PDF-all_schematics/NODE-V1.0.pdf

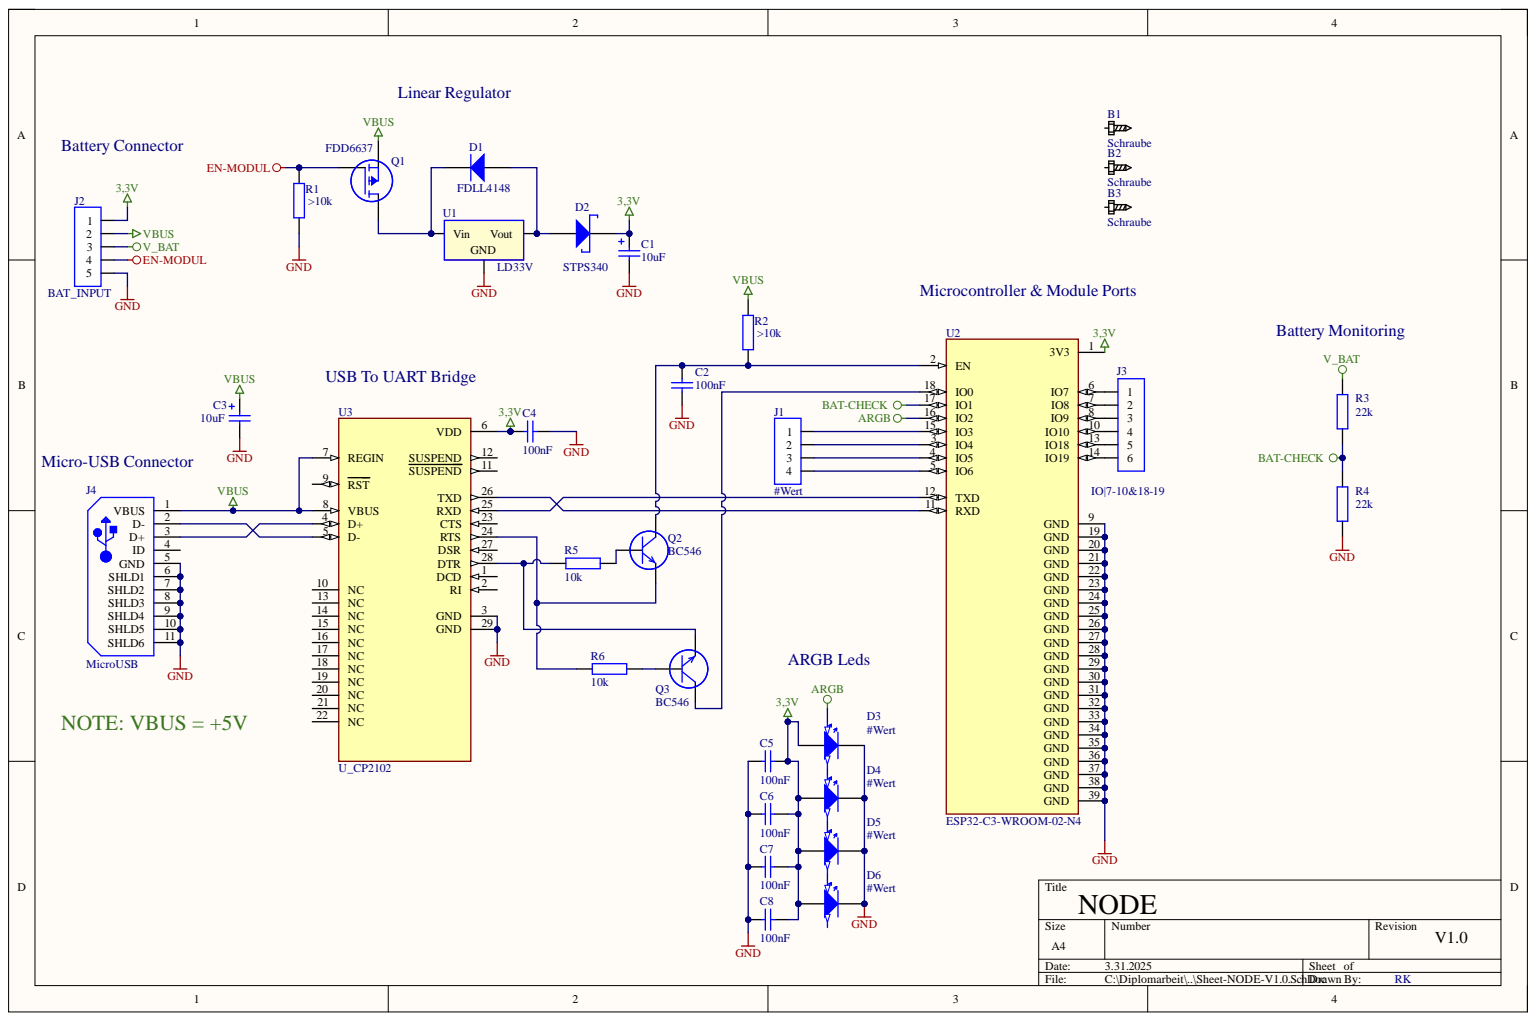
[picture p239: page 1]

BAT-CH E C K J | 1 7 1 6 1 5 | | 7
