SeriousHarlequin/FaRiSmarthome/HW-Module/PDF-all_schematics/NODE-V1.1.pdf

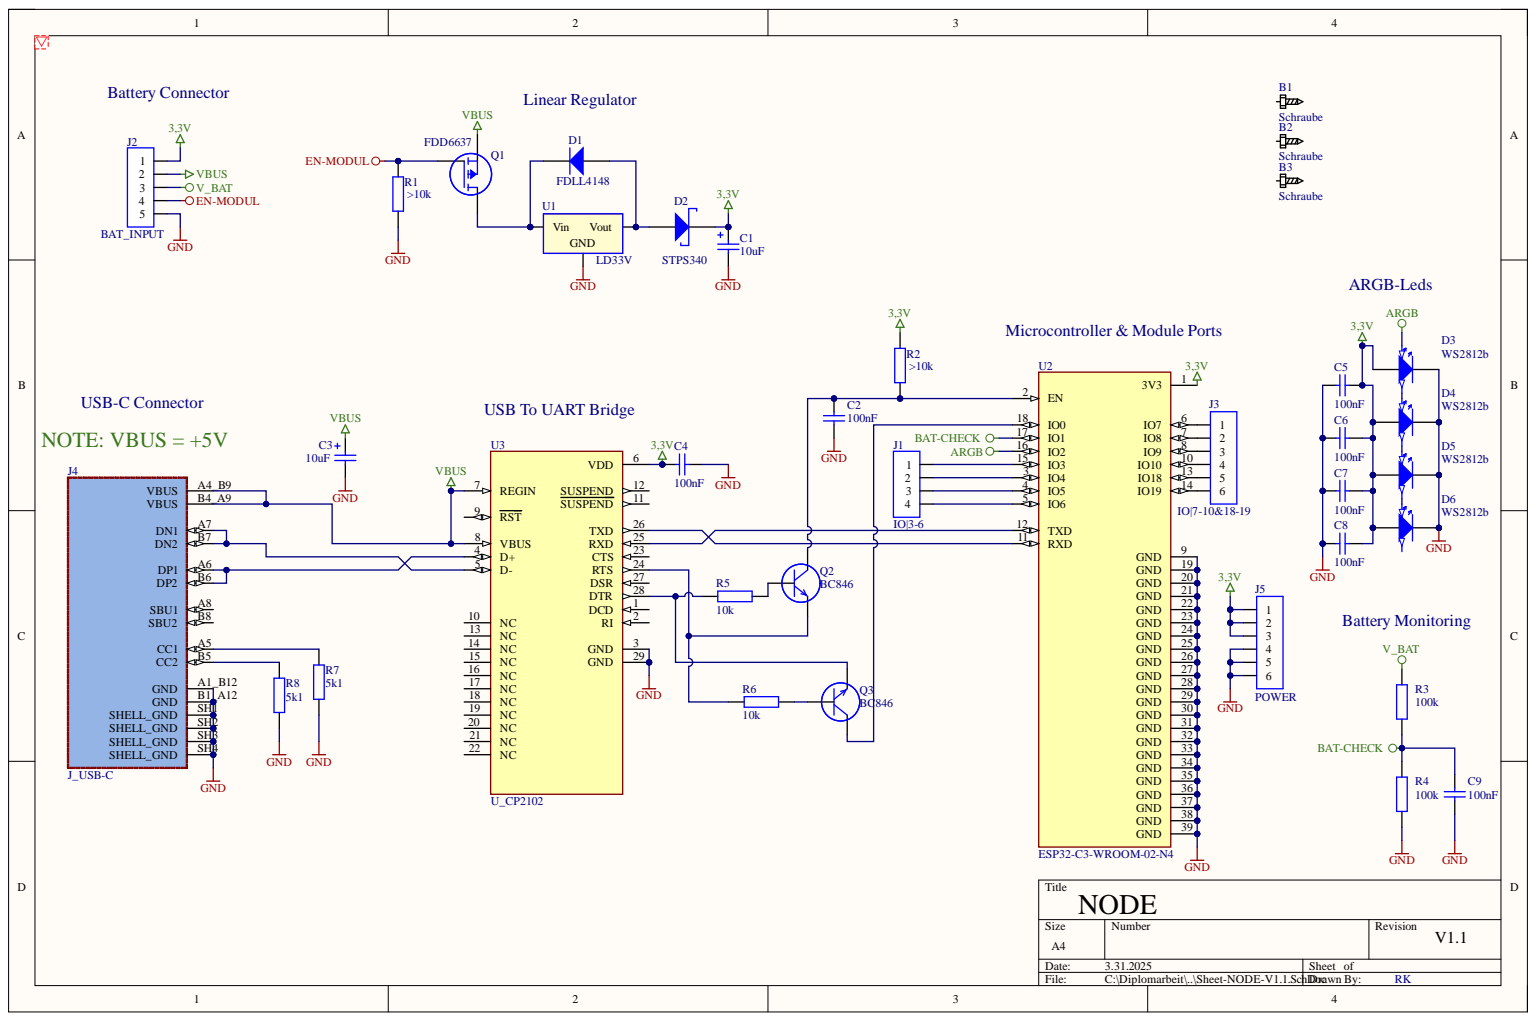
[picture p240: page 1]

n F | 1 8
BAT-CH E C K J 1 | 1 7 1 6 1 5 | | 7
