SeriousHarlequin/FaRiSmarthome/HW-Module/PDF-all_schematics/NODE-V2.0.pdf

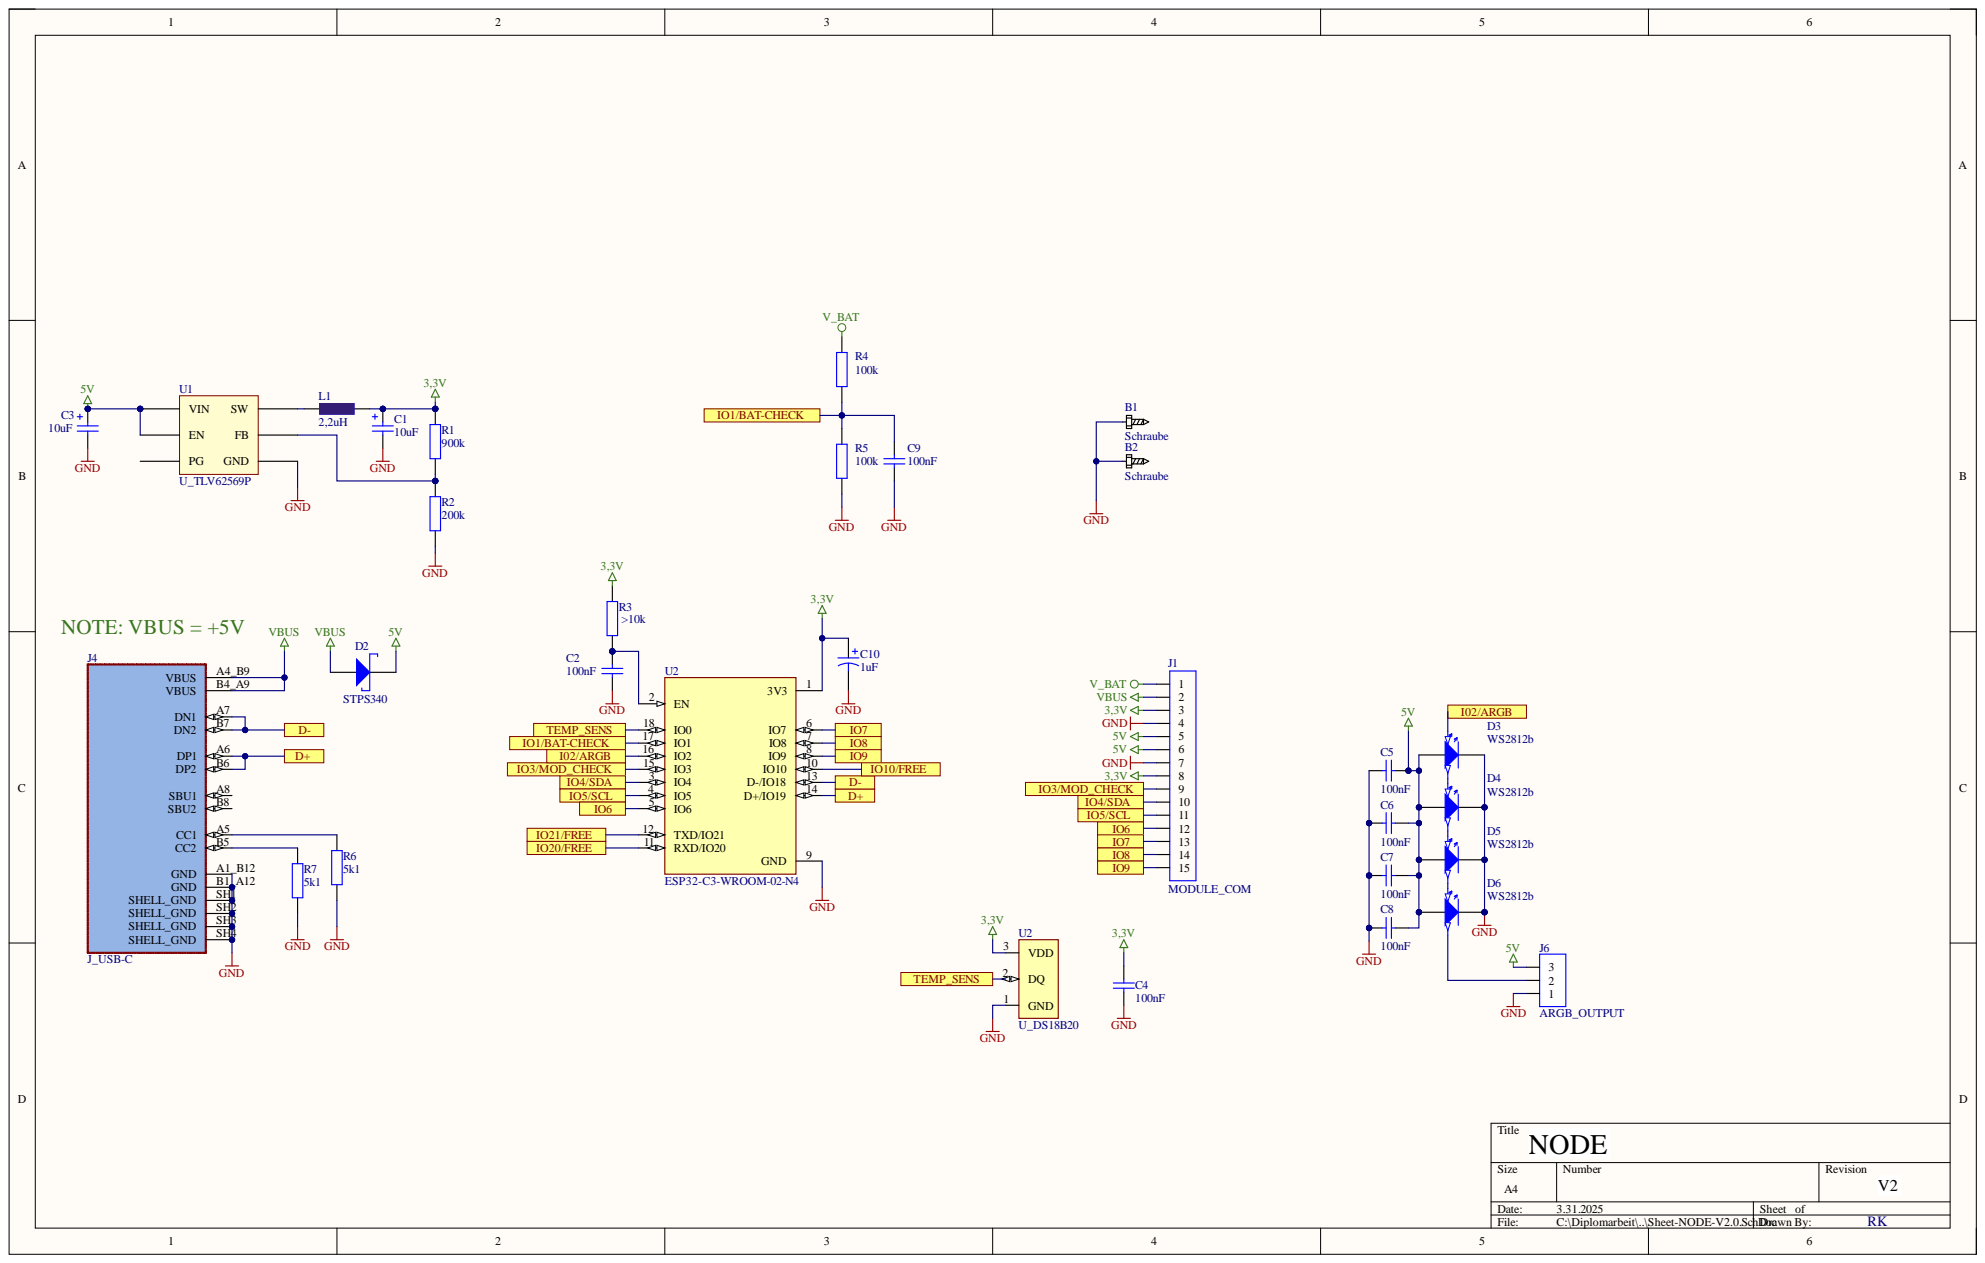
[picture p241: page 1]

IO1/BA T-CHE C K | | | IO 8

IO3/MOD_CHE C K | | | IO1 0/F REE
