SeriousHarlequin/FaRiSmarthome/HW-Module/PDF-all_schematics/Node-V2.1.pdf

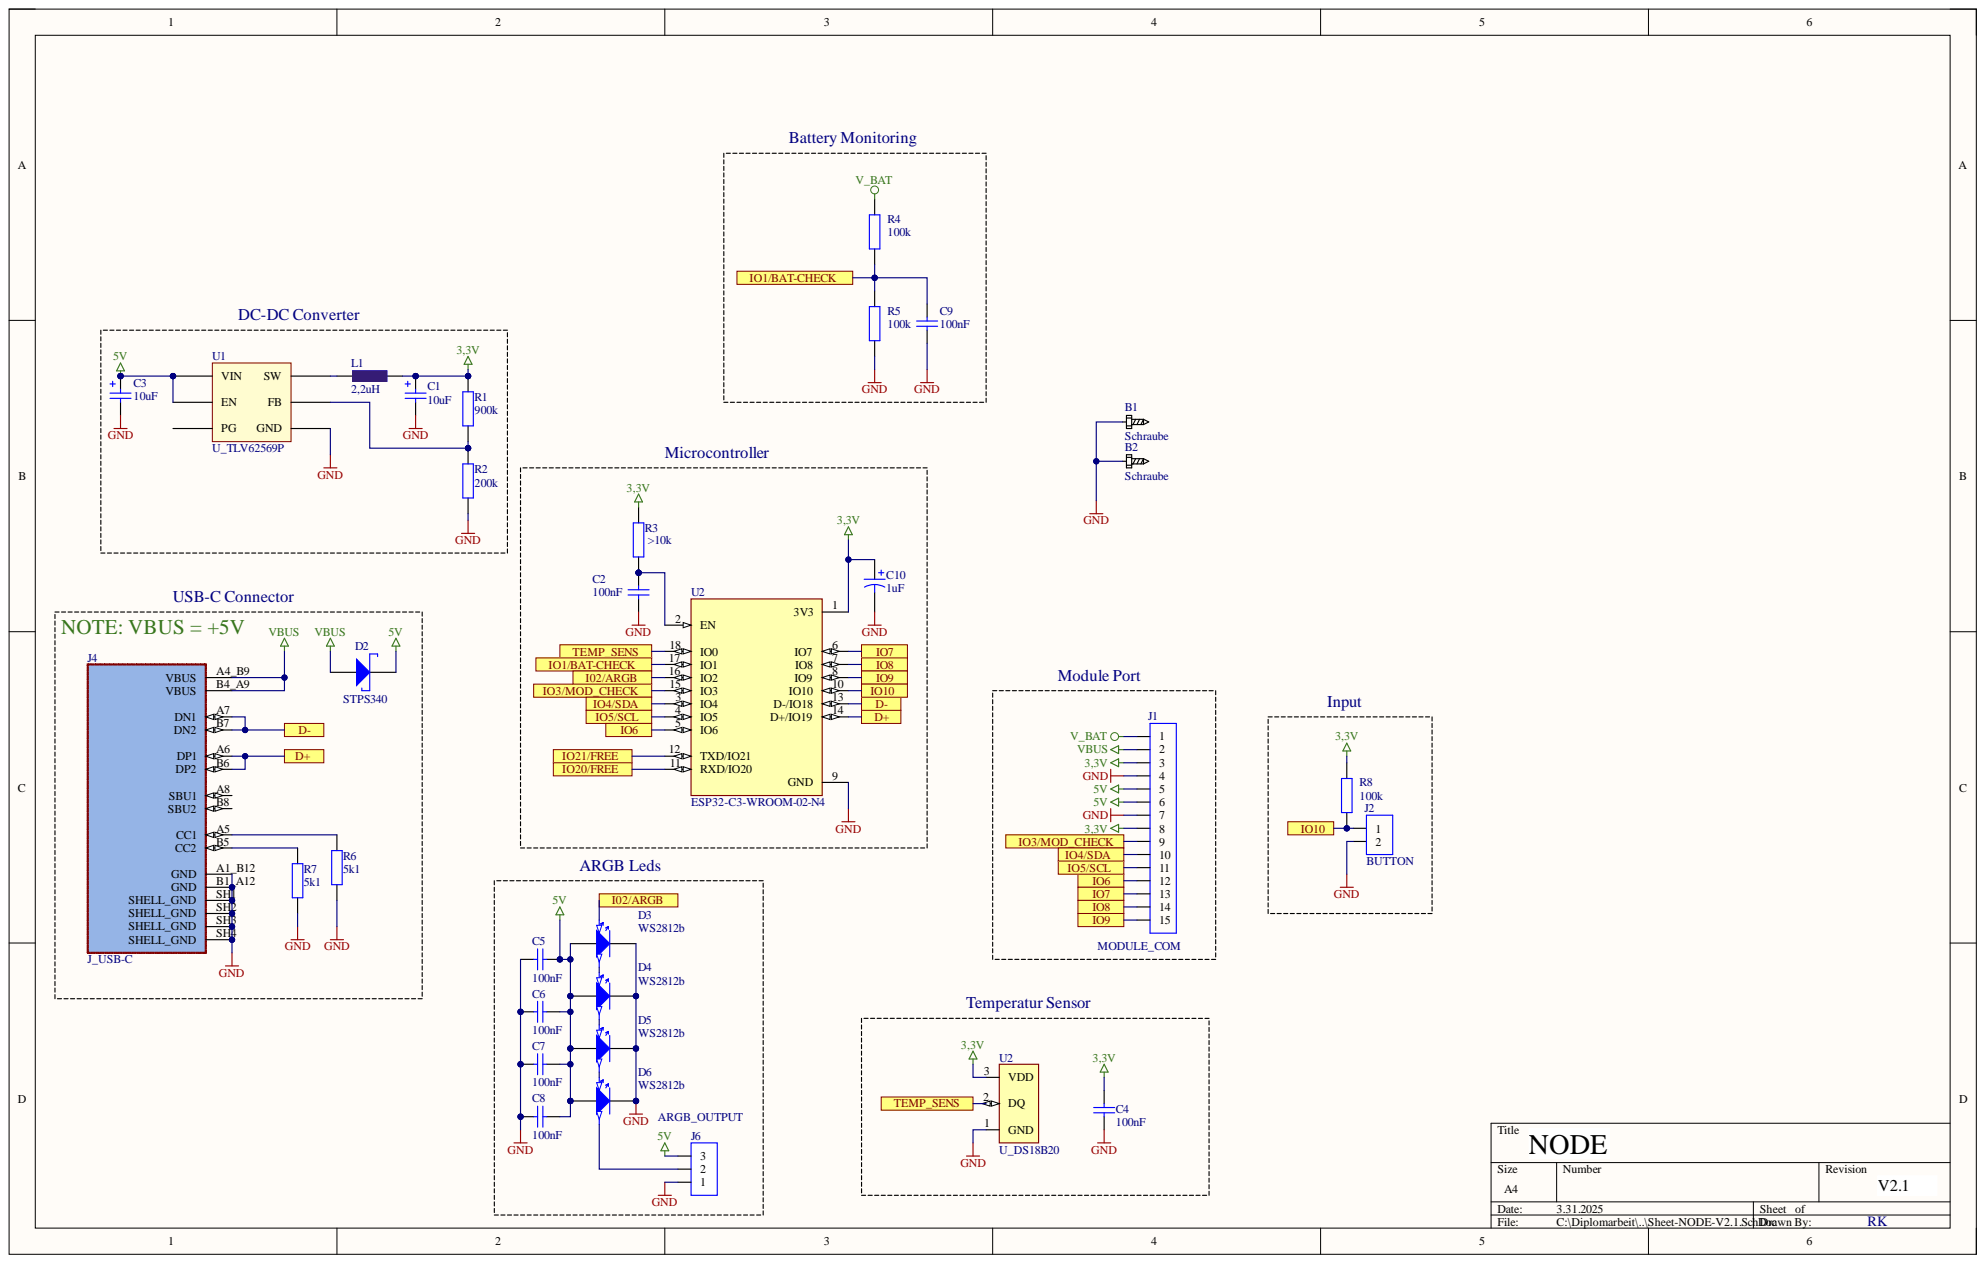
[picture p242: page 1]

IO1/BA T-CHE C K | | IO 8

IO3/MOD_CHE C K | | | IO1 0

IO4/S DA | 4 | 1 4 | D-
IO5/S CL | | | D+
