SeriousHarlequin/FaRiSmarthome/HW-Module/PDF-all_schematics/BATTERY-V1.0.pdf

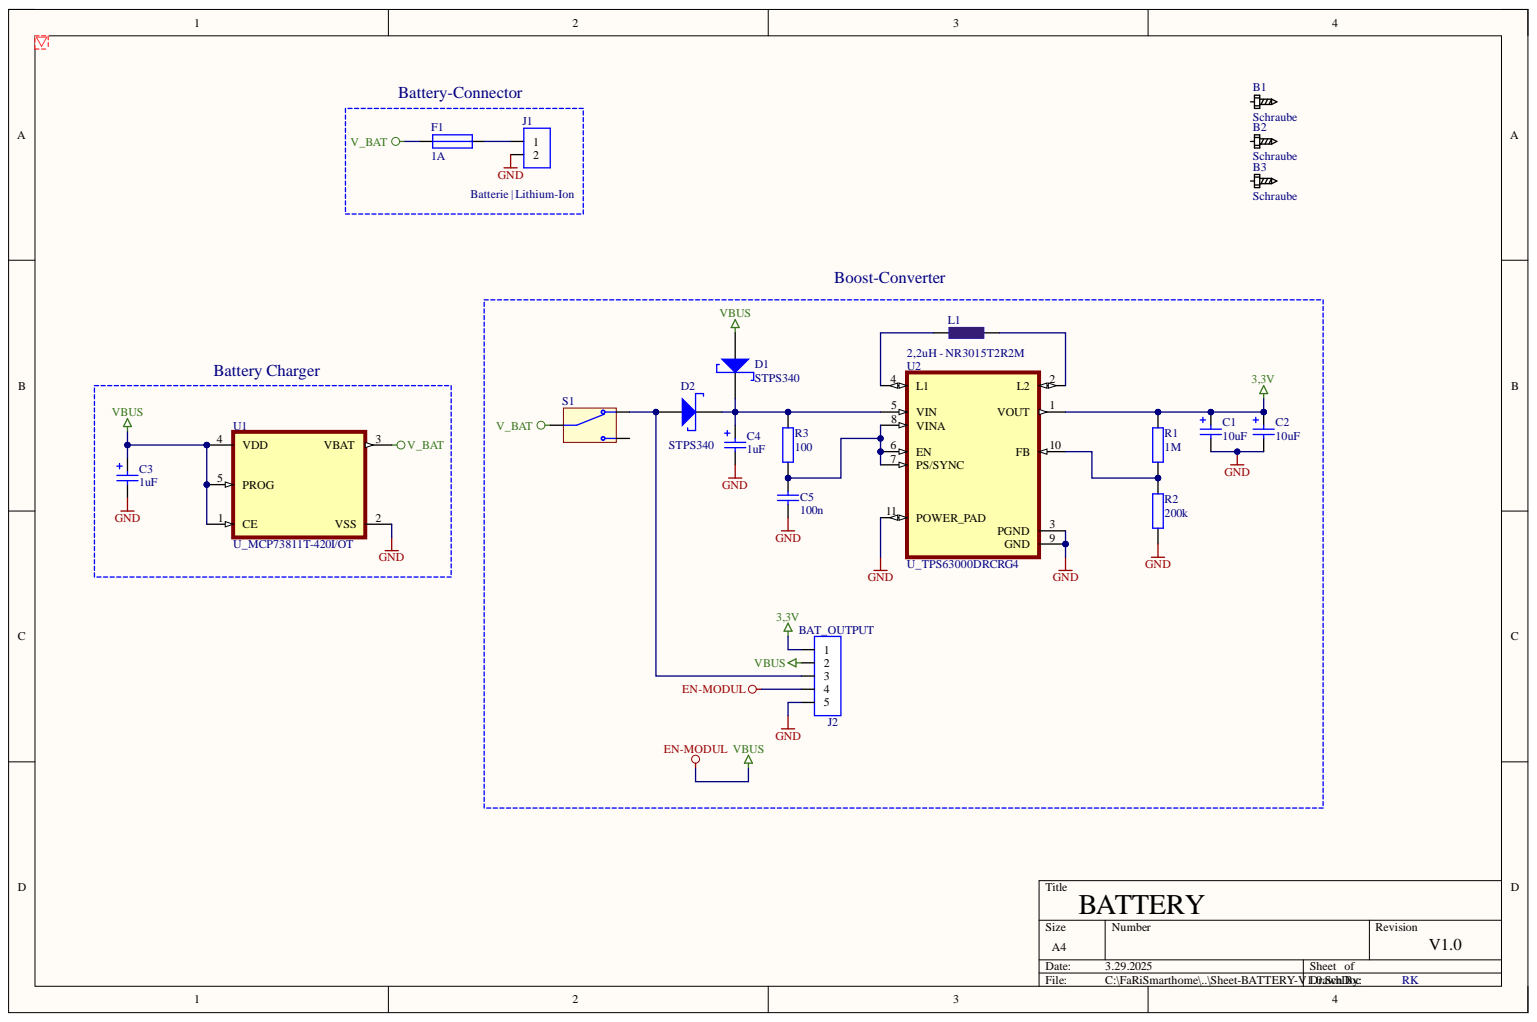
[picture p243: page 1]
