SeriousHarlequin/FaRiSmarthome/HW-Module/BATTERY/PDF/PCB_V2.1-BOT.pdf

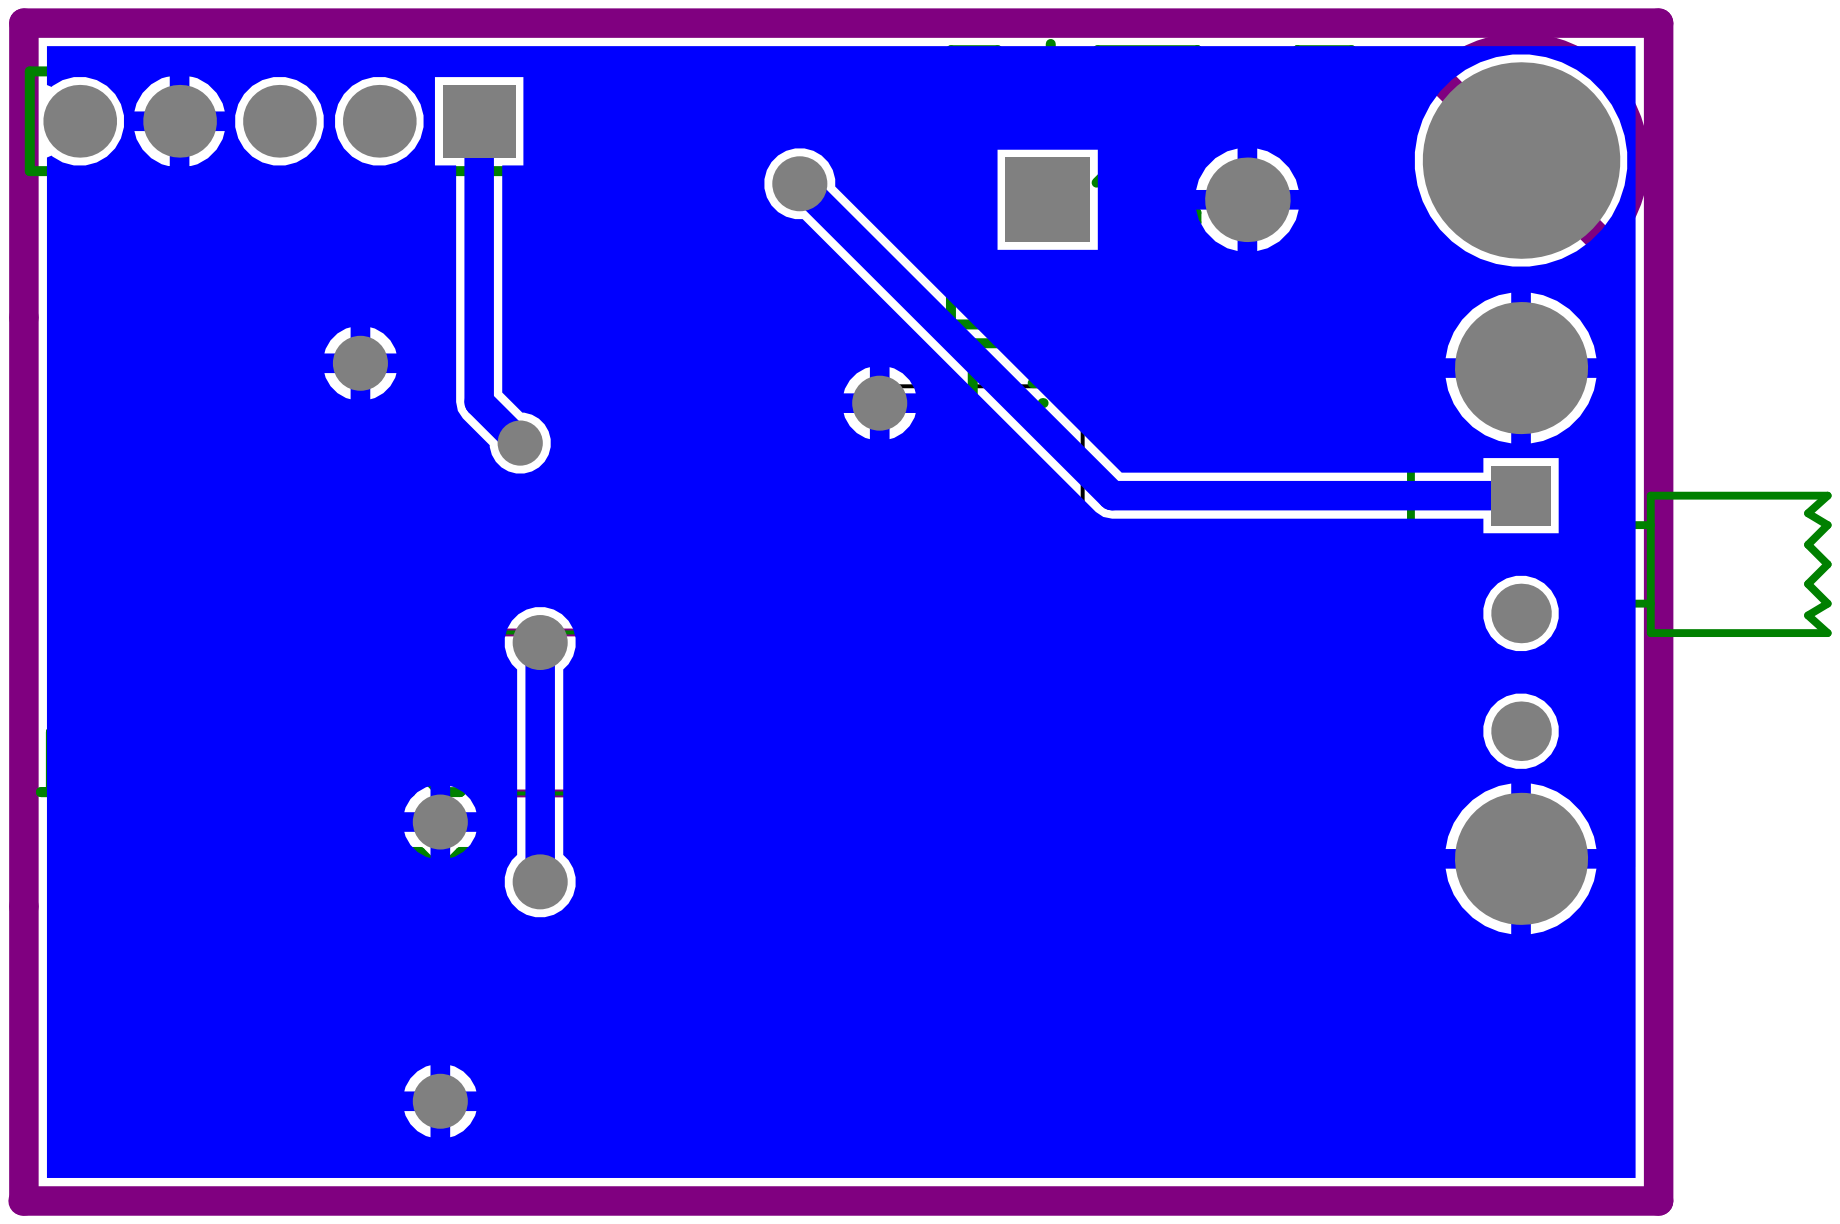
[picture p244: page 1]
