SeriousHarlequin/FaRiSmarthome/HW-Module/BATTERY/PDF/PCB_V2.1-TOP.pdf

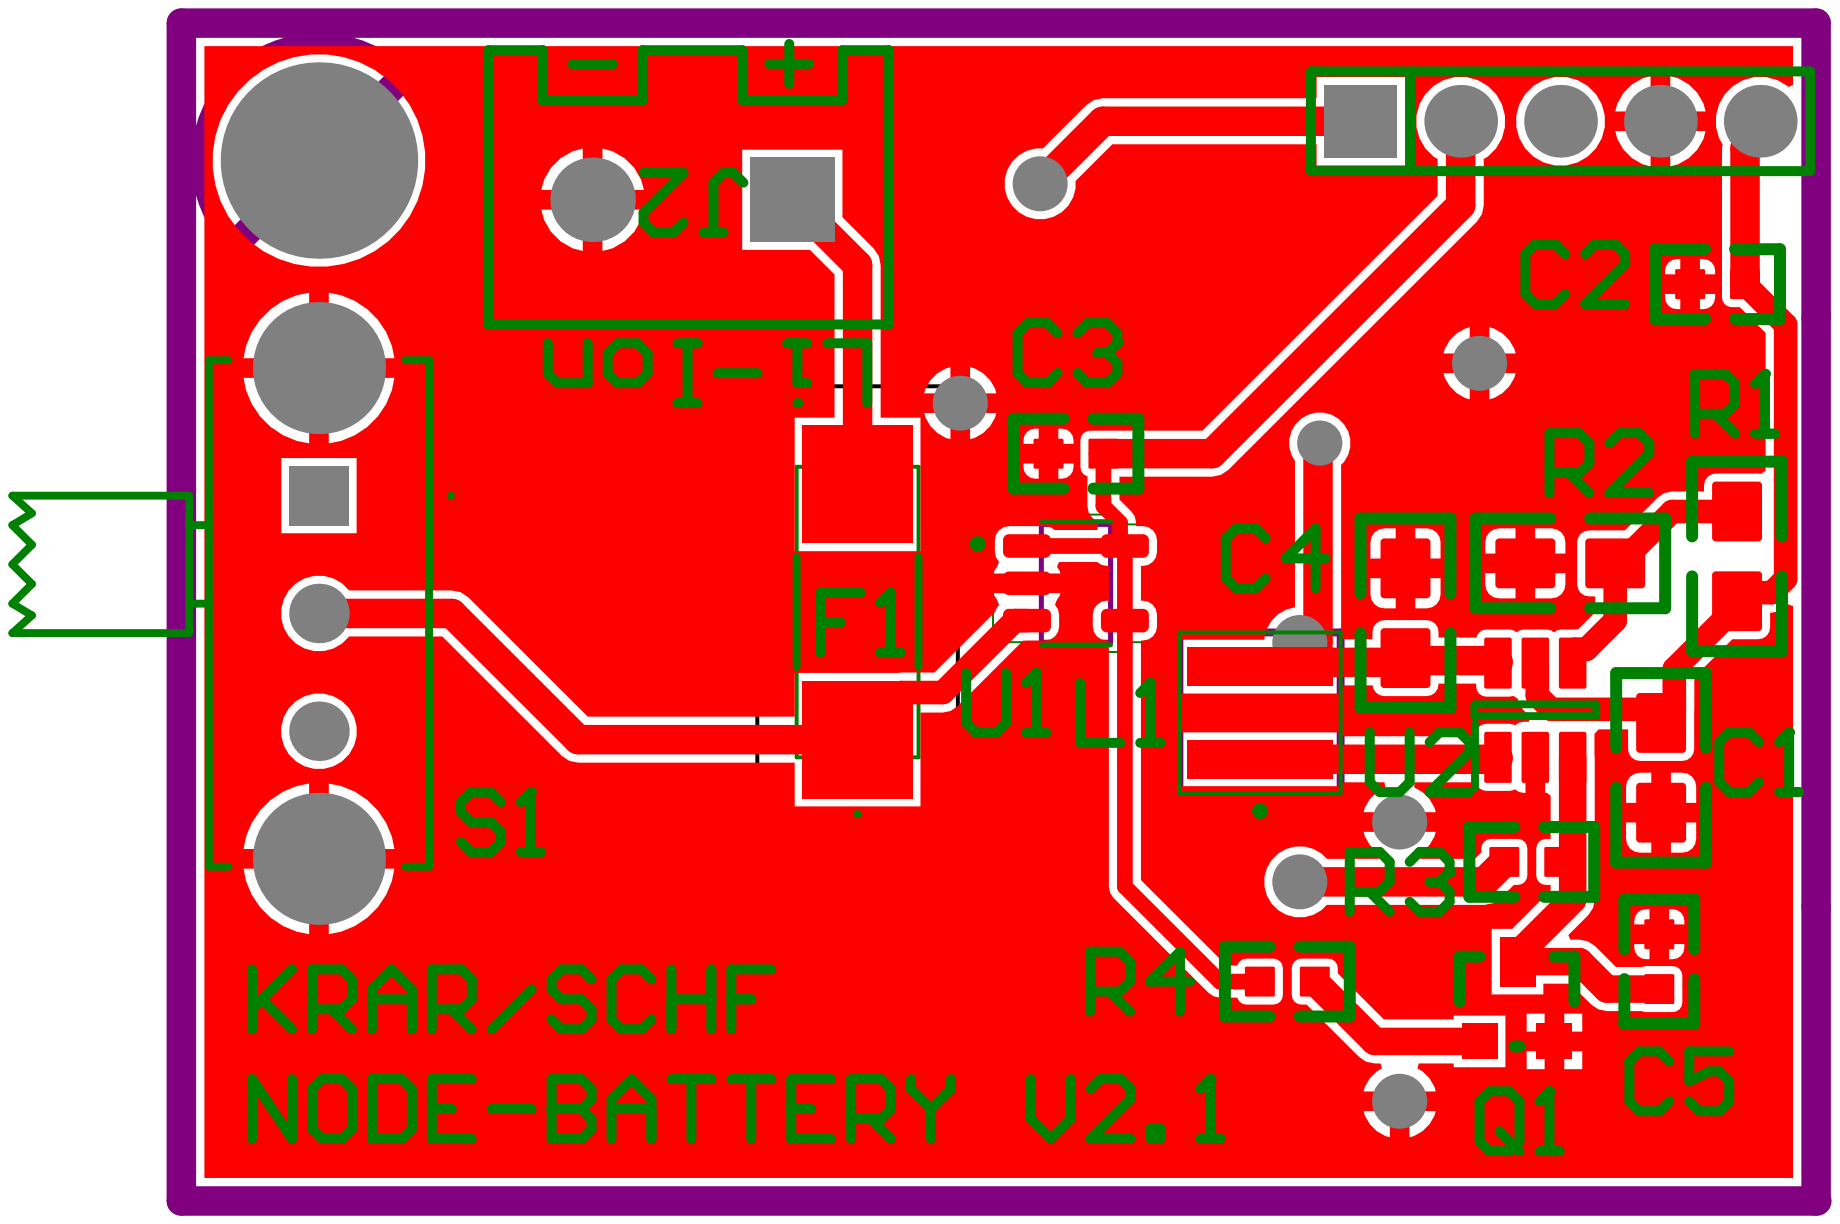
[picture p245: page 1]
