SeriousHarlequin/FaRiSmarthome/HW-Module/NODE/PDF/PCB_V1.1-BOT.pdf

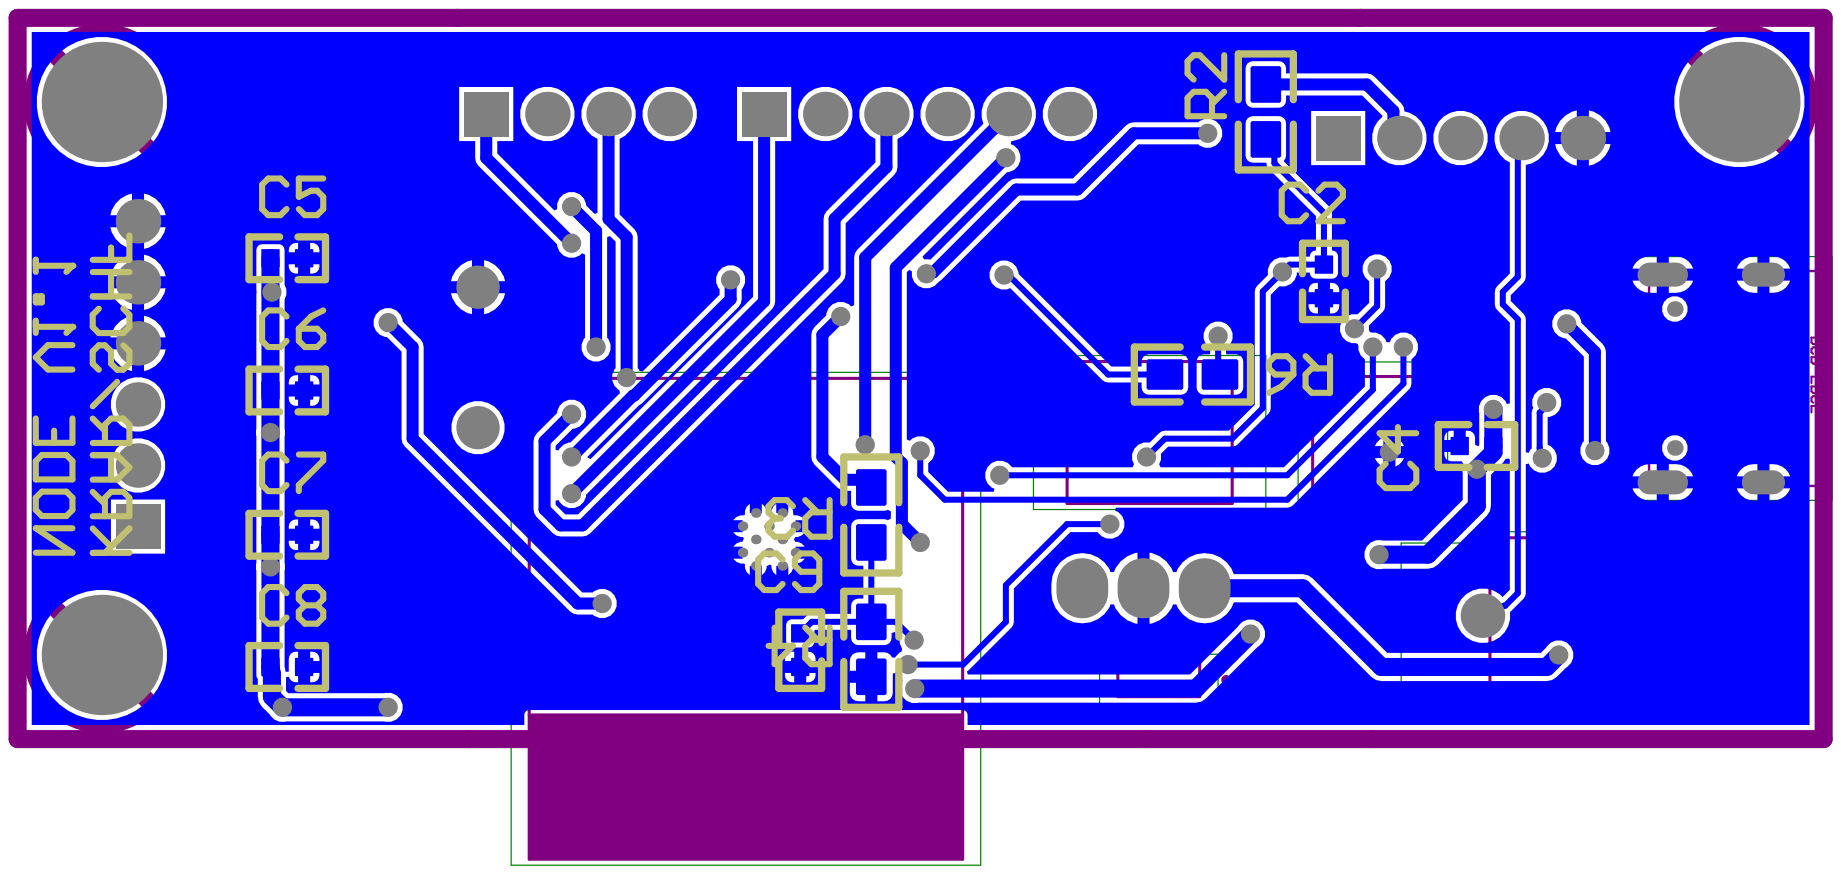
[picture p246: page 1]
