SeriousHarlequin/FaRiSmarthome/HW-Module/NODE/PDF/PCB_V1.1-TOP.pdf

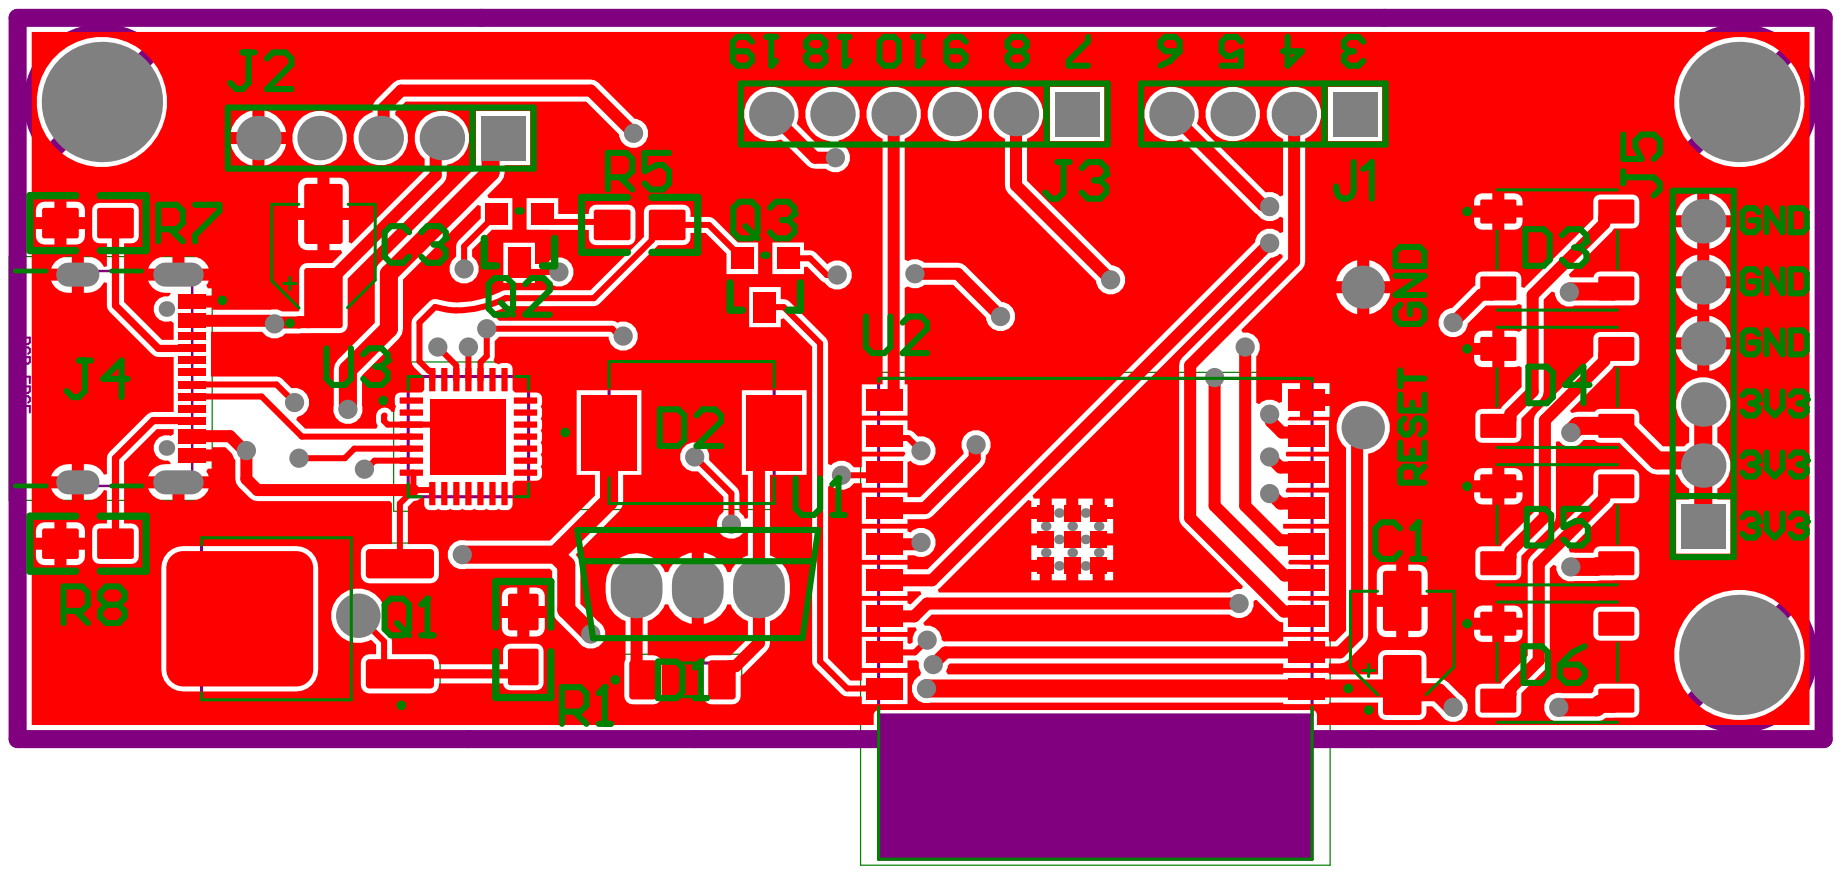
[picture p247: page 1]
