SeriousHarlequin/FaRiSmarthome/HW-Module/BATTERY/PDF/PCB_V1.0-BOT.pdf

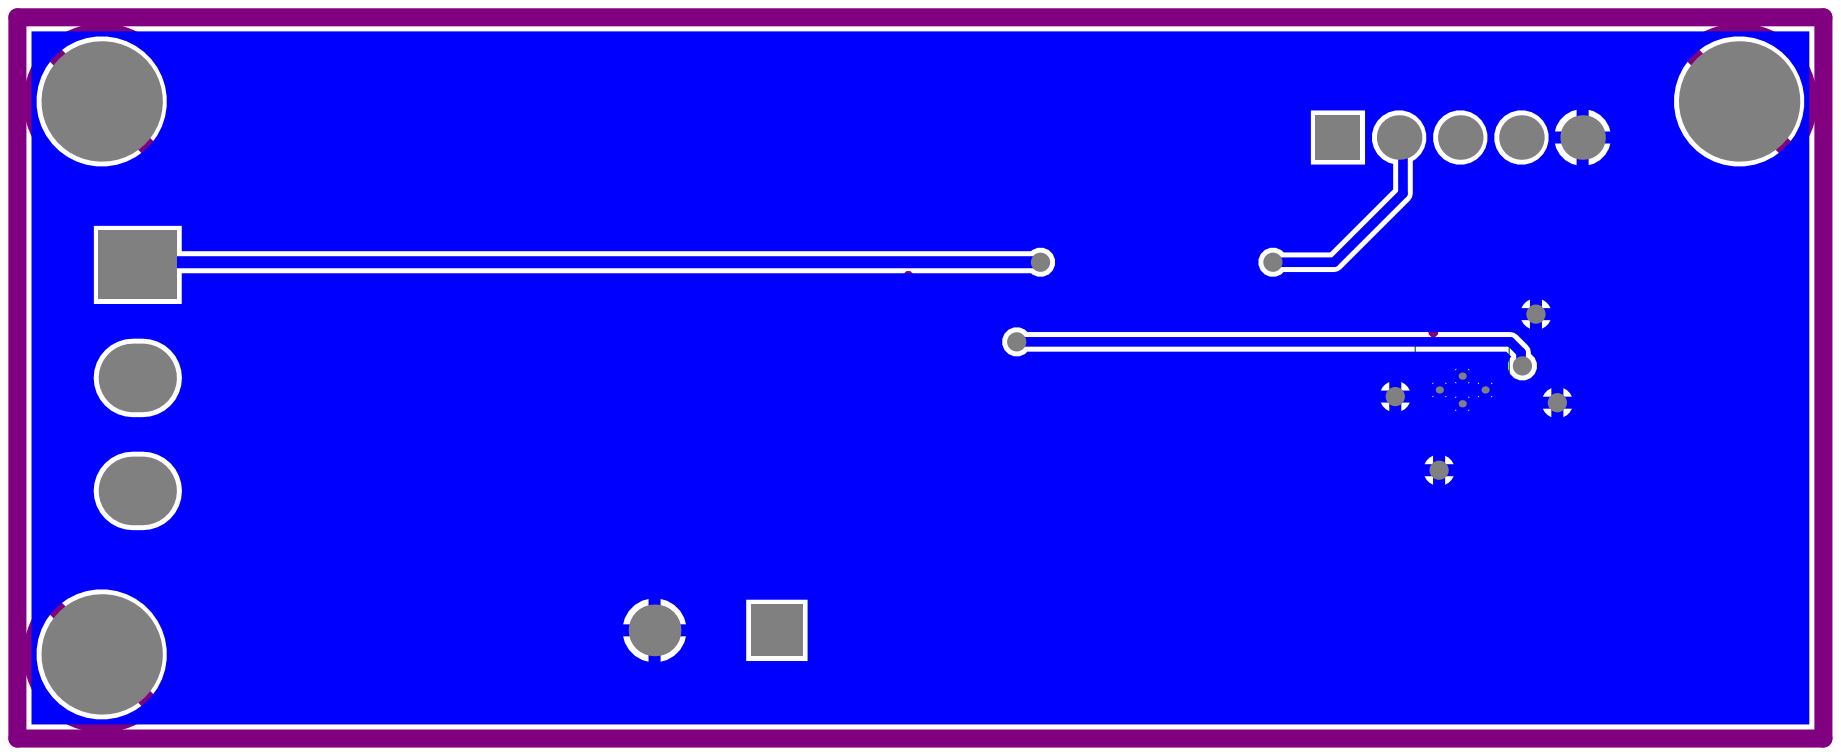
[picture p248: page 1]
