SeriousHarlequin/FaRiSmarthome/HW-Module/BATTERY/PDF/PCB_V1.0-TOP.pdf

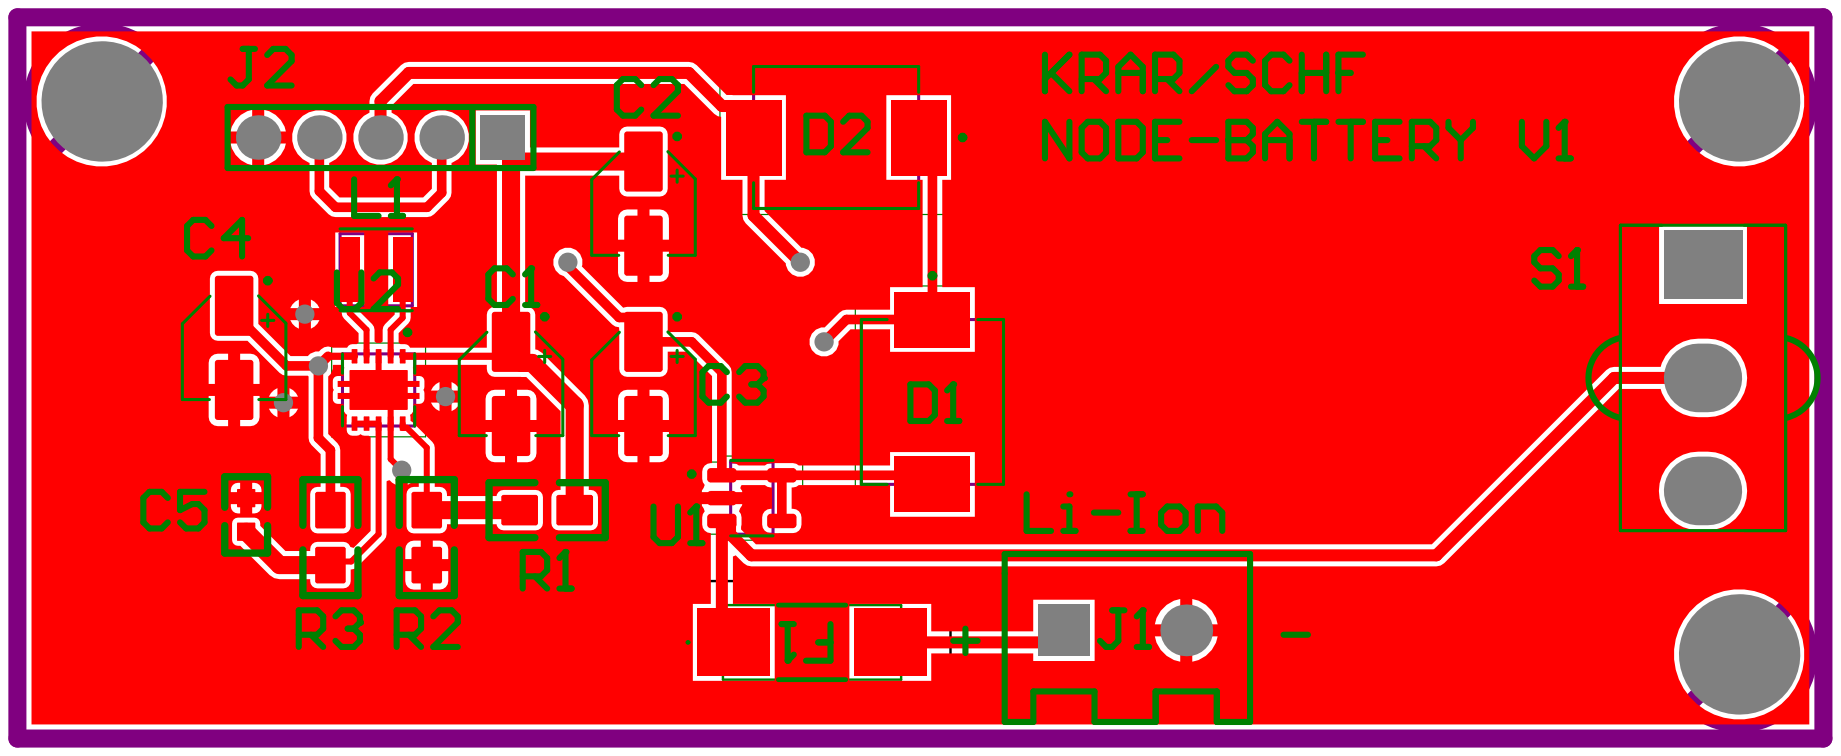
[picture p249: page 1]
