SeriousHarlequin/FaRiSmarthome/HW-Module/MOTION_DETECTION/PDF/PCB_V1.0-TOP.pdf

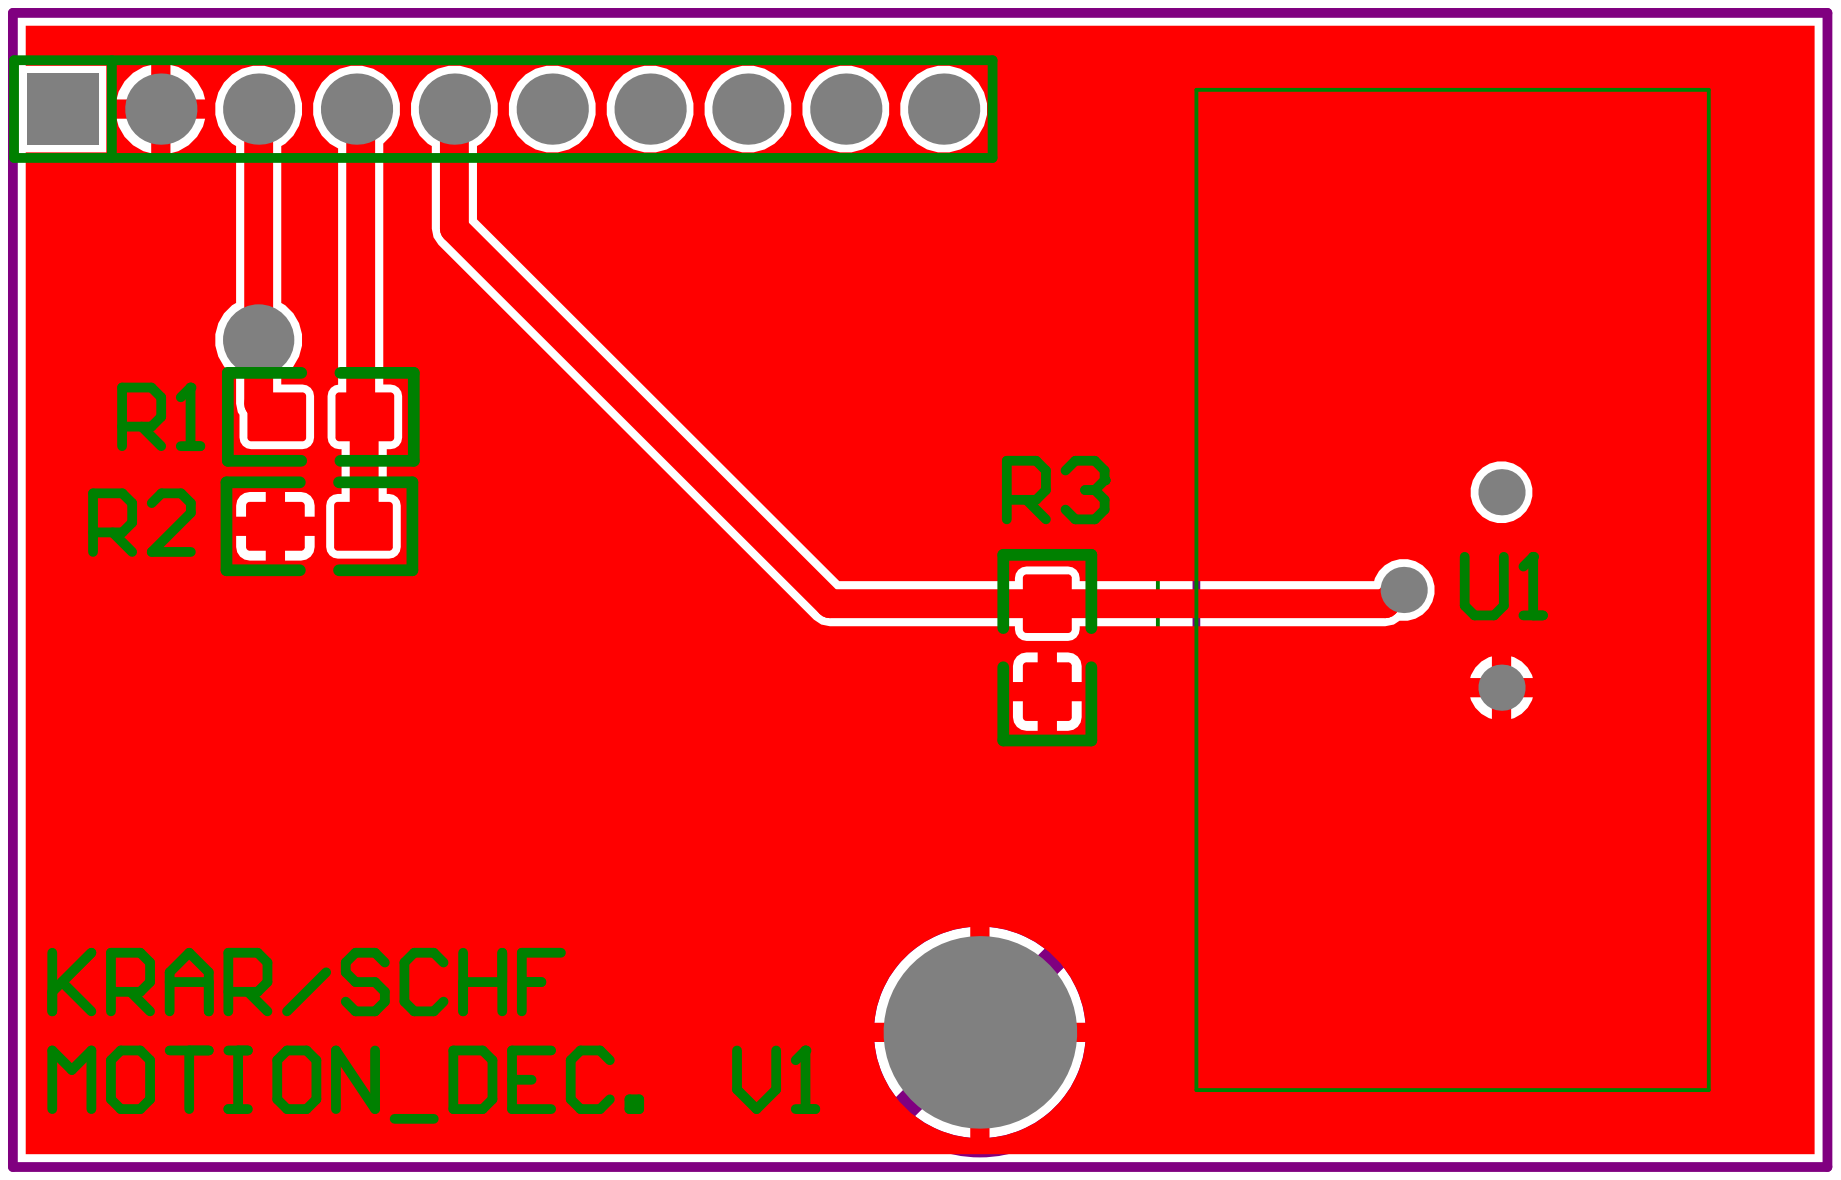
[picture p250: page 1]
