SeriousHarlequin/FaRiSmarthome/HW-Module/SWITCH/PDF/PCB-V1.0-BOT.pdf

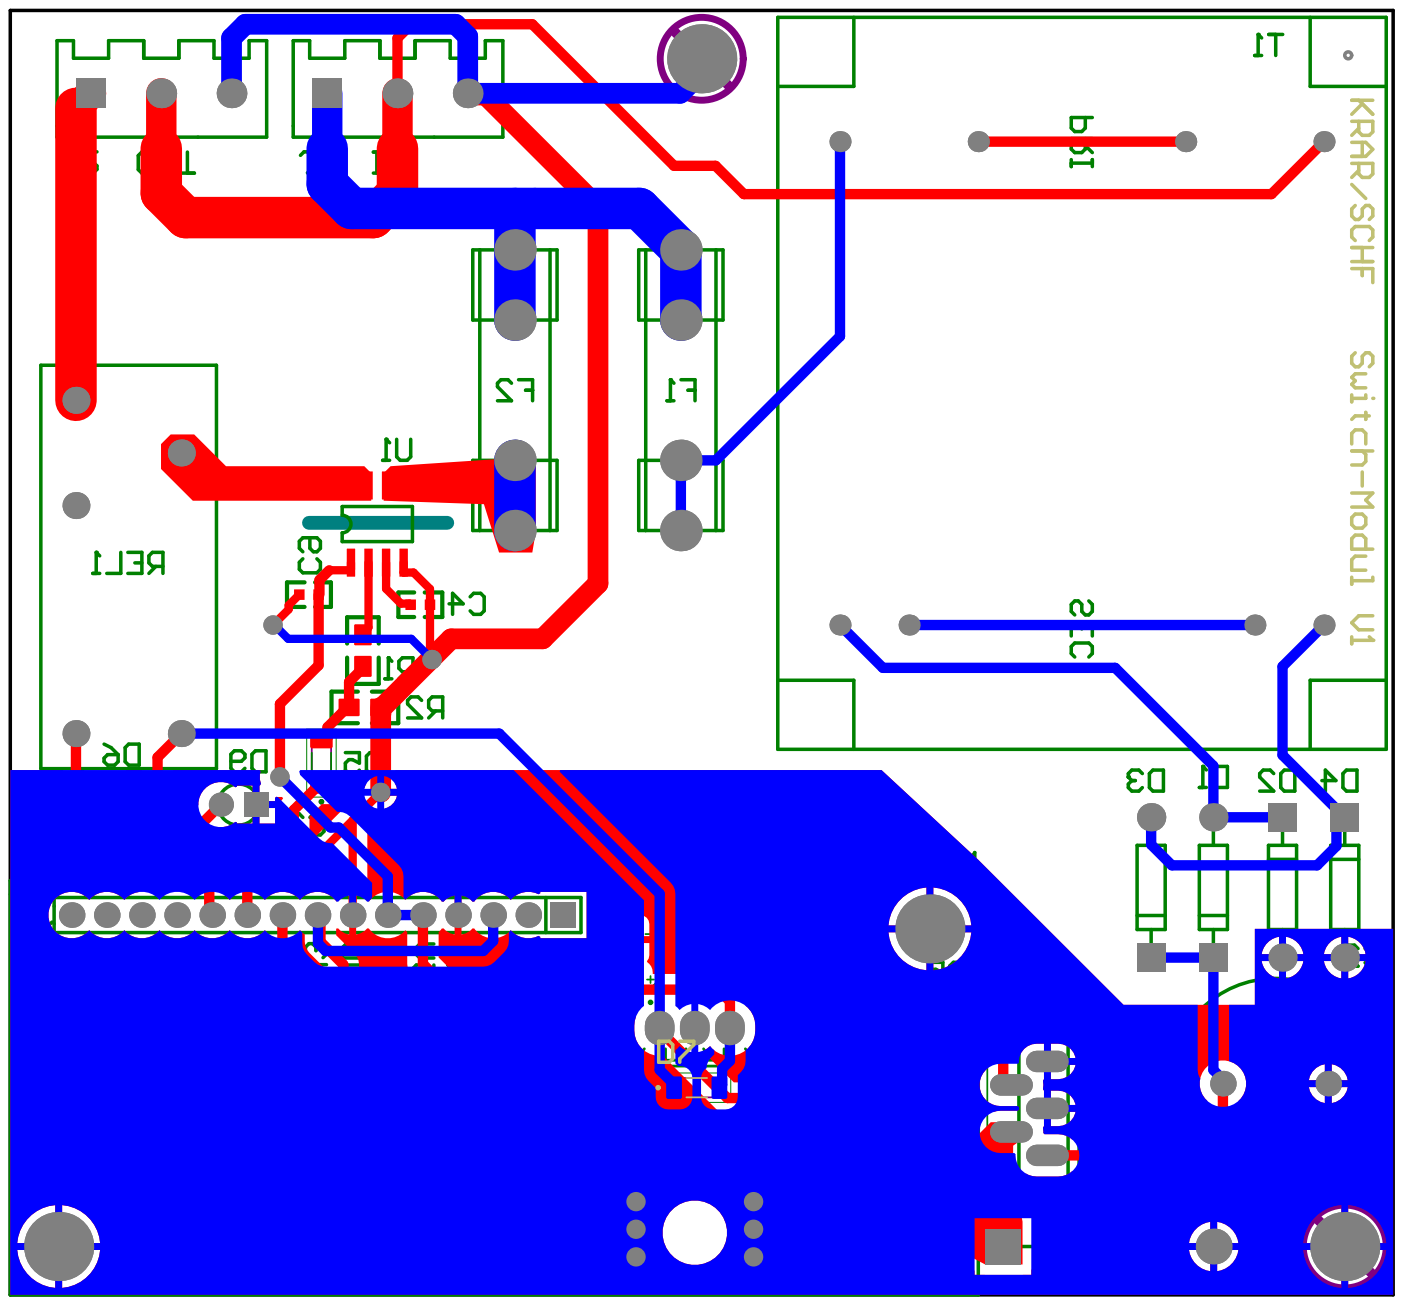
[picture p251: page 1]
