SeriousHarlequin/FaRiSmarthome/HW-Module/SWITCH/PDF/PCB-V1.0-TOP.pdf

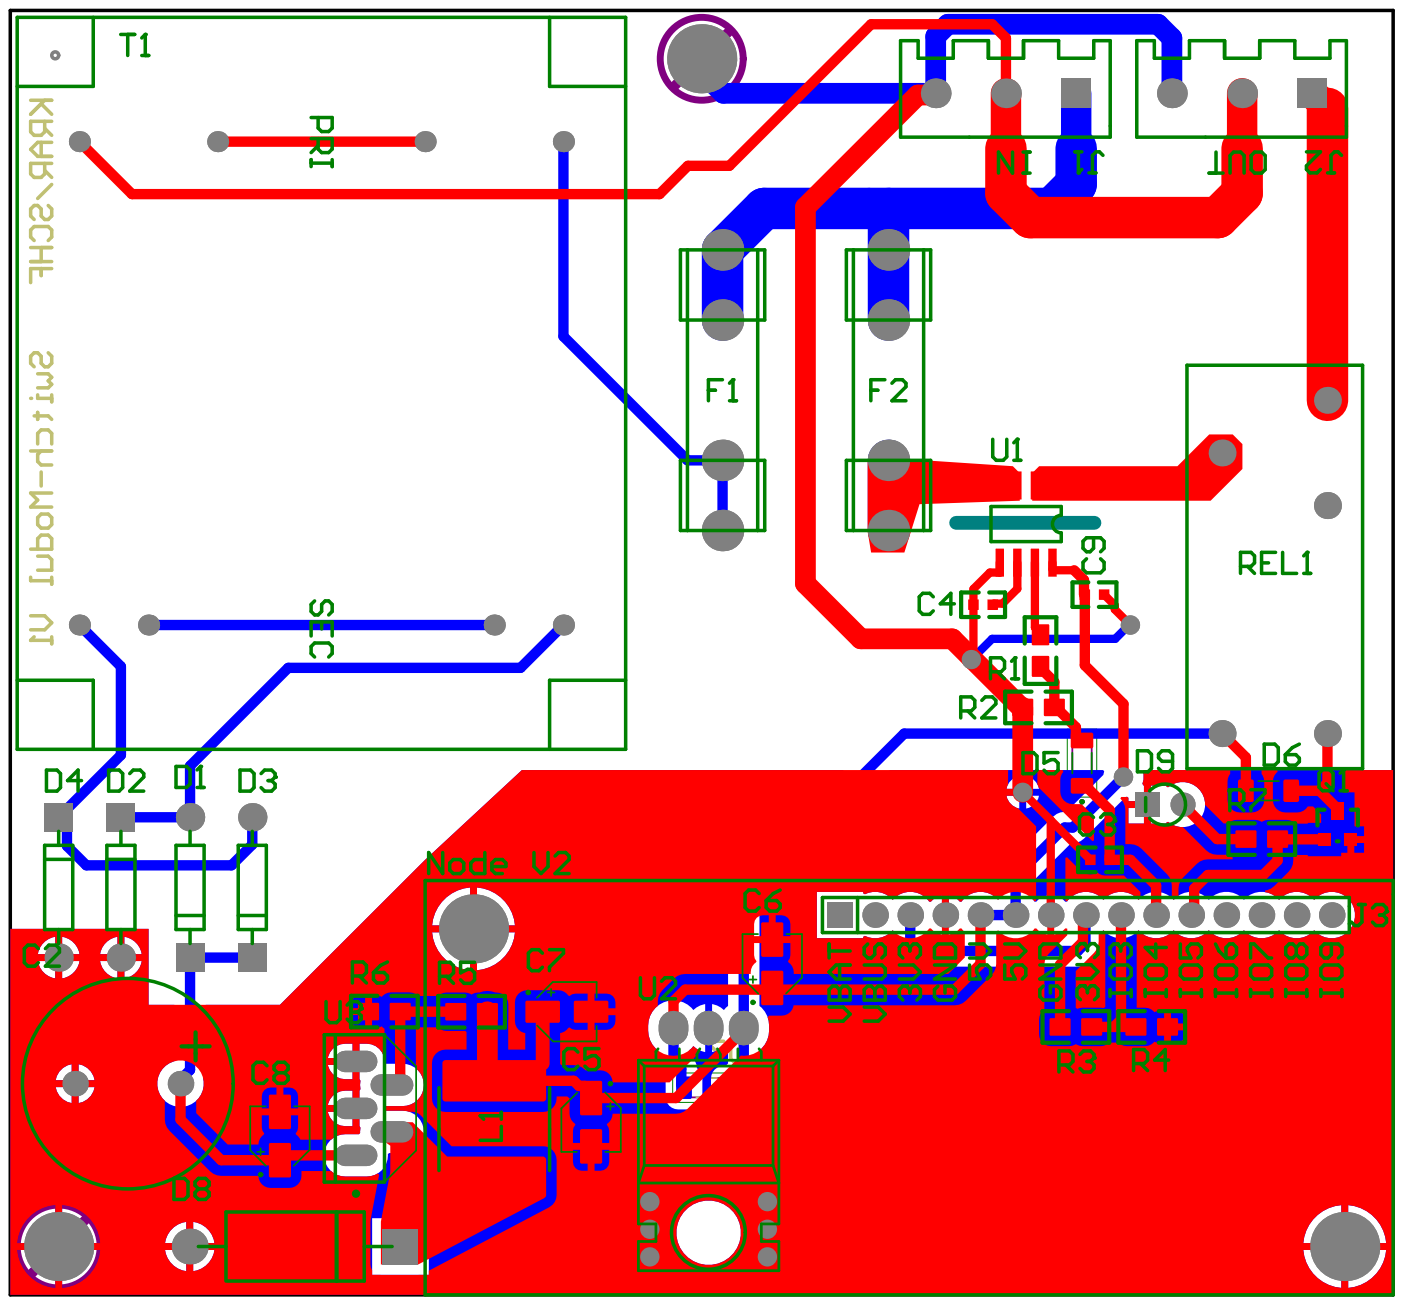
[picture p252: page 1]
