SeriousHarlequin/FaRiSmarthome/HW-Module/NODE/PDF/PCB-V2.0-BOT.pdf

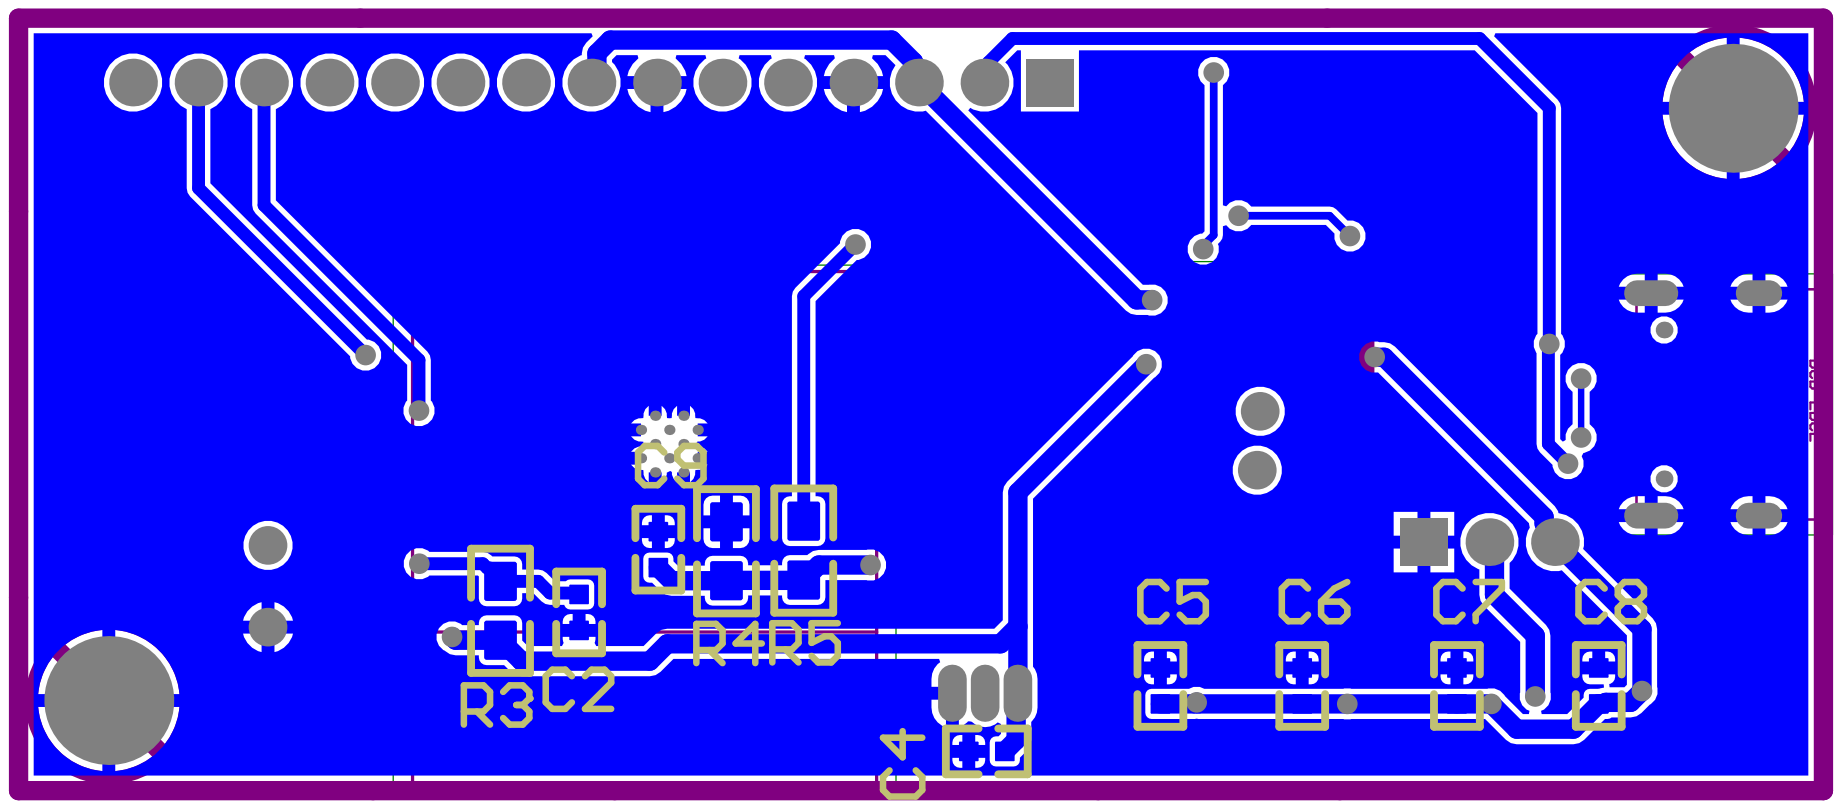
[picture p253: page 1]
