SeriousHarlequin/FaRiSmarthome/HW-Module/NODE/PDF/PCB-V2.0-TOP.pdf

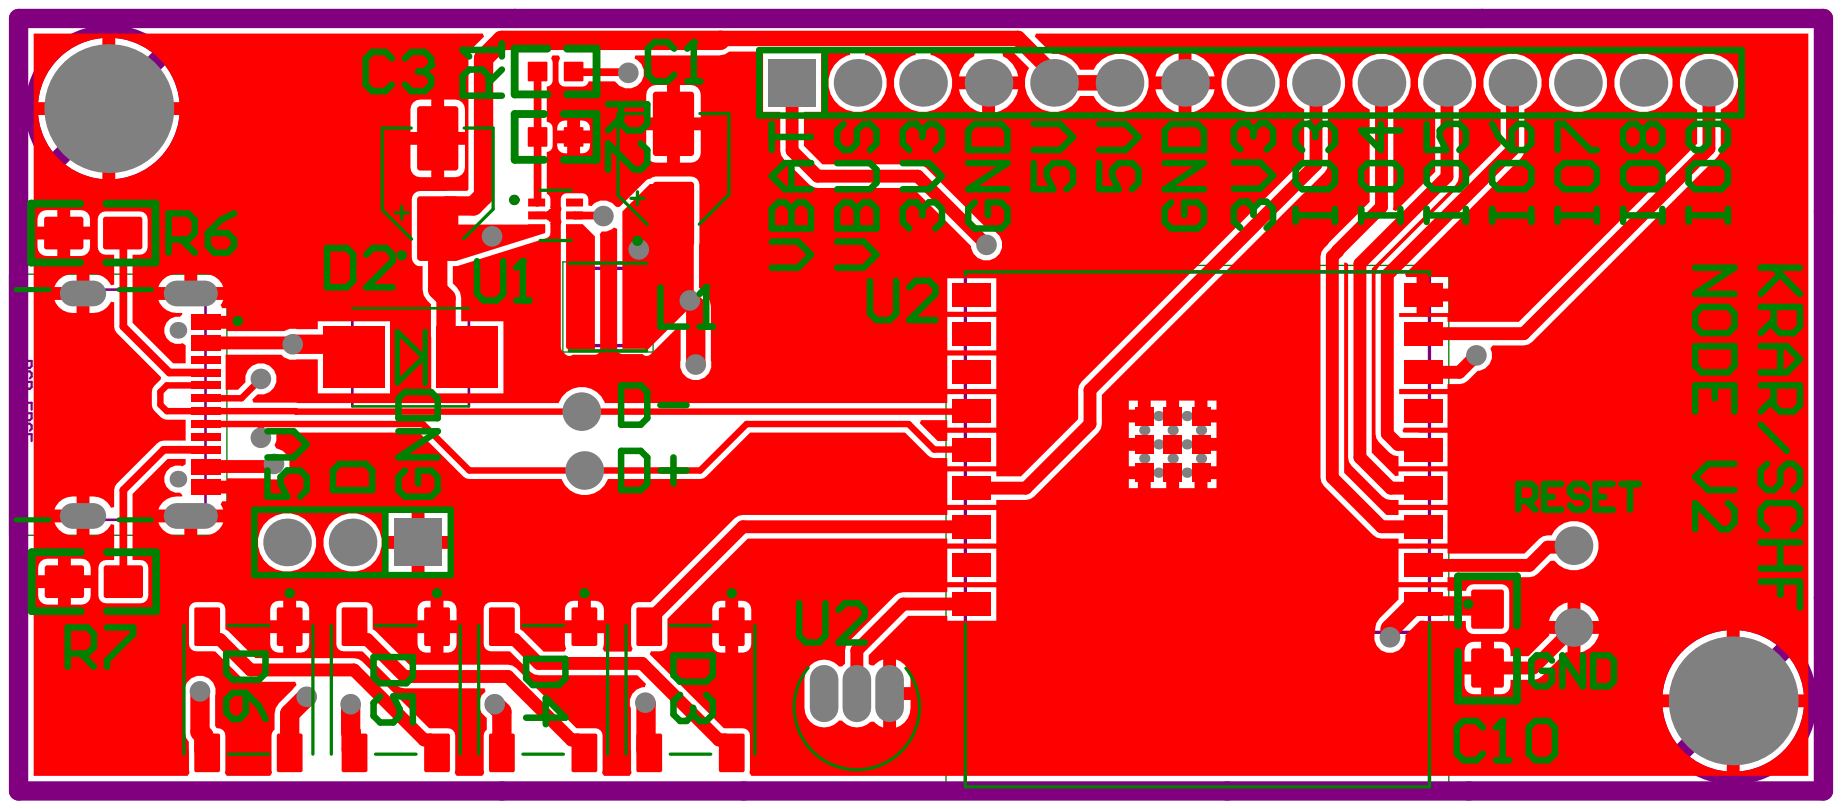
[picture p254: page 1]
