SeriousHarlequin/FaRiSmarthome/HW-Module/NODE/PDF/PCB_V2.1-BOT.pdf

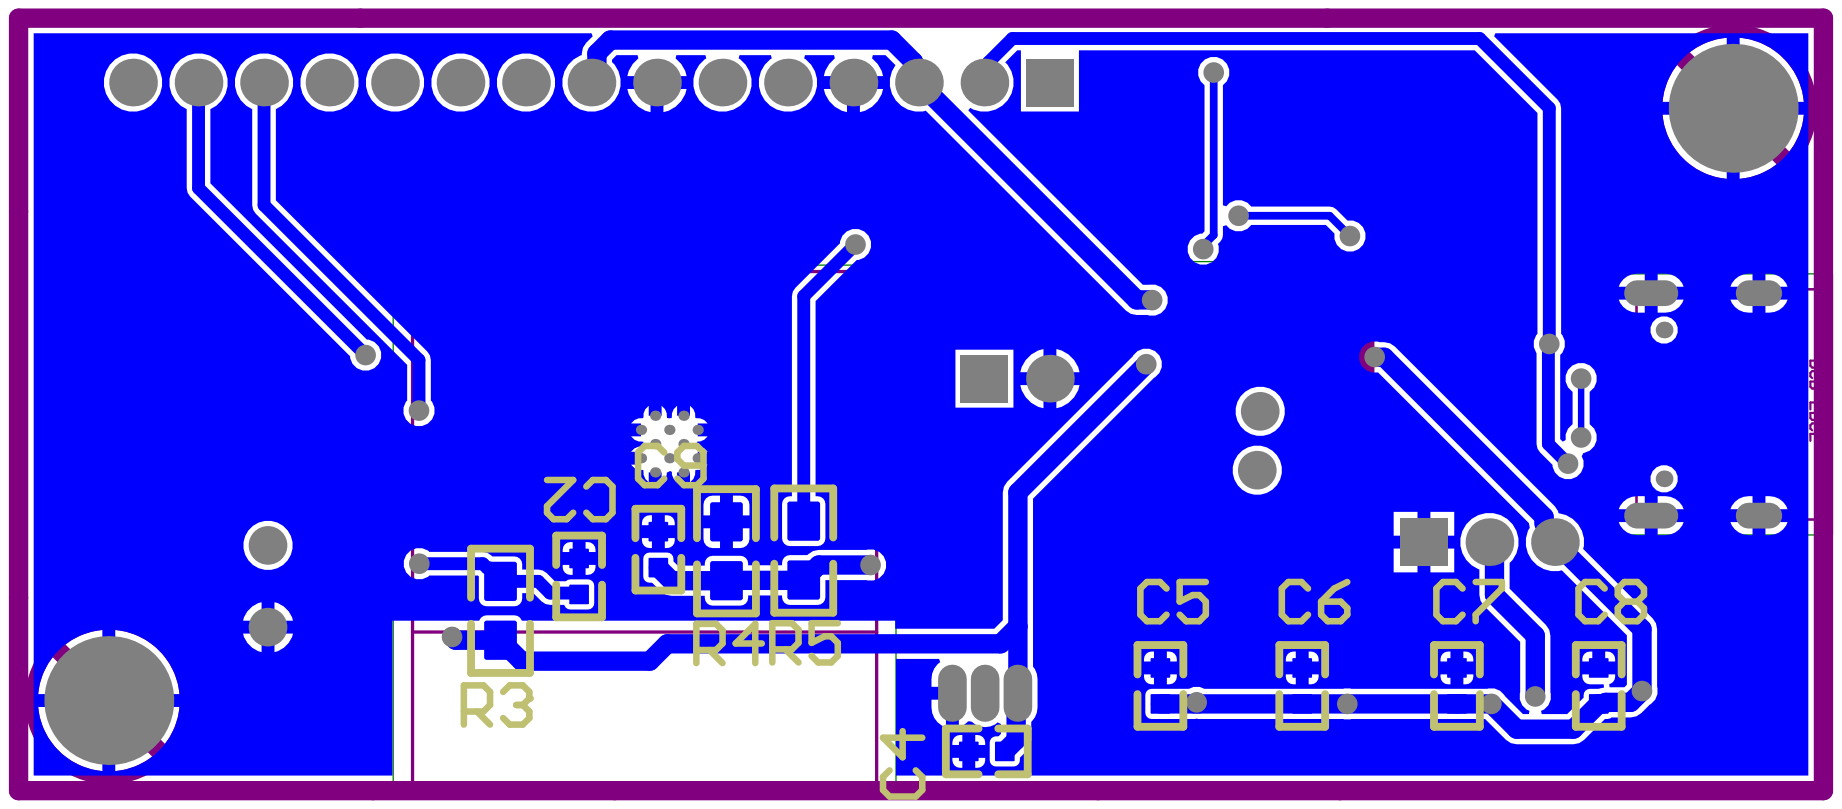
[picture p255: page 1]
