SeriousHarlequin/FaRiSmarthome/HW-Module/NODE/PDF/PCB_V2.1-TOP.pdf

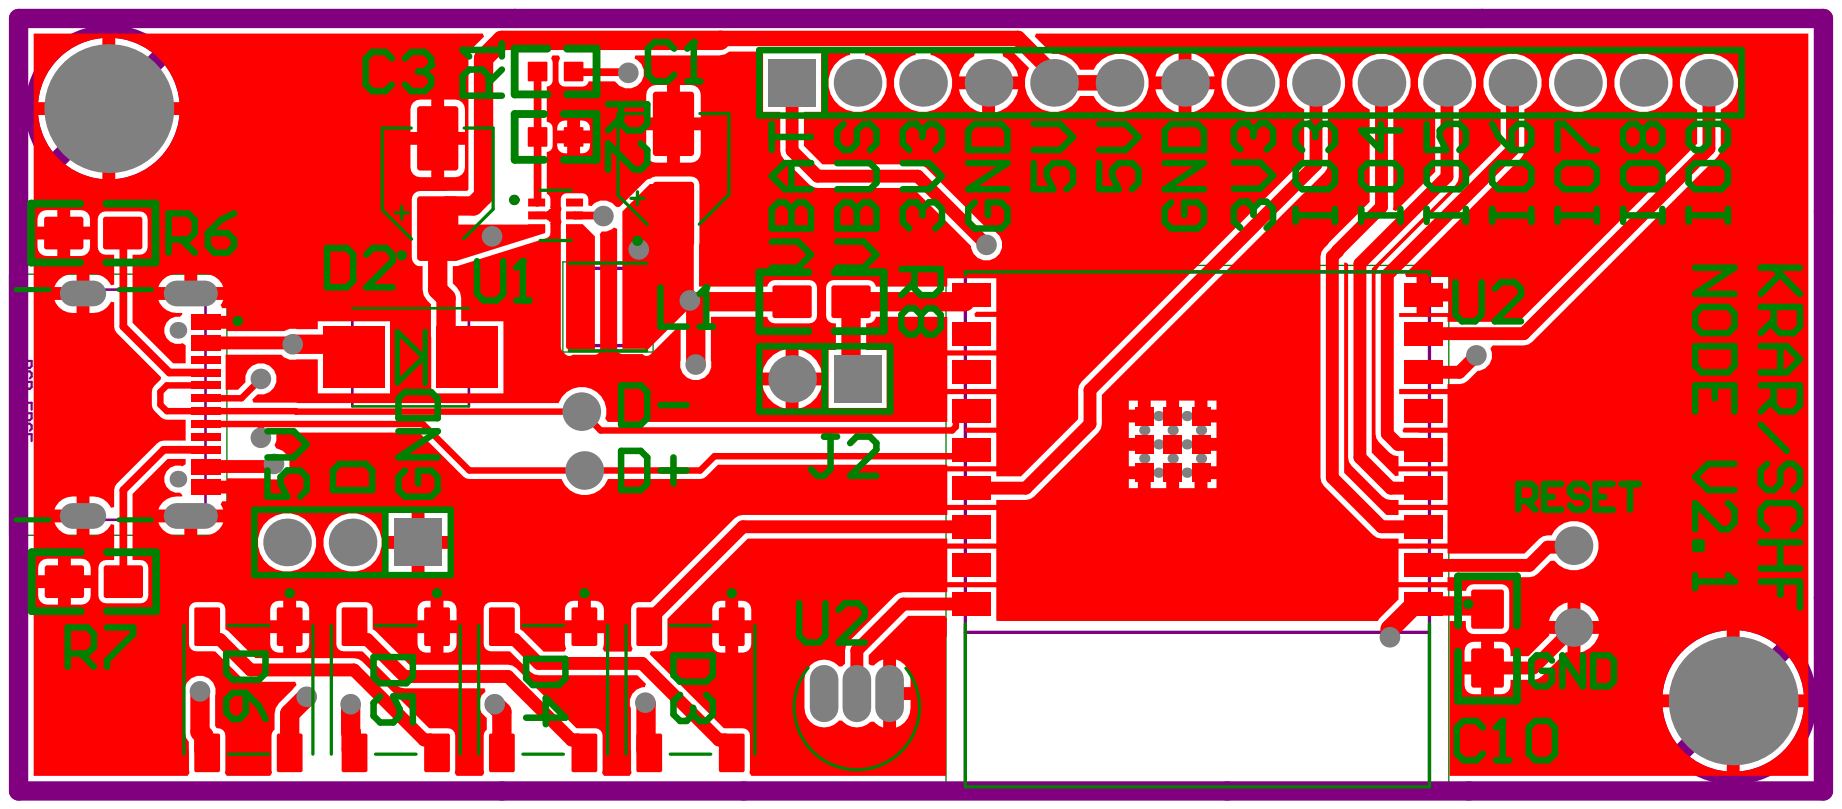
[picture p256: page 1]
