SeriousHarlequin/FaRiSmarthome/Labor-Project/HW/Control-Panel/Control-Panel_V1.pdf

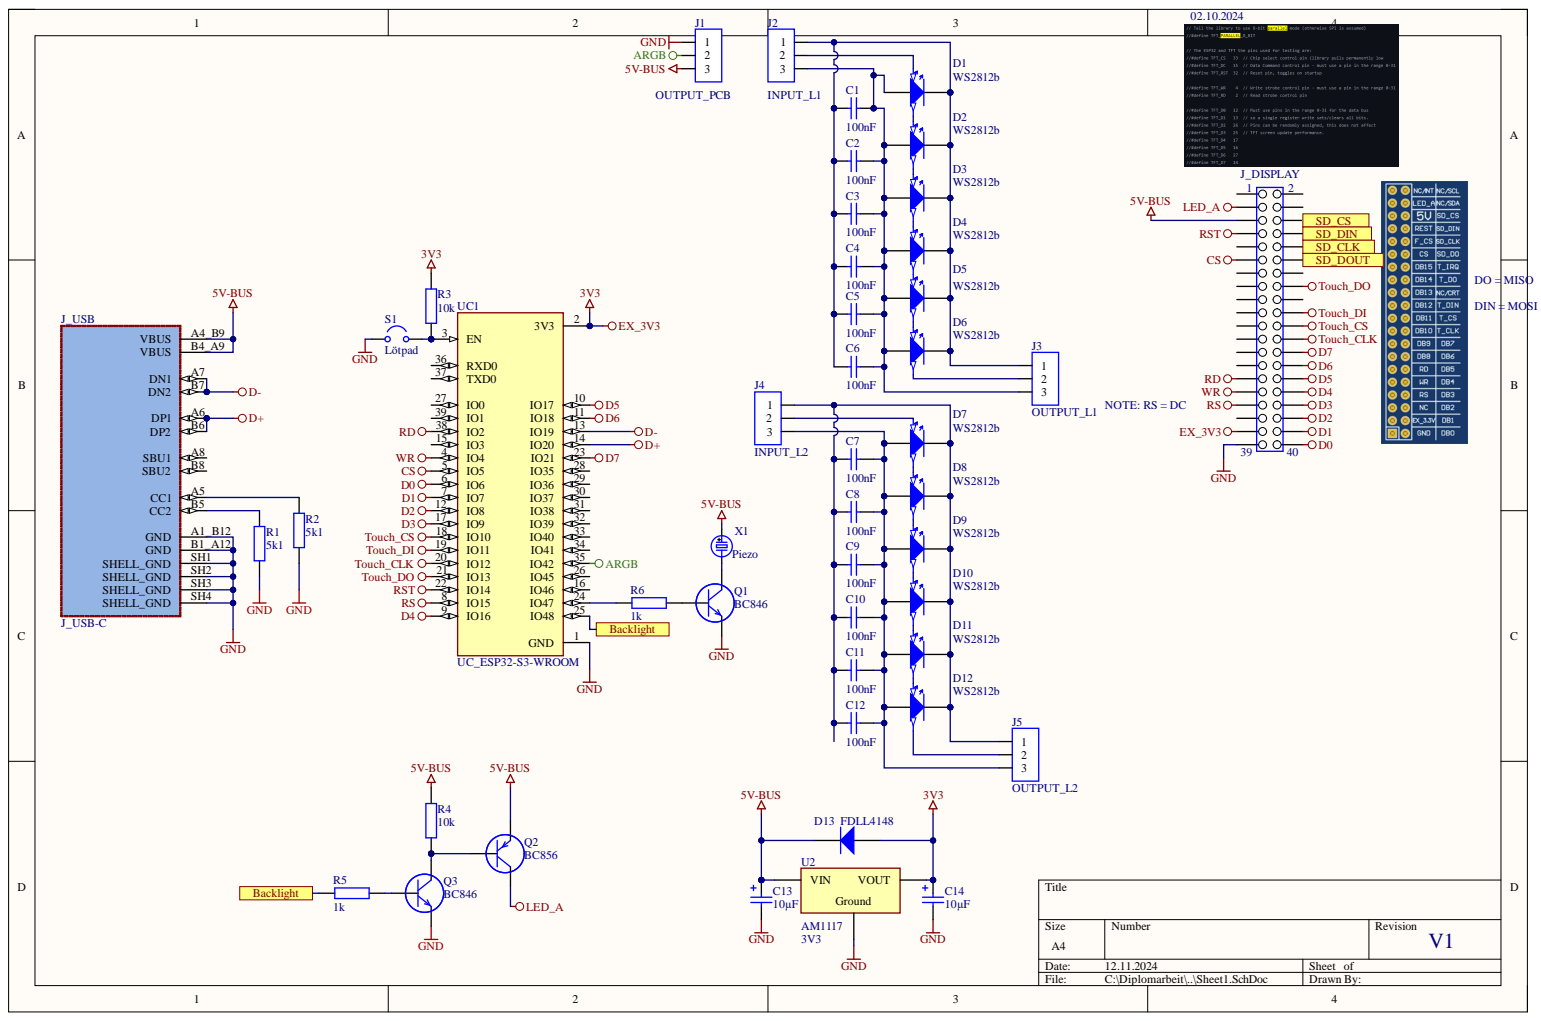
[picture p257: page 1]

DIN = MOSI DO = MISO
