SeriousHarlequin/FaRiSmarthome/(list of files, drawings)

Other design files:
HW-Module/AltiumLibs/LIB-PCSB_5.1.3_DerHabsLeicht-Edition/PCBLIB-PCSB_5.1.3.PcbLib
HW-Module/AltiumLibs/LIB-PCSB_5.1.3_DerHabsLeicht-Edition/SCHLIB-PCSB_5.1.3.SchLib
HW-Module/BATTERY/Batterie-Modul.PrjPcb
HW-Module/BATTERY/Changes/PCB-BATTERY-V1.0.PcbDoc
HW-Module/BATTERY/Changes/PCB-BATTERY-V2.1.PcbDoc
HW-Module/BATTERY/Changes/Sheet-Battery-V1.0.SchDoc
HW-Module/BATTERY/Changes/Sheet-BATTERY-V2.1.SchDoc
HW-Module/BATTERY/PCB1.PcbDoc
HW-Module/BATTERY/Sheet2.SchDoc
HW-Module/MOTION_DETECTION/Changes/PCB_V1.0.PcbDoc
HW-Module/MOTION_DETECTION/Changes/Sheet_V1.0.SchDoc
HW-Module/MOTION_DETECTION/Motion_Detection-Module.PrjPcb
HW-Module/MOTION_DETECTION/PCB1.PcbDoc
HW-Module/MOTION_DETECTION/Sheet1.SchDoc
HW-Module/NODE/Changes/PCB-NODE-V1.0.PcbDoc
HW-Module/NODE/Changes/PCB-NODE-V1.1.PcbDoc
HW-Module/NODE/Changes/PCB-NODE-V2.0.PcbDoc
HW-Module/NODE/Changes/PCB-NODE-V2.1.PcbDoc
HW-Module/NODE/Changes/Sheet-NODE-V1.0.SchDoc
HW-Module/NODE/Changes/Sheet-NODE-V1.1.SchDoc
HW-Module/NODE/Changes/Sheet-NODE-V2.0.SchDoc
HW-Module/NODE/Changes/Sheet-NODE-V2.1.SchDoc
HW-Module/NODE/Node.PrjPcb
HW-Module/NODE/PCB1.PcbDoc
HW-Module/NODE/Sheet1.SchDoc
HW-Module/SWITCH/Changes/PCB-MOTION-V1.0.PcbDoc
HW-Module/SWITCH/Changes/Sheet-SWITCH-V1.0.SchDoc
HW-Module/SWITCH/PCB1.PcbDoc
HW-Module/SWITCH/Sheet1.SchDoc
HW-Module/SWITCH/Switch-Modul.PrjPcb
Labor-Project/HW/Control-Panel/Control-Panel.PrjPcb
Labor-Project/HW/Control-Panel/PCB1.PcbDoc
Labor-Project/HW/Control-Panel/Sheet1.SchDoc
