SeriousHarlequin/FaRiSmarthome/SW-ESP/globalLibs/FaRiLib/include/espnowMaster.h

#ifndef ESPNOW_MASTER_HEADER_GUARD
#define ESPNOW_MASTER_HEADER_GUARD

#include "espnow.h"
#include <vector>

class EspNowMaster : public EspNow {
public:
    std::vector<std::array<uint8_t, 6>> peers;

    bool addPeer(const uint8_t * mac);
};

extern EspNowMaster espnowMaster;

#endif
