SeriousHarlequin/FaRiSmarthome/SW-ESP/ESP_NOW_Master/src/espnow.cpp

#include "espnow.h"
#include <WiFi.h>

bool espNowInit(){
    WiFi.mode(WIFI_STA);
    if (esp_now_init() != ESP_OK) {
        Serial.println("Error initializing ESP-NOW");
        return false;
    }
    return true;
}

void readMacAddress(){
  uint8_t baseMac[6];
  esp_err_t ret = esp_wifi_get_mac(WIFI_IF_STA, baseMac);
  if (ret == ESP_OK) {
    Serial.printf("%02x:%02x:%02x:%02x:%02x:%02x\n",
                  baseMac[0], baseMac[1], baseMac[2],
                  baseMac[3], baseMac[4], baseMac[5]);
  } else {
    Serial.println("Failed to read MAC address");
  }
}

void requestMACAddress(){
  uint8_t broadcastAddress[] = {0xFF, 0xFF, 0xFF, 0xFF, 0xFF, 0xFF};
  
}
