SeriousHarlequin/FaRiSmarthome/(commit log)

2024-09-04 Added First HW Verion of the NOE
    [Node.PrjPcb, PCB1.PcbDoc, Sheet1.SchDoc]
2024-09-14 Improved Node, Added complete Schematic for the Battery-Module and began designing the PCB
    [Batterie-Modul.PrjPcb, Control-Panel.PrjPcb, Datasheet-Documentation.ods, Feedback_Professor.xlsx, PCB1.PcbDoc, PCBLIB-PCSB_5.1.3.PcbLib, SCHLIB-PCSB_5.1.3.SchLib, Sheet1.SchDoc]
2024-09-14 Finished up Battery-Module & corrected labeling on Node(V1->V1.1)
    [PCB1.PcbDoc, PCBLIB-PCSB_5.1.3.PcbLib, Sheet2.SchDoc]
2024-09-15 Genereated Gerber X2 Files for NODE and BATTERY
    [Batterie-Modul.PrjPcb, Node.PrjPcb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]
2024-10-09 Made Design-Rule-Check, discovered Flaws, added Notizen.txt
    [Sheet1.SchDoc]
2024-10-09 Added the first Version of the Control-Panel schematic, PCB TBD
    [Control-Panel.PrjPcb, PCB1.PcbDoc, Sheet1.SchDoc]
2024-10-09 Finished PCB for Control-Panel
    [Control-Panel.PrjPcb, PCB1.PcbDoc, Sheet1.SchDoc]
2024-10-13 Added SWITCH-Module folder in HW-Module with empty schematic
    [PCB_Project.PrjPcb, Sheet1.SchDoc]
2024-10-13 Added DHT11, DS18B20 and tlv62569 Datasheet and added DS18B20 schematic-symbol and footprint in Altium-Libary
    [PCBLIB-PCSB_5.1.3.PcbLib, SCHLIB-PCSB_5.1.3.SchLib]
2024-10-13 Reworked the Node schematic, not finished yet
    [Sheet1.SchDoc]
2024-10-22 Added labeling(V1) on the Control-Panel board and runned Design-Rule-Check
    [Control-Panel.PrjPcb, PCB1.PcbDoc]
2024-10-22 Finished NODE V2 schematic, replaced linear voltage regulators with buck converter, added a connector for module communication, removed USB-to-TTL converter.
    [PCBLIB-PCSB_5.1.3.PcbLib, SCHLIB-PCSB_5.1.3.SchLib, Sheet1.SchDoc]
2024-10-22 Finished NODE PCB V2
    [Node.PrjPcb, PCB1.PcbDoc, PCBLIB-PCSB_5.1.3.PcbLib, SCHLIB-PCSB_5.1.3.SchLib, Sheet1.SchDoc]
2024-11-04 Added datasheet of a current transformer
    [Control-Panel.PrjPcb, Datasheet-Documentation.ods, Node.PrjPcb, PCB1.PcbDoc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]
2024-11-20 NODE V2.1: Added a header for future input and removed gound plane underneath the ESP32 atenna
    [Datasheet-Documentation.ods, Feedback_Professor.xlsx, PCB1.PcbDoc, Sheet1.SchDoc]
2024-11-20 Finished SWITCH V1 - schematic and print, Updated Altium-LIB
    [PCB1.PcbDoc, PCBLIB-PCSB_5.1.3.PcbLib, PCB_Project.PrjPcb, SCHLIB-PCSB_5.1.3.SchLib, Sheet1.SchDoc, Switch-Modul.PrjPcb]
2024-11-20 BATTERY V2, schematic and print done: Exchanged Buck-Boost-Converter with Boost-Converter, made PCB smaller, using smaller ON/OFF switch. Should only work with NODE V2
    [Batterie-Modul.PrjPcb, Changes.xlsx, PCB1.PcbDoc, PCBLIB-PCSB_5.1.3.PcbLib, SCHLIB-PCSB_5.1.3.SchLib, Sheet2.SchDoc]
2024-12-04 fixed issue where states could not be toggled
    [code-format.cfg]
2024-12-10 Finished first Version of Motion-Det.
    [Motion_Detection-Module.PrjPcb, PCB1.PcbDoc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]
2024-12-10 Corrected error on Battery-Modul
    [Batterie-Modul.PrjPcb, PCB1.PcbDoc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]
2024-12-10 Generated Gerber-Files
    [Node.PrjPcb, PCB1.PcbDoc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]
2024-12-10 Updated Altium Libary
    [SCHLIB-PCSB_5.1.3.SchLib]
2024-12-11 Added schematic as PDF for Control-Panel
    [Control-Panel.PrjPcb, Sheet1.SchDoc]
2024-12-11 added theses template
    [Configuring options.txt]
2024-12-11 Updated Labor-Projecr docu.
    [Sheet1.SchDoc]
2024-12-18 incomplete SerialMonitor for esp32-c3
2024-12-29 Added test program for testing ARGB-Leds
    [code-format.cfg]
2024-12-29 moved old lvgl lib
    [code-format.cfg]
2025-01-08 Fixed faults on Node, Battery and Switch
    [PCB1.PcbDoc, Sheet1.SchDoc, Sheet2.SchDoc]
2025-01-08 Worked on Labor-Doc
    [PCB1.PcbDoc, Sheet1.SchDoc]
2025-01-08 Refactor WebServer to handle temperature data and update documentation; add new temperature fetching page
2025-01-15 Fixed issues on BATTERY, added Pull-Down-Res on Base, corrected Footprints
    [PCB1.PcbDoc, Sheet2.SchDoc]
2025-01-15 Fixed issues on SWITCH(V1.1), added Resistor for Q1, corrected Footprints
    [PCB1.PcbDoc, Sheet1.SchDoc]
2025-01-15 MOTION(V1.1): Splitted Voltage-divider
    [PCB1.PcbDoc, Sheet1.SchDoc]
2025-01-15 NODE(2.2): Added Pull-Up(DS18B20), splitted Voltage-Divider, Added Serial-Interface
    [NODE_ADC_ERKENNUNG.xlsx, Node.PrjPcb, PCB1.PcbDoc, PCB_Node-V2.2.step, Sheet1.SchDoc]
2025-01-15 Enhance documentation and implement temperature data fetching; update LaTeX styles for code listings
2025-01-15 Refactor code structure, LED functionality incomplete, and improve temperature data fetching in web interface
2025-01-15 tried to implement Leds to ESPtoRaspi, failed
    [main.cpp]
2025-01-23 Generated Gerber-File
    [ACS712-STROM-SPANNUNG.xlsx, Batterie-Modul.PrjPcb, Control-Panel.PrjPcb, Node.PrjPcb, PCB1.PcbDoc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]
2025-01-29 Enhance documentation: add introductory sections to chapters on ESP32, Raspberry Pi, Networking, and Requirements
2025-01-31 Add header guard to espnow.h to prevent multiple inclusions
    [espnow.h]
2025-02-01 Refactor documentation: added to ESP32 section
2025-03-05 fully working Slave Module Detection; Slave LED Error Indication
    [led.cpp, led.h, main.cpp, modulesDefinitions.h, slave.cpp]
2025-03-05 Organized schematic
    [PCB1.step, Sheet1.SchDoc]
2025-03-05 added flow charts
2025-03-07 Generated Step-3D file Battery V2.2
    [Battery_V2.2.step]
2025-03-10 Reorganised Battery schematic
    [Sheet2.SchDoc]
2025-03-11 Worked on DT(Boost Converter, Current Sensor)
    [ACS712-STROM-SPANNUNG.xlsx]
2025-03-12 started full communication example, slave to master temperature comm not working
    [WebServer.cpp, espnow.cpp, espnow.h, espnowSlave.cpp, main.cpp]
2025-03-15 Worked on DT
    [Sheet1.SchDoc]
2025-03-18 Exported step-3d from SWITCH and designed case
    [PCB-Switch_V1.1.step, PCB_Motion-V1.1.step, Switch-Base.3mf]
2025-03-18 Worked on DT(BatteryV1)
2025-03-24 Generated Smart-PDF of the PCBs(all modules)
    [Batterie-Modul.PrjPcb, Motion_Detection-Module.PrjPcb, Node.PrjPcb, PCB1.PcbDoc, Sheet1.SchDoc, Sheet2.SchDoc, Switch-Modul.PrjPcb]
2025-03-26 docs: created integration ready word template; added to results section, edited gitignore, changed code env to minted
    [EspNowTestCharts.ods]
2025-03-27 Addes folder with older version of NODE
    [Datasheet-Documentation.ods, PCB-NODE-V1.0.PcbDoc, PCB-NODE-V1.1.PcbDoc, PCB-NODE-V2.0.PcbDoc, PCB-NODE-V2.1.PcbDoc, Sheet-NODE-V1.0.SchDoc, Sheet-NODE-V1.1.SchDoc, Sheet-NODE-V2.0.SchDoc]
2025-03-29 Added PDF of the PCB and added older schematics/PCBs
    [Datasheet-Documentation.ods, PCB-BATTERY-V1.0.PcbDoc, PCB-MOTION-V1.0.PcbDoc, PCB_V1.0.PcbDoc, Sheet-BATTERY-V1.0.SchDoc, Sheet-SWITCH-V1.0.SchDoc, Sheet1.SchDoc, Sheet_V1.0.SchDoc]
2025-03-30 Cleaned schematic
    [Batterie-Modul.PrjPcb, PCB1.PcbDoc, Sheet-NODE-V1.1.SchDoc, Sheet-NODE-V2.0.SchDoc, Sheet1.SchDoc, Sheet2.SchDoc, Switch-Modul.PrjPcb]
2025-03-31 Cleaned schematics
    [Sheet-NODE-V2.1.SchDoc]
2025-03-31 Added cost section
    [Sheet2 (1).SchDoc]
2025-04-03 Added last BOM file(BatteryV1.0)
    [Sheet2.SchDoc]
2025-04-03 Cleaned repo, added module schematics(in all versions) in "HW-Module" folder
    [Changes.xlsx]
2025-04-22 added Squareline project
    [Configuring options.txt]
2025-04-22 lab: implemented UI logic
    [code-format.cfg]
2025-04-22 Added Cases
    [Battery-Motion.3mf, Battery.3mf, Motion.3mf, NODE-Battery-Motion.3mf, Node-Switch.3mf, Node.3mf, Switch.3mf]
